Wang-Ruohan/RV3-2/电机AR2/43c167e9c2e52d14894e8b5e8c7fa40.jpg

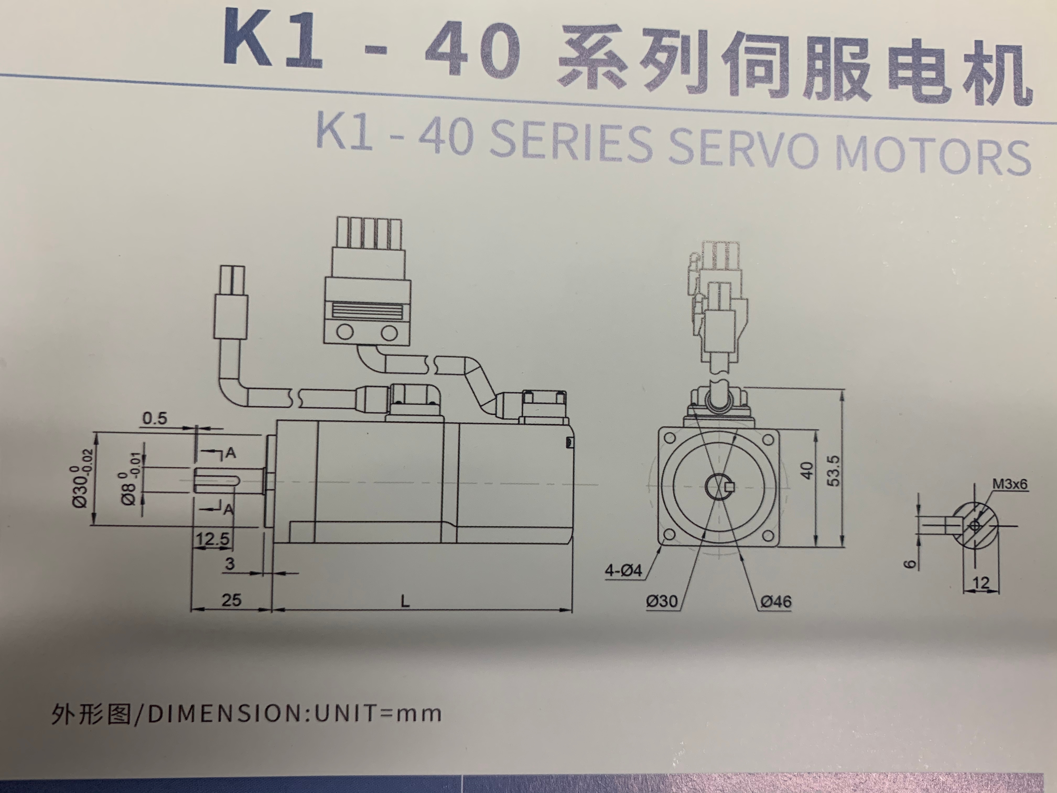
电机AR2/43c167e9c2e52d14894e8b5e8c7fa40.jpg
