Wang-Ruohan/RV3-2/PPT/RV3-2_robot2.pptx

RV3-2 机器人 – 传动

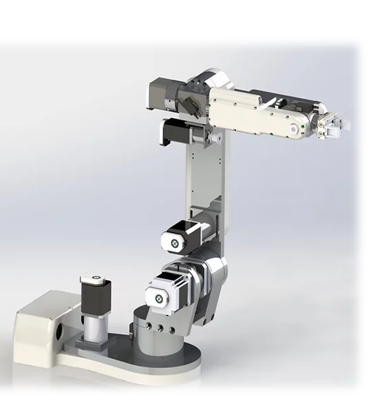
[picture p2: figure]

Joint_6

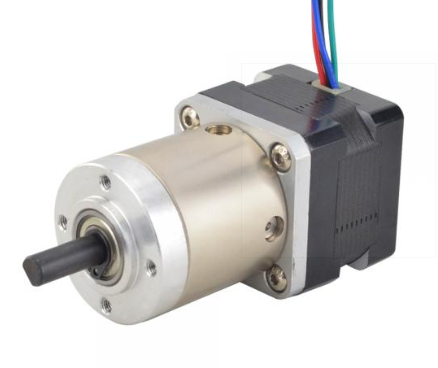
[picture p3: figure]

14HS11-1004D-PG19-AR3 (https://www.omc-stepperonline.com/nema-14-dual-shaft-stepper-motor-bipolar-l-28mm-w-gear-ratio-19-1-planetary-gearbox-9-5mm-rear-shaft-length.html)

Nema 14

0.125N.m 19:1减速比

Joint_5

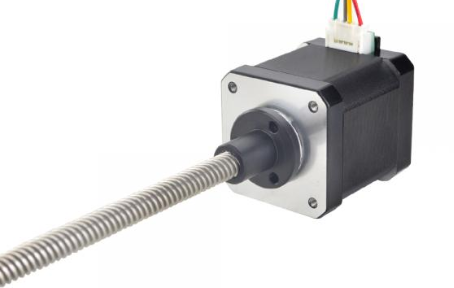
[picture p4: figure]

Nema 17

0.14N.m

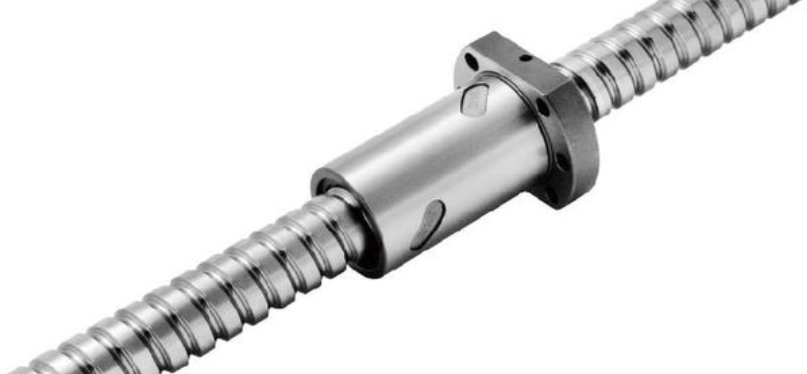
[picture p5: figure]

0.44N.m 13:1减速比

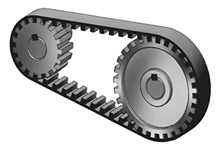
[picture p6: figure]

17LS19-1684E-200G-AR3 (https://www.omc-stepperonline.com/nema-17-dual-shaft-external-48mm-stack-1-68a-lead-8mm-0-31496-length-200mm-rear-shaft-length-13mm.html)

Joint_4

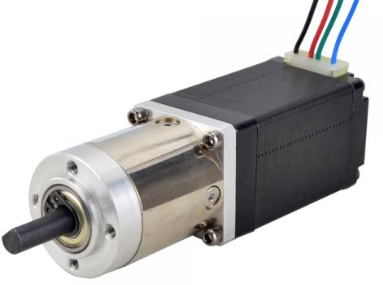
[picture p7: figure]

Nema 17

11HS20-0674D-PG14-AR3 (https://www.omc-stepperonline.com/nema-11-dual-shaft-stepper-motor-bipolar-l-51mm-w-gear-ratio-14-1-planetary-gearbox-9-5mm-rear-shaft-length.html)

Joint_3

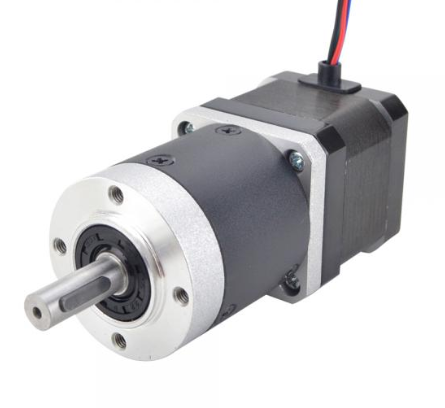
[picture p8: figure]

17HS15-1684D-HG50-AR3 (https://www.omc-stepperonline.com/nema-17-dual-shaft-stepper-motor-l-39mm-gear-ratio-50-1-high-precision-planetary-gearbox-9-5mm-rear-shaft-length.html)

Nema 17

0.39N.m 50:1减速比

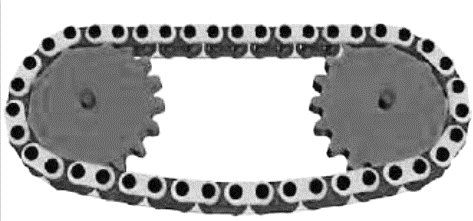
[picture p9: figure]

Joint_2

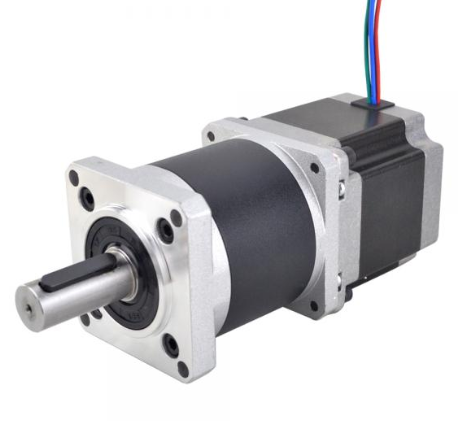
[picture p10: figure]

Nema 23

1.02N.m 50:1减速比

23HS22-2804D-HG50-AR3 (https://www.omc-stepperonline.com/nema-23-dual-shaft-stepper-motor-l-56mm-gear-ratio-50-1-high-precision-planetary-gearbox-9-5mm-rear-shaft-length.html)

Joint_1

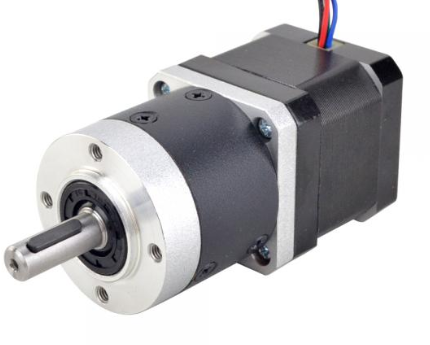
[picture p11: figure]

17HS15-1684D-HG10-AR3 (https://www.omc-stepperonline.com/nema-17-dual-shaft-stepper-motor-l-39mm-gear-ratio-10-1-high-precision-planetary-gearbox-9-5mm-rear-shaft-length.html)

Nema 17

0.39N.m 10:1减速比

编码器

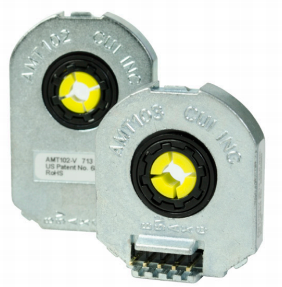
[picture p12: figure]

AMT102-V

AMT10X

正交，带刻度角（增量）

## Slide 2

RV3-2 机器人 – 特征参数

RV3-2 ROBOT
参数 | | 描述
展开臂长 | | 629mm
精度 | | 0.05mm
底座覆盖区 | | 245mm*150mm
重量 | | 15kg
温度 | | 0-50°C
运动范围
关节 | 转动范围
关节1 | -170°~+170°
关节2 | -129°~+0°
关节3 | +1°~+143°
关节4 | -164°~+164°
关节5 | -104°~+104°
关节6 | -148°~+148°
