Wang-Ruohan/RV3-2/其他/销售合同.docx

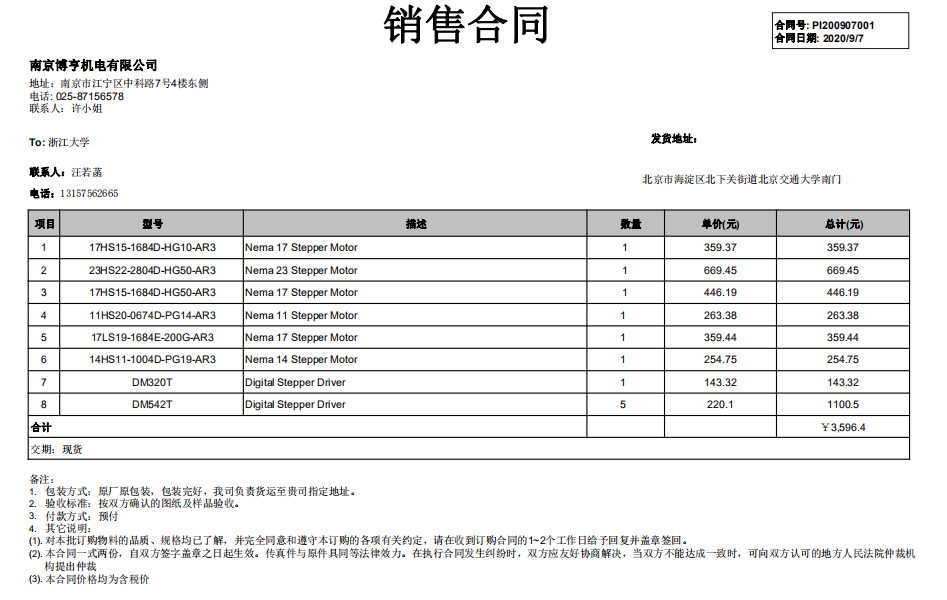
[picture p16: figure]
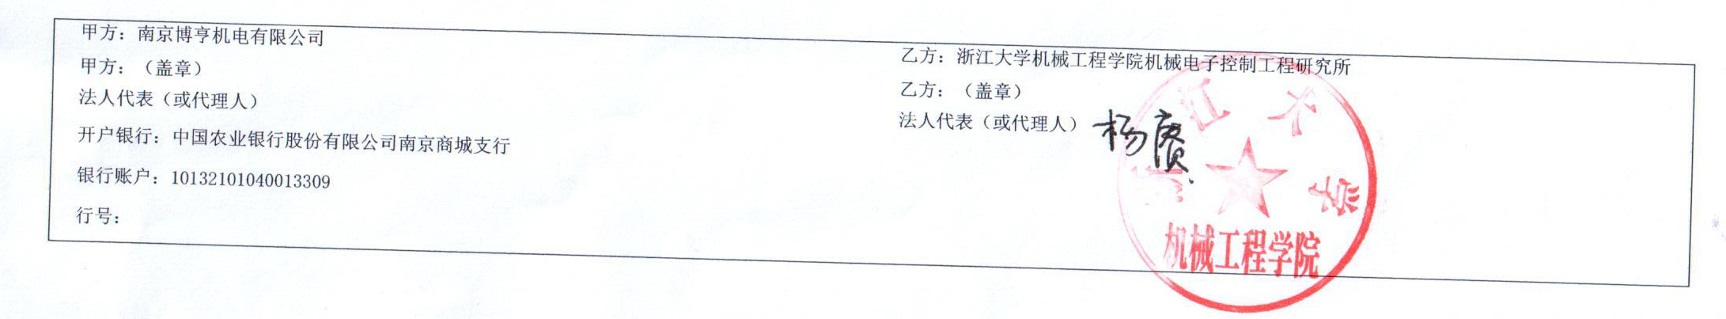
[picture p17: figure]
