Wang-Ruohan/RV3-2/CUI电容式编码器/CGQJ202002020_01800.jpg

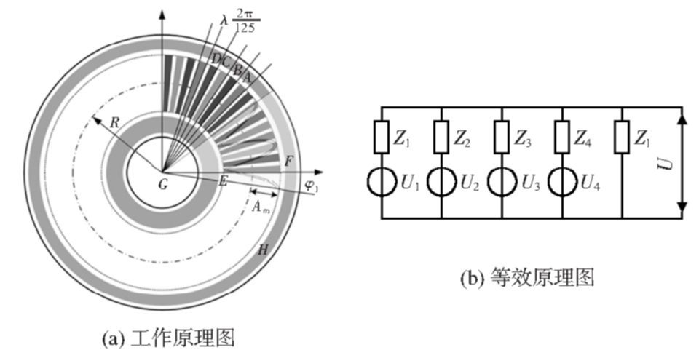
CUI电容式编码器/CGQJ202002020_01800.jpg
