Wang-Ruohan/RV3-2/其他/地址.jpg

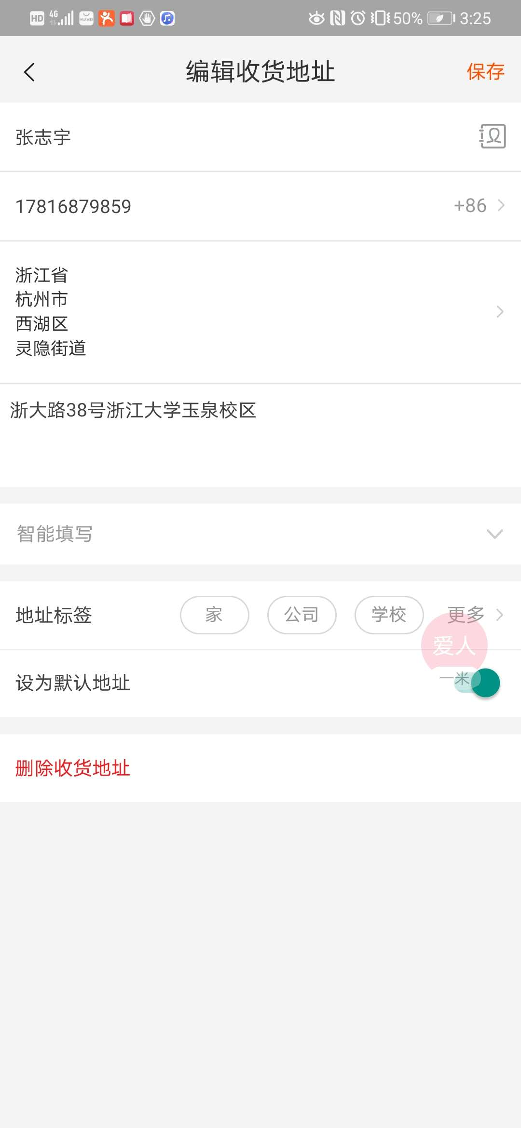
其他/地址.jpg
