Wang-Ruohan/RV3-2/电机AR2/J1.png

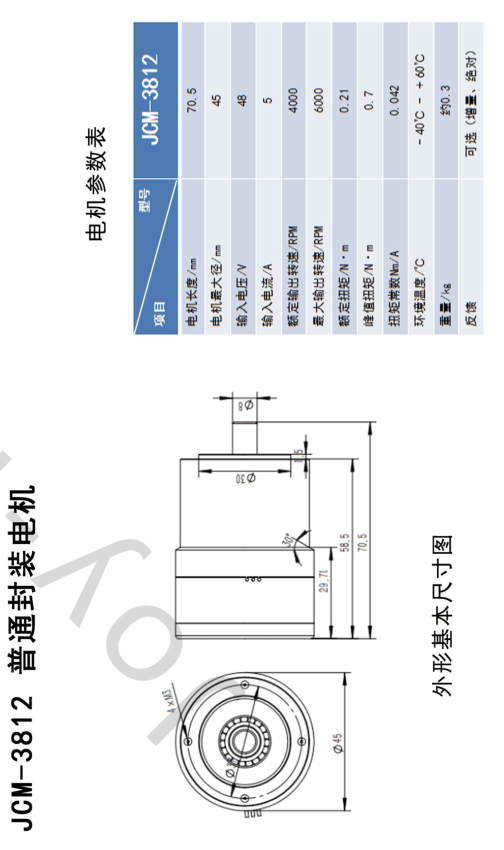
电机AR2/J1.png
