Wang-Ruohan/RV3-2/CUI电容式编码器/3D模型/CUI_AMT103-2048-N8000-S-SOLIDWORKS/BOM.txt

3DX_CUI_Supplier: CUI, Inc
3DX_CUI_Description: AMT10 Axial, Fixed Resolution, 2048 PPR, 8 Index Pulses, 8 mm Bore, Standard, Incremental, Capacitive Modular Encoder
3DX_CUI_Model Number: AMT103-2048-N8000-S
