Wang-Ruohan/RV3-2/表格/加工材料清单（不包括底座）.xlsx

Sheet: Sheet1
位置 | 材料 | 名称 | 数量 | 备注
Joint1 | 铝 | J1 basic plate | 1 | 基座，大，考虑用3D打印？ | √
 |  | J1 Turret Housing | 1 | 转台外壳，直径88mm | √
 |  | J1 spindle | 1 | 主轴，承载轴向力 | √
 |  | J1 turret platform | 1 | 转台平台，需要刚度 | √
 | PLA | J1 Base support spacer part1 | 1 |  | √
 |  | J1 Base support spacer part2 | 1 |  | √
 | 铝 | J1 timing dirve pully | 2 | J6也有一个，给的图不完整 | 已购
 | 铝 | J1 timing pully | 1 |  |  | x
Joint2 | 铝 | J2 Turret housing | 1 | 形状比较复杂 | √
 |  | J2 Arm | 1 |  | √
 |  | J2 Drive spindle | 1 |  | √
 |  | J2 Tension Ring | 1 |  | √
 |  | J2 motor support | 1 | 电机座支架 | √
 | PLA | J2 arm cover spacer | 2 |  | √
 |  | J2 side conver | 2 |  | √
Joint3 | 铝 | J1&J3 motor mount | 2 | 电机座支架 | 2
 |  | J3 Bearing cup | 1 |  | √
 |  | J3 Spindle | 1 |  | √
 |  | J3 Spindle retainer | 1 | 主轴固定器 | √
 | 铝 | 1439k211 | 1 | 一根轴 | 1
Joint4 | 铝 | J4 Turret housing | 1 |  | √
 |  | J4 Main shaft | 1 |  | √
 |  | J4 Timing hub | 1 |  |  | x
 |  | J4 Motor mount | 1 | 电机座支架 | √
 | 铝 | J4的电机座 | 1 | nema11 bracket | 已购
 | 铝 | J4 timing drive pulley | 1 | 给的图不完整 | 已购
Joint5 | 铝 | J5 motor mount | 1 |  | √
 |  | J5 housing | 1 | 10cm长，4cm宽和高，5mm厚，一面不封闭 | √
 |  | J5 belt carrier | 1 |  | √
 |  | J5 belt carrier clamp | 1 |  | √
 |  | J5 bearing post | 1 |  | √
 |  | J5 idler tension block | 1 |  | √
 | PLA | J5 side cover cap | 1 |  | √
 |  | J5 side cover | 1 |  | √
 |  | J5 side conver spacer | 2 |  | √
 | 铝 | 3mm rod | 2 |  | 2
Joint6 | 铝 | J6 Main bearing arm | 1 |  | √
 |  | J6 Housing single piece | 1 |  | √
 |  | J6 bearing cap | 1 | bearing cap, 3D也可 | √
 |  | J6 gripper mount | 1 |  | √
 | PLA | J6 limit switch tip | 1 |  | √
下面是关于bearing |  | 轴承亚马逊上有标件
J1 |  | 角接触轴承 | 2 | 内径45, 外径75, 面宽20, 面对面
J2 |  | 角接触轴承 | 2 | 内径30, 外径62, 面宽18, 面对面
J3 |  | 角接触轴承 | 1 | 内径20, 外径47, 面宽14.5, 对面是止推球
J3 |  | 止推球轴承 | 3 | 内径35，外径52，中间的和两侧型号不同
J4 |  | 止推球轴承 | 1+2 | 内径25.4，外径40，面宽3.6
J4 |  | 圆柱滚子轴承 | 2 | 外径31.75，内径25.4，面宽25.4
 |  | 6677k520 rolling bearing | 1 | 内径17.55，外径40，面宽13
 |  | 止推球轴承 | 1 | 内径25.4，外径40，面宽6
 |  | 5905k760 roller bearing | 1 | 内径17，外径22，面宽12
齿轮

Sheet: 螺栓
螺栓/螺母 | 数量
M3X10平头螺栓 | 13
M3X10紧定螺钉 | 4
M3X14盘头螺钉 | 10
M3X14内六角螺钉 | 6
M3X18内六角螺钉 | 4
M3X20平头螺钉 | 6
M3X20盘头螺钉 | 6
M3X25盘头螺钉 | 24
M3X3紧定螺钉 | 4
M3X4紧定螺钉 | 5
M3X5平头螺钉 | 20
M3X5内六角螺钉 | 1
M3X6紧定螺钉 | 7
M3X8内六角螺钉 | 9
M4螺母 | 4
M4垫片 | 36
M4X10平头螺钉 | 16
M4X10内六角螺钉 | 16
M4X10紧定螺钉 | 11
M4X14平头螺钉 | 2
M4X14内六角螺钉 | 1
M4X18平头螺钉 | 6
M4X20盘头螺钉 | 2
M4X20内六角螺钉 | 8
M4X35盘头螺钉 | 4
M4X5紧定螺钉 | 23
M6X14内六角螺钉 | 13
M6X18平头螺钉 | 9
M6X20内六角螺钉 | 3
M8方头紧定螺钉 | 1
