Wang-Ruohan/RV3-2/表格/已购买物品清单-第二批.xlsx

物品 | 数量 | 价格 | 备注 | 是否报销 | 备注
编码器 | 6 | 1039 |  |  | 电子发票 | 已收
电机+驱动器 | 6 | 3596.4 |  |  | 寄到浙大 | 已收
鲁泰轴承 | 5 | 56.62 |  |  | 保存在图片里 | 已收
LM3UU3mm轴承 | 4 | 110 |  |  | 寄到浙大 | 已收
B1616轴承 | 2 | 170 |  |  | 寄到浙大+20邮费
SKF轴承 | 1 | 7 | 没有发票
TR系列轴承 | 1 | 27.79 | 没有发票 |  | 已收到收据
32009轴承 | 2 | 30 | 没有发票 |  | 已收到收据
3mm铝棒 | 2 | 25 | 发票随货 |  | 在自己这里
同步轮定做 | 2 | 210 |  |  |  | 已收
接线头 | 4 | 72.2 |  |  |  | 已收
3D打印 | 1 | 240 |  |  | 已收到发票 | 已收
链轮定做 | 2 | 40 | 没有发票
铝合金加工 | 25样 | 2570 | 发票在自己这里 |  |  | 已收
螺丝刀 | 1 | 46.5 |  |  | 已收到发票 | 已收
螺栓 | 1 | 134.03 |  |  | 在自己这里
电线 | 5 | 48.46 |  |  | 图片保存里 | 已收
电线白 | 1 | 15 | 没有发票（可累计100开）
电源线 | 1 | 9 | 没有发票
同步轮 | 2 | 10 | 没有发票
同步带 | 5 | 33.9 | 没有发票
同步轮 | 1 | 5.3 | 没有发票
杜邦线 | 4 | 22.84 | 没有发票
