Wang-Ruohan/RV3-2/表格/2020.12月封账起未报.xlsx

物品 | 数量 | 价格 | 备注 | 是否报销
Nema17 电机 | 2 | 892.38 | 发票随货，在自己这儿 | 已报
铝合金加工 | 1 | 420 | 发票随货，发到浙大
铝合金加工 | 1 | 1500 | 未开票
邮费 | 1 | 50 | 电子发票
3D打印 | 2 | 261 | 电子发票，在自己这儿 | 已报
邮费 | 1 | 38 | 电子发票，未报，在自己这儿
餐桌轴承 | 1 | 28.8 | 电子发票，在自己这儿（邮箱） | 已报
铝合金加工 | 1 | 350
定位吸盘 | 500 | 47.22 | 电子发票，未开
尼龙包线 | 5 | 45 | 电子发票，未开
轴承 | 2 | 170 | 未开
气动夹爪 | 2 | 368 | 已开
3D打印 | 4 | 150 | 电子发票
气动接头 | 30 | 46.06 | 已开
亚克力板 | 1 | 11 | 已开
usb接头 | 1 | 11.9
木板 | 1 | 49.5
编码器 | 3 | 486 | 已开
铝型材 | 1 | 125
 |  | 5049.86
