Wang-Ruohan/RV3-2/AR2 assembly/1件-整合/J6 main bearing arm.STEP

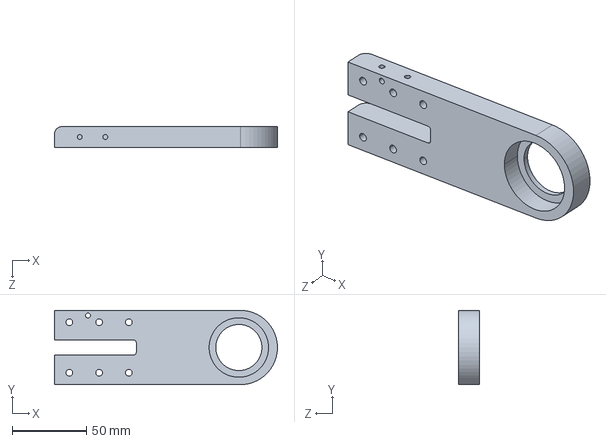
[picture p21: CAD file, 2021-06-09]
AR2 assembly/1件-整合/J6 main bearing arm.STEP
150.0 x 50.0 x 14.0 mm
