Wang-Ruohan/RV3-2/AR2 assembly/AR2 assembly/AR2 assembly & step files/AR2 Robot.SLDASM

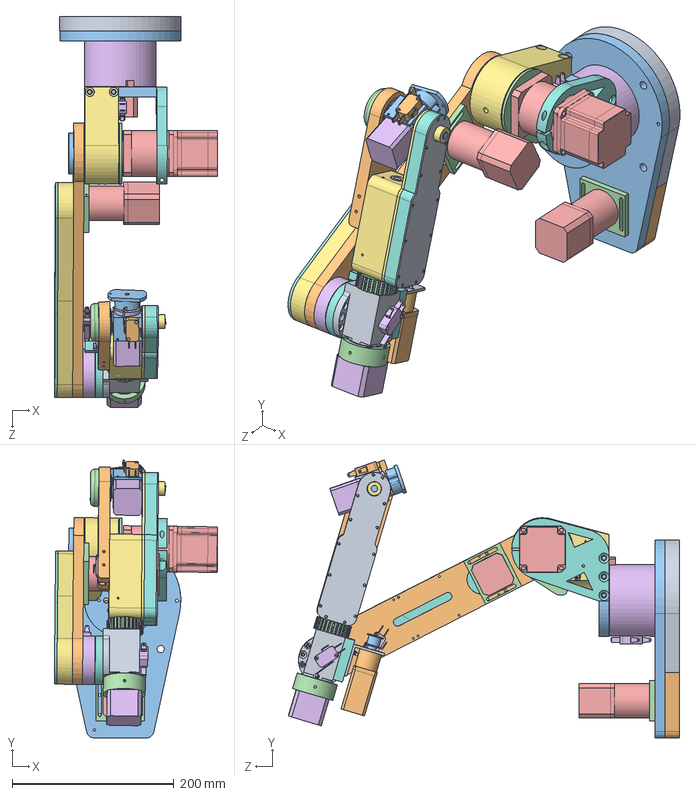
[picture p22: CAD file, 2021-06-09]
AR2 assembly/AR2 assembly/AR2 assembly & step files/AR2 Robot.SLDASM
202.2 x 343.9 x 484.2 mm
J1 base support spacer part 1
J1 base support spacer part 2
J1 Base Plate
J1 & J3 Motor Mount x 2
17HS15-1684S-HG50 x 2
J1 Turret Housing
J1 timing drive pulley x 2
J1 bearing outer x 2
J1 bearing inner x 2
J1 Spindle
J1 Turret Platform
J1 timing pulley
92635A314_SQUARE HEAD EXTENDED POINT SET SCREW
micro switch x 5
J2 Turret Housing
J2 Motor Support
J2 Arm
J2 Drive Spindle
J2 Tension Ring
23HS22-2804S-HG50
J3 Bearing Cup
30204 bearing
J3 Spindle
5909K180_THRUST NEEDLE-ROLLER BRNG
5909K630_THRUST NEEDLE-ROLLER BRNG x 2
5909K780_THRUST NEEDLE-ROLLER BRNG x 2
J3 spindle retainer
5909K490_THRUST NEEDLE-ROLLER BRNG x 4
1439K211_METRIC FULLY KEYED STEEL DRIVE SHAFT
J2 arm cover spacer x 2
J2 side cover half x 2
J4 Turret Housing
5905K137_STL NEEDLE-ROLLER BRNG x 2
J4 Main Shaft
J5 motor mount
5909K360_THRUST NEEDLE-ROLLER BRNG x 3
17LS13-0404E-200H
J5 Housing
J4 motor mount - limit arm
nema 11 bracket
11HS20-0674S-PG5
J4 timing drive pulley
6677K520_STL TAPERED-ROLLER BRNG
3mm rod x 2
J5 Belt Carrier
J5 Belt Carrier Clamp
J5 Idler Tension Block
J5 Bearing Post
J6 main bearing arm
J6 housing single piece
J6 bearing cap
5905K760_STL NEEDLE-ROLLER BRNG
14HS13-0804S-PG19
J5 side cover
J5 side cover spacer x 2
J5 side cover cap
modified micro switch
J6 gripper mount
J4 timing hub
