Wang-Ruohan/RV3-2/AR2 assembly/AR2 assembly/AR2 assembly & step files/Misc Parts/J4 main shaft.SLDPRT

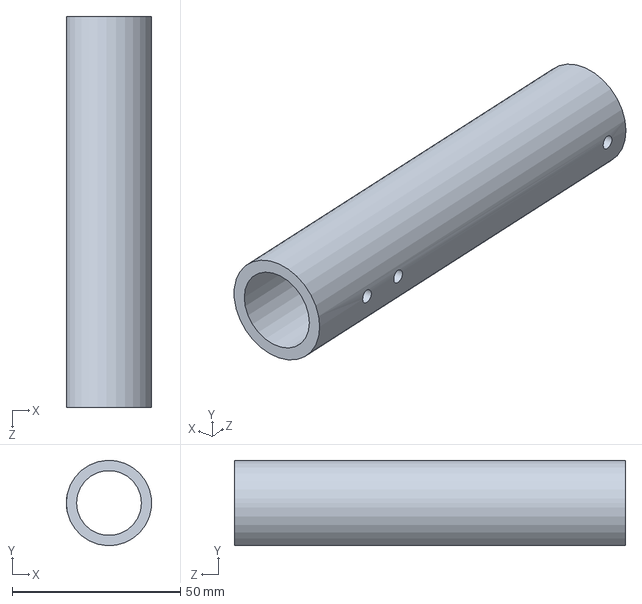
[picture p23: CAD file, 2021-06-09]
AR2 assembly/AR2 assembly/AR2 assembly & step files/Misc Parts/J4 main shaft.SLDPRT
25.4 x 25.4 x 116.3 mm
