Wang-Ruohan/RV3-2/CUI电容式编码器/3D模型/CUI_AMT103-2048-N8000-S-SOLIDWORKS/CUI_cui_amt103-0048-n8000-s.sldasm

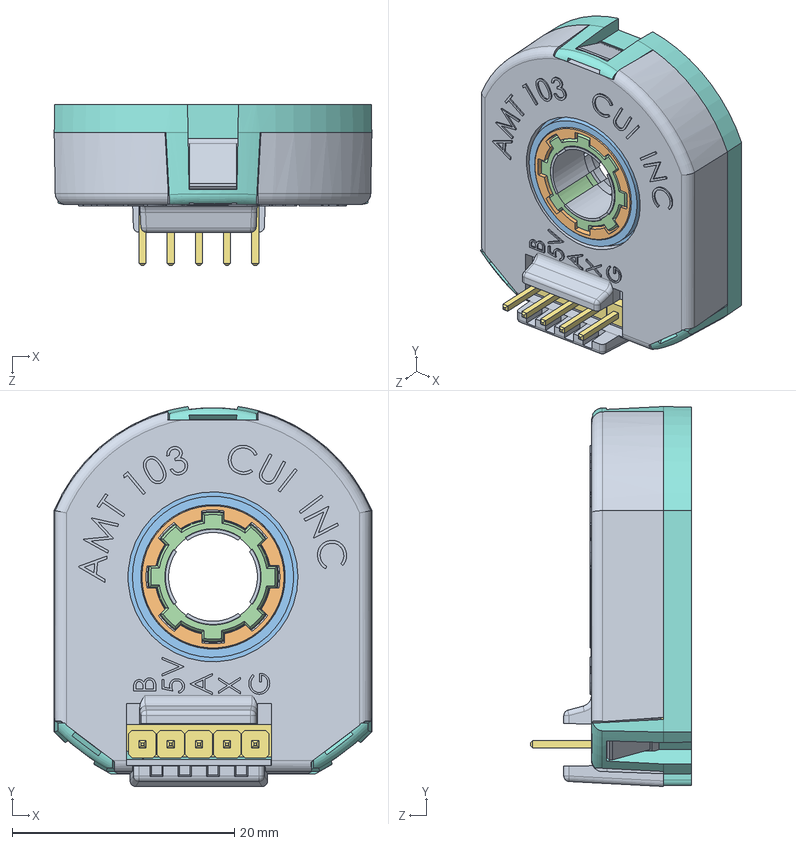
[picture p24: CAD file, 2021-06-09]
CUI电容式编码器/3D模型/CUI_AMT103-2048-N8000-S-SOLIDWORKS/CUI_cui_amt103-0048-n8000-s.sldasm
28.6 x 34.2 x 14.5 mm
CUI_amt-sleeve-rev-d(8 mm)
CUI_amt-hub-top-rev-d1
CUI_amt-hub-bottom-rev-b
CUI_amt10x-shaft-adaptor-rev-e
CUI_receiver-board
CUI_rotor-board-rev f
CUI_transmitter-board amt10(amt-103)
CUI_amt-103-base-rev-k(default)
CUI_amt-103-top-cover-rev-h
