Wang-Ruohan/RV3-2/AR2 assembly/AR2 assembly/AR2 assembly & step files/J5 main bearing housing.SLDPRT

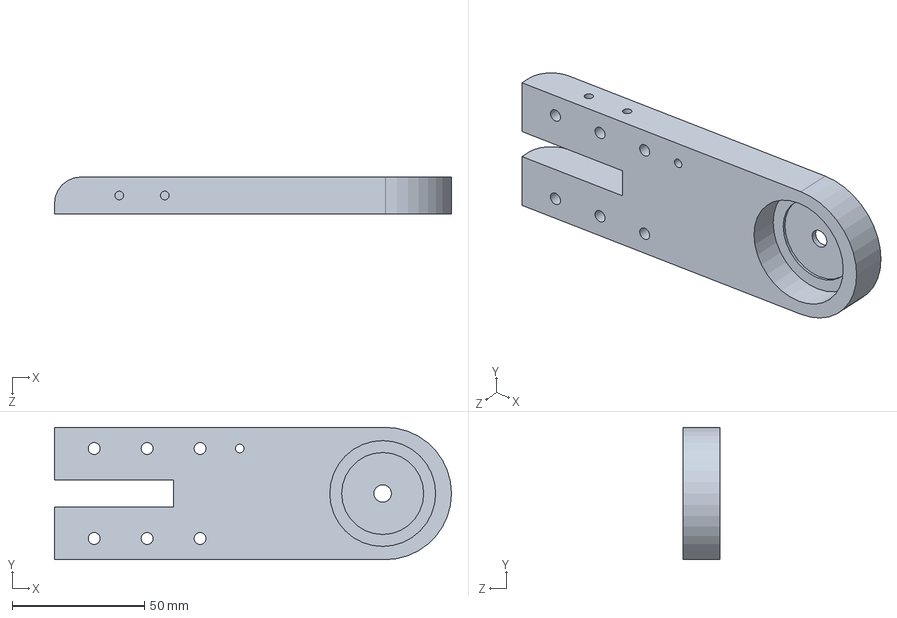
[picture p25: CAD file, 2021-06-09]
AR2 assembly/AR2 assembly/AR2 assembly & step files/J5 main bearing housing.SLDPRT
150.0 x 50.0 x 14.0 mm
