Wang-Ruohan/RV3-2/AR2 assembly/AR2 assembly/AR2 assembly & step files/AR2 Robot1.SLDASM

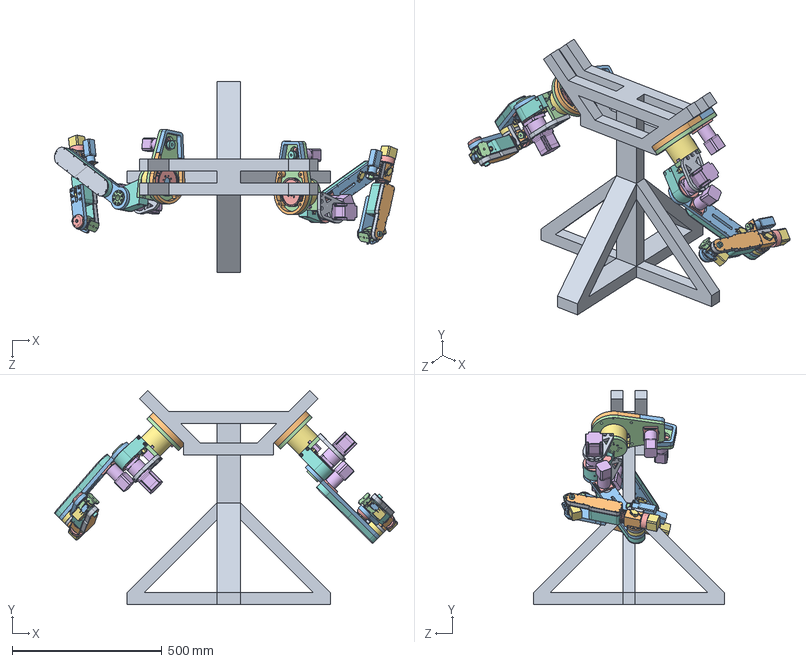
[picture p26: CAD file, 2021-06-09]
AR2 assembly/AR2 assembly/AR2 assembly & step files/AR2 Robot1.SLDASM
1146.7 x 716.8 x 640.0 mm
body_support2
J1 base support spacer part 1 x 2
J1 base support spacer part 2 x 2
J1 Base Plate x 2
J1 & J3 Motor Mount x 4
17HS15-1684S-HG50 x 4
J1 Turret Housing x 2
J1 timing drive pulley x 4
J1 bearing outer x 4
J1 bearing inner x 4
J1 Spindle x 2
J1 Turret Platform x 2
J1 timing pulley x 2
92635A314_SQUARE HEAD EXTENDED POINT SET SCREW x 2
micro switch x 10
J2 Turret Housing x 2
J2 Motor Support x 2
J2 Arm x 2
J2 Drive Spindle x 2
J2 Tension Ring x 2
23HS22-2804S-HG50 x 2
J3 Bearing Cup x 2
30204 bearing x 2
J3 Spindle x 2
5909K180_THRUST NEEDLE-ROLLER BRNG x 2
5909K630_THRUST NEEDLE-ROLLER BRNG x 4
5909K780_THRUST NEEDLE-ROLLER BRNG x 4
J3 spindle retainer x 2
5909K490_THRUST NEEDLE-ROLLER BRNG x 8
1439K211_METRIC FULLY KEYED STEEL DRIVE SHAFT x 2
J2 arm cover spacer x 4
J2 side cover half x 4
J4 Turret Housing x 2
5905K137_STL NEEDLE-ROLLER BRNG x 4
J4 Main Shaft x 2
J5 motor mount x 2
5909K360_THRUST NEEDLE-ROLLER BRNG x 6
17LS13-0404E-200H x 2
J5 Housing x 2
J4 motor mount - limit arm x 2
nema 11 bracket x 2
11HS20-0674S-PG5 x 2
J4 timing drive pulley x 2
6677K520_STL TAPERED-ROLLER BRNG x 2
3mm rod x 4
J5 Belt Carrier x 2
J5 Belt Carrier Clamp x 2
J5 Idler Tension Block x 2
J5 Bearing Post x 2
J6 main bearing arm x 2
J6 housing single piece x 2
J6 bearing cap x 2
5905K760_STL NEEDLE-ROLLER BRNG x 2
14HS13-0804S-PG19 x 2
J5 side cover x 2
J5 side cover spacer x 4
J5 side cover cap x 2
modified micro switch x 2
J6 gripper mount x 2
J4 timing hub x 2
