Wang-Ruohan/RV3-2/AR2 assembly/AR2 assembly & step files/AR2 Robot - J6 main bearing arm-1.STL

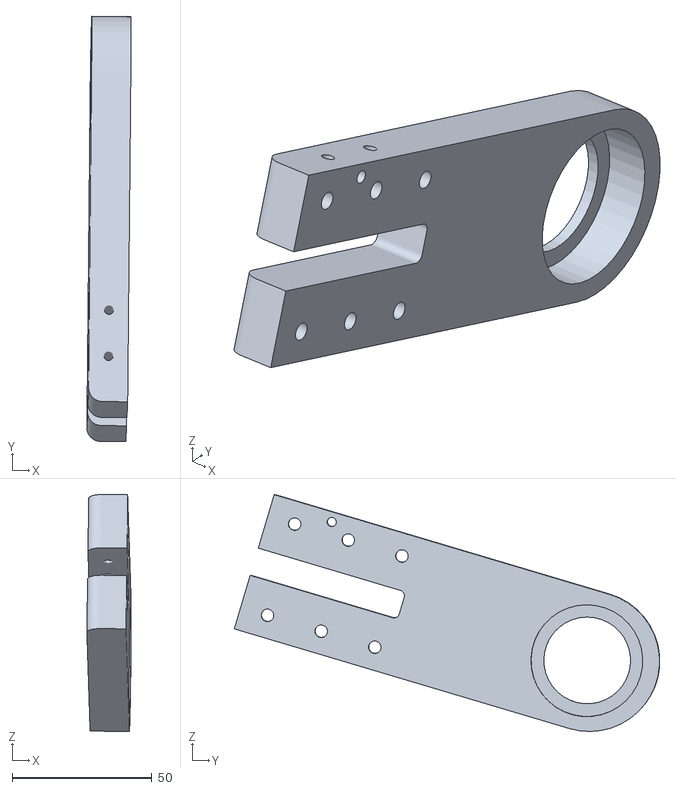
[picture p27: CAD file, 2021-06-09]
AR2 assembly/AR2 assembly & step files/AR2 Robot - J6 main bearing arm-1.STL
15.8 x 152.1 x 84.7
