Wang-Ruohan/RV3-2/AR2 assembly/AR2 assembly & step files/AR2 Robot - J4 Main Shaft-1.STL

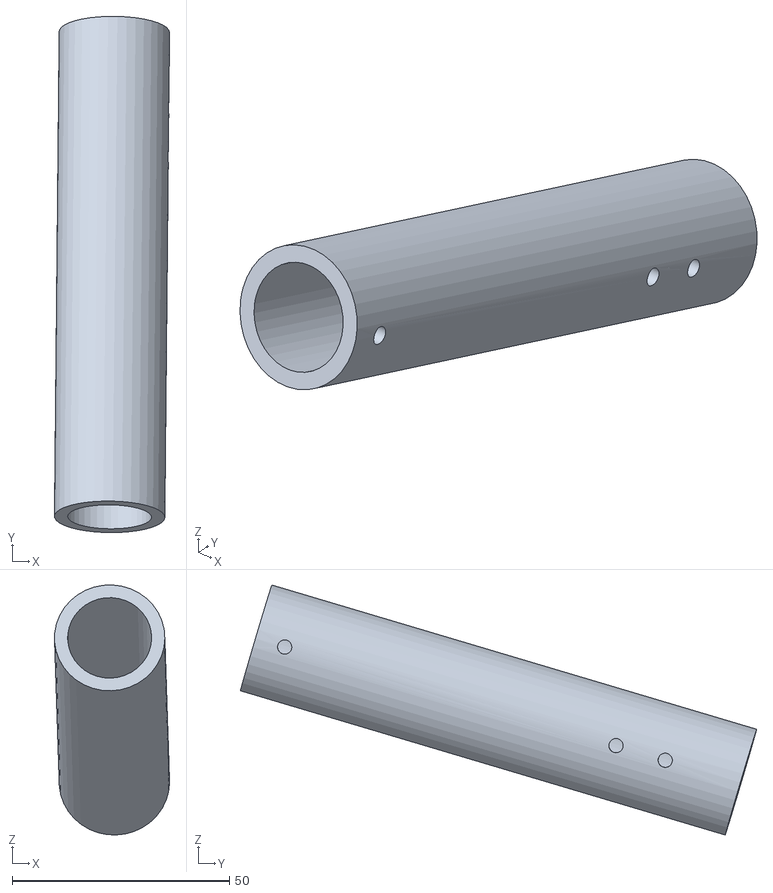
[picture p29: CAD file, 2021-06-09]
AR2 assembly/AR2 assembly & step files/AR2 Robot - J4 Main Shaft-1.STL
26.5 x 118.7 x 57.5
