Wang-Ruohan/RV3-2/AR2 assembly/AR2 assembly & step files/AR2 Robot - 1439K211_METRIC FULLY KEYED STEEL DRIVE SHAFT-1.STL

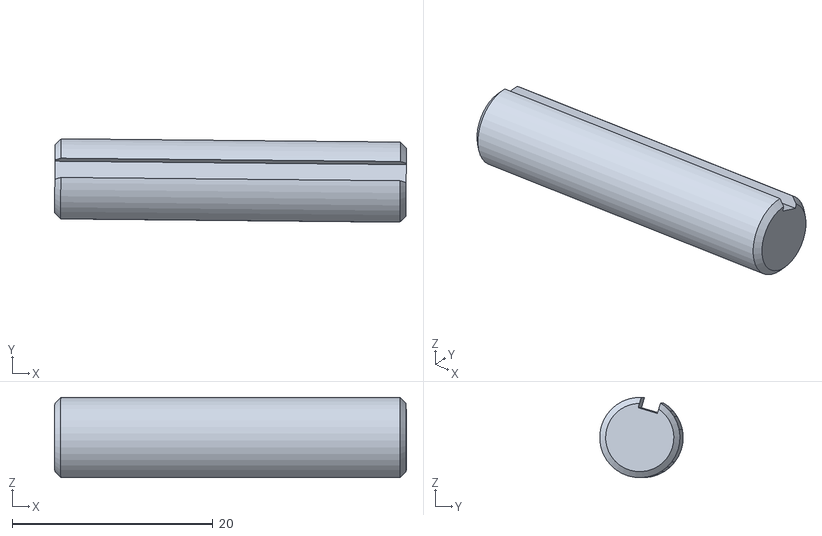
[picture p30: CAD file, 2021-06-09]
AR2 assembly/AR2 assembly & step files/AR2 Robot - 1439K211_METRIC FULLY KEYED STEEL DRIVE SHAFT-1.STL
35.1 x 8.31 x 7.99
