Wang-Ruohan/RV3-2/AR2 assembly/1件-J5/J5 motor mount.STEP

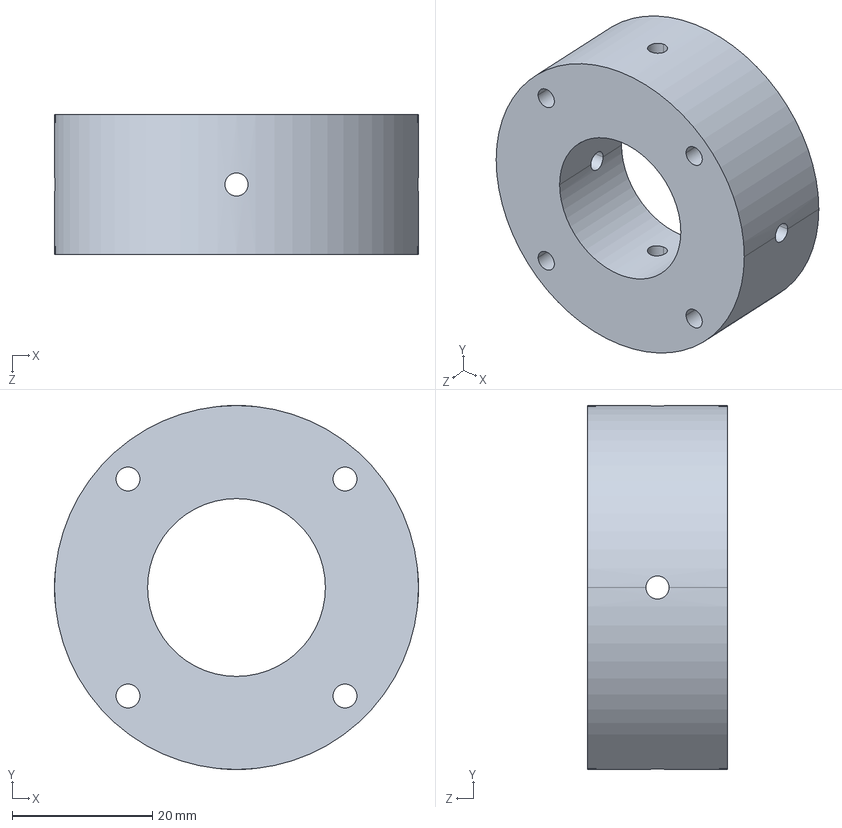
[picture p31: CAD file, 2021-06-09]
AR2 assembly/1件-J5/J5 motor mount.STEP
52.0 x 52.0 x 20.0 mm
