Wang-Ruohan/RV3-2/AR2 assembly/3D打印件/J5 side.STL

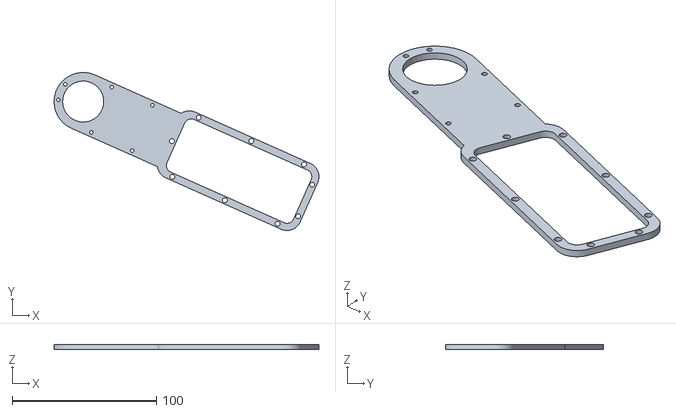
[picture p32: CAD file, 2021-06-09]
AR2 assembly/3D打印件/J5 side.STL
184.0 x 109.7 x 3.17
