Wang-Ruohan/RV3-2/AR2 assembly/AR2 assembly & step files/AR2 Robot - J3 Bearing Cup-1.STL

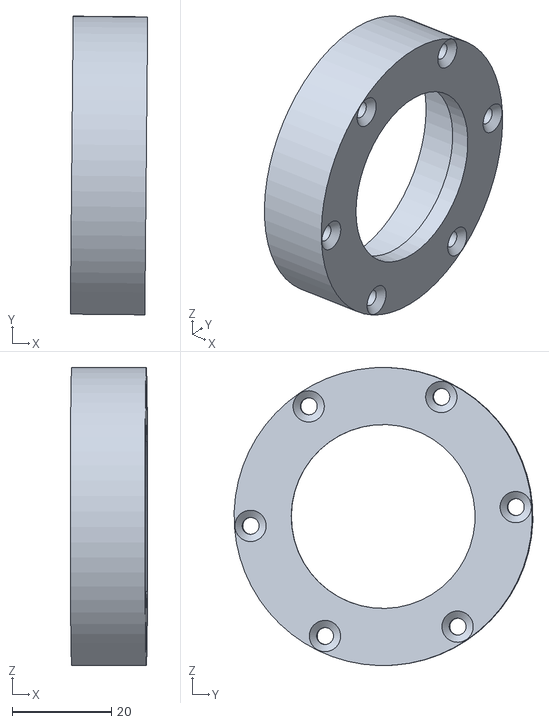
[picture p33: CAD file, 2021-06-09]
AR2 assembly/AR2 assembly & step files/AR2 Robot - J3 Bearing Cup-1.STL
15.6 x 60.1 x 60.0
