Wang-Ruohan/RV3-2/AR2 assembly/AR2 assembly/AR2 assembly & step files/J3 Tension Ring.SLDPRT

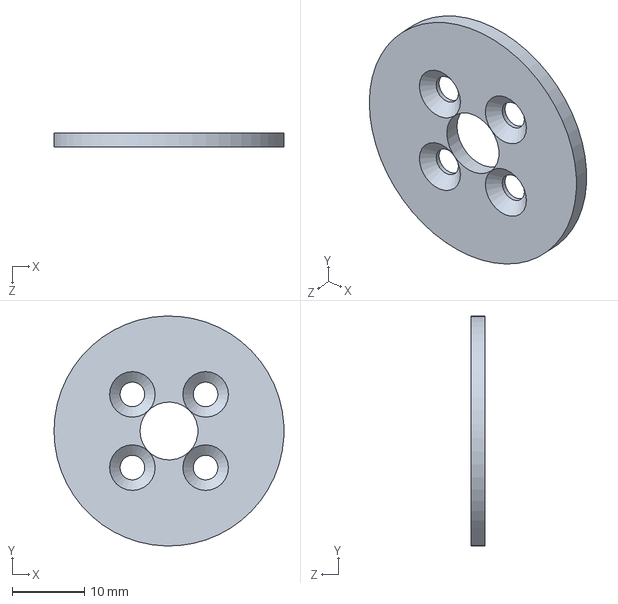
[picture p34: CAD file, 2021-06-09]
AR2 assembly/AR2 assembly/AR2 assembly & step files/J3 Tension Ring.SLDPRT
31.7 x 31.7 x 2.00 mm
