Wang-Ruohan/RV3-2/AR2 assembly/AR2 assembly/AR2 assembly & step files/Misc Parts/11HS20-0674S-PG5.SLDPRT

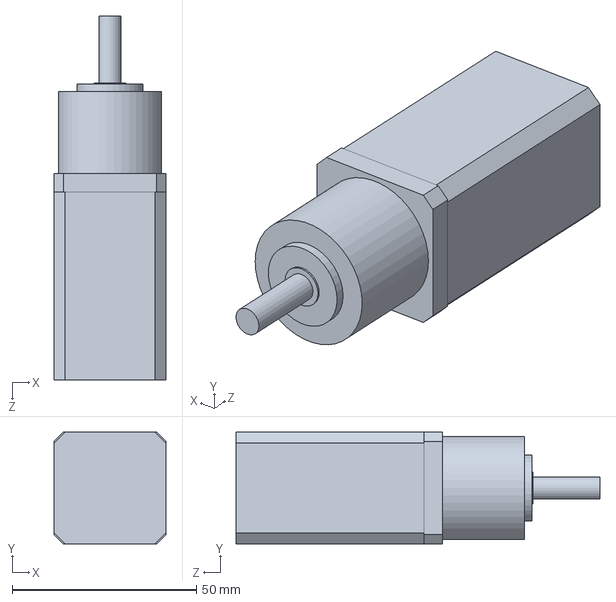
[picture p35: CAD file, 2021-06-09]
AR2 assembly/AR2 assembly/AR2 assembly & step files/Misc Parts/11HS20-0674S-PG5.SLDPRT
30.3 x 30.3 x 98.7 mm
