Wang-Ruohan/RV3-2/AR2 assembly/mashimar 众诚 7月2号/J4 Turret Housing.STEP

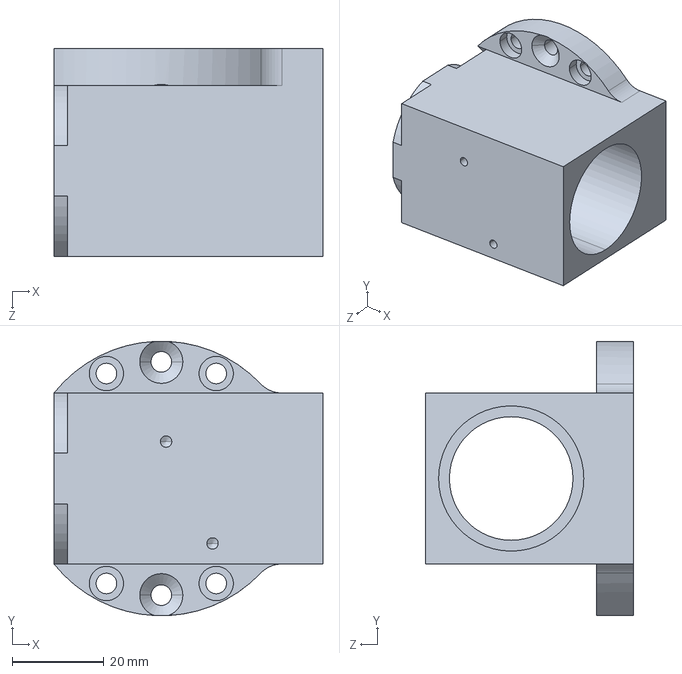
[picture p36: CAD file, 2021-06-09]
AR2 assembly/mashimar 众诚 7月2号/J4 Turret Housing.STEP
58.8 x 60.0 x 45.4 mm
