Wang-Ruohan/RV3-2/AR2 assembly/mashimaro051726众诚  7月21号 共13张/1件(1)/J6 bearing cap.STEP

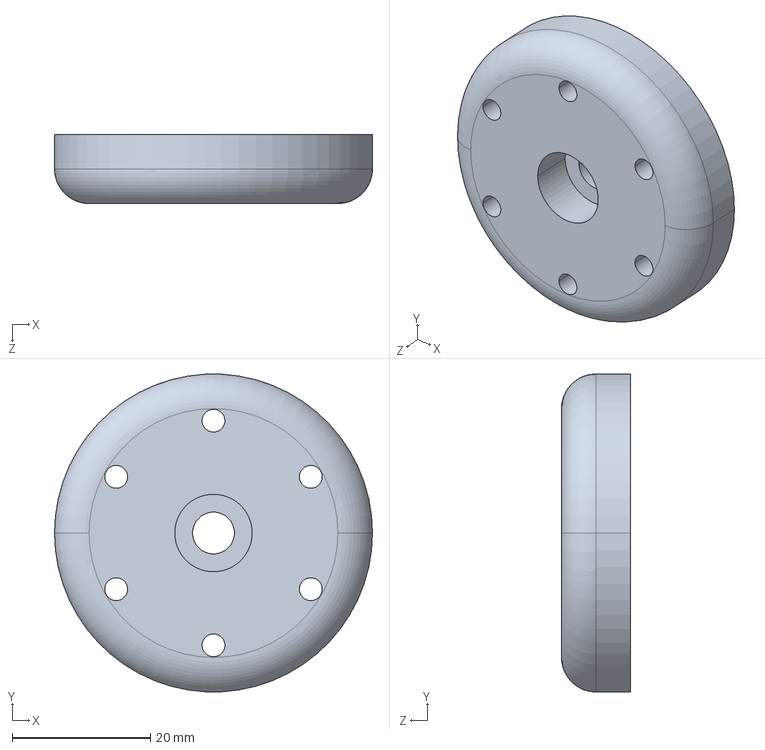
[picture p37: CAD file, 2021-06-09]
AR2 assembly/mashimaro051726众诚 7月21号 共13张/1件(1)/J6 bearing cap.STEP
46.0 x 45.9 x 10.0 mm
