Wang-Ruohan/RV3-2/AR2 assembly/mashimaro051726众诚  7月21号 共13张/1件-a(4)/J1 Turret Platform.STEP

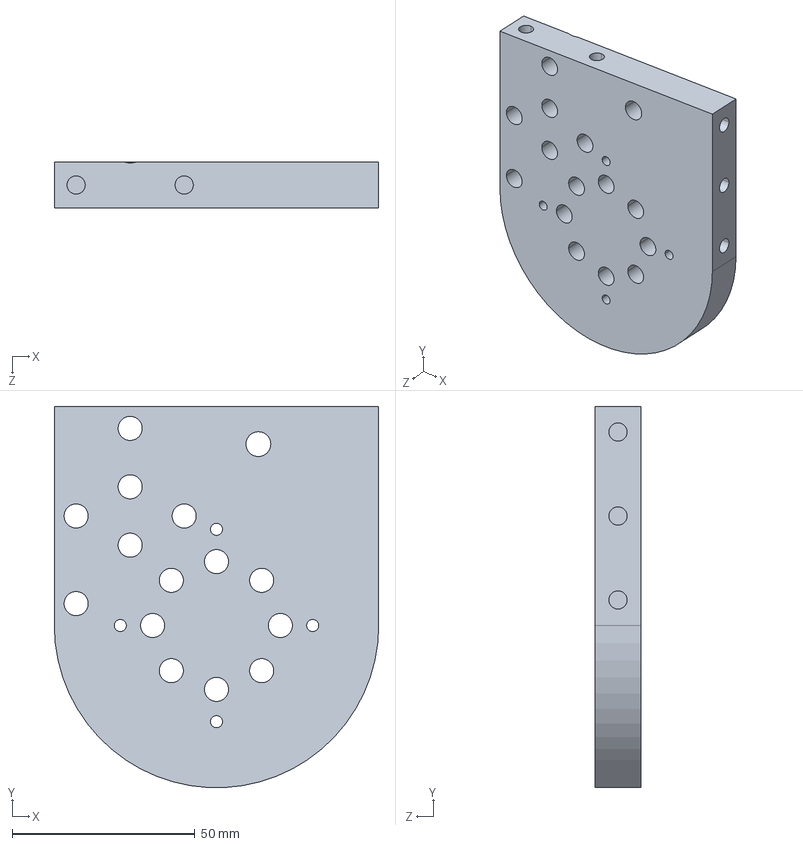
[picture p38: CAD file, 2021-06-09]
AR2 assembly/mashimaro051726众诚 7月21号 共13张/1件-a(4)/J1 Turret Platform.STEP
88.9 x 104.4 x 12.7 mm
