Wang-Ruohan/RV3-2/AR2 assembly/树脂件/NEW_outer.STL

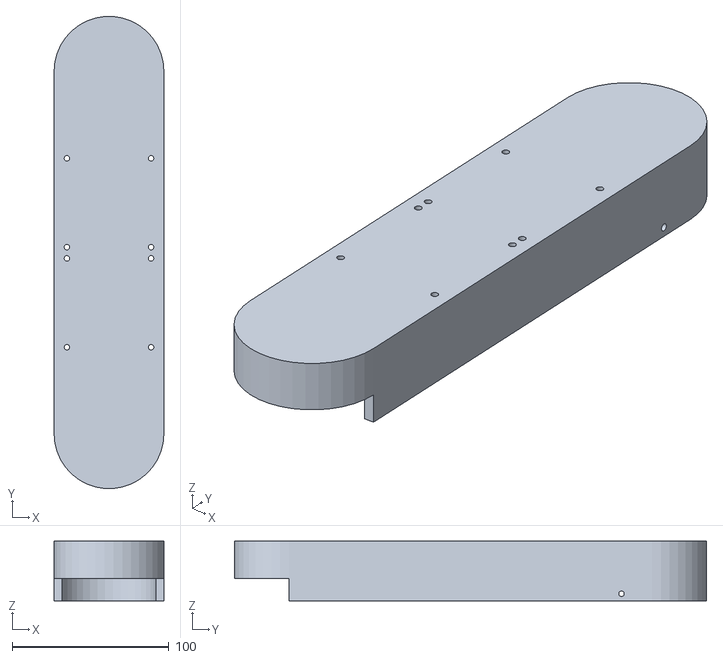
[picture p39: CAD file, 2021-06-09]
AR2 assembly/树脂件/NEW_outer.STL
70.0 x 300.7 x 38.2
