Wang-Ruohan/RV3-2/AR2 print files/Covers & Spacers - optimized for printing/J6 Limit Switch Tip.SLDPRT

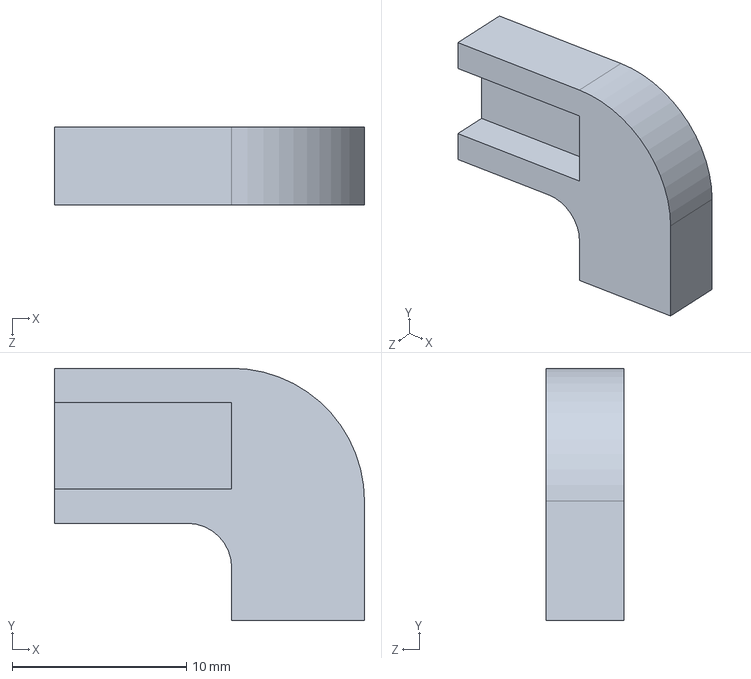
[picture p40: CAD file, 2021-06-09]
AR2 print files/Covers & Spacers - optimized for printing/J6 Limit Switch Tip.SLDPRT
17.8 x 14.5 x 4.45 mm
