Wang-Ruohan/RV3-2/AR2 print files/Covers & Spacers - original/J2 side cover half .SLDPRT

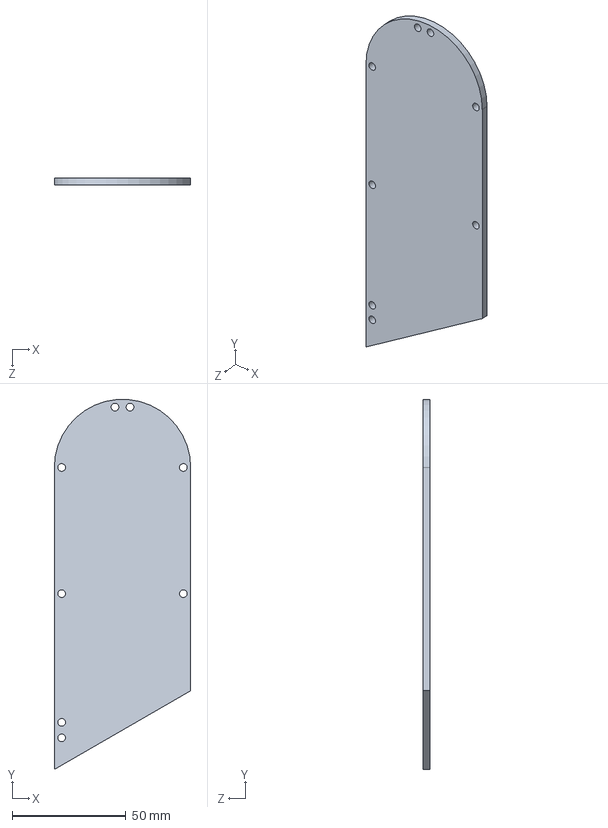
[picture p41: CAD file, 2021-06-09]
AR2 print files/Covers & Spacers - original/J2 side cover half .SLDPRT
60.0 x 162.7 x 3.17 mm
