Wang-Ruohan/RV3-2/AR2 print files/Epoxy on Supports/auxilliary base support.SLDPRT

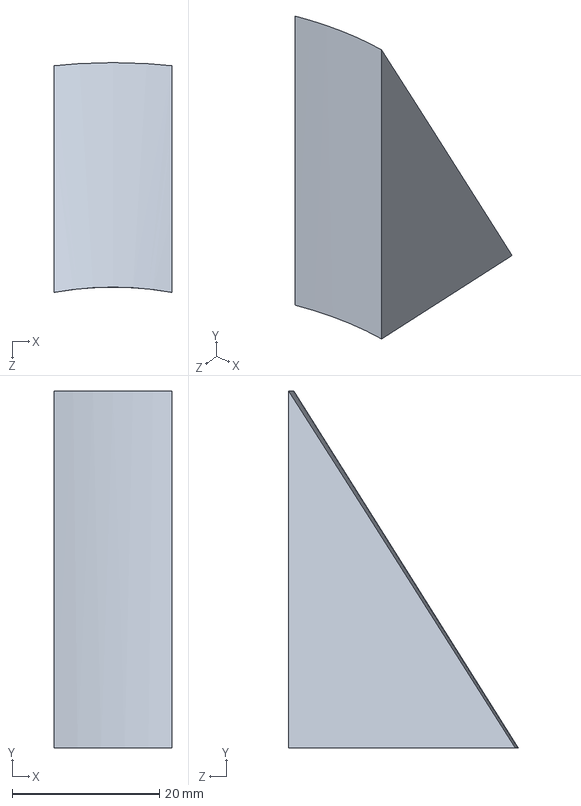
[picture p42: CAD file, 2021-06-09]
AR2 print files/Epoxy on Supports/auxilliary base support.SLDPRT
16.0 x 48.5 x 31.2 mm
