Wang-Ruohan/RV3-2/AR2 print files/Jaw/AR2 jaw.SLDPRT

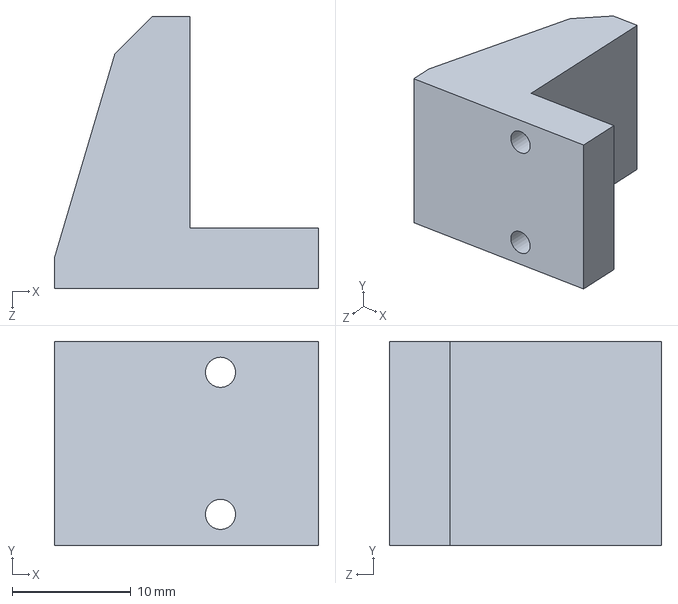
[picture p43: CAD file, 2021-06-09]
AR2 print files/Jaw/AR2 jaw.SLDPRT
22.2 x 17.1 x 22.9 mm
