Wang-Ruohan/RV3-2/AR2 print files/Main Components - Resized for shrink/J1 - J3 motor mount.STL

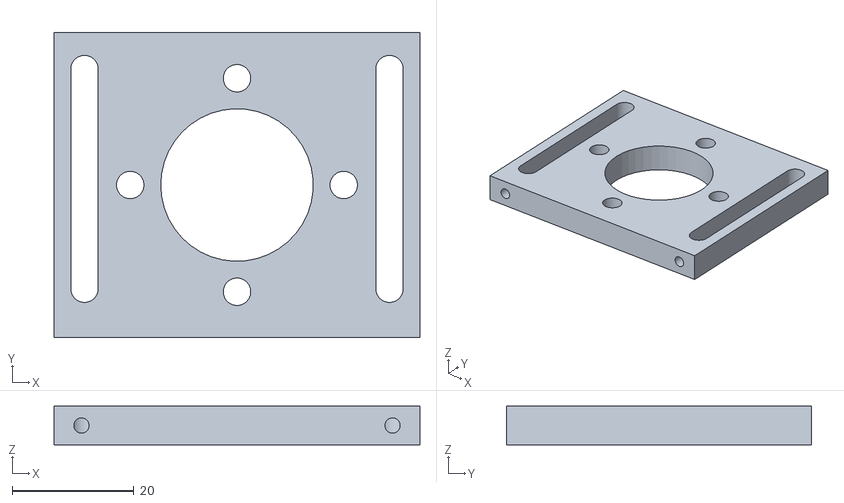
[picture p44: CAD file, 2021-06-09]
AR2 print files/Main Components - Resized for shrink/J1 - J3 motor mount.STL
60.0 x 50.0 x 6.35
