Wang-Ruohan/RV3-2/AR2 print files/Modified Main Components - Remixed for large print bed/J2_Arm_v4.stl

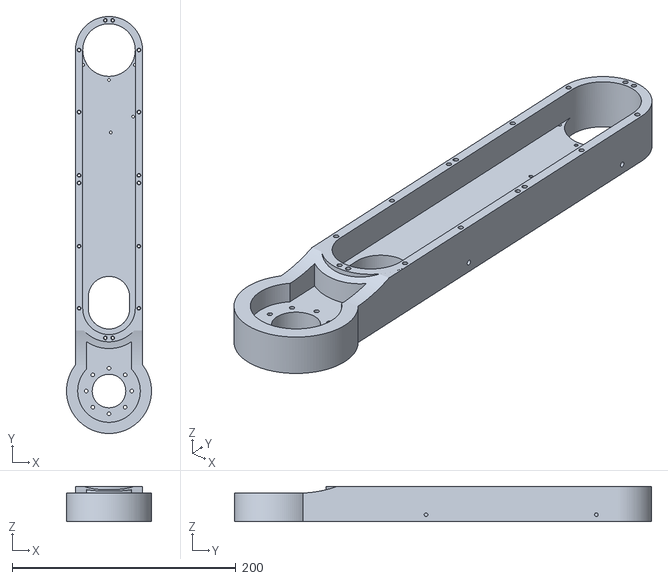
[picture p45: CAD file, 2021-06-09]
AR2 print files/Modified Main Components - Remixed for large print bed/J2_Arm_v4.stl
76.0 x 373.0 x 31.8
