Wang-Ruohan/RV3-2/AR2 print files/Travel Track/pillow block.SLDPRT

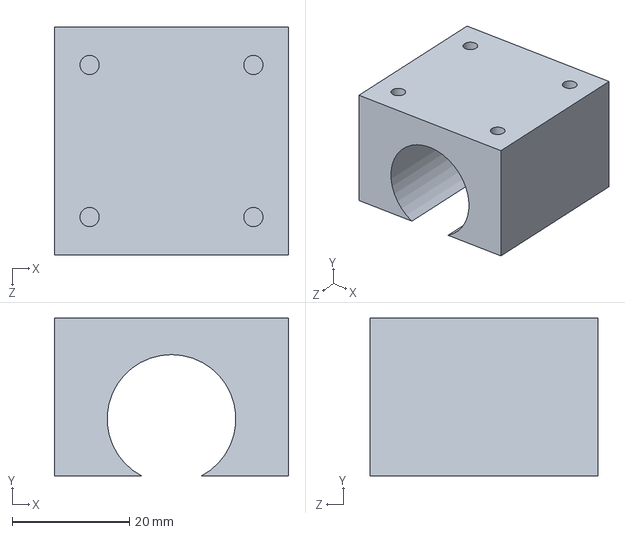
[picture p46: CAD file, 2021-06-09]
AR2 print files/Travel Track/pillow block.SLDPRT
40.0 x 27.0 x 39.0 mm
