Wang-Ruohan/RV3-2/AR3 assembly/J5 Belt Carrier.STEP

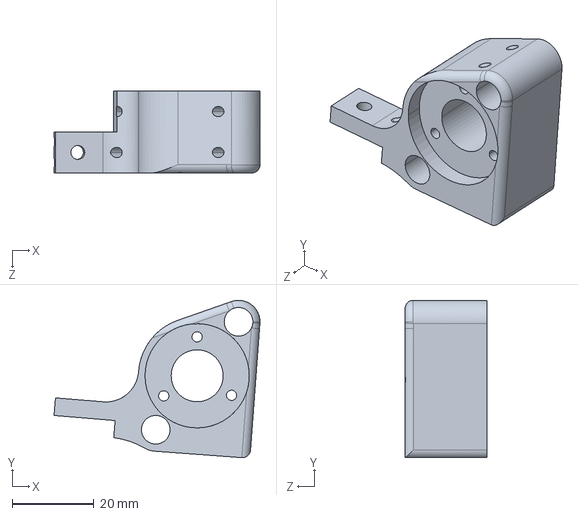
[picture p47: CAD file, 2021-06-09]
AR3 assembly/J5 Belt Carrier.STEP
50.4 x 38.5 x 20.0 mm
