Wang-Ruohan/RV3-2/AR3 print files/3D print files/60T hub pulley/60t_timing_hub_pulley.stl

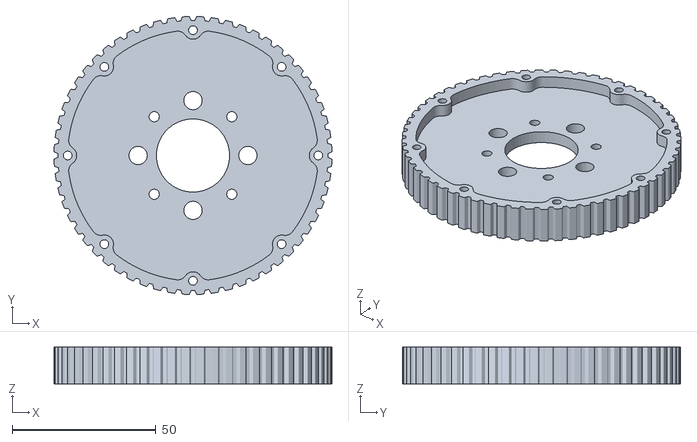
[picture p48: CAD file, 2021-06-09]
AR3 print files/3D print files/60T hub pulley/60t_timing_hub_pulley.stl
96.5 x 96.5 x 12.7
