Wang-Ruohan/RV3-2/AR3 print files/3D print files/Arduino Mount/Arduino Mount.STL

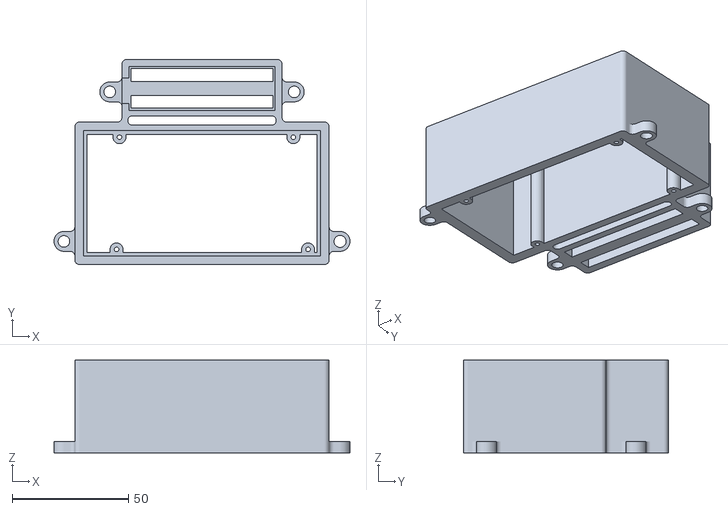
[picture p49: CAD file, 2021-06-09]
AR3 print files/3D print files/Arduino Mount/Arduino Mount.STL
127.6 x 88.4 x 40.0
