Wang-Ruohan/RV3-2/AR3 print files/3D print files/Covers and Spacers/J2 Side Cover Logo .STL

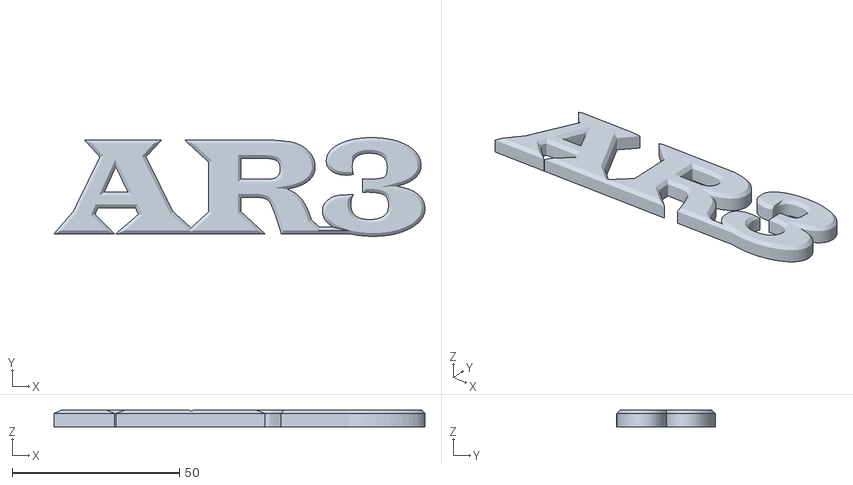
[picture p50: CAD file, 2021-06-09]
AR3 print files/3D print files/Covers and Spacers/J2 Side Cover Logo .STL
111.0 x 29.6 x 5.00
