Wang-Ruohan/RV3-2/AR3 print files/3D print files/Enclosure Face Panels/Enclosure Face Panel.STL

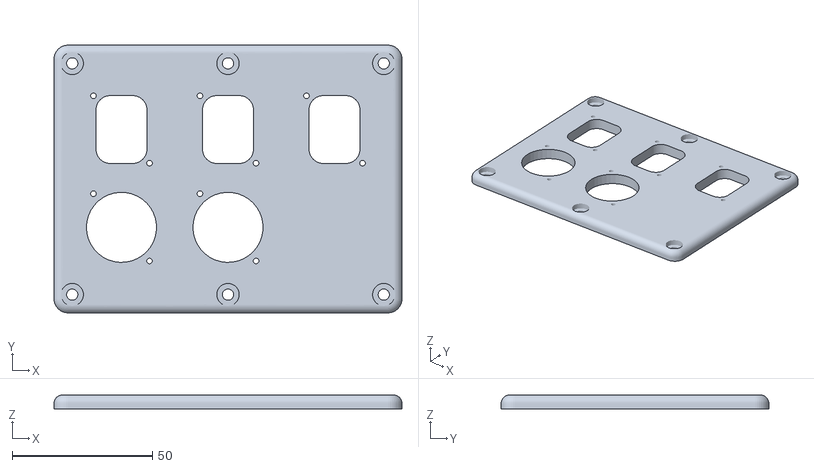
[picture p51: CAD file, 2021-06-09]
AR3 print files/3D print files/Enclosure Face Panels/Enclosure Face Panel.STL
124.1 x 95.5 x 5.00
