Wang-Ruohan/RV3-2/AR3 print files/3D print files/Epoxy on Supports/auxilliary J2 arm support.STL

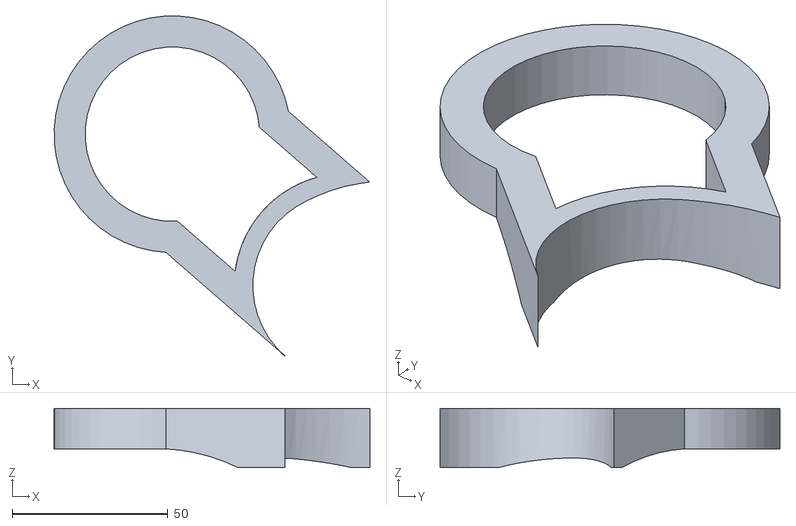
[picture p52: CAD file, 2021-06-09]
AR3 print files/3D print files/Epoxy on Supports/auxilliary J2 arm support.STL
101.3 x 109.2 x 19.0
