Wang-Ruohan/RV3-2/AR3 print files/3D print files/Jaws/AR3 jaw_left.STL

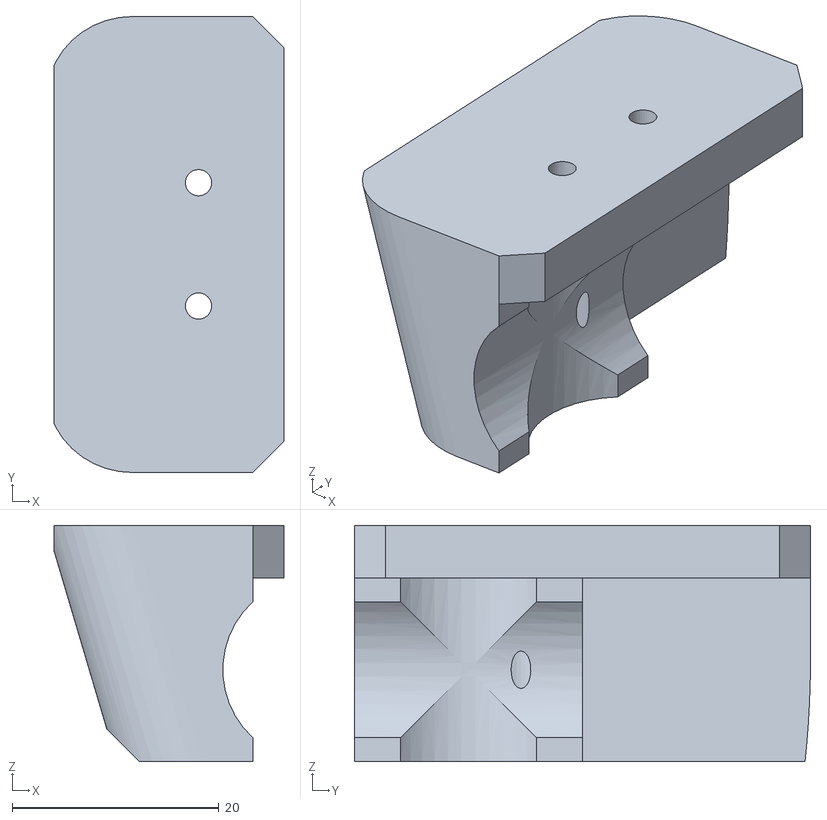
[picture p53: CAD file, 2021-06-09]
AR3 print files/3D print files/Jaws/AR3 jaw_left.STL
22.2 x 44.1 x 22.9
