Wang-Ruohan/RV3-2/AR3 print files/3D print files/Relay Mount/8 channel relay mount.STL

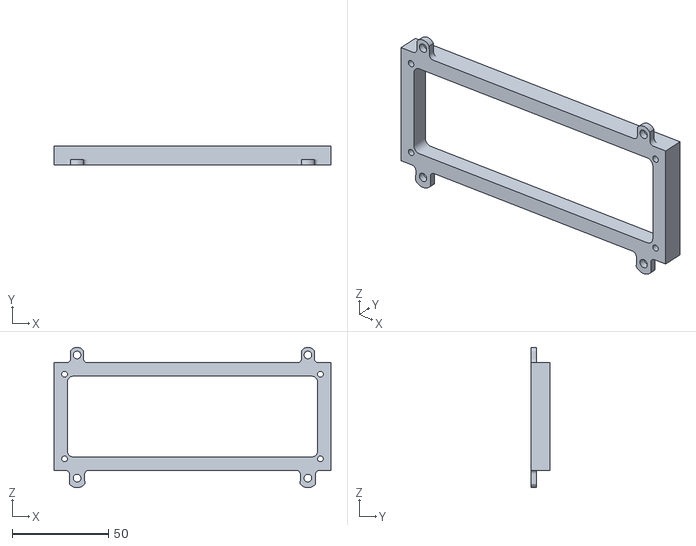
[picture p54: CAD file, 2021-06-09]
AR3 print files/3D print files/Relay Mount/8 channel relay mount.STL
144.0 x 10.0 x 73.0
