Wang-Ruohan/RV3-2/AR3 print files/3D print files/Structural Components - Nominal Size (identical aluminum parts)/J1 Spindle.STL

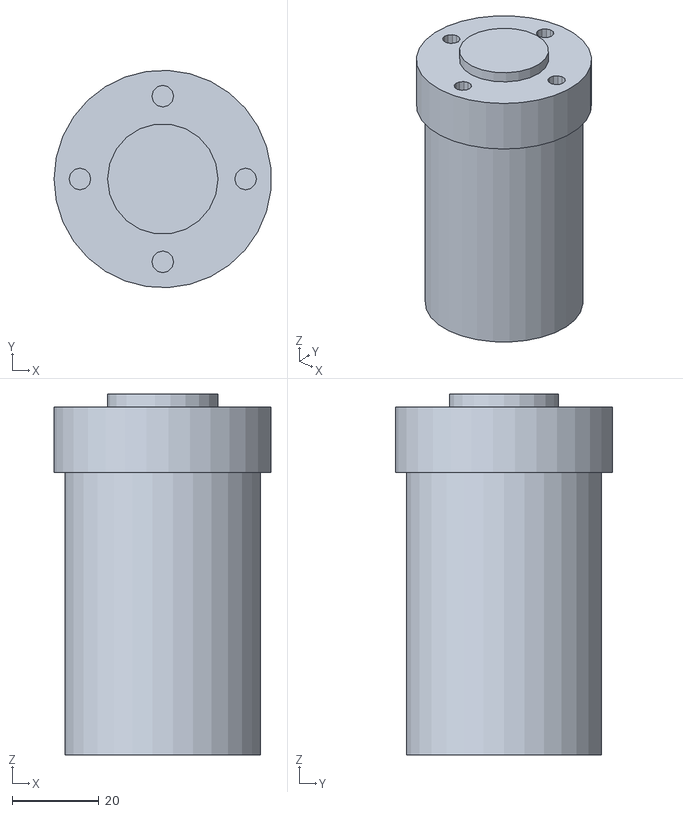
[picture p55: CAD file, 2021-06-09]
AR3 print files/3D print files/Structural Components - Nominal Size (identical aluminum parts)/J1 Spindle.STL
49.9 x 49.9 x 83.0
