Wang-Ruohan/RV3-2/AR3 print files/3D print files/Structural Components - Resized for shrink/J2 drive spindle - 14mm .STL

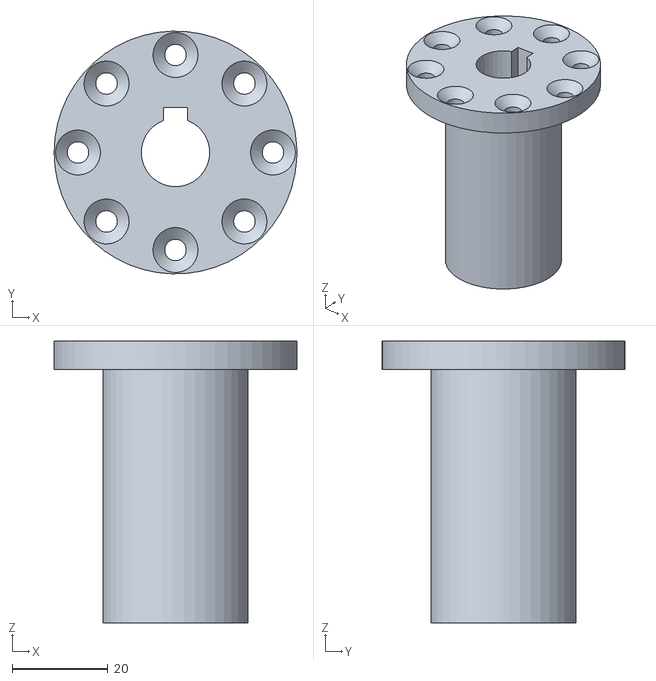
[picture p56: CAD file, 2021-06-09]
AR3 print files/3D print files/Structural Components - Resized for shrink/J2 drive spindle - 14mm .STL
50.8 x 50.8 x 59.0
