Wang-Ruohan/RV3-2/AR2 assembly/1件-J5/J5 Idler Tension Block.STEP

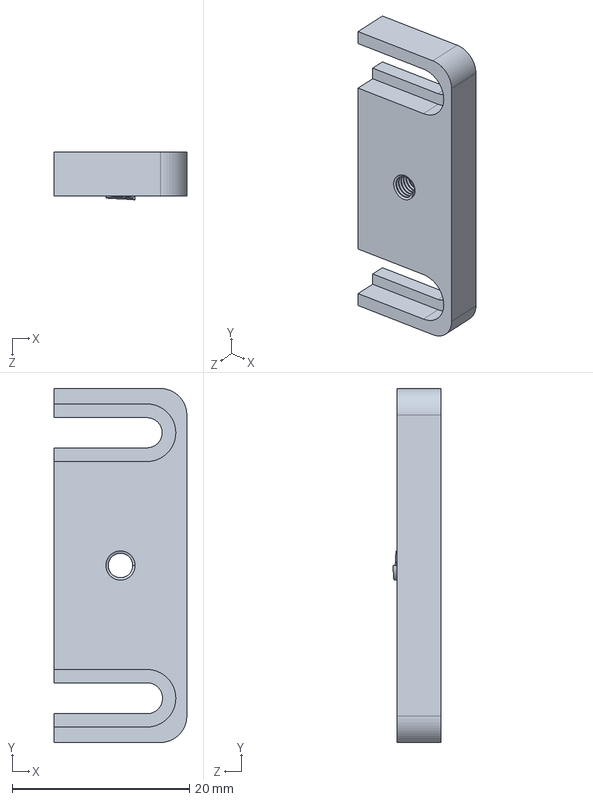
[picture p57: CAD file, 2021-06-09]
AR2 assembly/1件-J5/J5 Idler Tension Block.STEP
15.0 x 40.0 x 5.44 mm
