Wang-Ruohan/RV3-2/AR2 assembly/1件-整合/J1 Base Plate.STEP

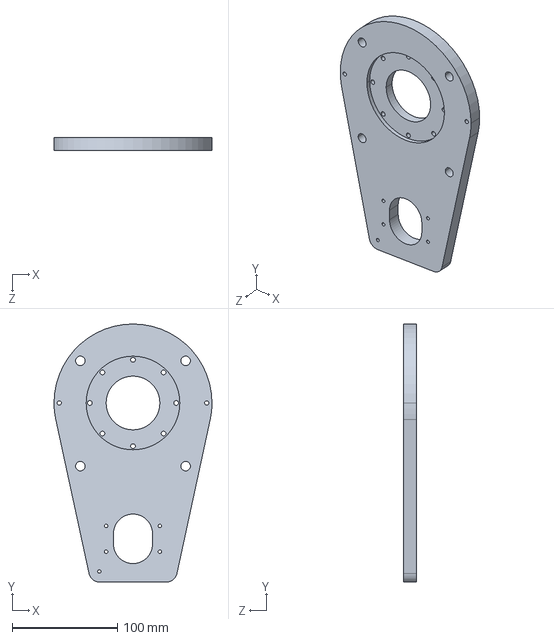
[picture p58: CAD file, 2021-06-09]
AR2 assembly/1件-整合/J1 Base Plate.STEP
150.0 x 245.0 x 12.7 mm
