Wang-Ruohan/RV3-2/AR2 assembly/AR2 assembly & step files/AR2 Robot - 5909K490_THRUST NEEDLE-ROLLER BRNG-2.STL

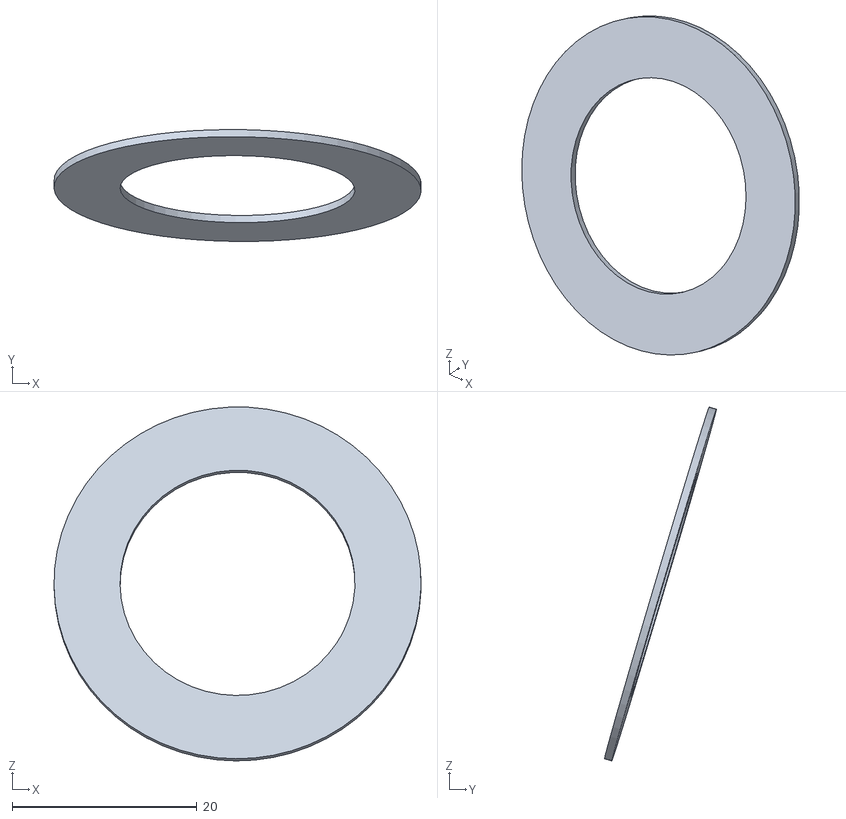
[picture p59: CAD file, 2021-06-09]
AR2 assembly/AR2 assembly & step files/AR2 Robot - 5909K490_THRUST NEEDLE-ROLLER BRNG-2.STL
39.7 x 12.1 x 38.3
