Wang-Ruohan/RV3-2/AR2 assembly/mashimar 众诚 7月2号/J4 motor mount - limit arm.STEP

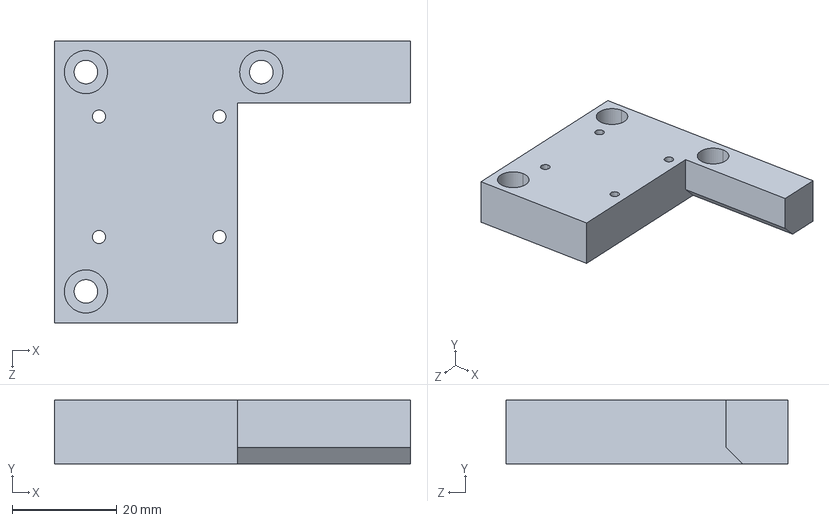
[picture p60: CAD file, 2021-06-09]
AR2 assembly/mashimar 众诚 7月2号/J4 motor mount - limit arm.STEP
68.0 x 12.2 x 53.8 mm
