Wang-Ruohan/RV3-2/AR2 assembly/树脂件/J5 side cover cap.STL

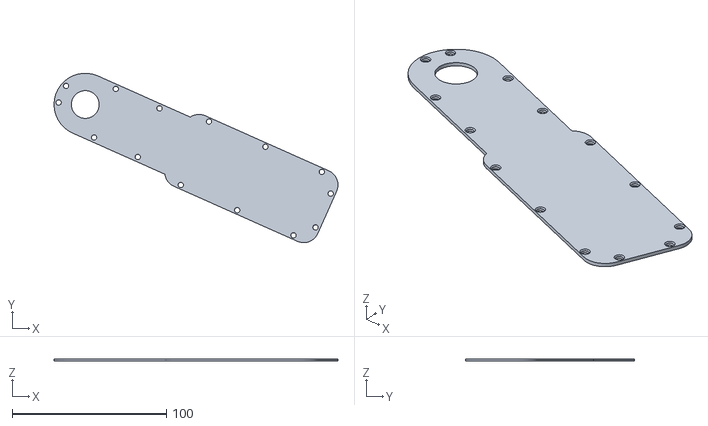
[picture p61: CAD file, 2021-06-09]
AR2 assembly/树脂件/J5 side cover cap.STL
184.0 x 109.7 x 1.59
