Wang-Ruohan/RV3-2/AR2 print files/Covers & Spacers - optimized for printing/J1 base support spacer part 2.SLDPRT

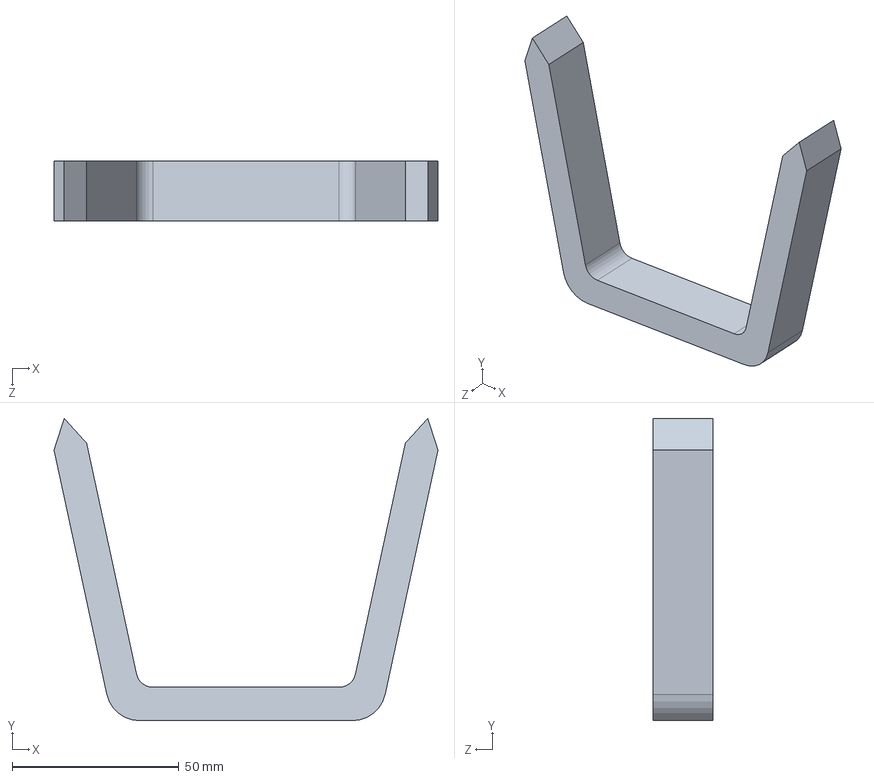
[picture p62: CAD file, 2021-06-09]
AR2 print files/Covers & Spacers - optimized for printing/J1 base support spacer part 2.SLDPRT
115.0 x 90.5 x 18.0 mm
