Wang-Ruohan/RV3-2/AR2 print files/Covers & Spacers - original/J2 arm cover spacer.SLDPRT

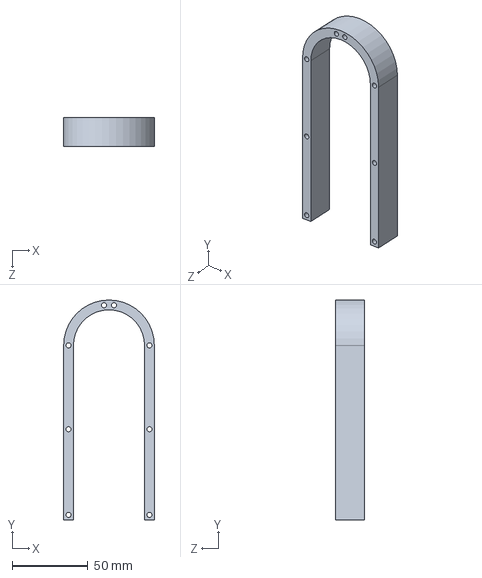
[picture p63: CAD file, 2021-06-09]
AR2 print files/Covers & Spacers - original/J2 arm cover spacer.SLDPRT
60.0 x 145.5 x 19.1 mm
