Wang-Ruohan/RV3-2/AR2 print files/Epoxy on Supports/auxilliary J2 arm support.SLDPRT

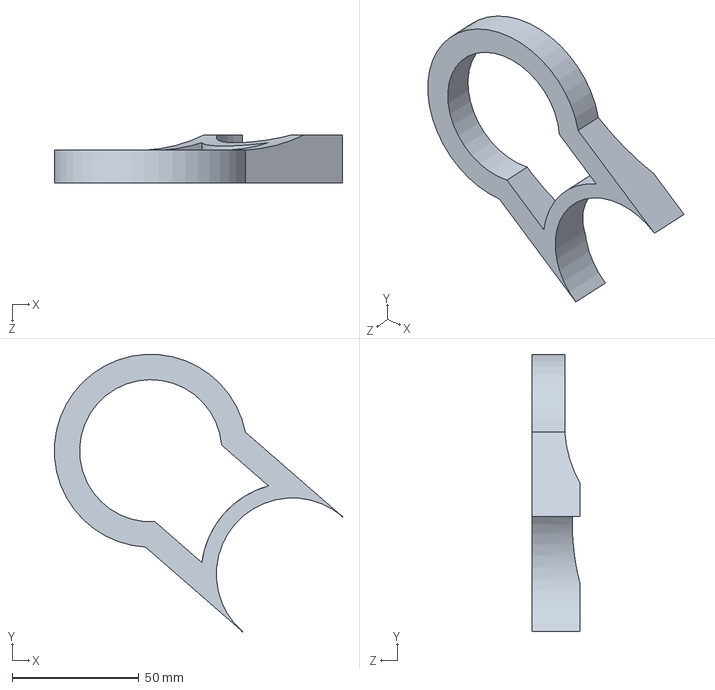
[picture p64: CAD file, 2021-06-09]
AR2 print files/Epoxy on Supports/auxilliary J2 arm support.SLDPRT
113.4 x 109.1 x 19.0 mm
