Wang-Ruohan/RV3-2/AR2 print files/Main Components - Resized for shrink/J2 arm part 1.STL

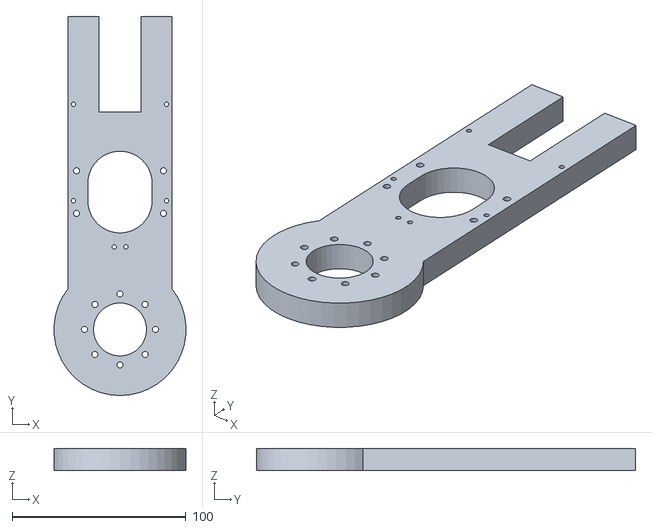
[picture p65: CAD file, 2021-06-09]
AR2 print files/Main Components - Resized for shrink/J2 arm part 1.STL
75.8 x 218.0 x 12.7
