Wang-Ruohan/RV3-2/AR2 print files/Modified Main Components - Remixed for large print bed/J1_Base_with_support_holes_v1_v5.stl

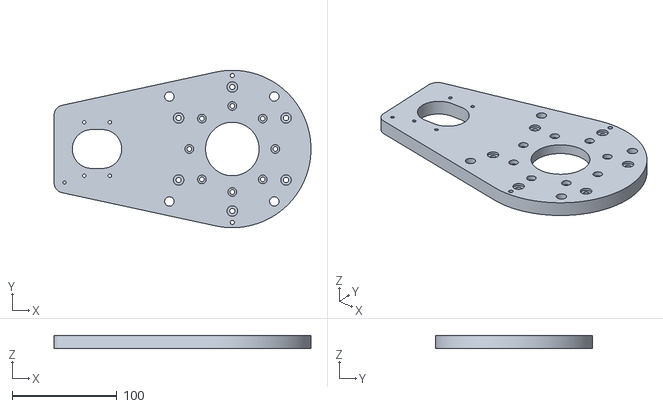
[picture p66: CAD file, 2021-06-09]
AR2 print files/Modified Main Components - Remixed for large print bed/J1_Base_with_support_holes_v1_v5.stl
245.0 x 150.0 x 12.7
