Wang-Ruohan/RV3-2/AR3 print files/3D print files/Covers and Spacers/J2 Arm Cover Spacer Lower.STL

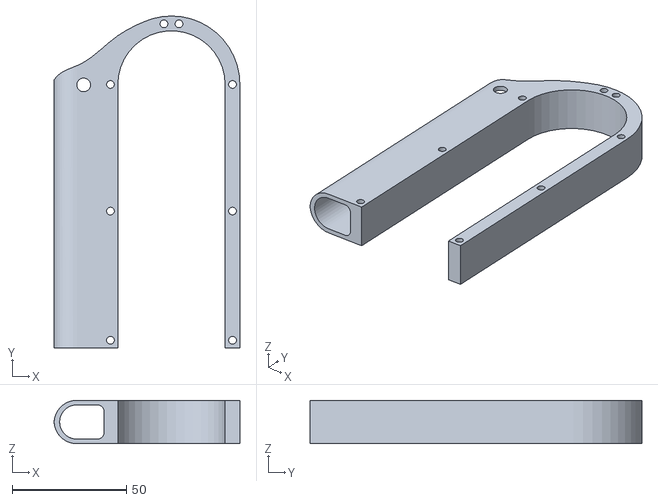
[picture p67: CAD file, 2021-06-09]
AR3 print files/3D print files/Covers and Spacers/J2 Arm Cover Spacer Lower.STL
81.5 x 145.5 x 19.1
