Wang-Ruohan/RV3-2/AR3 print files/3D print files/Structural Components - Resized for shrink/J6 gripper mount.STL

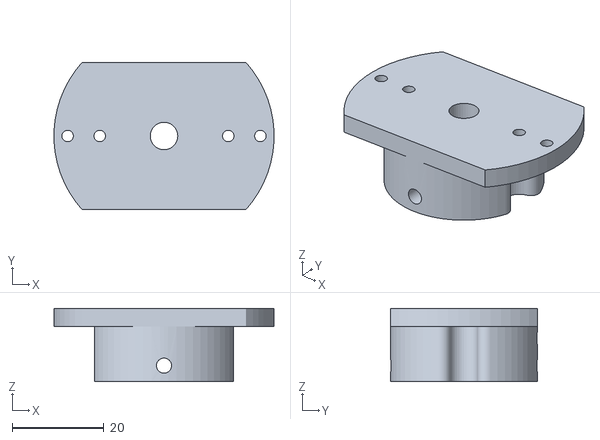
[picture p68: CAD file, 2021-06-09]
AR3 print files/3D print files/Structural Components - Resized for shrink/J6 gripper mount.STL
47.9 x 32.0 x 16.0
