Wang-Ruohan/RV3-2/AR2 assembly/1件-J5/J5 Belt Carrier Clamp.STEP

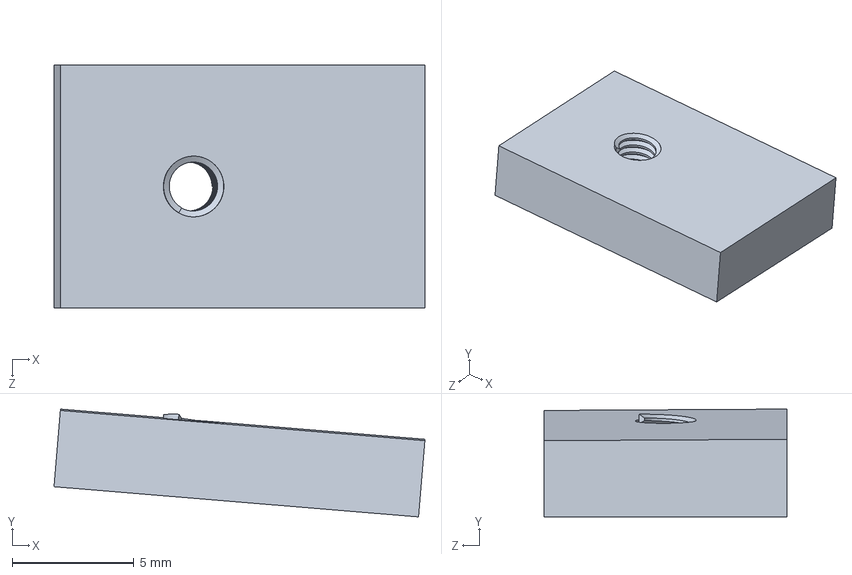
[picture p69: CAD file, 2021-06-09]
AR2 assembly/1件-J5/J5 Belt Carrier Clamp.STEP
15.3 x 4.44 x 10.0 mm
