Wang-Ruohan/RV3-2/AR2 assembly/AR2 assembly & step files/AR2 Robot - 17LS13-0404E-200H-1.STL

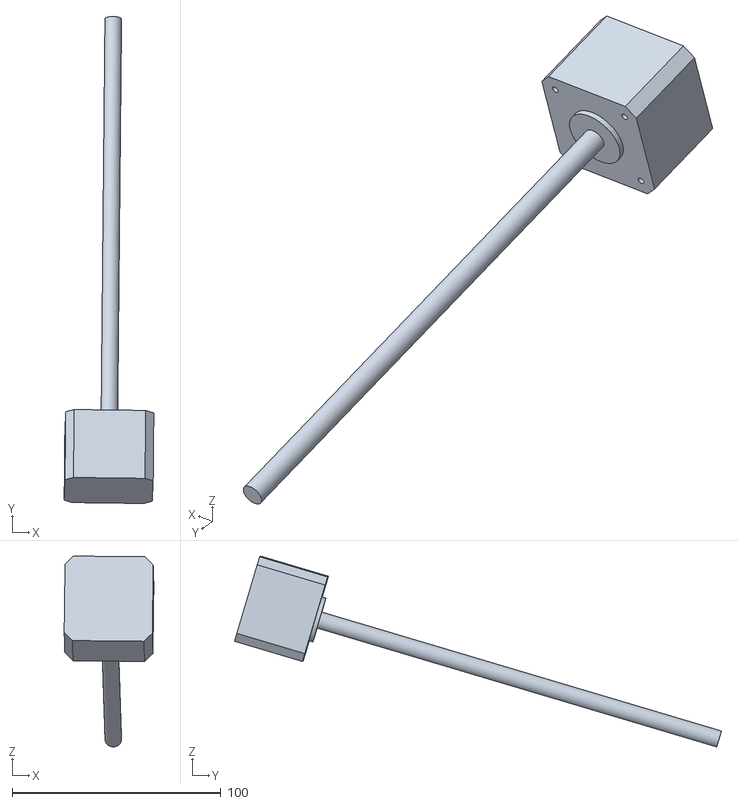
[picture p70: CAD file, 2021-06-09]
AR2 assembly/AR2 assembly & step files/AR2 Robot - 17LS13-0404E-200H-1.STL
43.1 x 233.6 x 91.6
