Wang-Ruohan/RV3-2/AR2 assembly/AR2 assembly & step files/Misc Parts/keyway.STEP

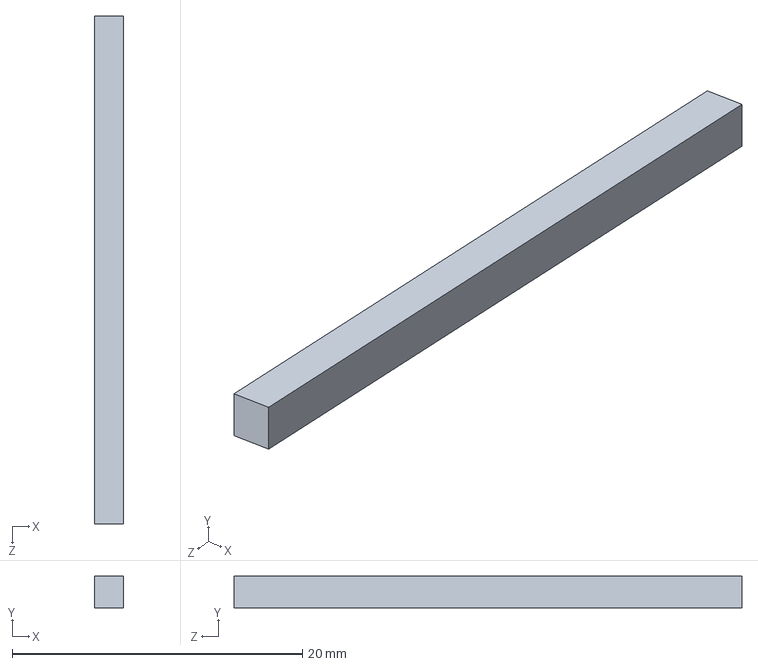
[picture p71: CAD file, 2021-06-09]
AR2 assembly/AR2 assembly & step files/Misc Parts/keyway.STEP
2.00 x 2.20 x 35.0 mm
