Wang-Ruohan/RV3-2/AR2 assembly/AR2 assembly/AR2 assembly & step files/J5 Idler Tension Block.STEP

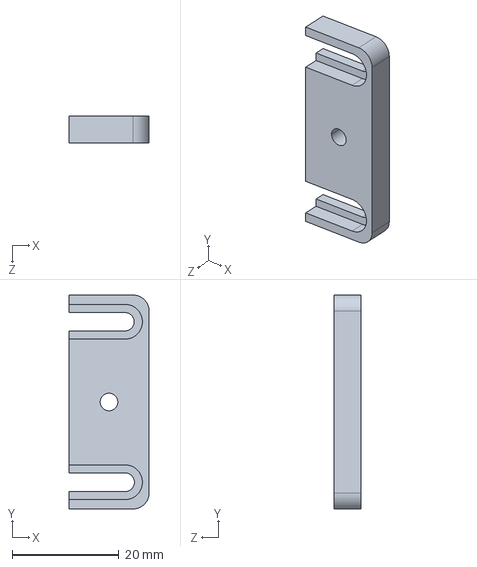
[picture p72: CAD file, 2021-06-09]
AR2 assembly/AR2 assembly/AR2 assembly & step files/J5 Idler Tension Block.STEP
15.0 x 40.0 x 5.00 mm
