Wang-Ruohan/RV3-2/AR2 assembly/AR2 assembly/AR2 assembly & step files/Misc Parts/J1 timing pulley.SLDPRT

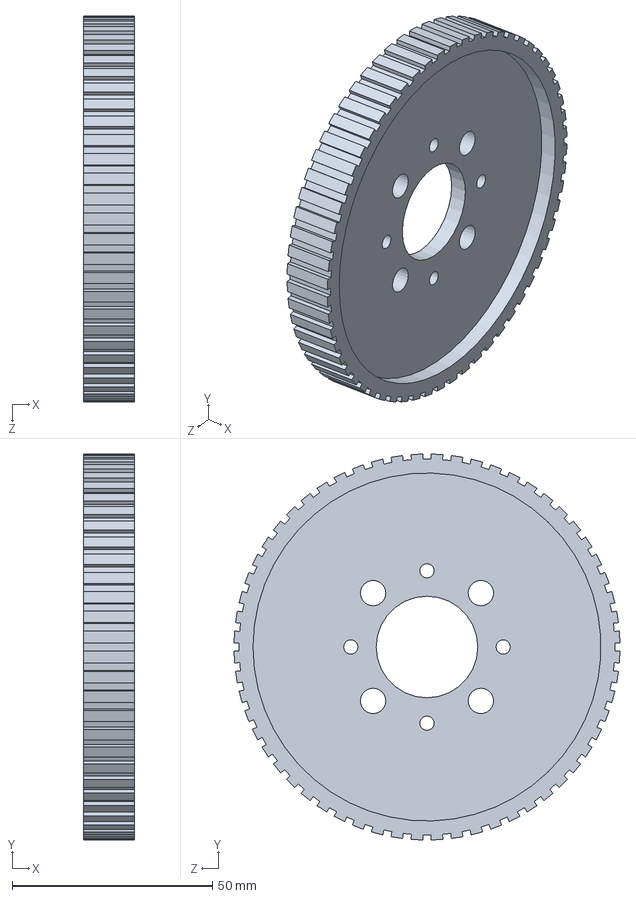
[picture p73: CAD file, 2021-06-09]
AR2 assembly/AR2 assembly/AR2 assembly & step files/Misc Parts/J1 timing pulley.SLDPRT
12.7 x 96.5 x 96.5 mm
