Wang-Ruohan/RV3-2/AR2 assembly/mashimaro051726众诚  7月21号 共13张/1件(1)/J6 gripper mount.STEP

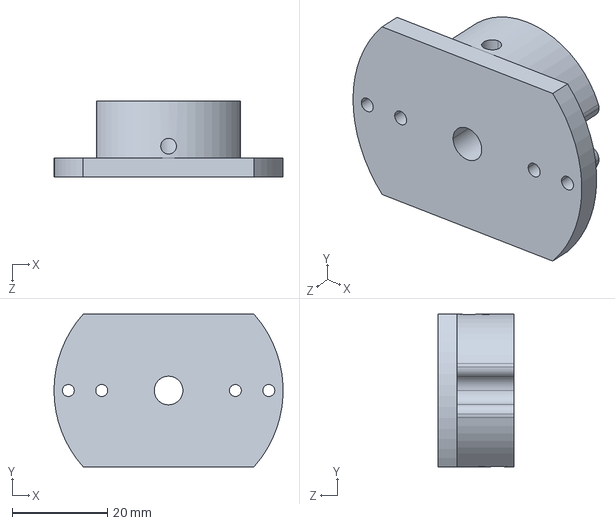
[picture p74: CAD file, 2021-06-09]
AR2 assembly/mashimaro051726众诚 7月21号 共13张/1件(1)/J6 gripper mount.STEP
48.0 x 32.0 x 16.0 mm
