Wang-Ruohan/RV3-2/AR2 assembly/mashimaro051726众诚  7月21号 共13张/1件-a(4)/J2 Tension Ring.STEP

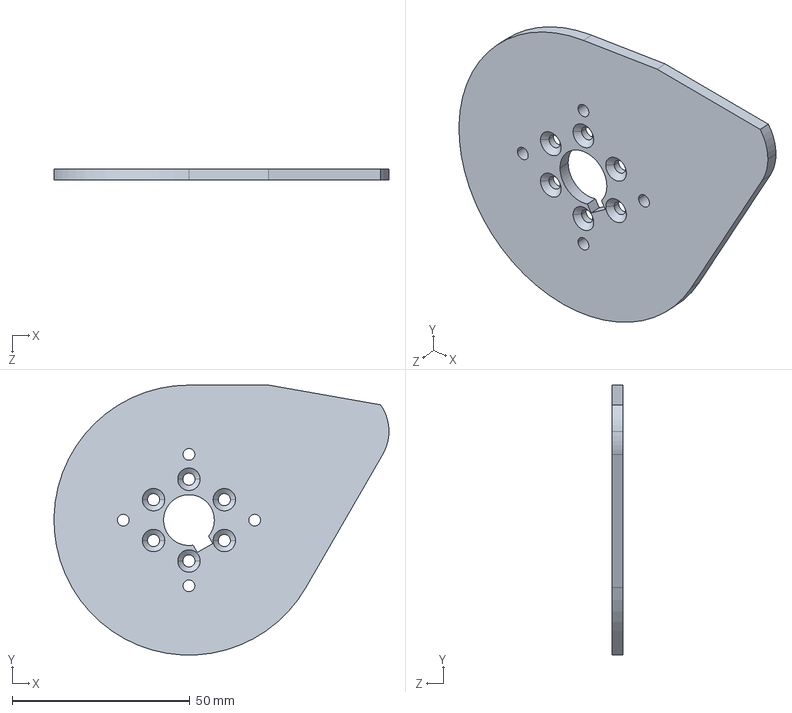
[picture p75: CAD file, 2021-06-09]
AR2 assembly/mashimaro051726众诚 7月21号 共13张/1件-a(4)/J2 Tension Ring.STEP
94.3 x 75.9 x 3.18 mm
