Wang-Ruohan/RV3-2/AR2 assembly/树脂件/J5 Housing.STL

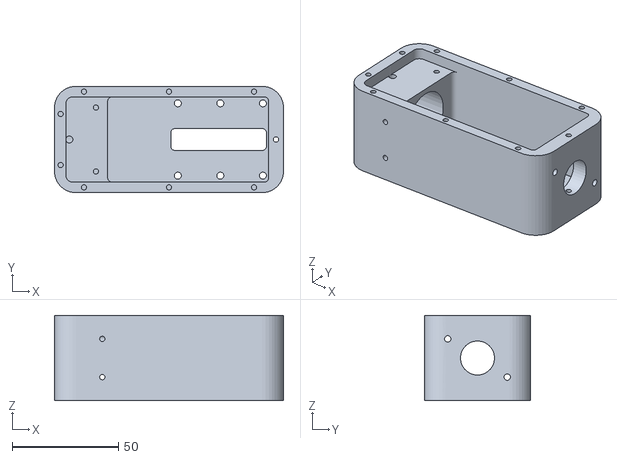
[picture p76: CAD file, 2021-06-09]
AR2 assembly/树脂件/J5 Housing.STL
107.7 x 50.0 x 40.0
