Wang-Ruohan/RV3-2/AR2 print files/Covers & Spacers - optimized for printing/J5 Side Cover.SLDPRT

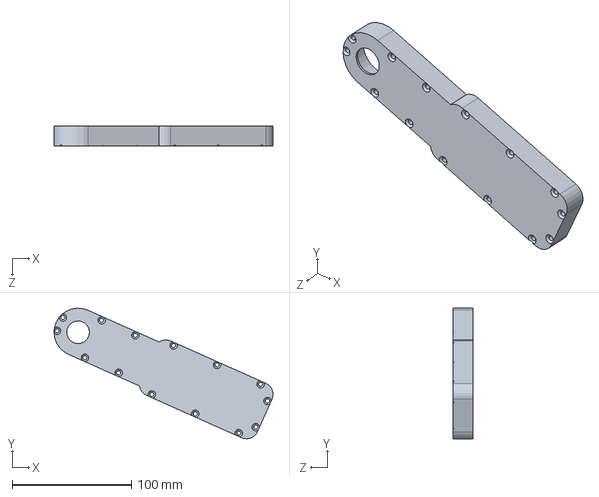
[picture p77: CAD file, 2021-06-09]
AR2 print files/Covers & Spacers - optimized for printing/J5 Side Cover.SLDPRT
183.9 x 109.8 x 16.6 mm
