Wang-Ruohan/RV3-2/AR2 print files/Epoxy on Supports/auxilliary platform support.SLDPRT

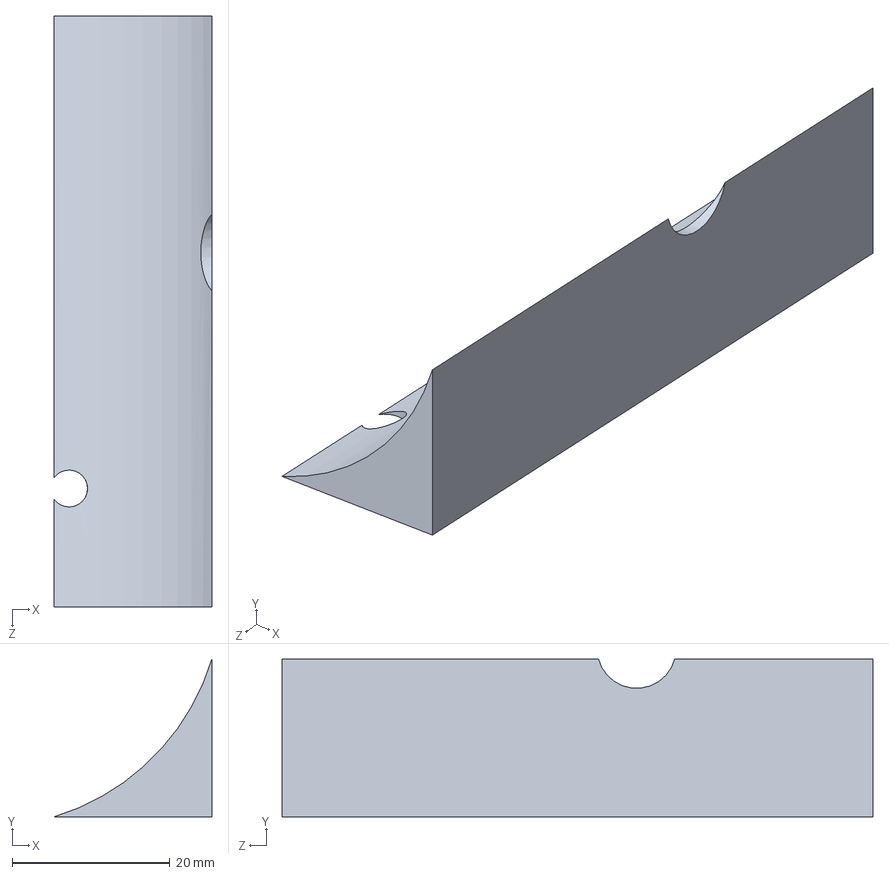
[picture p78: CAD file, 2021-06-09]
AR2 print files/Epoxy on Supports/auxilliary platform support.SLDPRT
20.0 x 20.0 x 75.0 mm
