Wang-Ruohan/RV3-2/AR2 print files/Main Components - Resized for shrink/J1 turret housing.STL

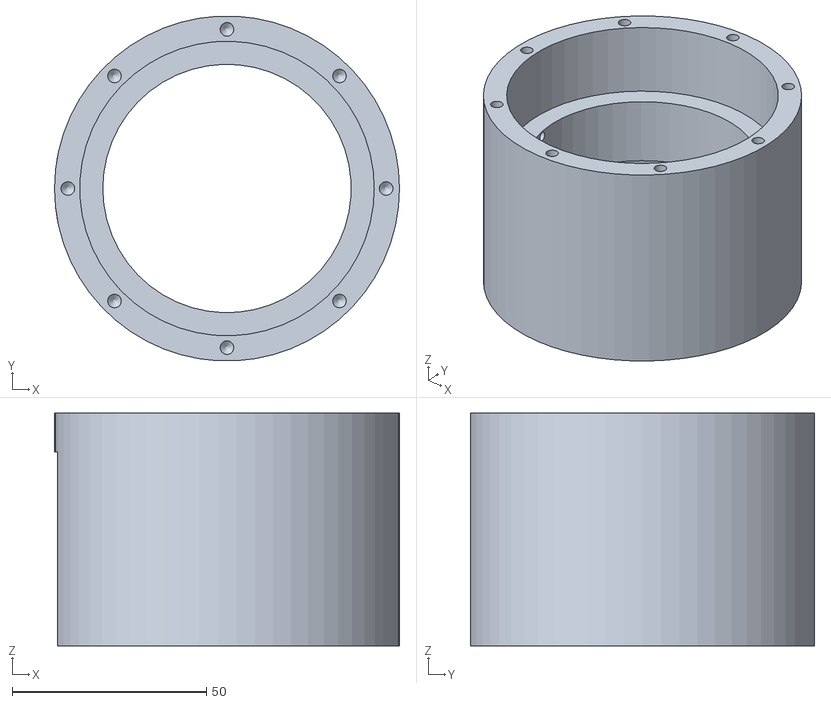
[picture p79: CAD file, 2021-06-09]
AR2 print files/Main Components - Resized for shrink/J1 turret housing.STL
88.9 x 88.8 x 60.0
