Wang-Ruohan/RV3-2/AR2 print files/Modified Main Components - Remixed for large print bed/J5_side_cover_and_spacers.stl

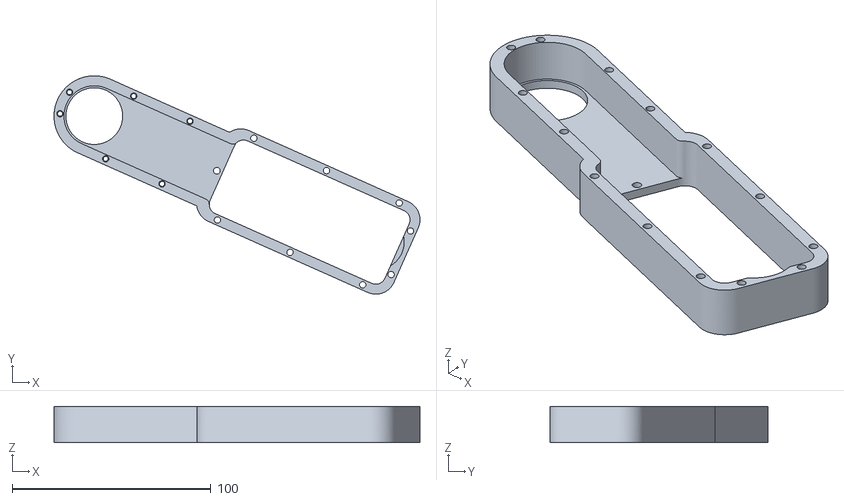
[picture p80: CAD file, 2021-06-09]
AR2 print files/Modified Main Components - Remixed for large print bed/J5_side_cover_and_spacers.stl
184.0 x 109.8 x 18.2
