Wang-Ruohan/RV3-2/AR2 print files/Travel Track/motor mount.SLDPRT

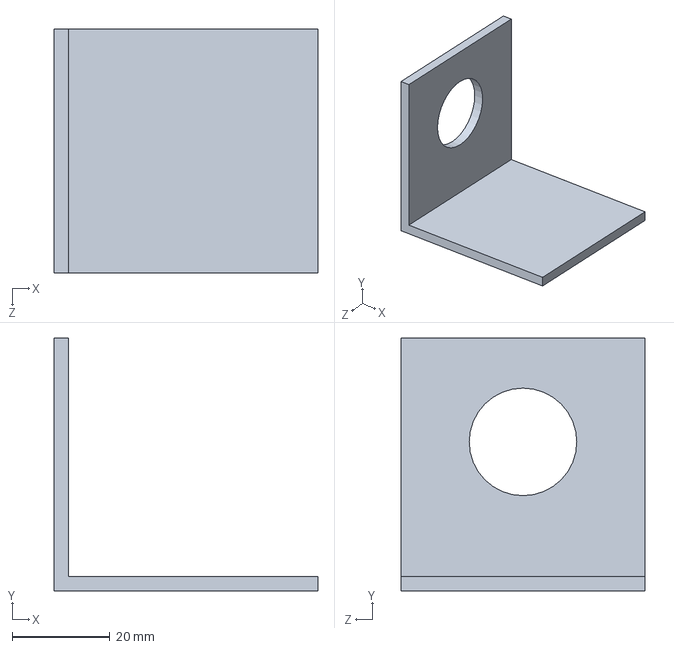
[picture p81: CAD file, 2021-06-09]
AR2 print files/Travel Track/motor mount.SLDPRT
54.0 x 51.8 x 50.0 mm
