Wang-Ruohan/RV3-2/AR3 assembly/Bearing NTA1625.STEP

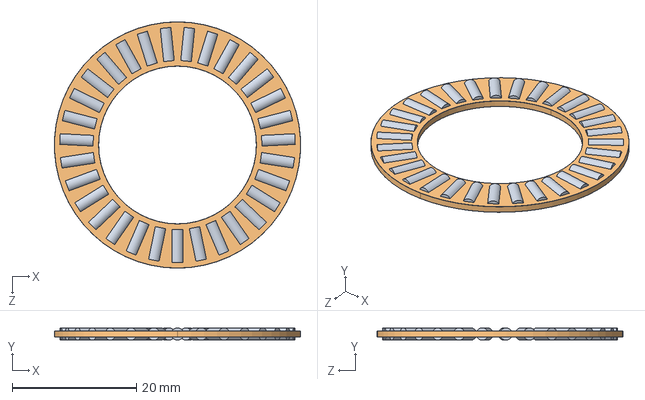
[picture p82: CAD file, 2021-06-09]
AR3 assembly/Bearing NTA1625.STEP
39.6 x 1.98 x 39.7 mm
