Wang-Ruohan/RV3-2/AR3 print files/3D print files/Jaws/AR2 jaw.STL

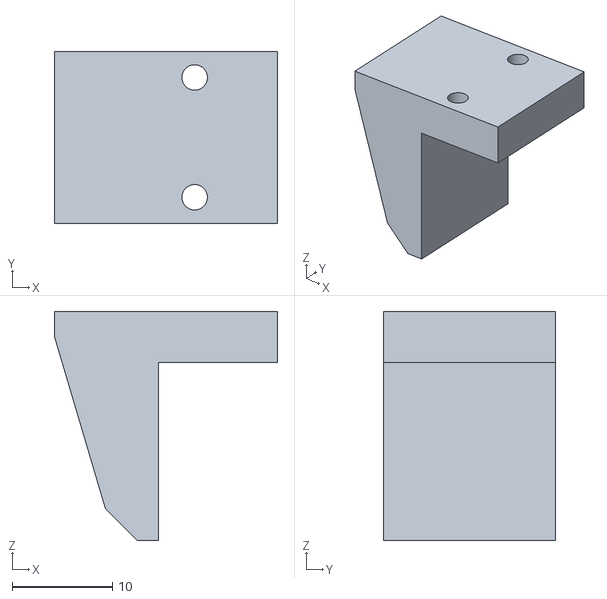
[picture p83: CAD file, 2021-06-09]
AR3 print files/3D print files/Jaws/AR2 jaw.STL
22.2 x 17.1 x 22.9
