Wang-Ruohan/RV3-2/AR3 print files/3D print files/Structural Components - Nominal Size (identical aluminum parts)/J5 Belt Carrier Clamp.STL

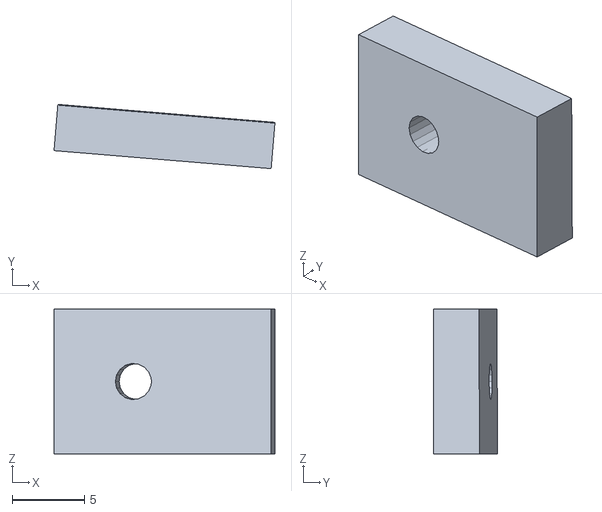
[picture p84: CAD file, 2021-06-09]
AR3 print files/3D print files/Structural Components - Nominal Size (identical aluminum parts)/J5 Belt Carrier Clamp.STL
15.3 x 4.44 x 10.0
