Wang-Ruohan/RV3-2/AR3 print files/3D print files/Structural Components - Resized for shrink/J2 turret housing.STL

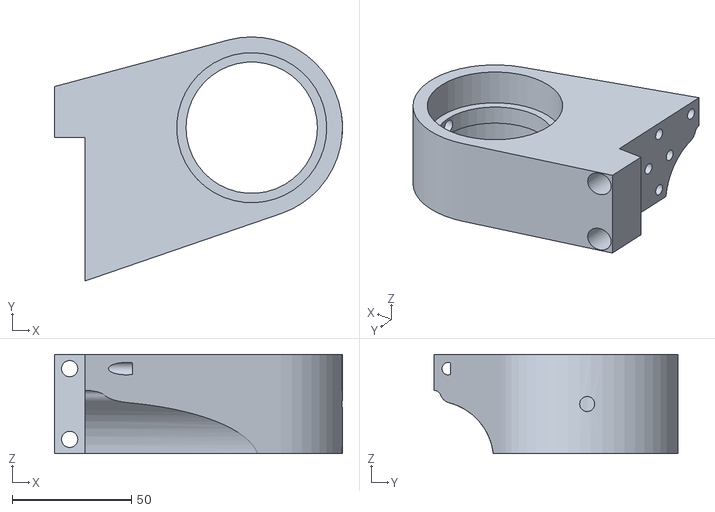
[picture p85: CAD file, 2021-06-09]
AR3 print files/3D print files/Structural Components - Resized for shrink/J2 turret housing.STL
120.6 x 102.2 x 41.6
