Wang-Ruohan/RV3-2/AR2 assembly/1件-J5/J5 Belt Carrier.STEP

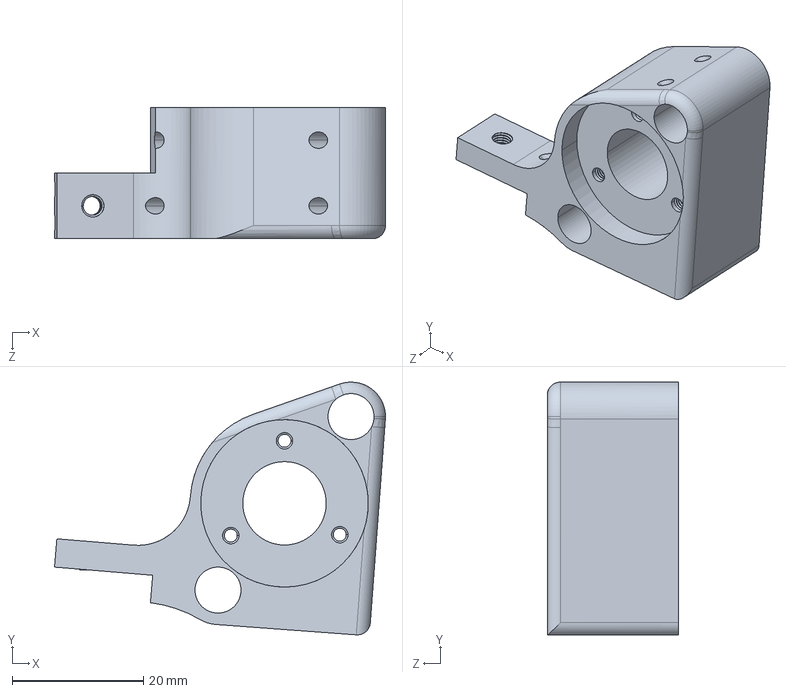
[picture p86: CAD file, 2021-06-09]
AR2 assembly/1件-J5/J5 Belt Carrier.STEP
50.4 x 38.5 x 20.0 mm
