Wang-Ruohan/RV3-2/AR2 assembly/1件-整合/J6 housing single piece.STEP

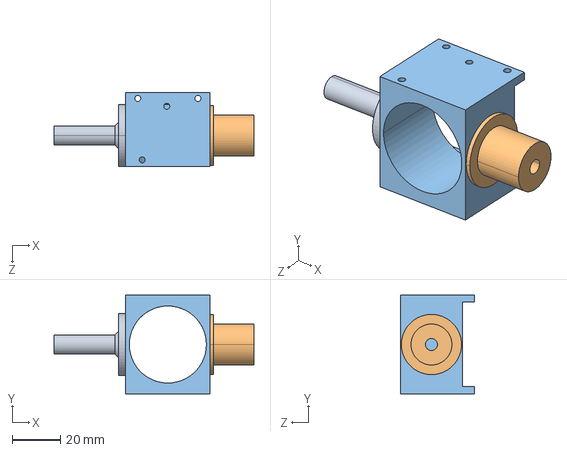
[picture p87: CAD file, 2021-06-09]
AR2 assembly/1件-整合/J6 housing single piece.STEP
83.1 x 41.0 x 30.8 mm
