Wang-Ruohan/RV3-2/AR2 assembly/AR2 assembly & step files/AR2 Robot - J1 bearing outer-2.STL

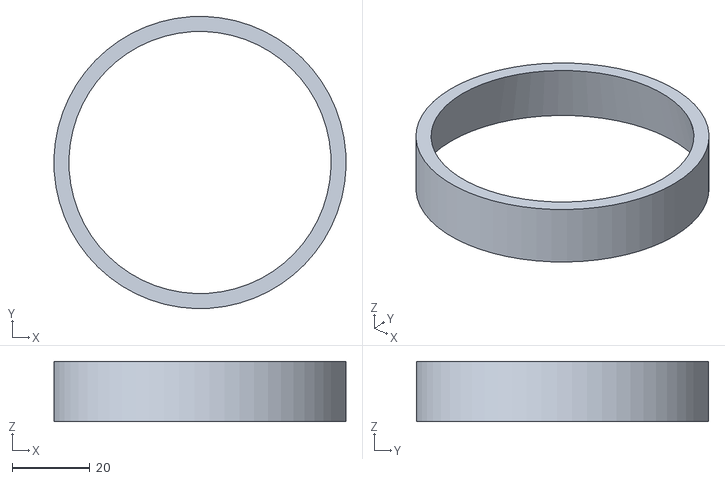
[picture p88: CAD file, 2021-06-09]
AR2 assembly/AR2 assembly & step files/AR2 Robot - J1 bearing outer-2.STL
74.9 x 74.9 x 15.5
