Wang-Ruohan/RV3-2/AR2 assembly/AR2 assembly/AR2 assembly & step files/J5 side cover spacer.SLDPRT

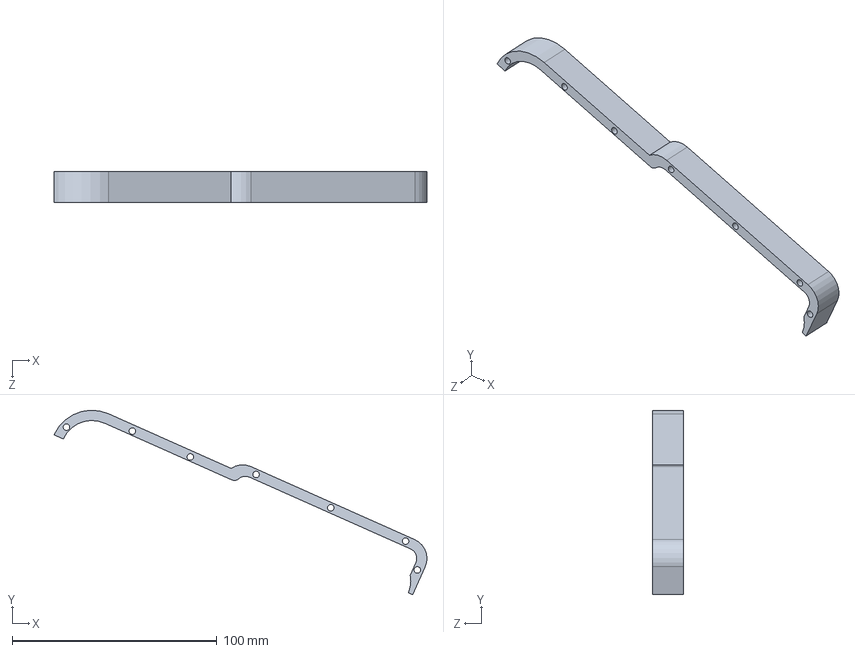
[picture p89: CAD file, 2021-06-09]
AR2 assembly/AR2 assembly/AR2 assembly & step files/J5 side cover spacer.SLDPRT
182.2 x 90.1 x 15.0 mm
