Wang-Ruohan/RV3-2/AR2 assembly/AR2 assembly/AR2 assembly & step files/Misc Parts/J1 bearing outer.SLDPRT

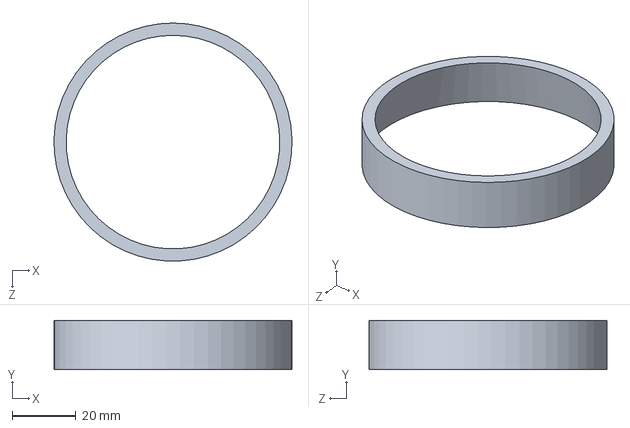
[picture p90: CAD file, 2021-06-09]
AR2 assembly/AR2 assembly/AR2 assembly & step files/Misc Parts/J1 bearing outer.SLDPRT
75.0 x 15.5 x 74.9 mm
