Wang-Ruohan/RV3-2/AR2 assembly/mashimar 众诚 7月2号/J3 Bearing Cup.STEP

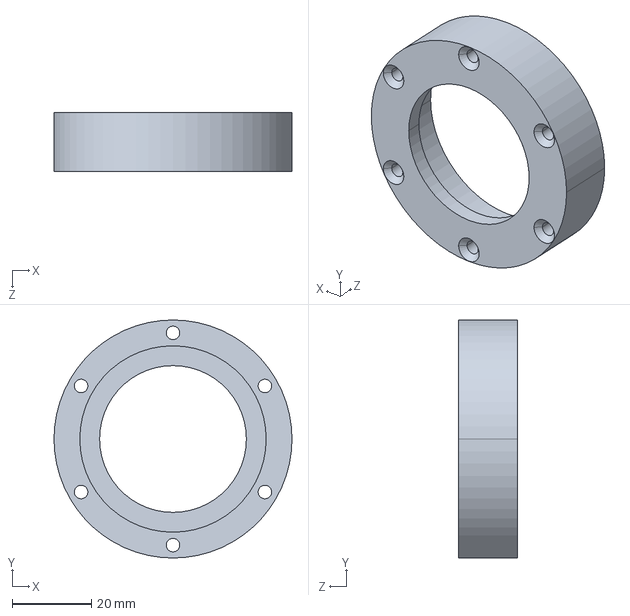
[picture p91: CAD file, 2021-06-09]
AR2 assembly/mashimar 众诚 7月2号/J3 Bearing Cup.STEP
60.0 x 60.0 x 15.0 mm
