Wang-Ruohan/RV3-2/AR2 assembly/树脂件/J5 side cover spacer.STL

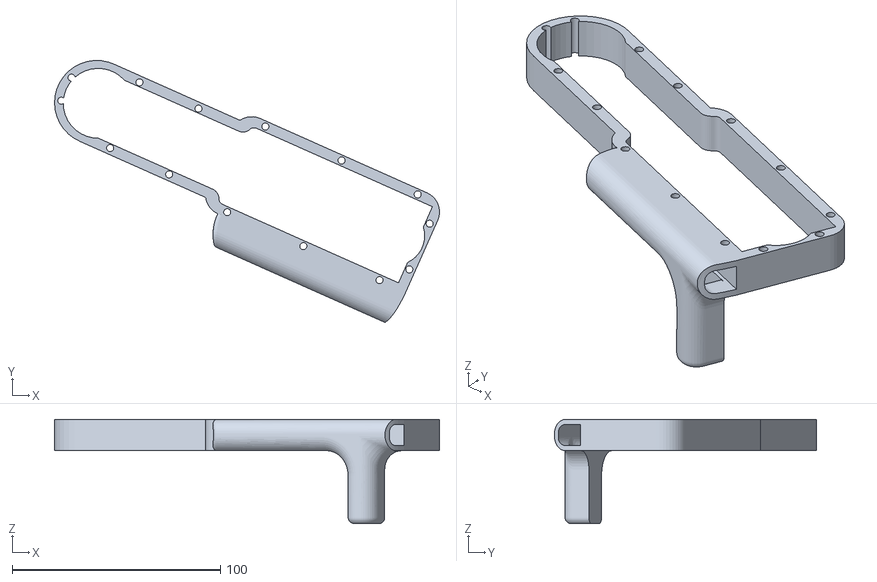
[picture p92: CAD file, 2021-06-09]
AR2 assembly/树脂件/J5 side cover spacer.STL
184.7 x 125.7 x 50.0
