Wang-Ruohan/RV3-2/AR2 print files/Covers & Spacers - original/J1 base support spacer part 1.SLDPRT

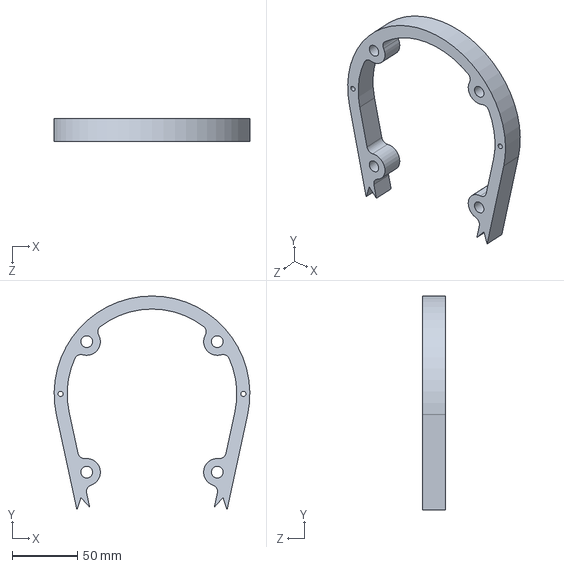
[picture p93: CAD file, 2021-06-09]
AR2 print files/Covers & Spacers - original/J1 base support spacer part 1.SLDPRT
150.0 x 164.0 x 18.0 mm
