Wang-Ruohan/RV3-2/AR2 print files/Main Components - Nominal Size (identical aluminum parts)/J2 Drive Spindle.STL

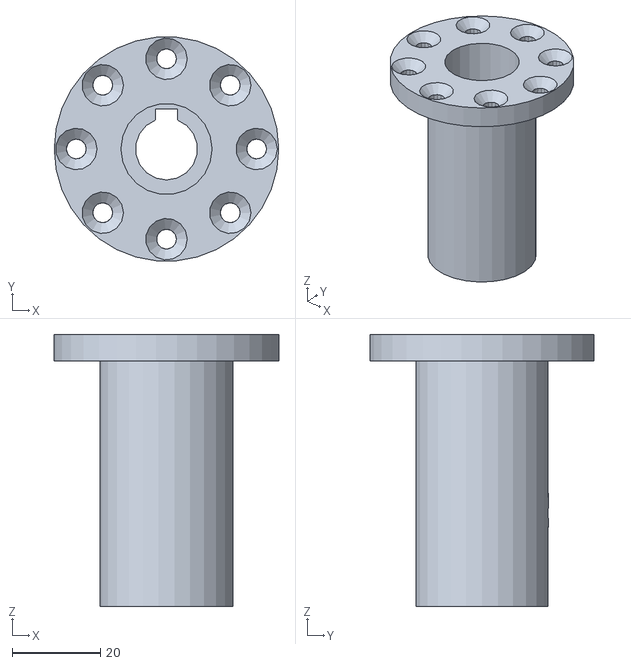
[picture p94: CAD file, 2021-06-09]
AR2 print files/Main Components - Nominal Size (identical aluminum parts)/J2 Drive Spindle.STL
50.8 x 50.6 x 61.5
