Wang-Ruohan/RV3-2/AR2 print files/Main Components - Resized for shrink/J6 drive post.STL

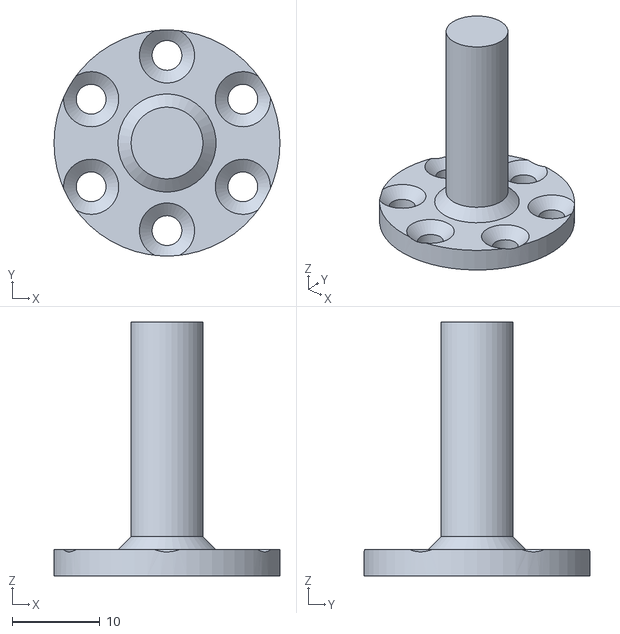
[picture p95: CAD file, 2021-06-09]
AR2 print files/Main Components - Resized for shrink/J6 drive post.STL
25.8 x 25.8 x 29.0
