Wang-Ruohan/RV3-2/AR2 print files/Modified Main Components - Remixed for large print bed/J1_Turret_with_supports__v4.stl

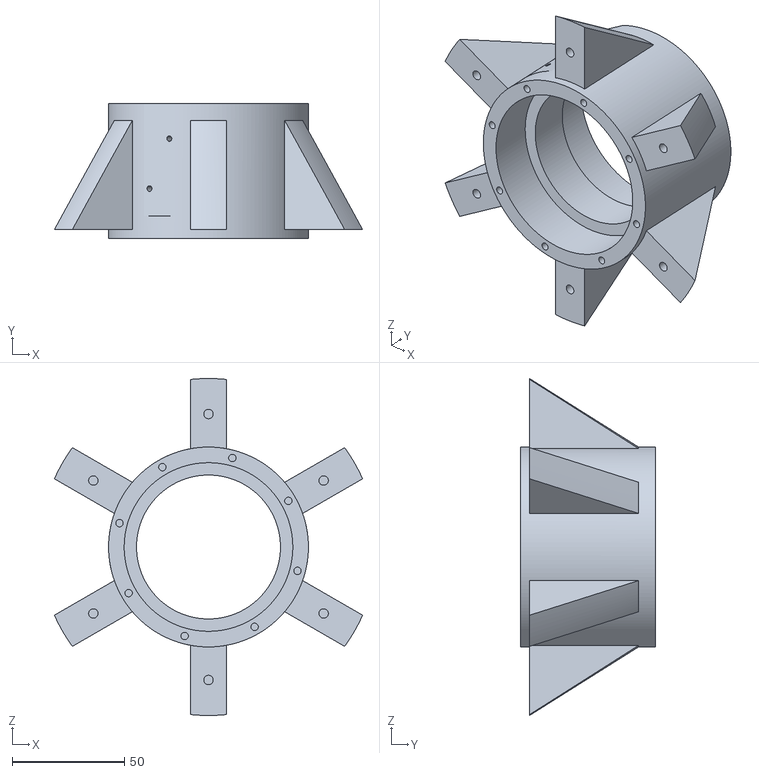
[picture p96: CAD file, 2021-06-09]
AR2 print files/Modified Main Components - Remixed for large print bed/J1_Turret_with_supports__v4.stl
137.1 x 60.0 x 149.9
