Wang-Ruohan/RV3-2/AR3 assembly/J1 Turret Platform.STEP

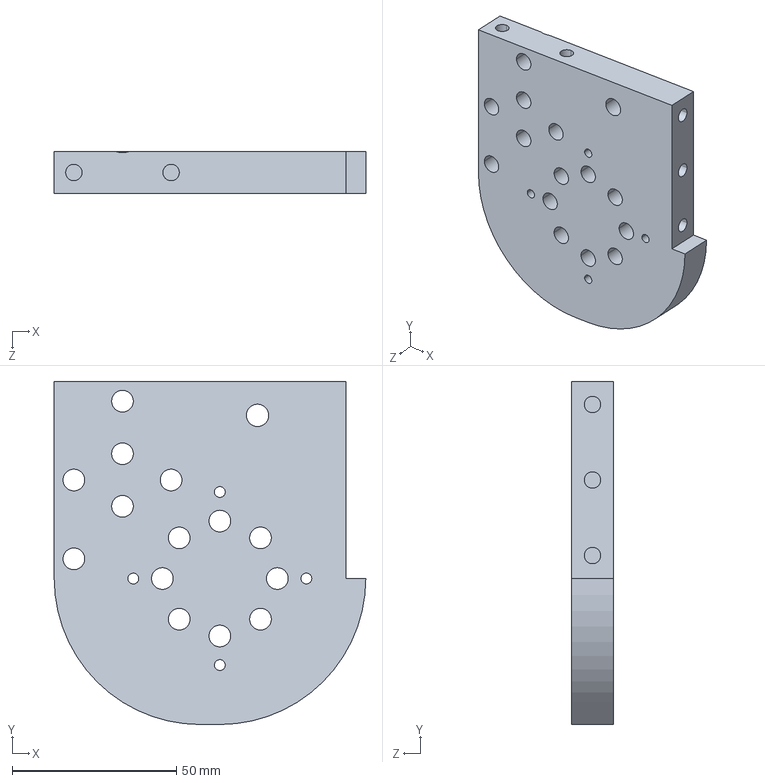
[picture p97: CAD file, 2021-06-09]
AR3 assembly/J1 Turret Platform.STEP
94.9 x 104.5 x 12.7 mm
