Wang-Ruohan/RV3-2/AR3 print files/3D print files/Covers and Spacers/J4 motor spacer - 3mm.STL

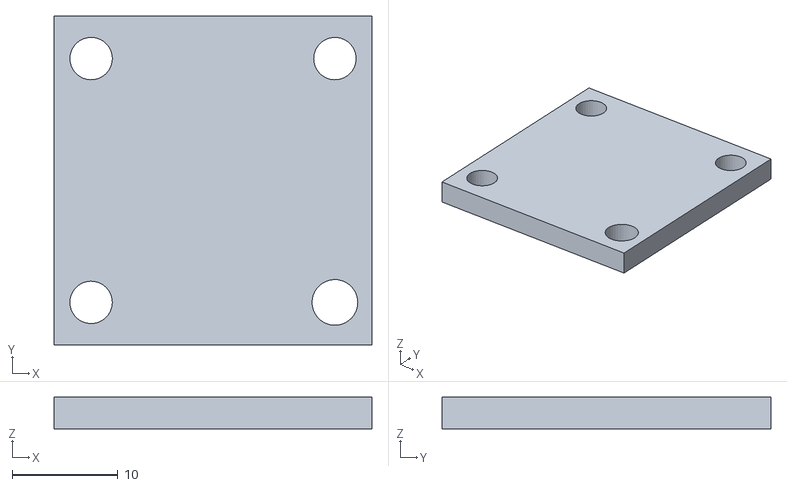
[picture p98: CAD file, 2021-06-09]
AR3 print files/3D print files/Covers and Spacers/J4 motor spacer - 3mm.STL
30.0 x 31.0 x 3.00
