Wang-Ruohan/RV3-2/AR2 assembly/1件-J5/J5 Bearing Post.STEP

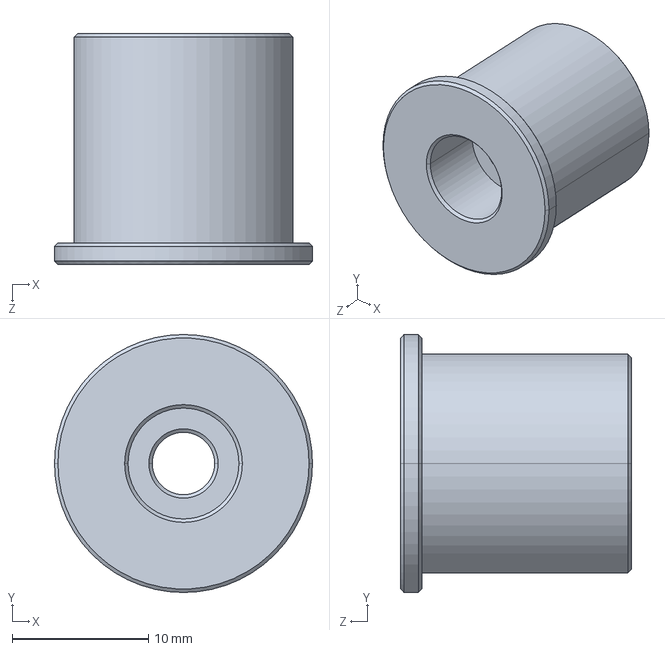
[picture p99: CAD file, 2021-06-09]
AR2 assembly/1件-J5/J5 Bearing Post.STEP
18.9 x 18.9 x 16.9 mm
