Wang-Ruohan/RV3-2/AR2 assembly/AR2 assembly & step files/Misc Parts/17LS13-0404E-200H.SLDPRT

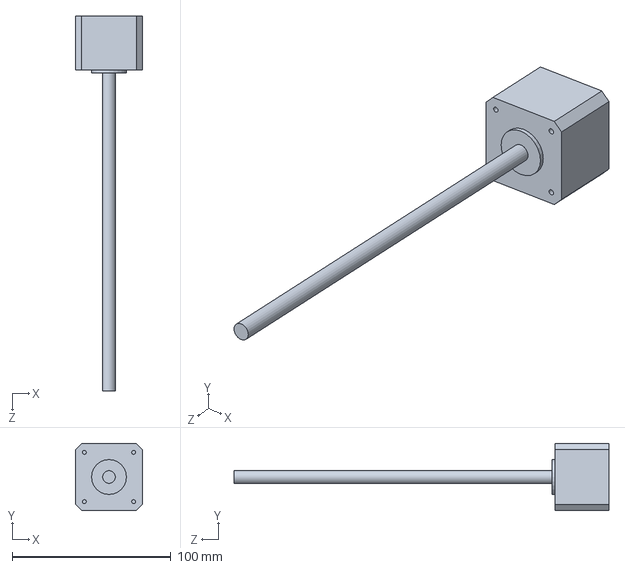
[picture p100: CAD file, 2021-06-09]
AR2 assembly/AR2 assembly & step files/Misc Parts/17LS13-0404E-200H.SLDPRT
42.3 x 42.3 x 236.0 mm
