Wang-Ruohan/RV3-2/AR2 assembly/AR2 assembly/AR2 assembly & step files/Misc Parts/modified micro switch.SLDPRT

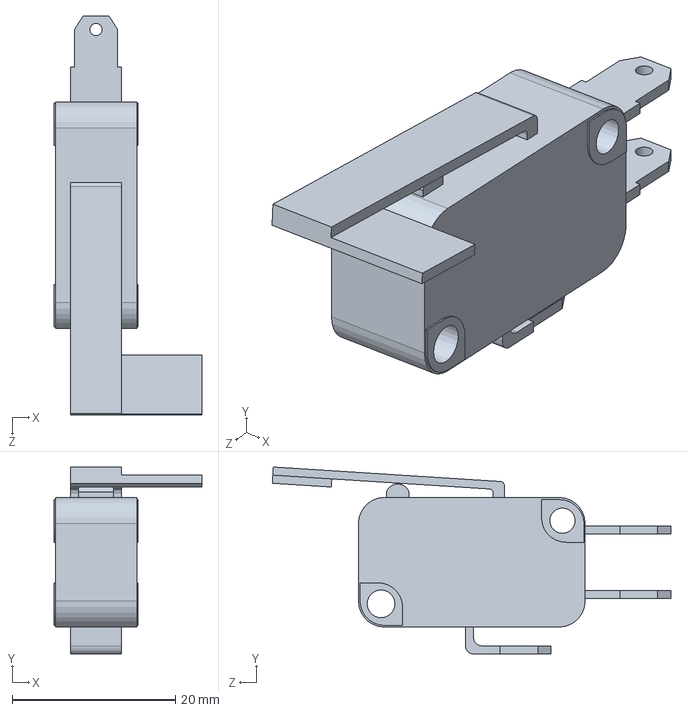
[picture p101: CAD file, 2021-06-09]
AR2 assembly/AR2 assembly/AR2 assembly & step files/Misc Parts/modified micro switch.SLDPRT
18.1 x 22.9 x 48.9 mm
