Wang-Ruohan/RV3-2/AR2 assembly/mashimar 众诚 7月2号/J3 Spindle.STEP

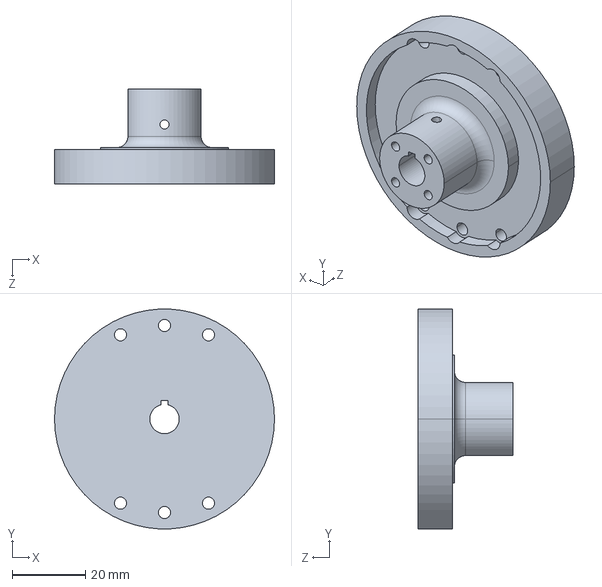
[picture p102: CAD file, 2021-06-09]
AR2 assembly/mashimar 众诚 7月2号/J3 Spindle.STEP
60.0 x 59.9 x 26.0 mm
