Wang-Ruohan/RV3-2/AR2 assembly/mashimaro051726众诚  7月21号 共13张/1件-a(4)/J2 Motor Support.STEP

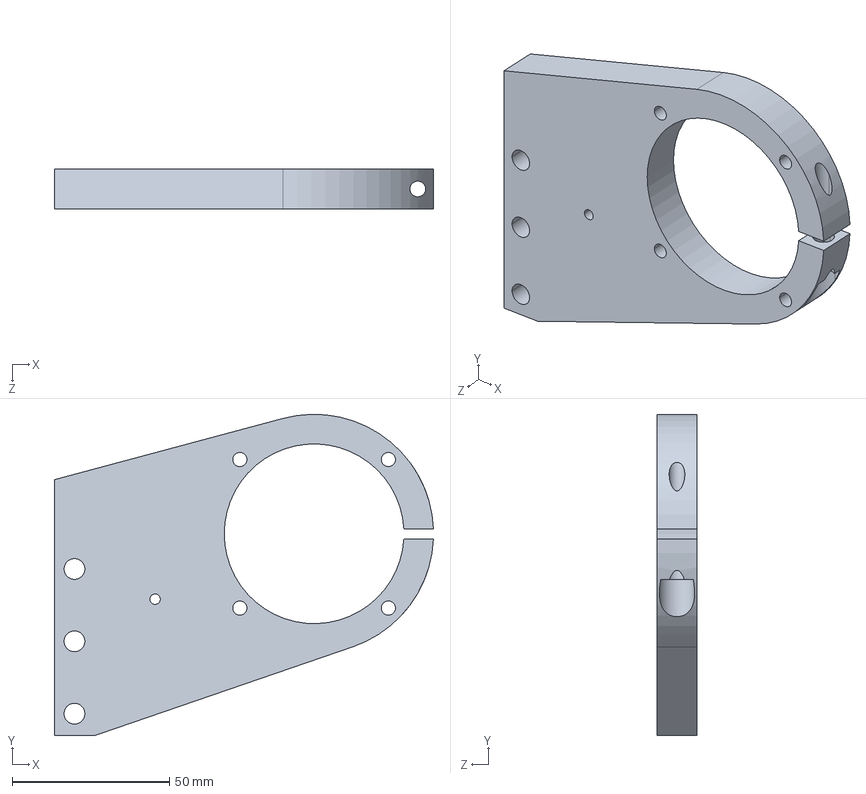
[picture p103: CAD file, 2021-06-09]
AR2 assembly/mashimaro051726众诚 7月21号 共13张/1件-a(4)/J2 Motor Support.STEP
120.5 x 102.2 x 12.7 mm
