Wang-Ruohan/RV3-2/AR2 print files/Covers & Spacers - optimized for printing/J2 side cover half .SLDPRT

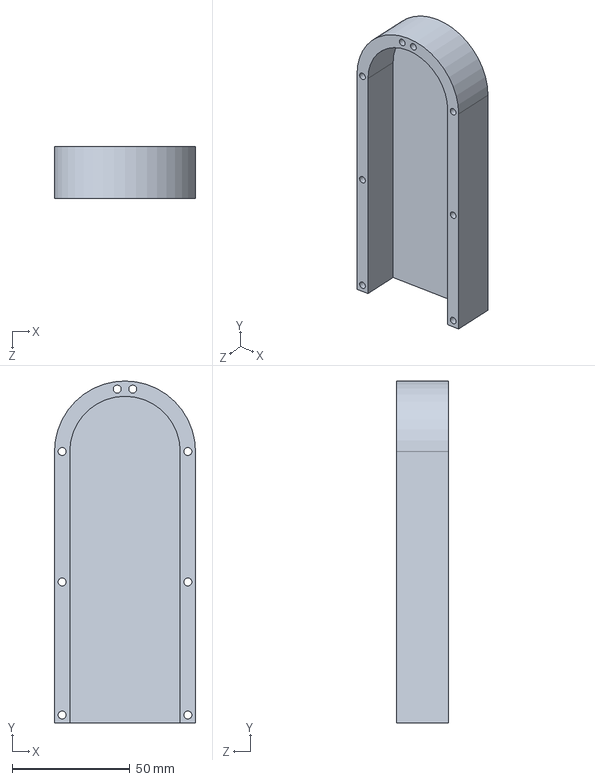
[picture p104: CAD file, 2021-06-09]
AR2 print files/Covers & Spacers - optimized for printing/J2 side cover half .SLDPRT
60.0 x 145.5 x 22.2 mm
