Wang-Ruohan/RV3-2/AR2 print files/Main Components - Resized for shrink/J1 base plate part 1.STL

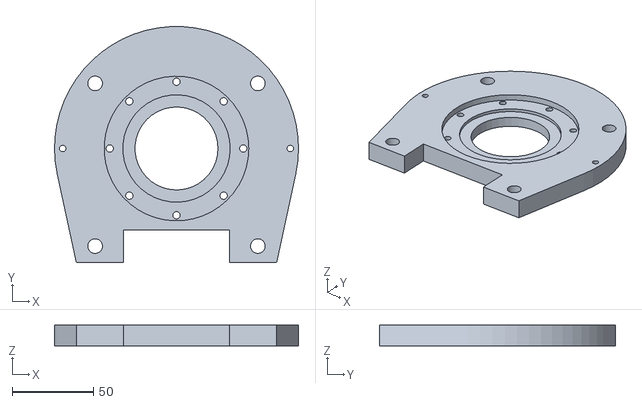
[picture p105: CAD file, 2021-06-09]
AR2 print files/Main Components - Resized for shrink/J1 base plate part 1.STL
150.0 x 144.9 x 12.7
