Wang-Ruohan/RV3-2/AR2 print files/Travel Track/platform.SLDPRT

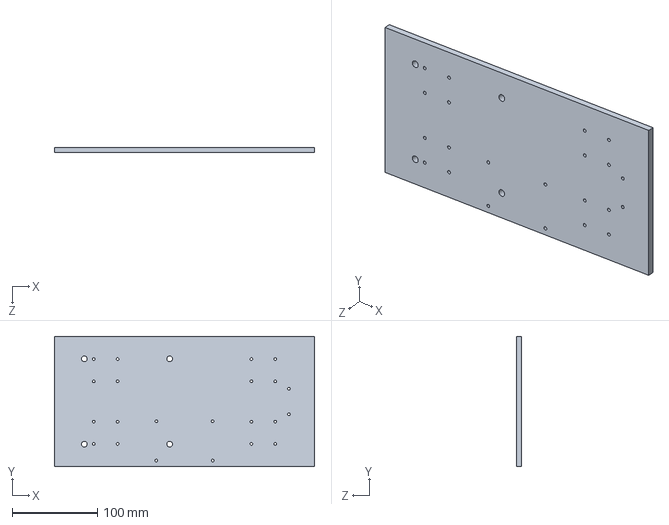
[picture p106: CAD file, 2021-06-09]
AR2 print files/Travel Track/platform.SLDPRT
304.8 x 152.4 x 6.35 mm
