Wang-Ruohan/RV3-2/AR3 print files/3D print files/Covers and Spacers/J2 Side Cover Upper .STL

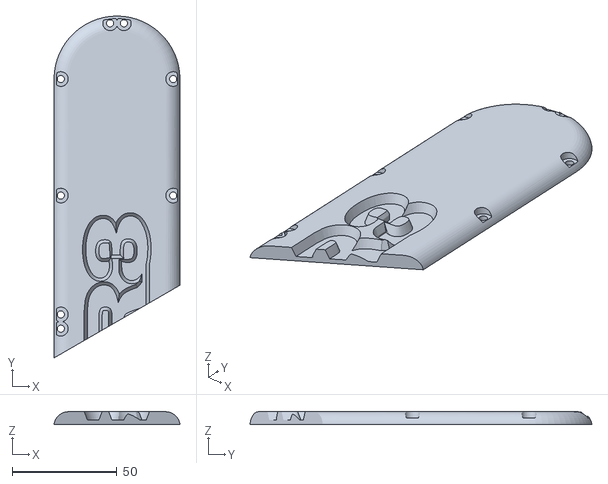
[picture p107: CAD file, 2021-06-09]
AR3 print files/3D print files/Covers and Spacers/J2 Side Cover Upper .STL
60.0 x 162.8 x 6.00
