Wang-Ruohan/RV3-2/AR3 print files/3D print files/Structural Components - Resized for shrink/J3 bearing cup.STL

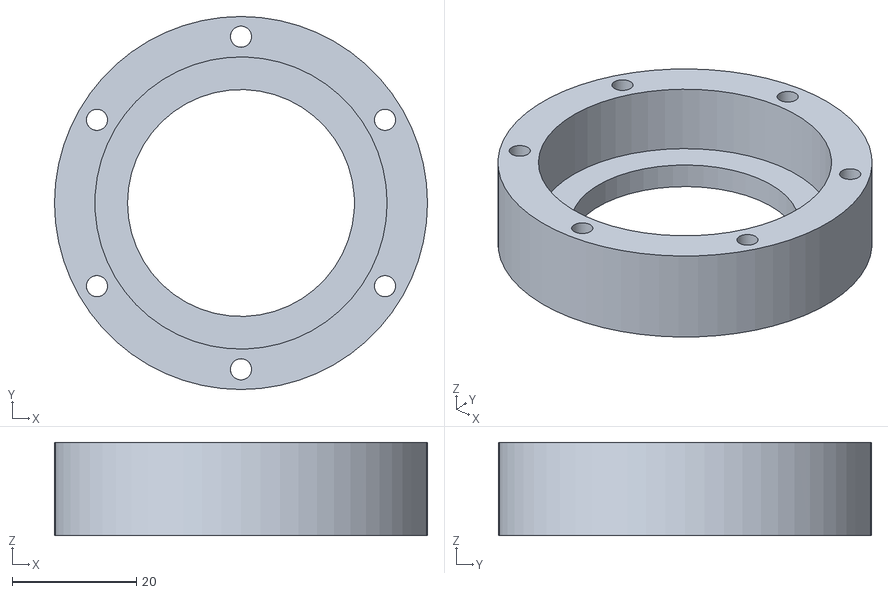
[picture p108: CAD file, 2021-06-09]
AR3 print files/3D print files/Structural Components - Resized for shrink/J3 bearing cup.STL
60.0 x 60.0 x 15.0
