Wang-Ruohan/RV3-2/AR2 assembly/1件-整合/J3 Spindle.STEP

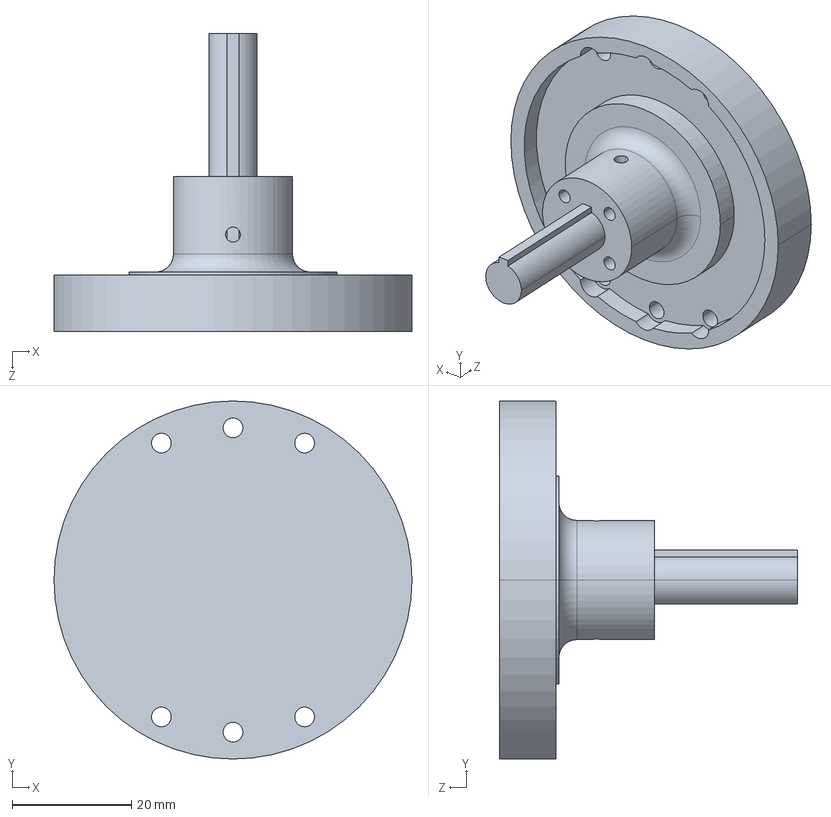
[picture p109: CAD file, 2021-06-09]
AR2 assembly/1件-整合/J3 Spindle.STEP
60.0 x 60.0 x 50.0 mm
