Wang-Ruohan/RV3-2/AR2 assembly/AR2 assembly & step files/AR2 Robot - J2 Motor Support-1.STL

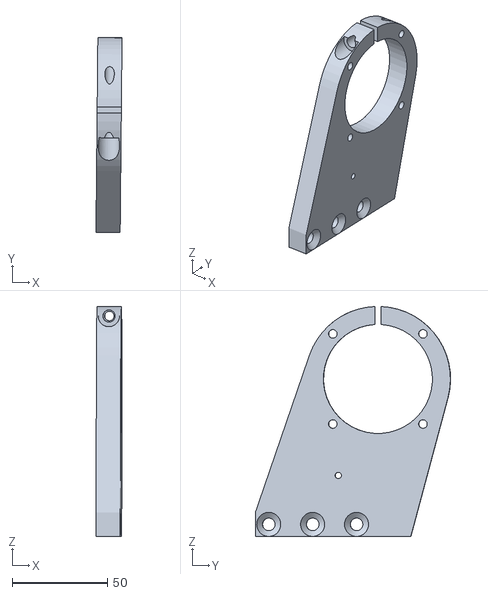
[picture p110: CAD file, 2021-06-09]
AR2 assembly/AR2 assembly & step files/AR2 Robot - J2 Motor Support-1.STL
13.7 x 102.3 x 120.5
