Wang-Ruohan/RV3-2/AR2 assembly/AR2 assembly & step files/Misc Parts/17HS15-1684S-HG50.SLDPRT

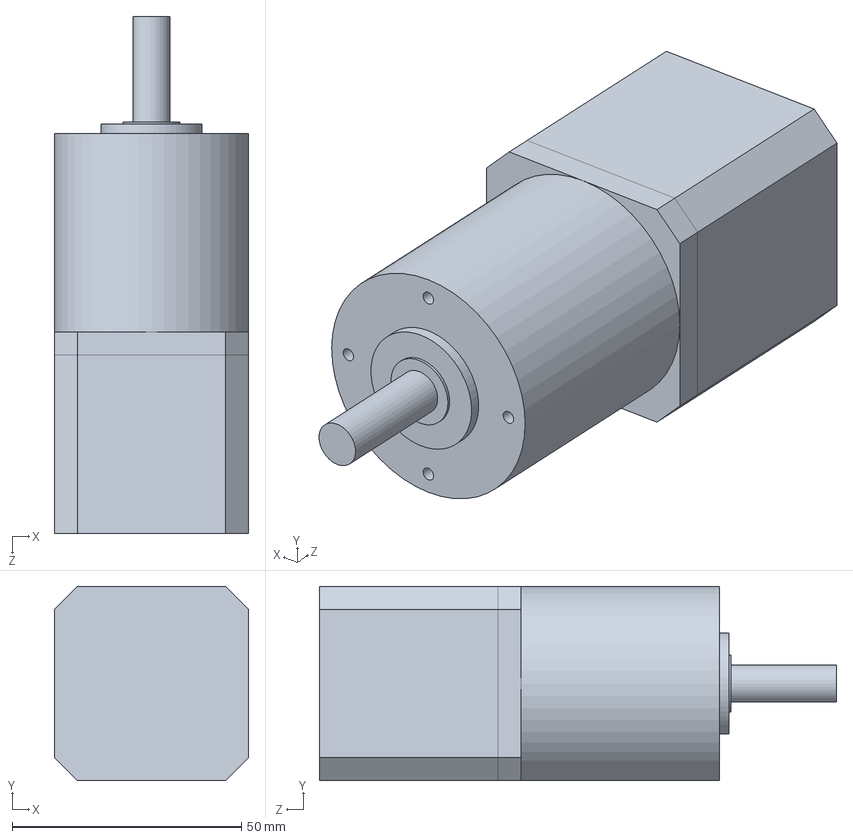
[picture p111: CAD file, 2021-06-09]
AR2 assembly/AR2 assembly & step files/Misc Parts/17HS15-1684S-HG50.SLDPRT
42.3 x 42.3 x 112.8 mm
