Wang-Ruohan/RV3-2/AR2 print files/Travel Track/block spacer.SLDPRT

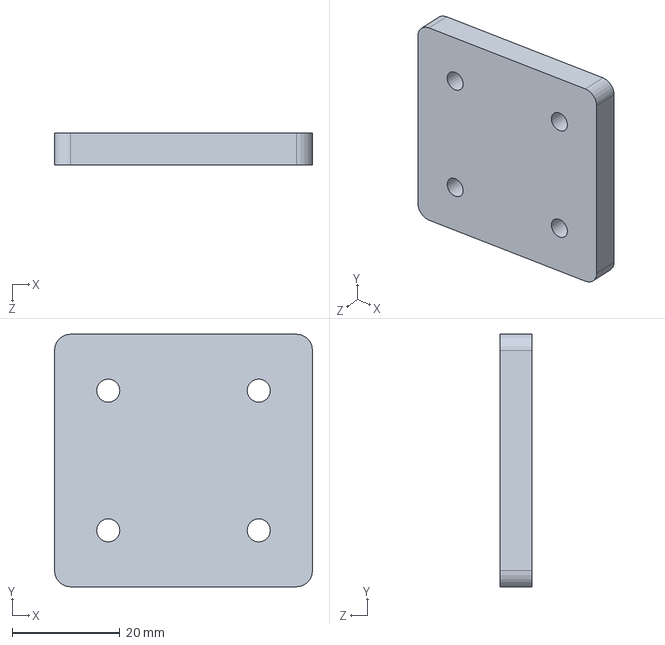
[picture p112: CAD file, 2021-06-09]
AR2 print files/Travel Track/block spacer.SLDPRT
48.0 x 47.0 x 6.00 mm
