Wang-Ruohan/RV3-2/(list of files, cad)

Other CAD files:
AR2 print files/Main Components - Nominal Size (identical aluminum parts)/J6 main bearing arm.STL
AR2 assembly/AR2 assembly/AR2 assembly & step files/Misc Parts/MHF2-8D1.SLDASM
AR3 assembly/J6 main bearing arm.STEP
AR3 print files/3D print files/Structural Components - Nominal Size (identical aluminum parts)/J6 main bearing arm.STL
AR2 assembly/mashimar 众诚 7月2号/J4 Main Shaft.STEP
AR2 assembly/CADfiles/J4 Main Shaft.DWG
AR2 assembly/1件-整合/J4 Main Shaft.STEP
AR2 assembly/AR2 assembly/AR2 assembly & step files/J4 Main Shaft.STEP
AR2 print files/Main Components - Resized for shrink/J6 main bearing arm.STL
AR3 print files/3D print files/Structural Components - Resized for shrink/J6 main bearing arm.STL
AR2 assembly/AR2 assembly & step files/Misc Parts/MHF2-8D1.SLDASM
AR3 assembly/J4 Main Shaft.STEP
AR2 assembly/AR2 assembly/AR2 assembly & step files/J6 main bearing arm.STEP
AR2 assembly/AR2 assembly & step files/J4 Main Shaft.STEP
AR2 assembly/CADfiles/J3 Spindle.DWG
CUI电容式编码器/3D模型/CUI_AMT103-2048-N8000-S-SOLIDWORKS/CUI_amt-103-top-cover-rev-h.sldprt
AR2 assembly/AR2 assembly & step files/Misc Parts/11HS20-0674S-PG5.SLDPRT
AR2 assembly/CADfiles/J3 Bearing Cup.DWG
AR2 assembly/mashimaro051726众诚 7月21号 共13张/1件-a(4)/J1 Spindle.STEP
AR3 print files/3D print files/Epoxy on Supports/auxilliary base support.STL
AR3 print files/3D print files/Jaws/AR3 jaw_right.STL
CUI电容式编码器/3D模型/CUI_AMT103-2048-N8000-S-SOLIDWORKS/CUI_receiver-board.sldprt
AR2 assembly/CADfiles/J4 timing hub.DWG
AR2 assembly/mashimar 众诚 7月2号/J3 spindle retainer.STEP
AR2 print files/Covers & Spacers - original/J5 side.SLDPRT
AR2 print files/Main Components - Nominal Size (identical aluminum parts)/J4 Turret Housing.STL
AR3 print files/3D print files/Covers and Spacers/J5 side.STL
CUI电容式编码器/3D模型/CUI_AMT103-2048-N8000-S-SOLIDWORKS/CUI_amt-hub-bottom-rev-b.sldprt
AR2 assembly/CADfiles/J3 spindle retainer.DWG
AR2 print files/Covers & Spacers - optimized for printing/J5 side.SLDPRT
AR3 print files/3D print files/Structural Components - Nominal Size (identical aluminum parts)/J4 Turret Housing.STL
CUI电容式编码器/3D模型/CUI_AMT103-2048-N8000-S-SOLIDWORKS/CUI_amt-sleeve-rev-d(8 mm).sldprt
AR2 assembly/1件-整合/J5 Housing.STEP
AR2 assembly/AR2 assembly/AR2 assembly & step files/J4 Turret Housing.STEP
AR2 assembly/CADfiles/aJ4 timing hub.DWG
AR2 print files/Covers & Spacers - original/J5 side cover cap.SLDPRT
AR2 print files/Main Components - Nominal Size (identical aluminum parts)/J5 Housing.STL
AR3 assembly/J1 Base Plate.STEP
AR3 print files/3D print files/Structural Components - Nominal Size (identical aluminum parts)/J4 motor mount - limit arm.STL
CUI电容式编码器/3D模型/CUI_AMT103-2048-N8000-S-SOLIDWORKS/CUI_amt-103-base-rev-k(default).sldprt
AR2 assembly/CADfiles/J1 Base Plate.DWG
AR2 assembly/mashimaro051726众诚 7月21号 共13张/1件-a(4)/J1 Turret Housing.STEP
AR2 print files/Covers & Spacers - original/J5 side cover spacer.SLDPRT
AR2 print files/Main Components - Nominal Size (identical aluminum parts)/J1 Turret Housing.STL
AR2 print files/Main Components - Resized for shrink/J5 motor mount.STL
AR2 assembly/1件-整合/J1 Spindle.STEP
AR2 assembly/1件-整合/J1 Turret Housing.STEP
AR2 assembly/1件-整合/J2 Arm.STEP
AR2 assembly/1件-整合/J2 Drive Spindle.STEP
AR2 assembly/1件-整合/J2 Turret Housing.STEP
AR2 assembly/1件-整合/J3 spindle retainer.STEP
AR2 assembly/1件-整合/J4 Turret Housing.STEP
AR2 assembly/AR2 assembly & step files/AR2 Robot - 11HS20-0674S-PG5-1.STL
AR2 assembly/AR2 assembly & step files/AR2 Robot - 14HS13-0804S-PG19-1.STL
AR2 assembly/AR2 assembly & step files/AR2 Robot - 17HS15-1684S-HG50-1.STL
AR2 assembly/AR2 assembly & step files/AR2 Robot - 17HS15-1684S-HG50-2.STL
AR2 assembly/AR2 assembly & step files/AR2 Robot - 23HS22-2804S-HG50-1.STL
AR2 assembly/AR2 assembly & step files/AR2 Robot - 30204 bearing-1.STL
AR2 assembly/AR2 assembly & step files/AR2 Robot - 30206-1.STL
AR2 assembly/AR2 assembly & step files/AR2 Robot - 30206-2.STL
AR2 assembly/AR2 assembly & step files/AR2 Robot - 3mm rod-1.STL
AR2 assembly/AR2 assembly & step files/AR2 Robot - 3mm rod-2.STL
AR2 assembly/AR2 assembly & step files/AR2 Robot - 5905K137_STL NEEDLE-ROLLER BRNG-1.STL
AR2 assembly/AR2 assembly & step files/AR2 Robot - 5905K137_STL NEEDLE-ROLLER BRNG-2.STL
AR2 assembly/AR2 assembly & step files/AR2 Robot - 5905K760_STL NEEDLE-ROLLER BRNG-1.STL
AR2 assembly/AR2 assembly & step files/AR2 Robot - 5909K180_THRUST NEEDLE-ROLLER BRNG-1.STL
AR2 assembly/AR2 assembly & step files/AR2 Robot - 5909K360_THRUST NEEDLE-ROLLER BRNG-1.STL
AR2 assembly/AR2 assembly & step files/AR2 Robot - 5909K360_THRUST NEEDLE-ROLLER BRNG-2.STL
AR2 assembly/AR2 assembly & step files/AR2 Robot - 5909K360_THRUST NEEDLE-ROLLER BRNG-3.STL
AR2 assembly/AR2 assembly & step files/AR2 Robot - 5909K490_THRUST NEEDLE-ROLLER BRNG-1.STL
AR2 assembly/AR2 assembly & step files/AR2 Robot - 5909K490_THRUST NEEDLE-ROLLER BRNG-3.STL
AR2 assembly/AR2 assembly & step files/AR2 Robot - 5909K490_THRUST NEEDLE-ROLLER BRNG-4.STL
AR2 assembly/AR2 assembly & step files/AR2 Robot - 5909K630_THRUST NEEDLE-ROLLER BRNG-1.STL
AR2 assembly/AR2 assembly & step files/AR2 Robot - 5909K630_THRUST NEEDLE-ROLLER BRNG-2.STL
AR2 assembly/AR2 assembly & step files/AR2 Robot - 5909K780_THRUST NEEDLE-ROLLER BRNG-1.STL
AR2 assembly/AR2 assembly & step files/AR2 Robot - 5909K780_THRUST NEEDLE-ROLLER BRNG-2.STL
AR2 assembly/AR2 assembly & step files/AR2 Robot - 6677K520_STL TAPERED-ROLLER BRNG-1.STL
AR2 assembly/AR2 assembly & step files/AR2 Robot - 92635A314_SQUARE HEAD EXTENDED POINT SET SCREW-1.STL
AR2 assembly/AR2 assembly & step files/AR2 Robot - J1 & J3 Motor Mount-1.STL
AR2 assembly/AR2 assembly & step files/AR2 Robot - J1 & J3 Motor Mount-2.STL
AR2 assembly/AR2 assembly & step files/AR2 Robot - J1 Base Plate-1.STL
AR2 assembly/AR2 assembly & step files/AR2 Robot - J1 Spindle-1.STL
AR2 assembly/AR2 assembly & step files/AR2 Robot - J1 Turret Housing-1.STL
AR2 assembly/AR2 assembly & step files/AR2 Robot - J1 Turret Platform-1.STL
AR2 assembly/AR2 assembly & step files/AR2 Robot - J1 base support spacer part 1-1.STL
AR2 assembly/AR2 assembly & step files/AR2 Robot - J1 base support spacer part 2-1.STL
AR2 assembly/AR2 assembly & step files/AR2 Robot - J1 bearing inner-1.STL
AR2 assembly/AR2 assembly & step files/AR2 Robot - J1 bearing inner-2.STL
AR2 assembly/AR2 assembly & step files/AR2 Robot - J1 bearing outer-1.STL
AR2 assembly/AR2 assembly & step files/AR2 Robot - J1 timing drive pulley-1.STL
AR2 assembly/AR2 assembly & step files/AR2 Robot - J1 timing drive pulley-2.STL
AR2 assembly/AR2 assembly & step files/AR2 Robot - J1 timing pulley-1.STL
AR2 assembly/AR2 assembly & step files/AR2 Robot - J2 Arm-1.STL
AR2 assembly/AR2 assembly & step files/AR2 Robot - J2 Drive Spindle-1.STL
AR2 assembly/AR2 assembly & step files/AR2 Robot - J2 Tension Ring-1.STL
AR2 assembly/AR2 assembly & step files/AR2 Robot - J2 Turret Housing-1.STL
AR2 assembly/AR2 assembly & step files/AR2 Robot - J2 arm cover spacer-1.STL
AR2 assembly/AR2 assembly & step files/AR2 Robot - J2 arm cover spacer-2.STL
AR2 assembly/AR2 assembly & step files/AR2 Robot - J3 Spindle-1.STL
AR2 assembly/AR2 assembly & step files/AR2 Robot - J3 spindle retainer-1.STL
AR2 assembly/AR2 assembly & step files/AR2 Robot - J4 Turret Housing-1.STL
AR2 assembly/AR2 assembly & step files/AR2 Robot - J4 motor mount - limit arm-1.STL
AR2 assembly/AR2 assembly & step files/AR2 Robot - J4 timing drive pulley-1.STL
AR2 assembly/AR2 assembly & step files/AR2 Robot - J4 timing hub-2.STL
AR2 assembly/AR2 assembly & step files/AR2 Robot - J5 Bearing Post-1.STL
AR2 assembly/AR2 assembly & step files/AR2 Robot - J5 Belt Carrier Clamp-1.STL
AR2 assembly/AR2 assembly & step files/AR2 Robot - J5 Belt Carrier-1.STL
AR2 assembly/AR2 assembly & step files/AR2 Robot - J5 Housing-1.STL
AR2 assembly/AR2 assembly & step files/AR2 Robot - J5 Idler Tension Block-1.STL
AR2 assembly/AR2 assembly & step files/AR2 Robot - J5 motor mount-1.STL
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
