Wang-Ruohan/RV3-2/AR2 assembly/1件-整合/有更新的零件.docx

J2 motor support

J2 arm

J3 spindle

J3 spindle retainer 是有一个键槽的，上次没加工进去

J4 Turret housing

J6 gripper mount不用加工了
