Wang-Ruohan/RV3-2/AR2 assembly/mashimaro051726众诚  7月21号 共13张/1件-a(4)/1件-a.docx

J1 Base plate:

无螺纹孔，所有孔都是通孔

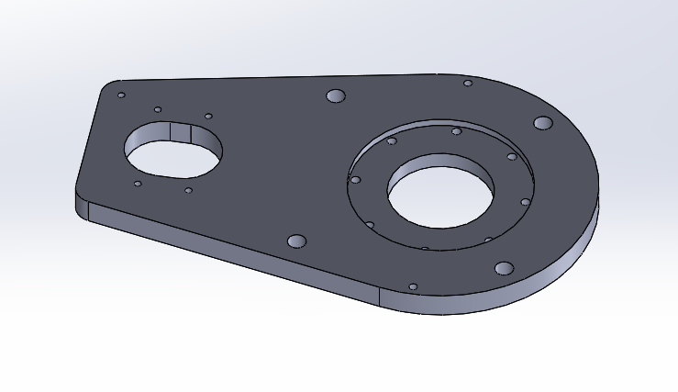
[picture p117: figure]

J1 spindle：

所有孔都是5mm螺纹孔

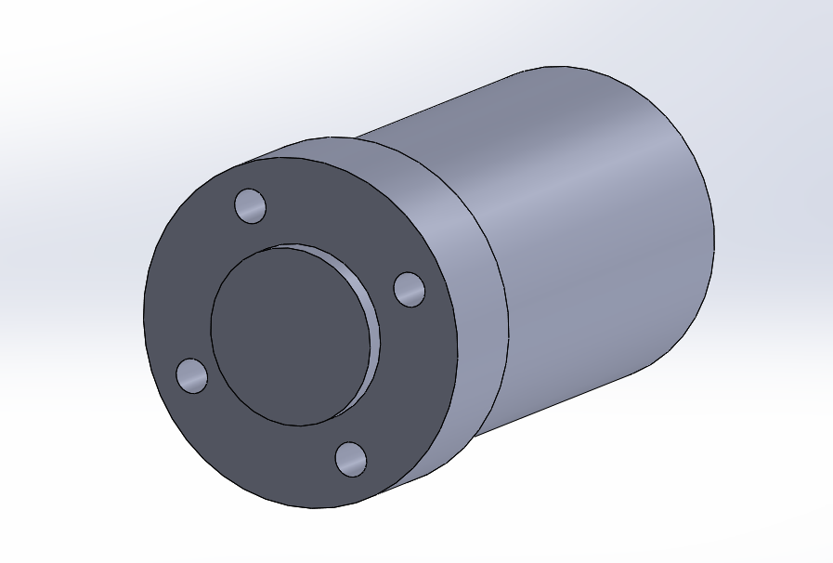
[picture p118: figure]
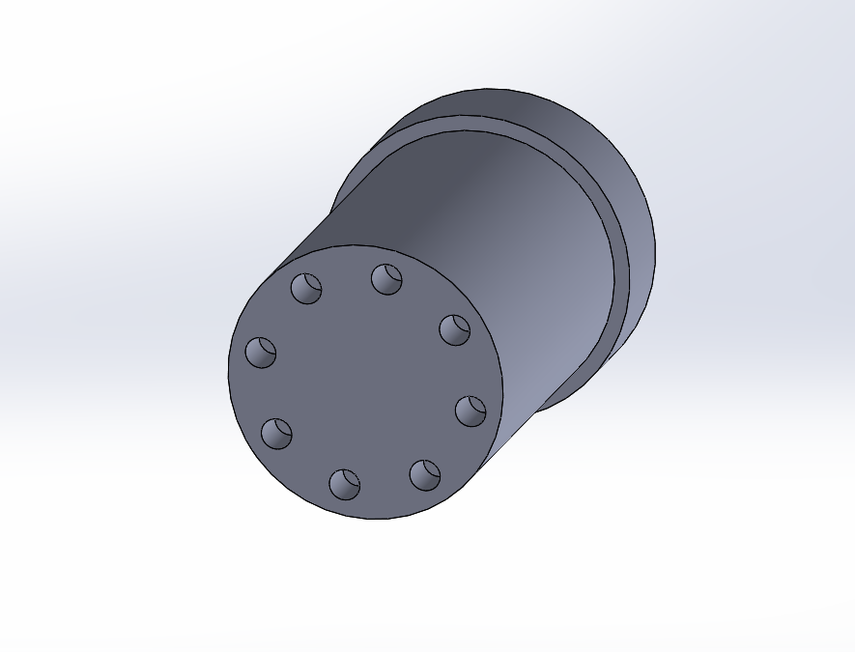
[picture p119: figure]

J1 Turret housing:

这两个孔是2.5mm螺纹孔

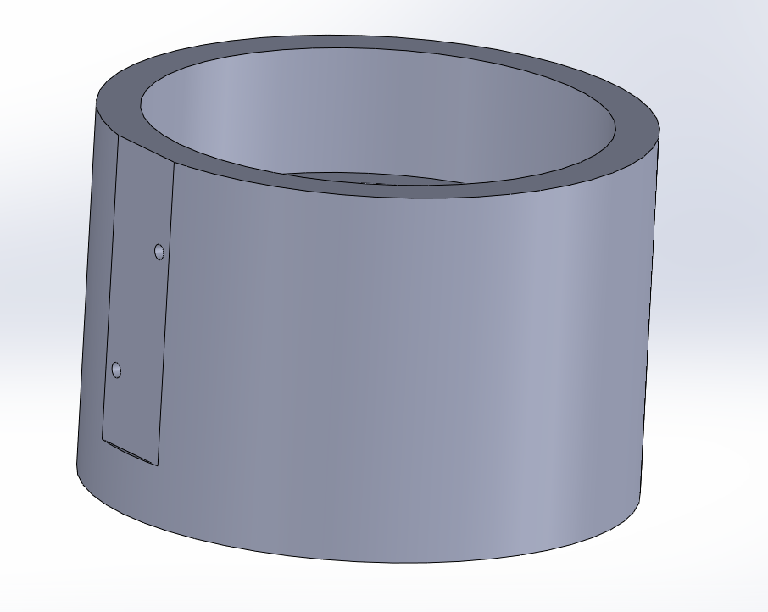
[picture p120: figure]

这边底面8个孔是3mm螺纹孔

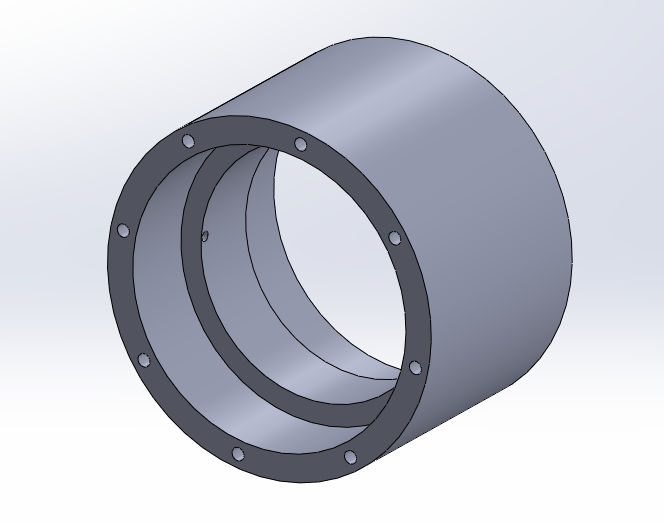
[picture p121: figure]

J1 Turret platform

下面打圈的孔是6mm螺纹孔

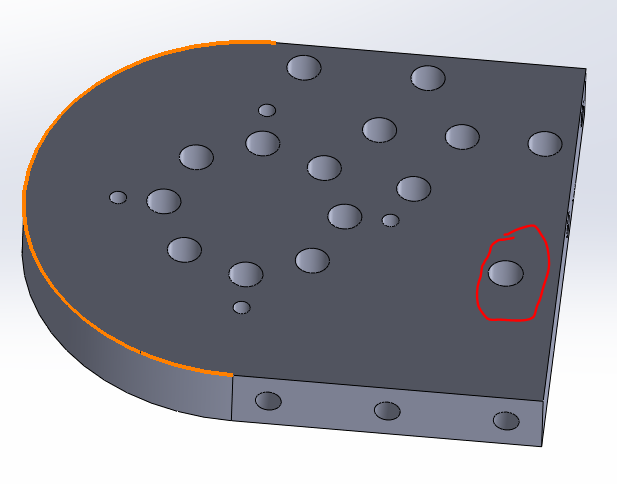
[picture p122: figure]

另外，其侧面5个孔都是5mm螺纹孔

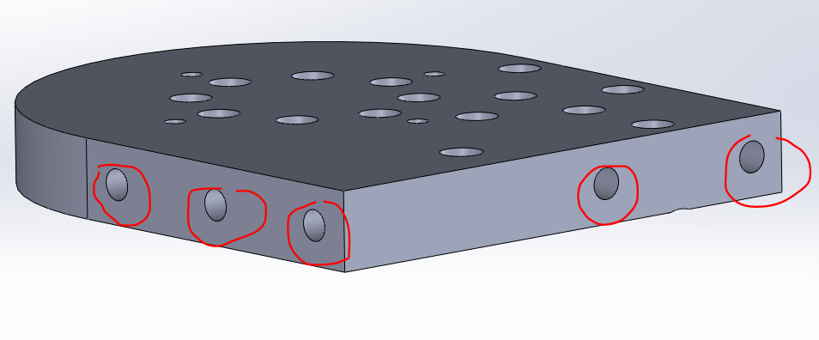
[picture p123: figure]

J2 arm

红色标记的12个孔为3mm螺纹孔

红色未标记的小孔都是2.5mm螺纹孔

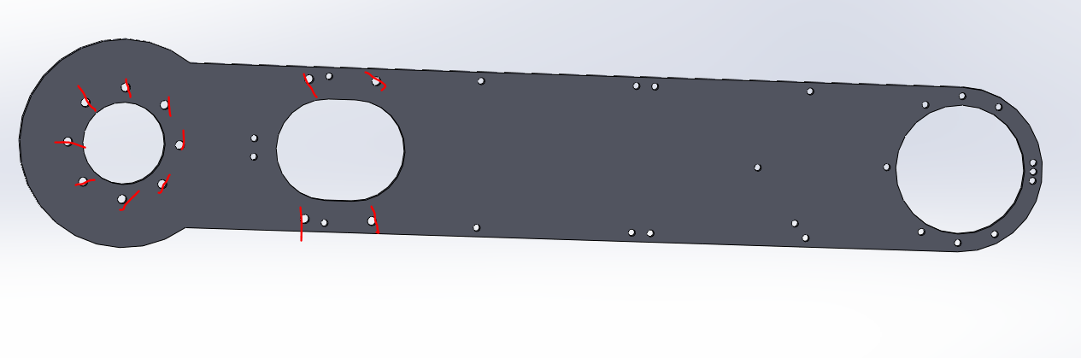
[picture p124: figure]

J2 drive spindle

下图标注的7个孔都是2.5mm螺纹孔，其他孔都是通孔

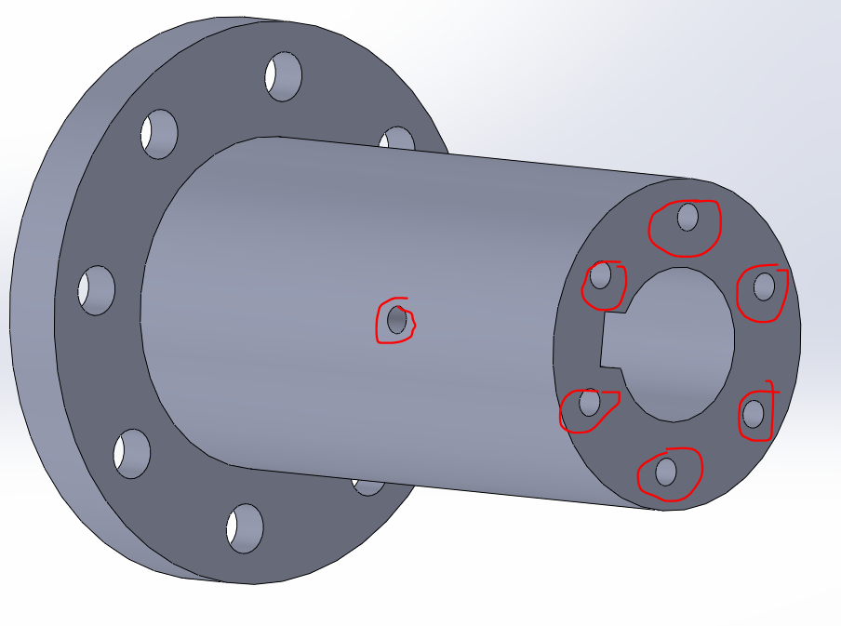
[picture p125: figure]

J2 motor support

所有孔都是通孔

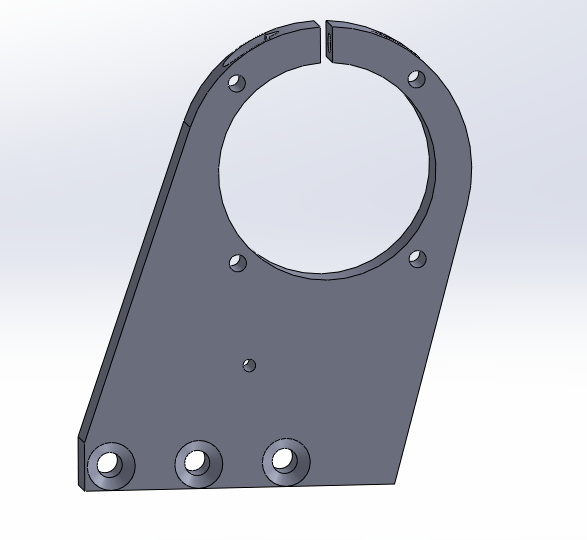
[picture p126: figure]

J2 Tension ring

所有孔都是通孔

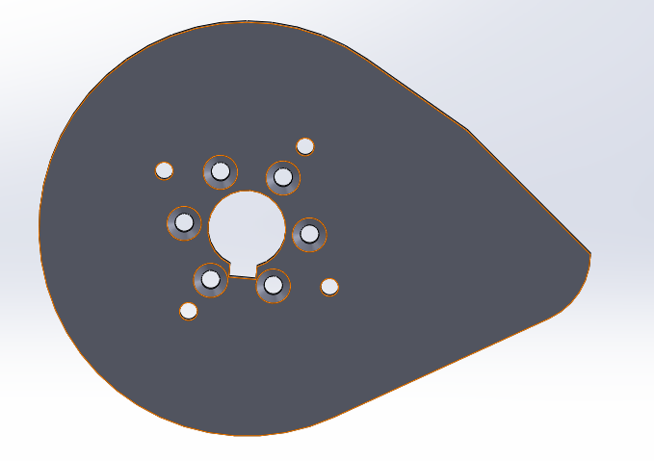
[picture p127: figure]

J2 turret housing

下面打红圈的是6mm螺纹孔

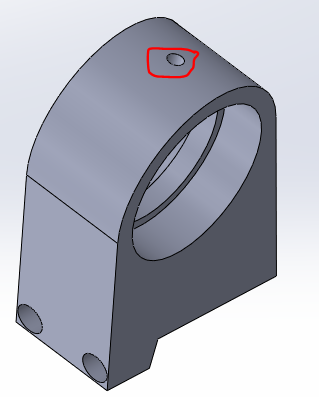
[picture p128: figure]

下面6个孔都是5mm螺纹孔

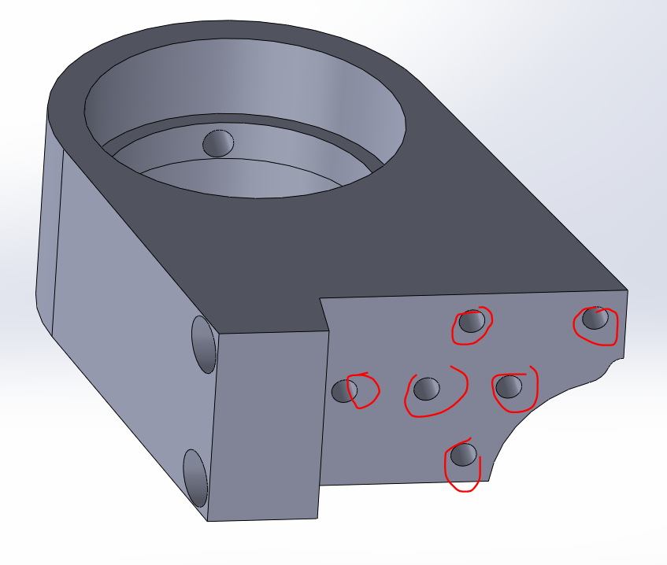
[picture p129: figure]
