Wang-Ruohan/RV3-2/AR2 assembly/1件-J5/J5 motor mount标红的也是螺纹孔.JPG

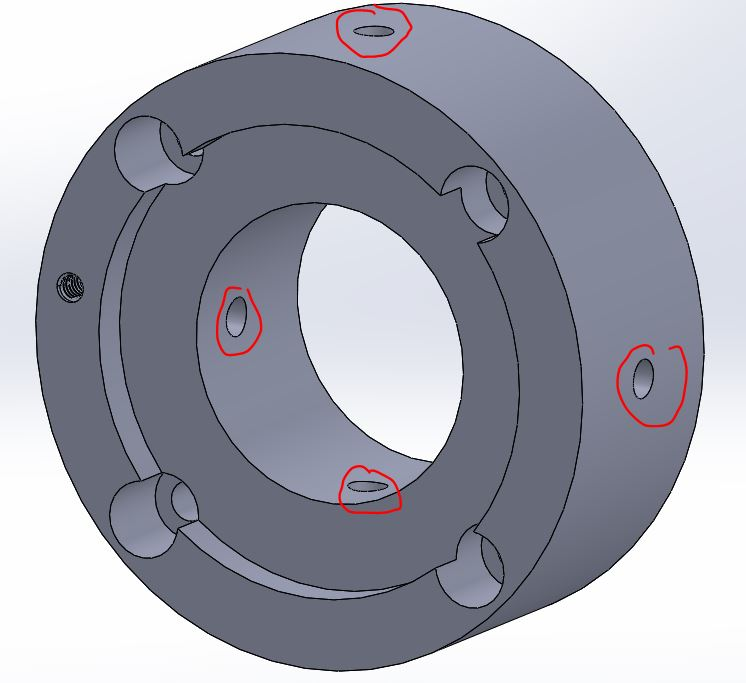
AR2 assembly/1件-J5/J5 motor mount标红的也是螺纹孔.JPG
