Wang-Ruohan/RV3-2/AR2 assembly/mashimar 众诚 7月2号/a727b86f0cabb4d0757d29596590c2b.png

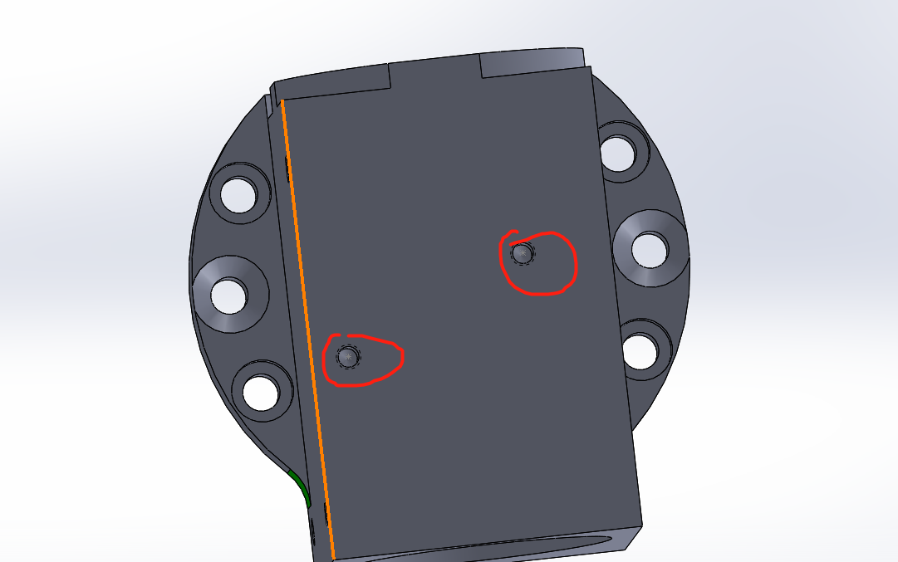
AR2 assembly/mashimar 众诚 7月2号/a727b86f0cabb4d0757d29596590c2b.png
