Wang-Ruohan/RV3-2/AR2 assembly/mashimar 众诚 7月2号/ec21a88c4ab1e1dfcb8ae0dec6bf967.png

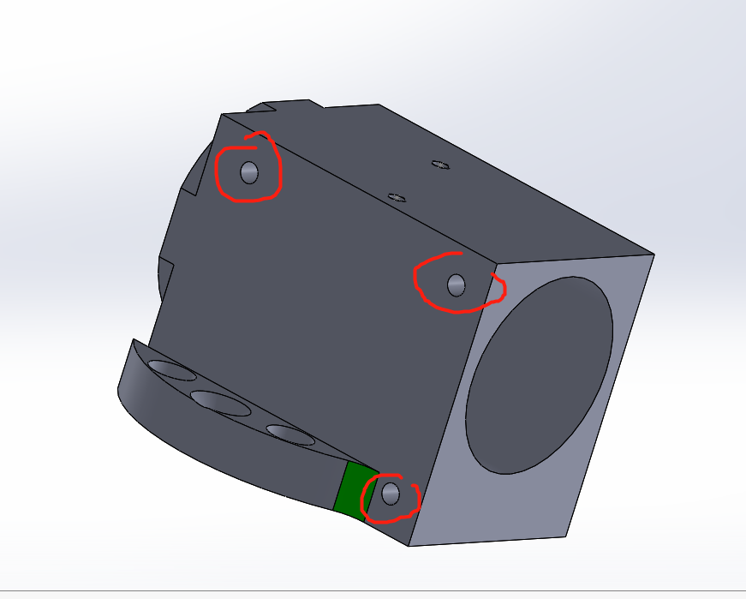
AR2 assembly/mashimar 众诚 7月2号/ec21a88c4ab1e1dfcb8ae0dec6bf967.png
