Wang-Ruohan/RV3-2/电机AR2/60SM-02030B(1).pdf

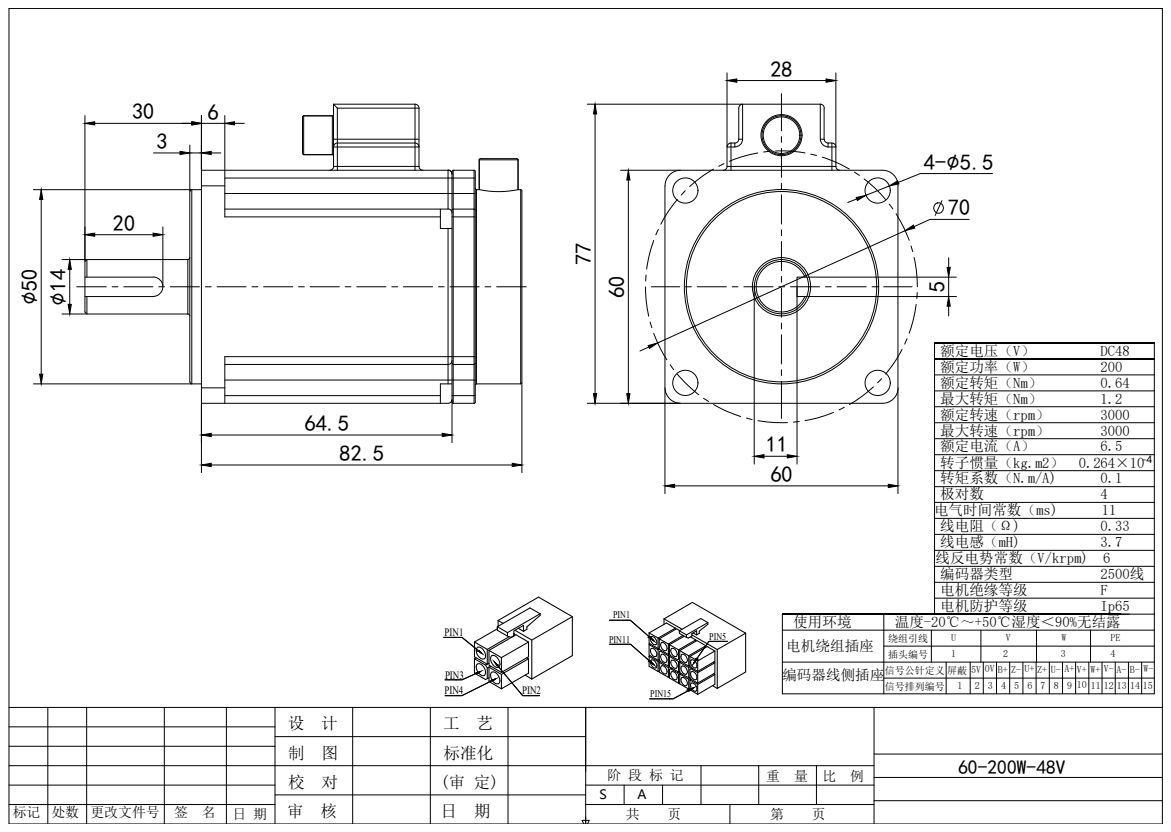
[picture p351: page 1]
转子惯量（kg.m2） 0.264×10; 线反电势常数（V/krpm) 6; 最大转速（rpm）

使用环境 | 温度-20℃～+50℃湿度＜90%无结露
电机绕组插座 | 绕组引线 | U | V | W | PE

插头编号 | 1 | 2 | 3 | 4

编码器线侧插座信号公针定义 | | 屏蔽 | 5V | 0V B+ | | Z- | U+ Z+ | | U- | A+ V+ | | W+ | V- A- | B- | W-

信号排列编号 | 1 | 2 | 3 | 4 | 5 | 6 | 7 | 8 | 9 | 10 | 11 | 12 13 | 14 15

设 计 | 工 艺
制 图 | 标准化
校 对 | (审 定) | 阶 段 标 记 | | 重 量 | 比 例

标记 | 处数 | 更改文件号 | 签 名 | 日 期 | | | 共 页 | 第 页
