Wang-Ruohan/RV3-2/AR2 assembly/1件-整合/J3 bearing cup.pdf

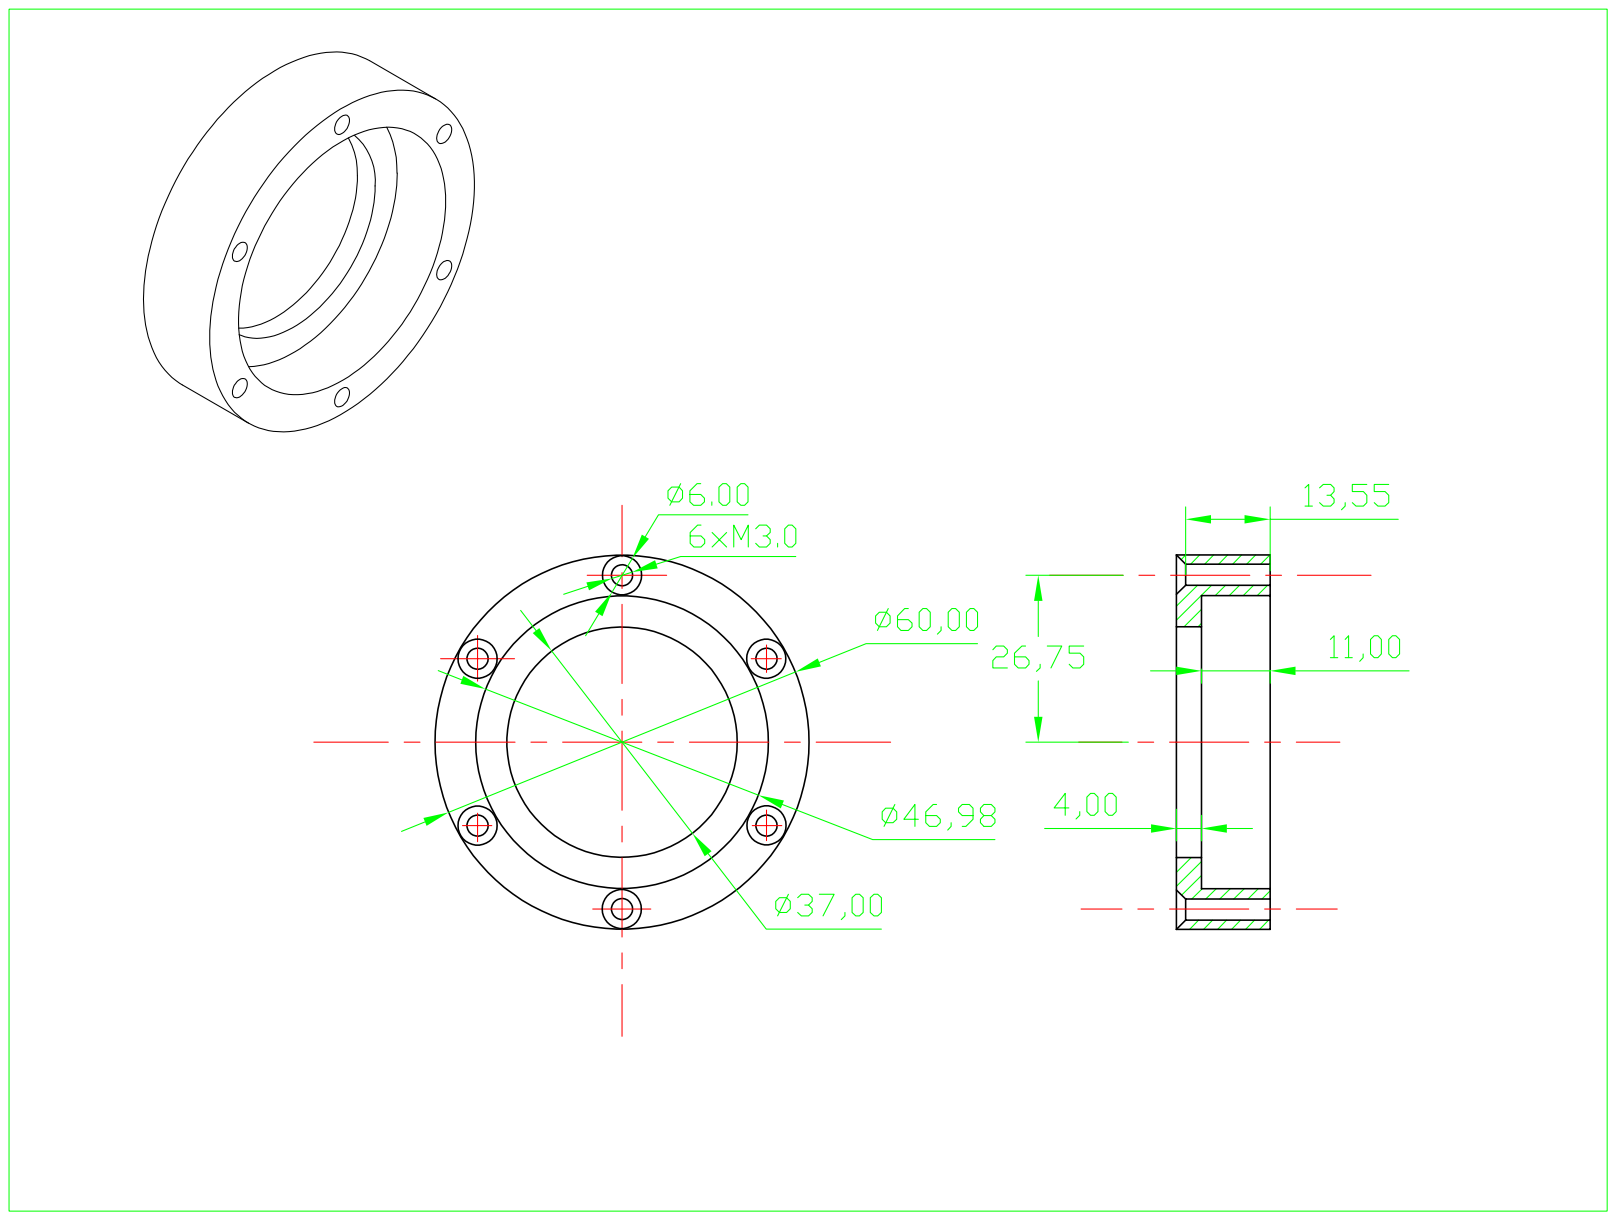
[picture p352: page 1]
