Wang-Ruohan/RV3-2/AR2 assembly/1件-整合/J3 spindle retainer.pdf

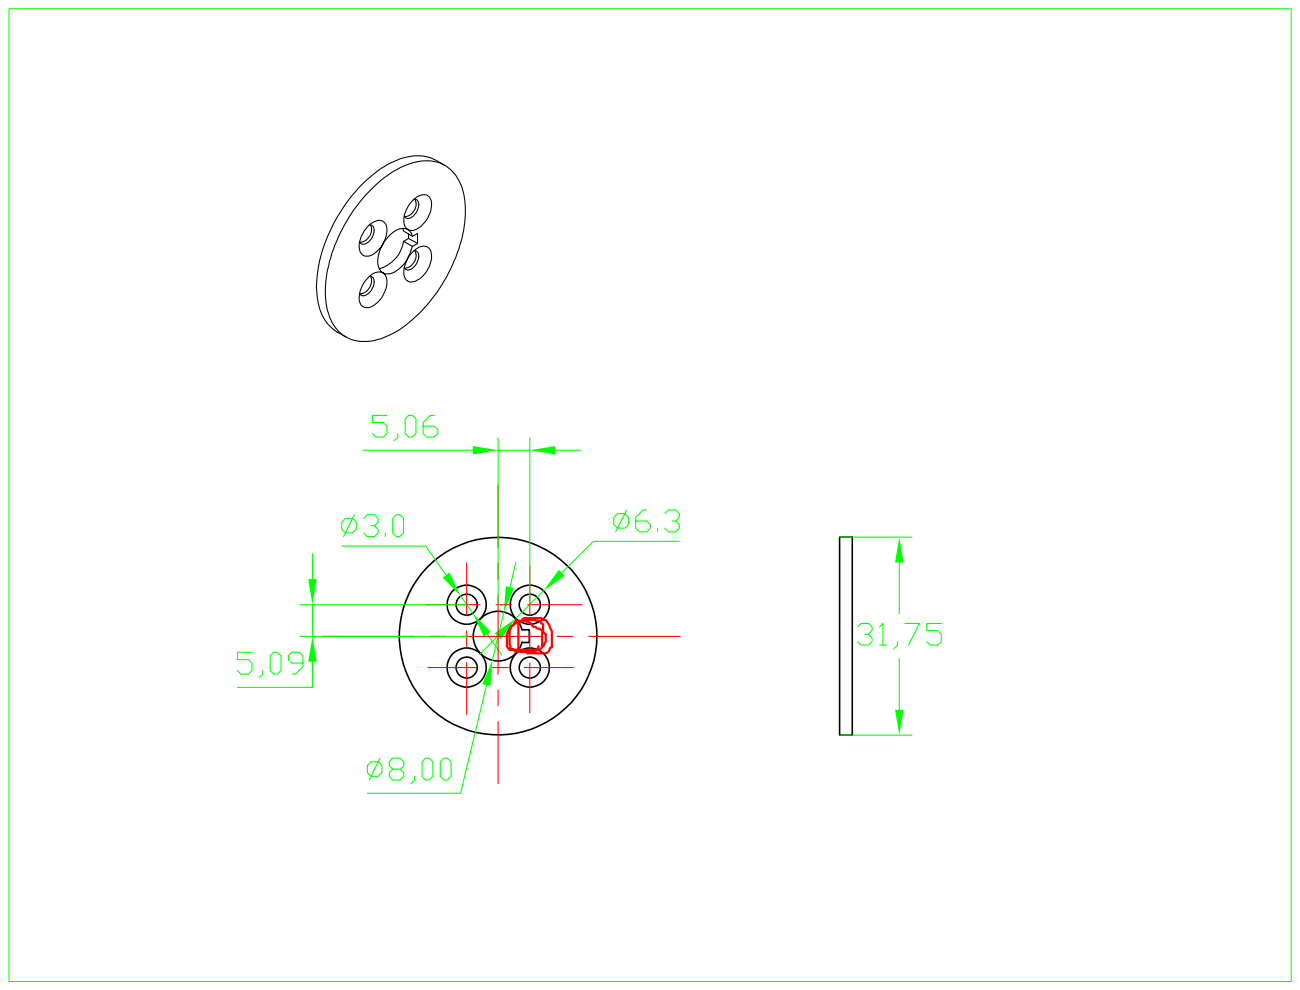
[picture p353: page 1]
