Wang-Ruohan/RV3-2/AR2 assembly/1件-整合/J4 main shaft.pdf

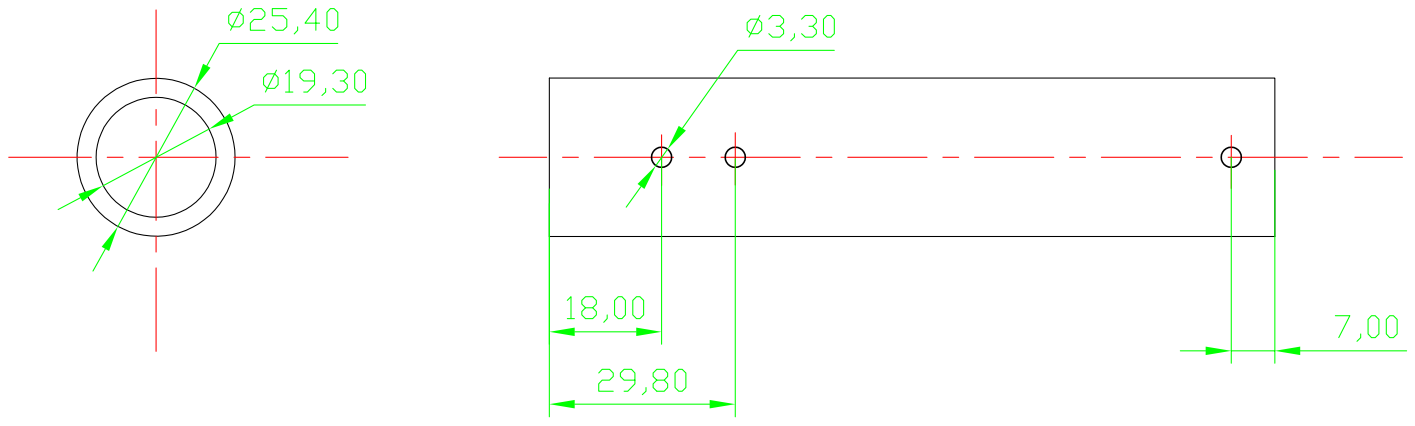
[picture p354: page 1]
