Wang-Ruohan/RV3-2/AR2 assembly/1件-整合/J4 motor mount.pdf

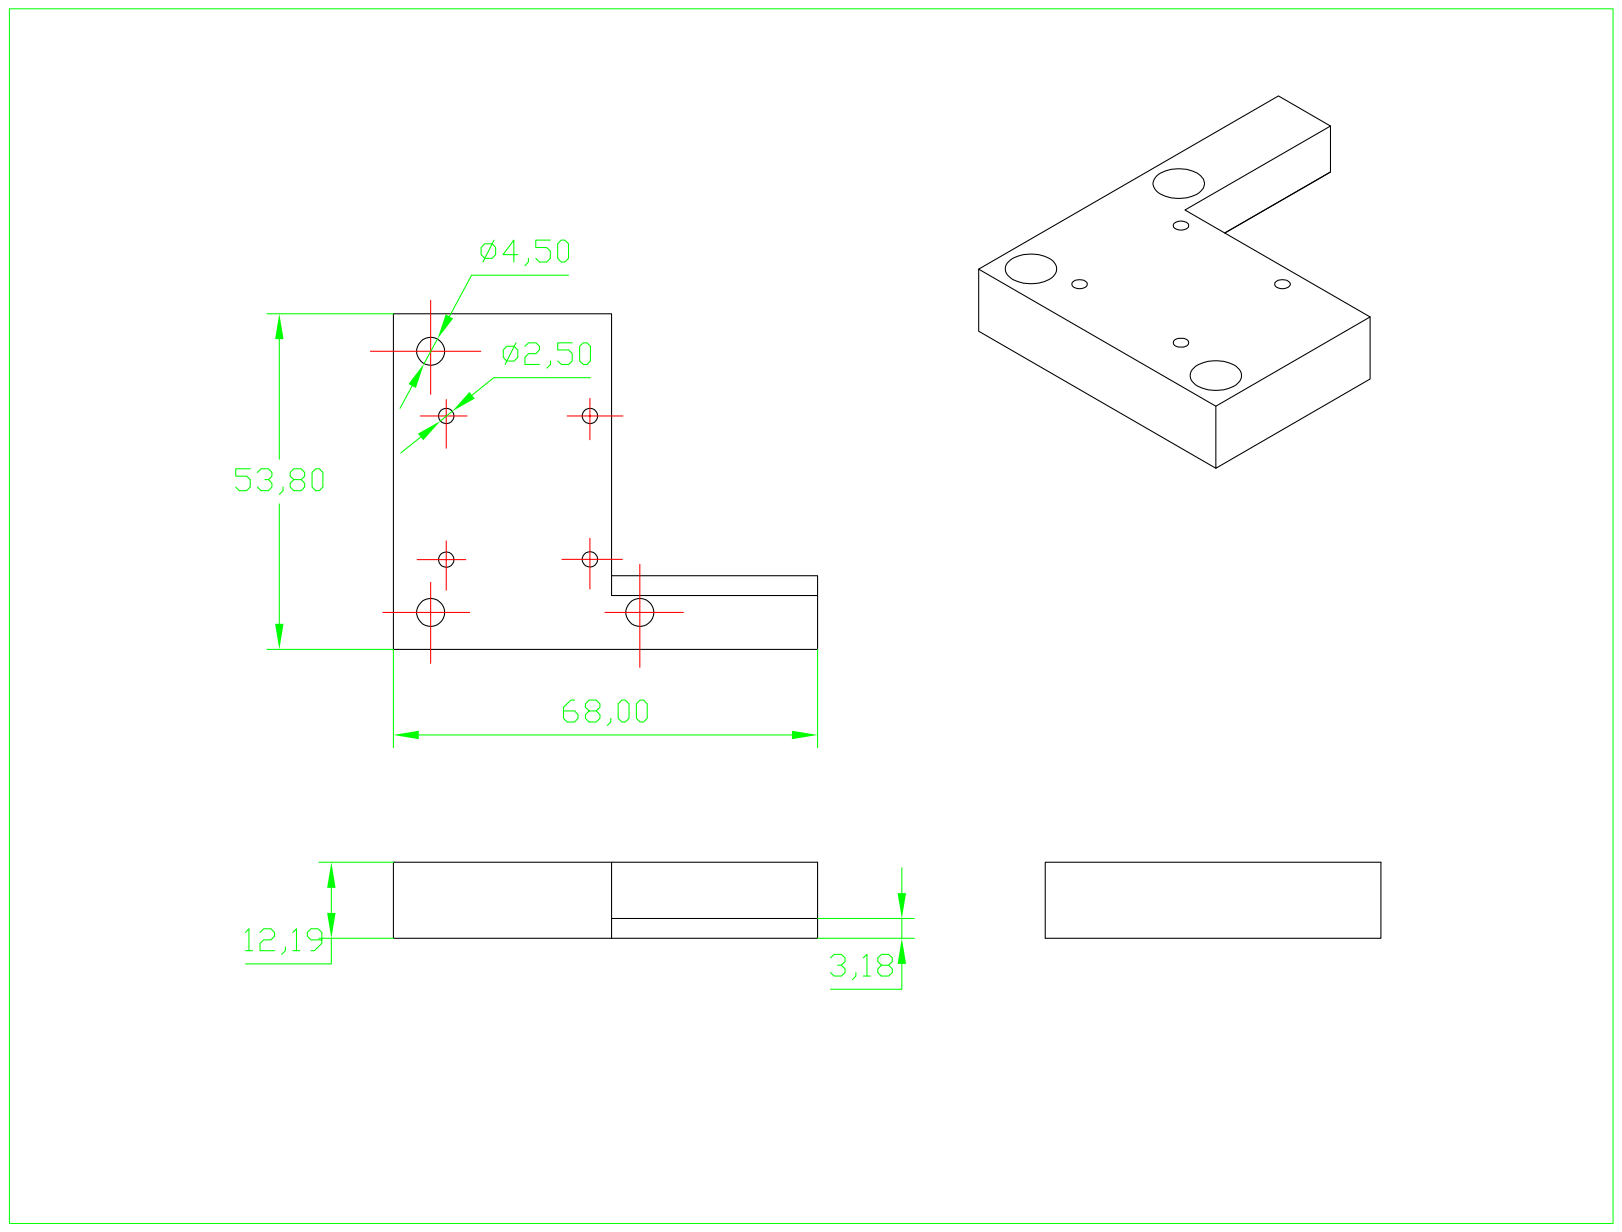
[picture p355: page 1]
