Wang-Ruohan/RV3-2/AR2 assembly/CADfiles/J1 timing pulley.pdf

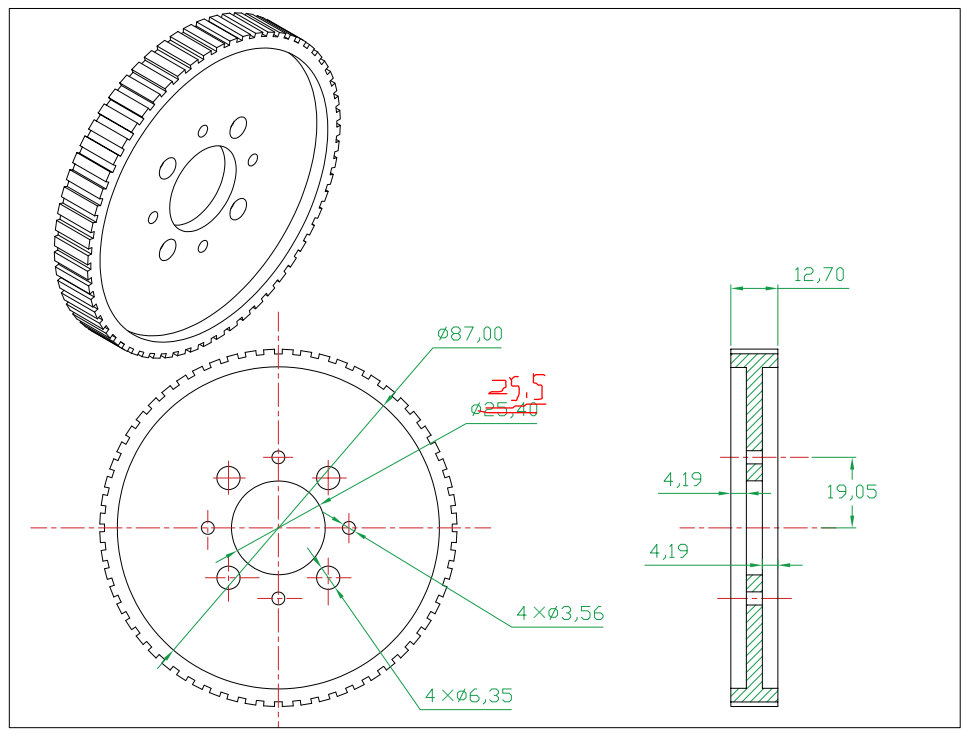
[picture p356: page 1]
