Wang-Ruohan/RV3-2/AR2 assembly/CADfiles/J3 spindle retainer.pdf

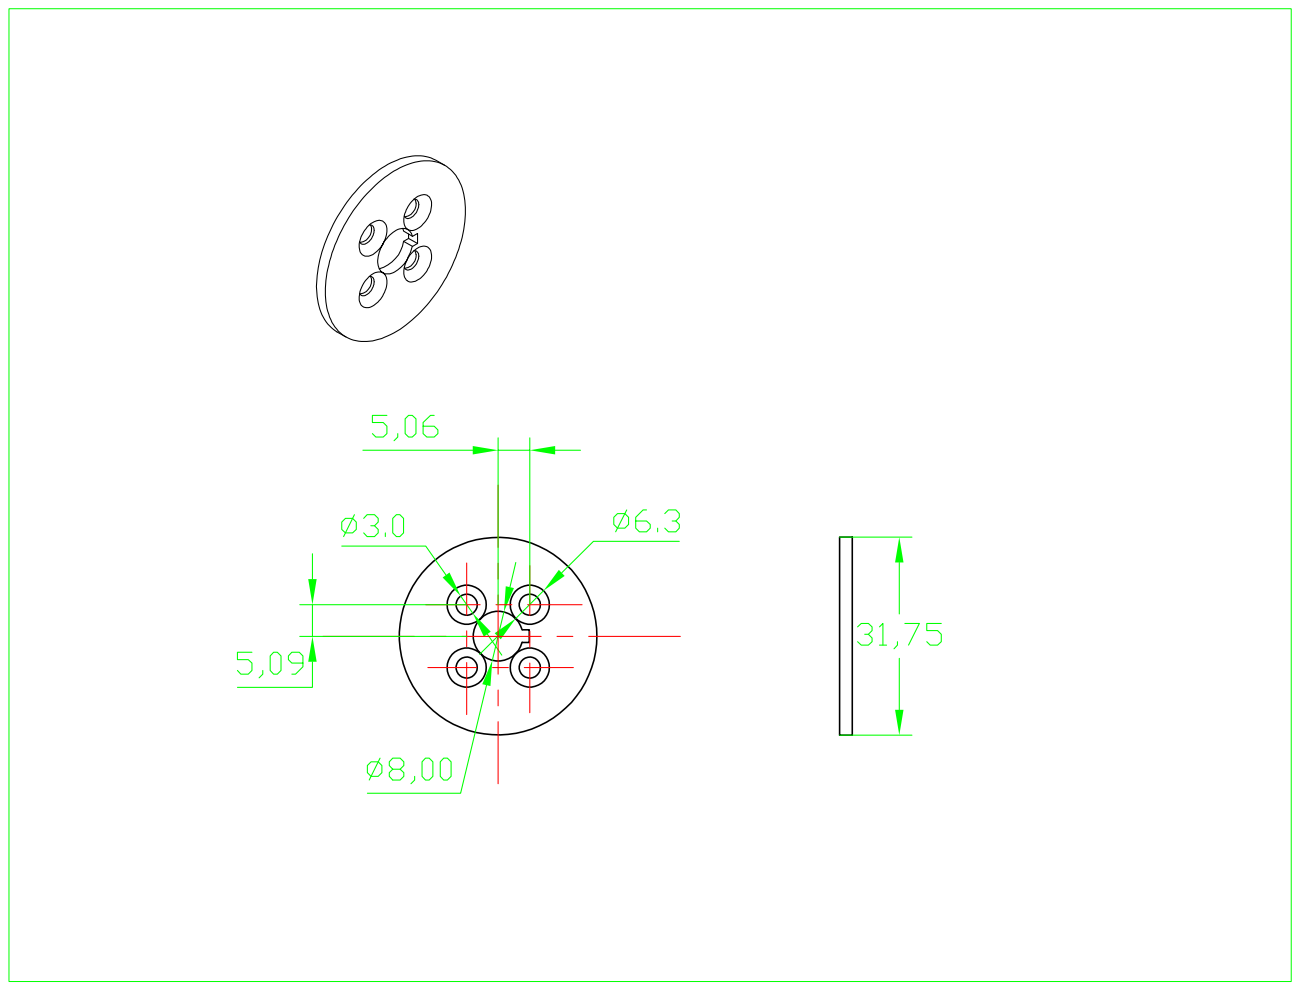
[picture p357: page 1]
