Wang-Ruohan/RV3-2/AR2 assembly/CADfiles/J3 spindle.pdf

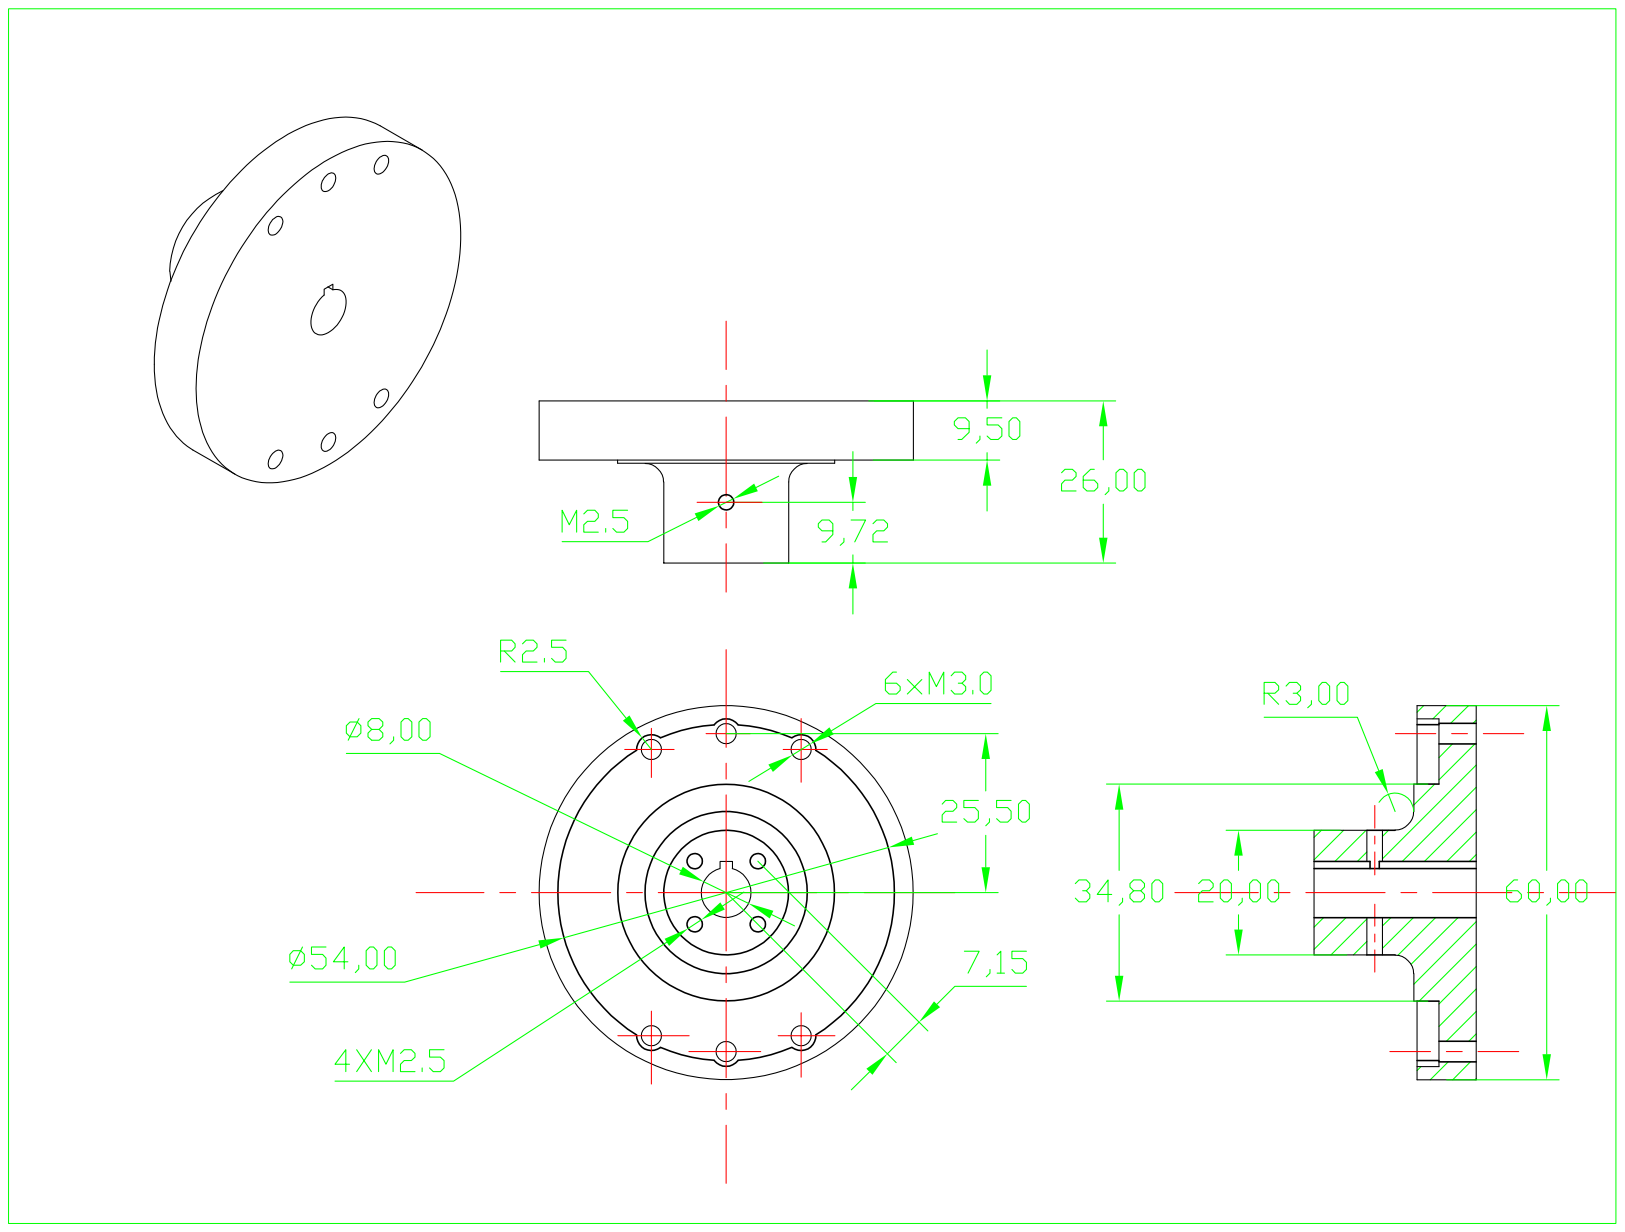
[picture p358: page 1]
