Wang-Ruohan/RV3-2/AR2 assembly/CADfiles/J4 timing hub.pdf

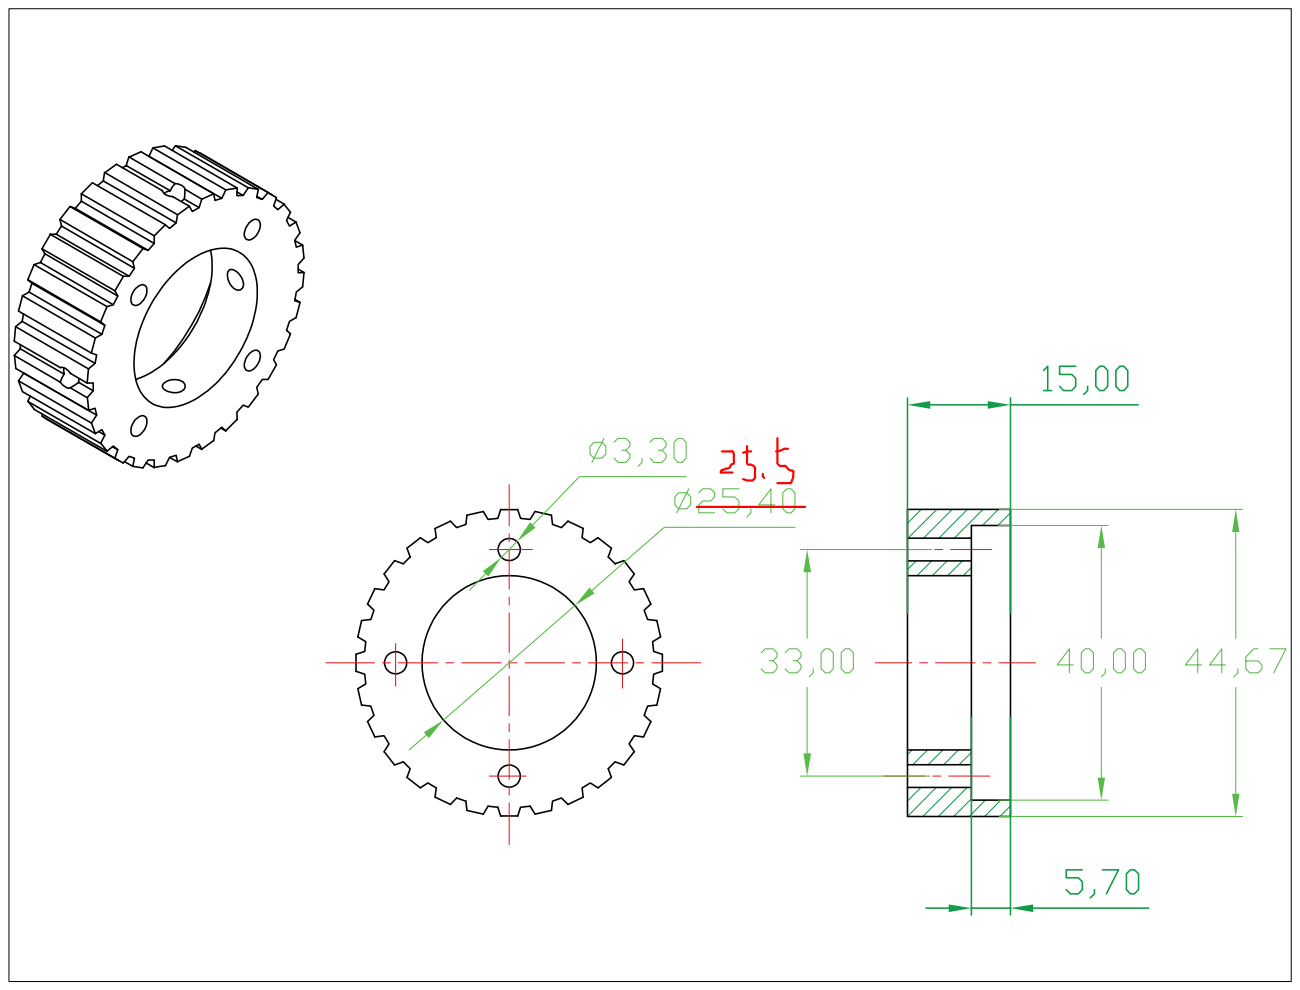
[picture p359: page 1]
