Wang-Ruohan/RV3-2/电机AR2/J1_17HS15-1684S-HG20.pdf

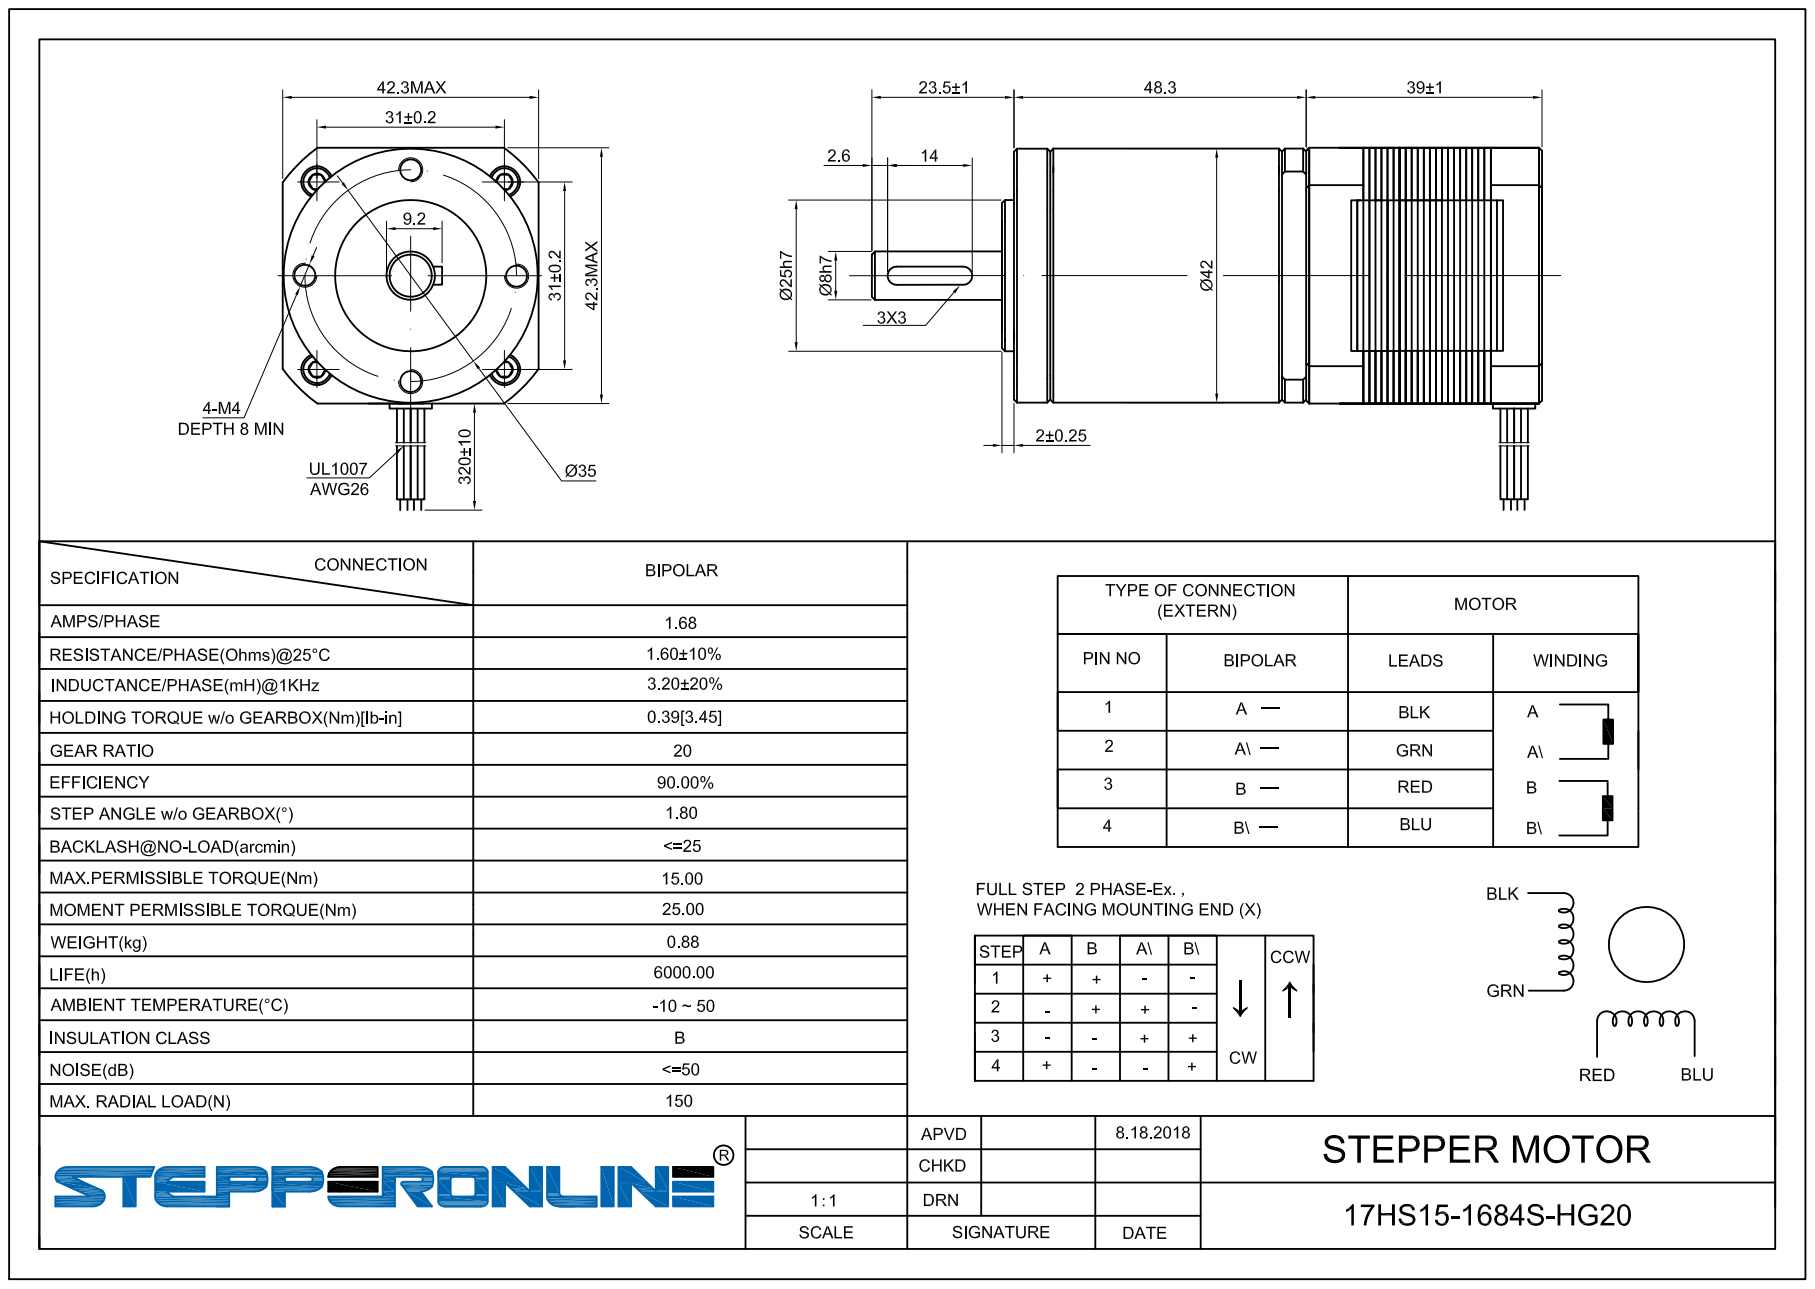
[picture p360: page 1]
