Wang-Ruohan/RV3-2/电机AR2/J2_23HS22-2804S-HG50.pdf

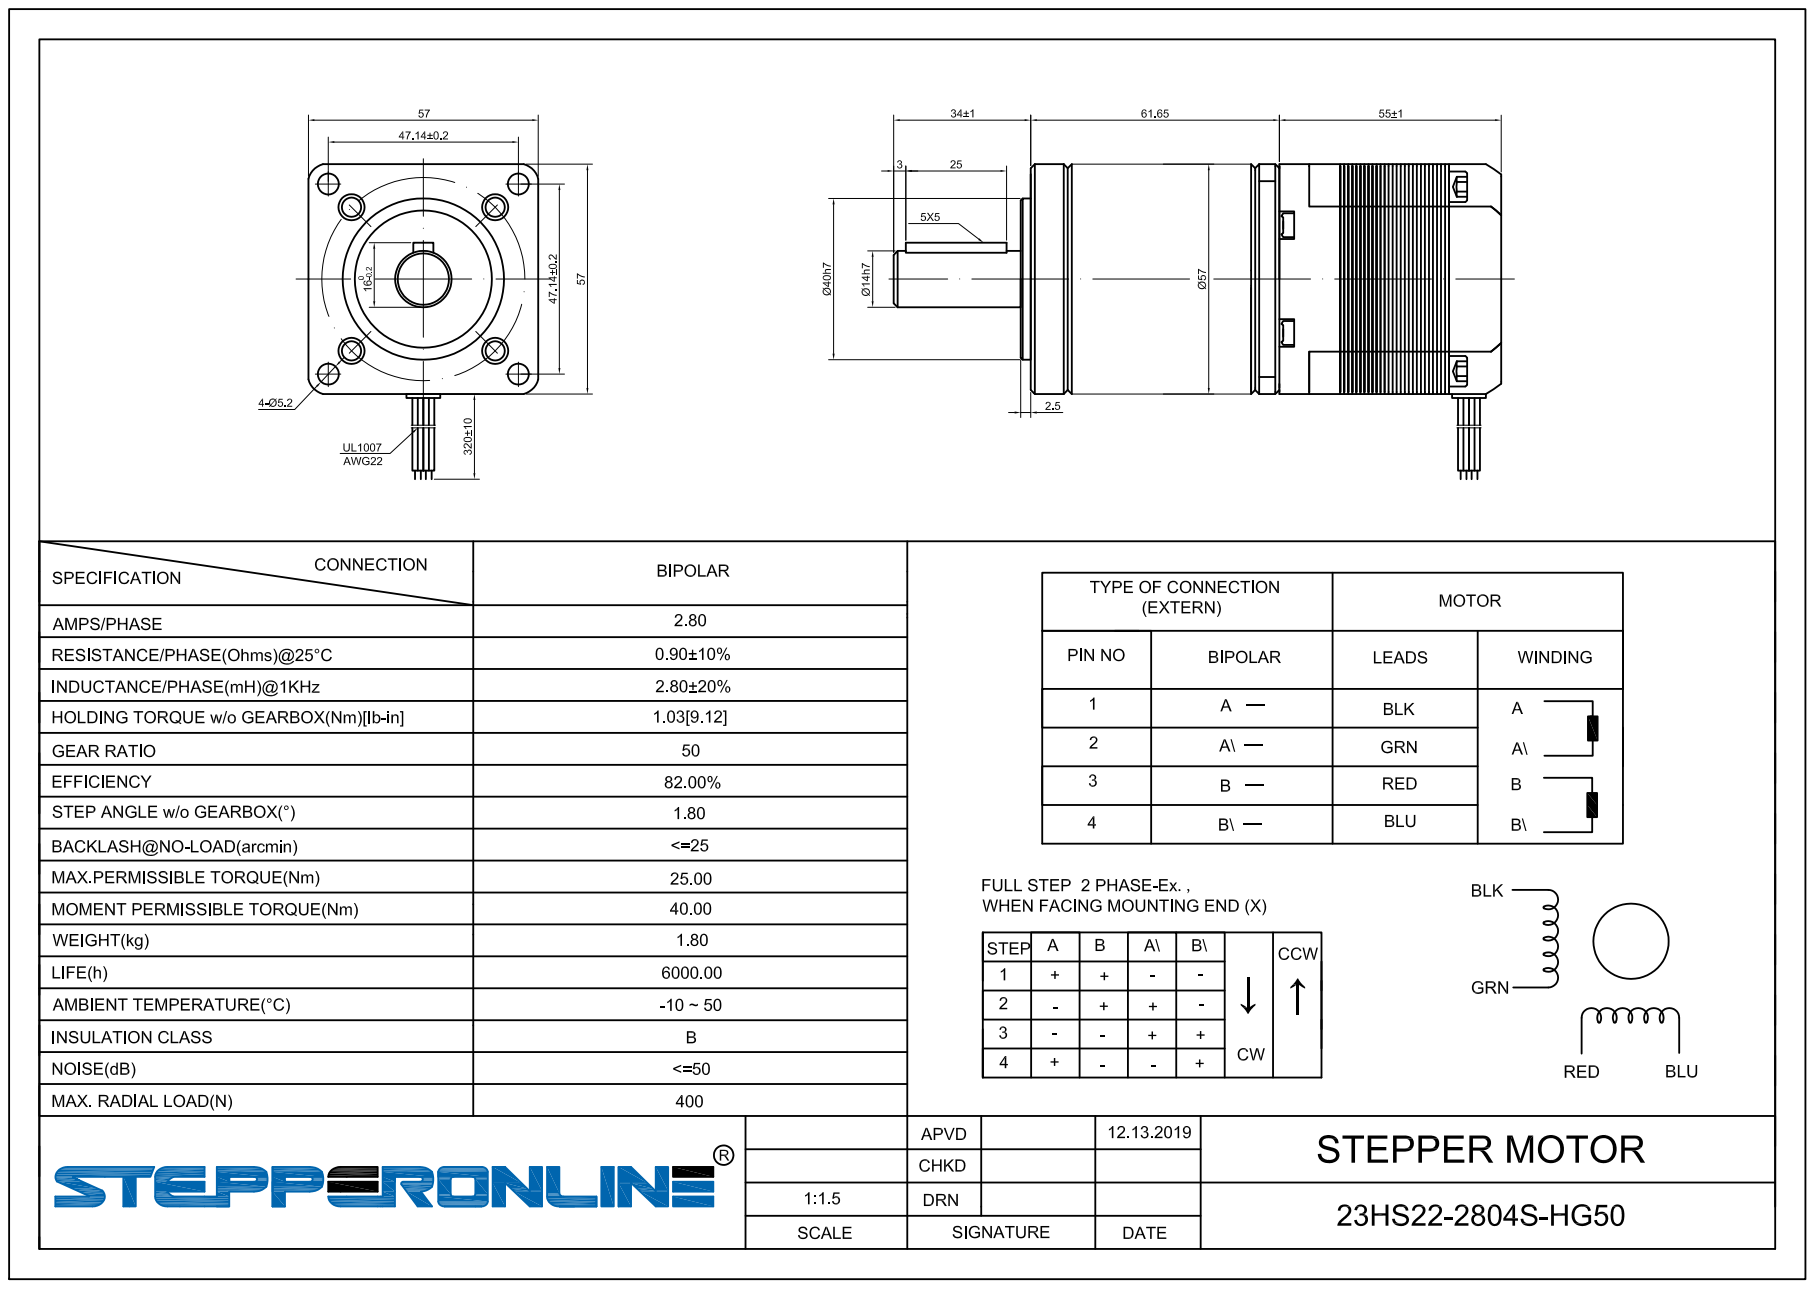
[picture p361: page 1]
