Wang-Ruohan/RV3-2/电机AR2/J3_17HS15-1684S-HG50.pdf

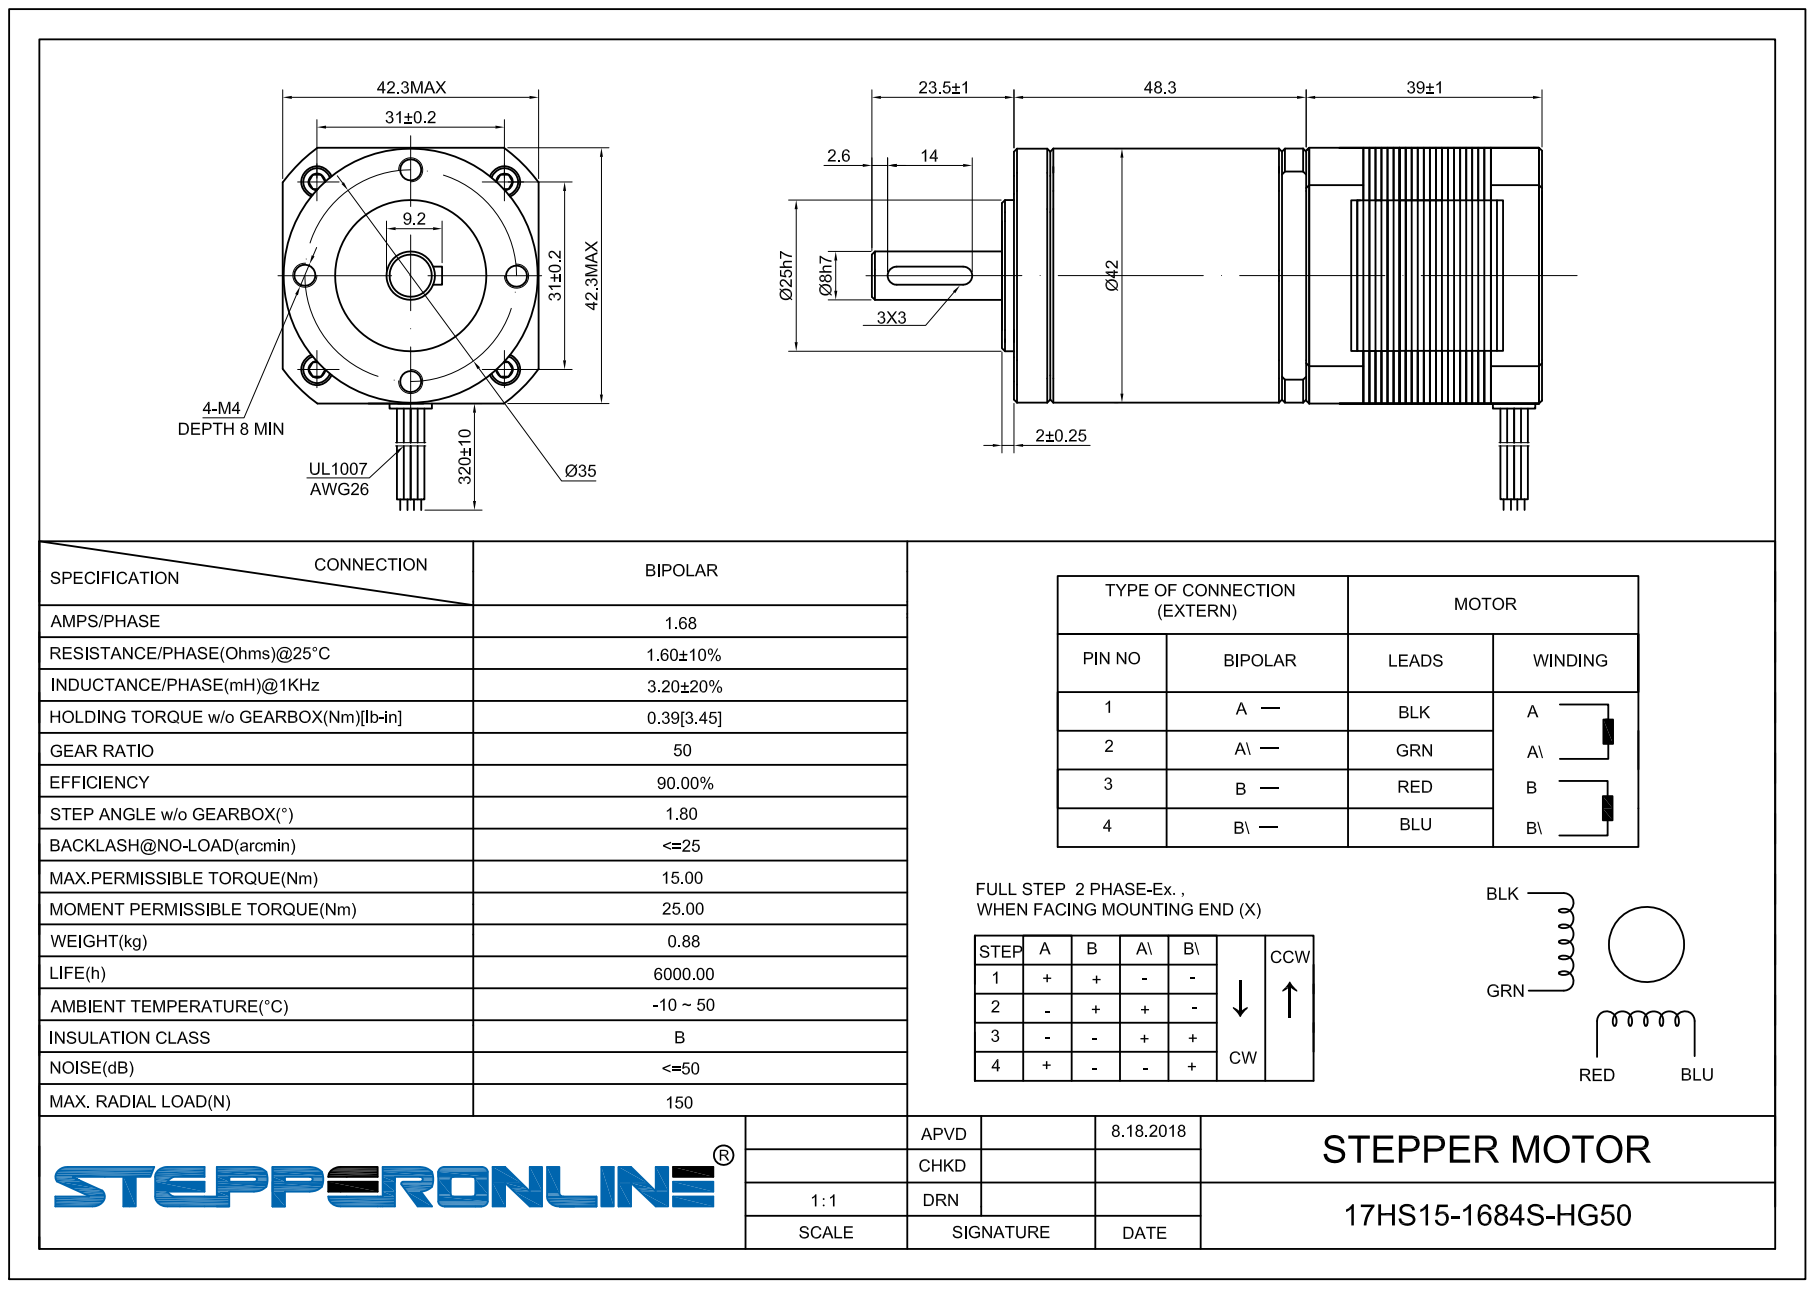
[picture p362: page 1]
