Wang-Ruohan/RV3-2/电机AR2/J4_11HS20-0674S-PG14.pdf

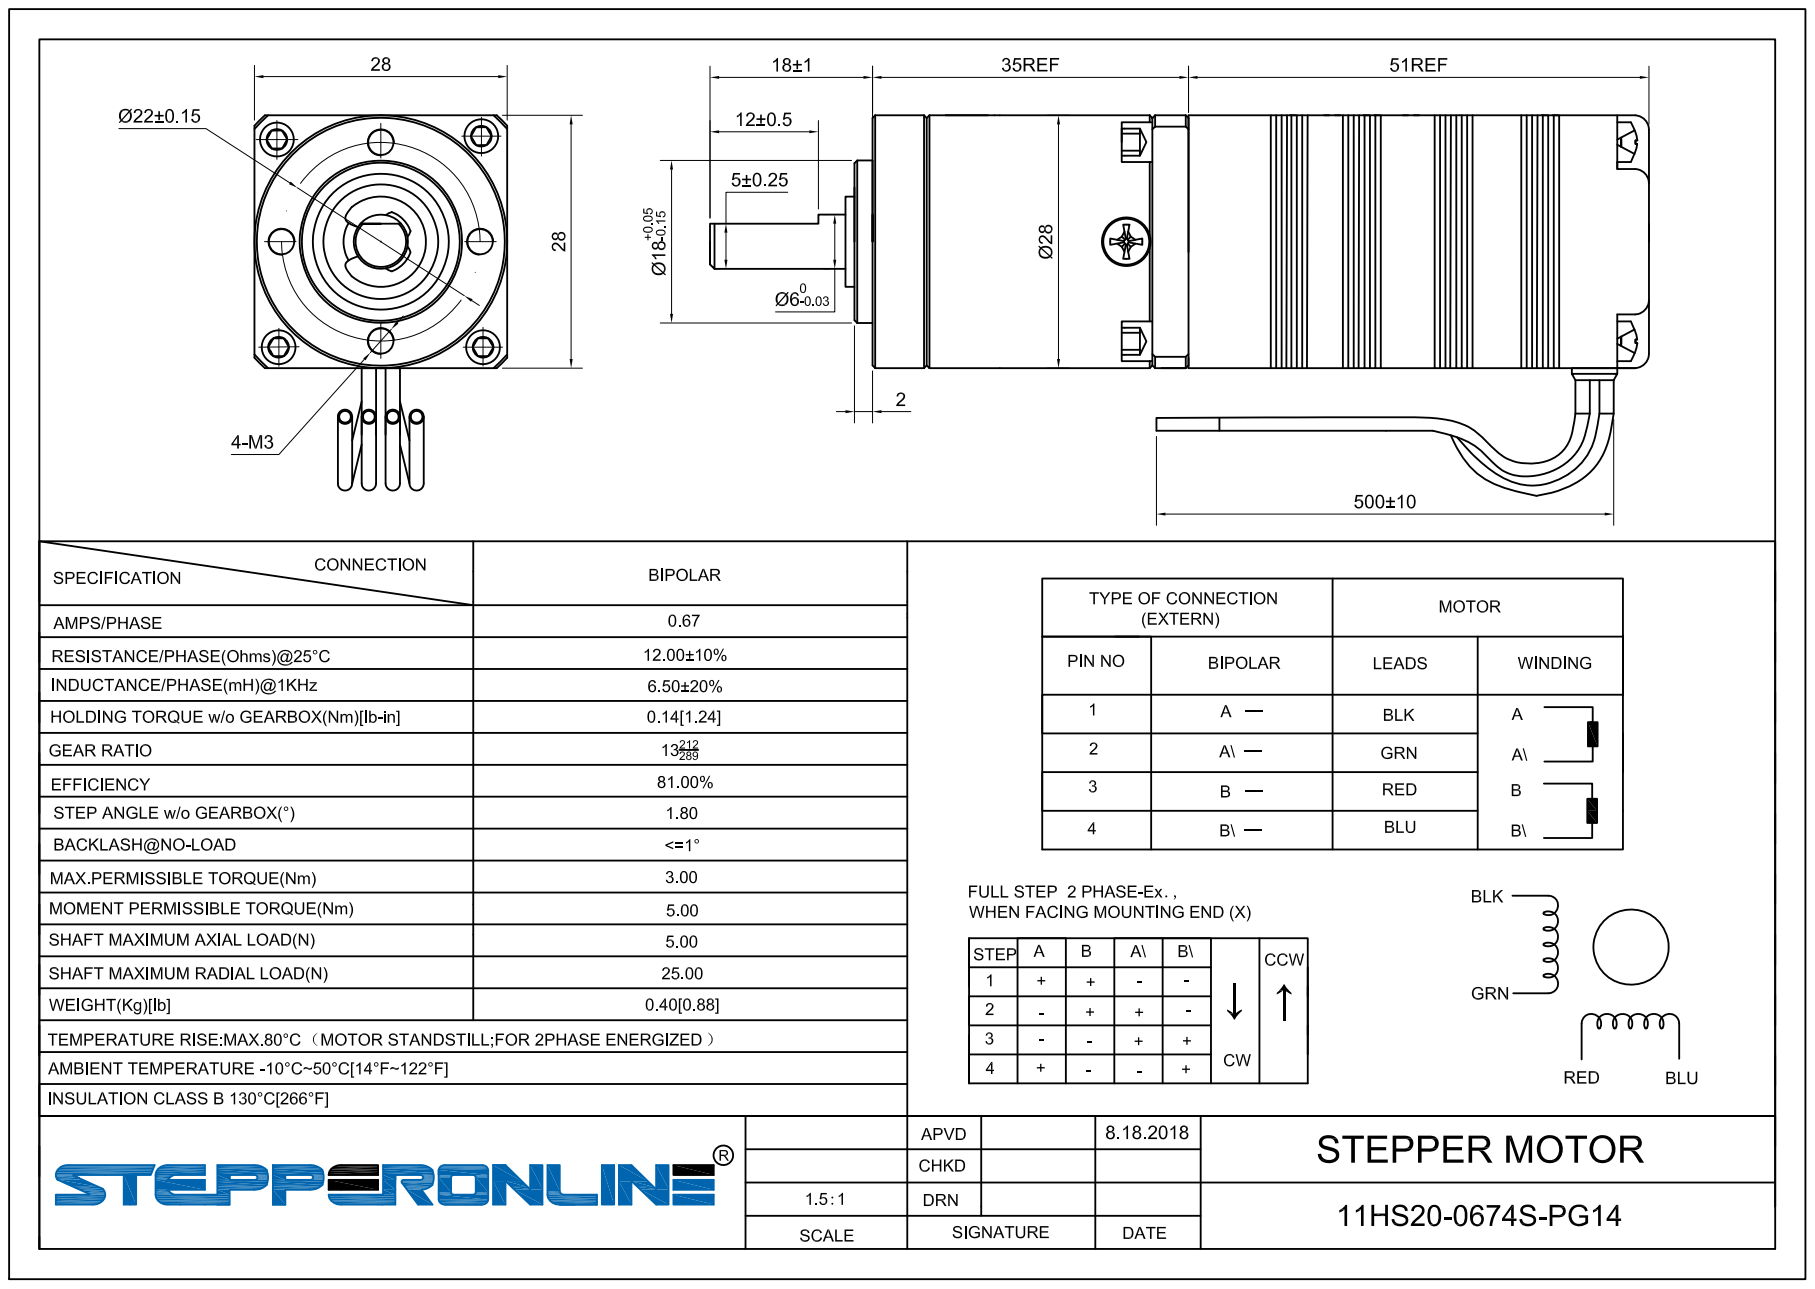
[picture p363: page 1]
