Wang-Ruohan/RV3-2/电机AR2/J6_14HS13-0804S-PG19.pdf

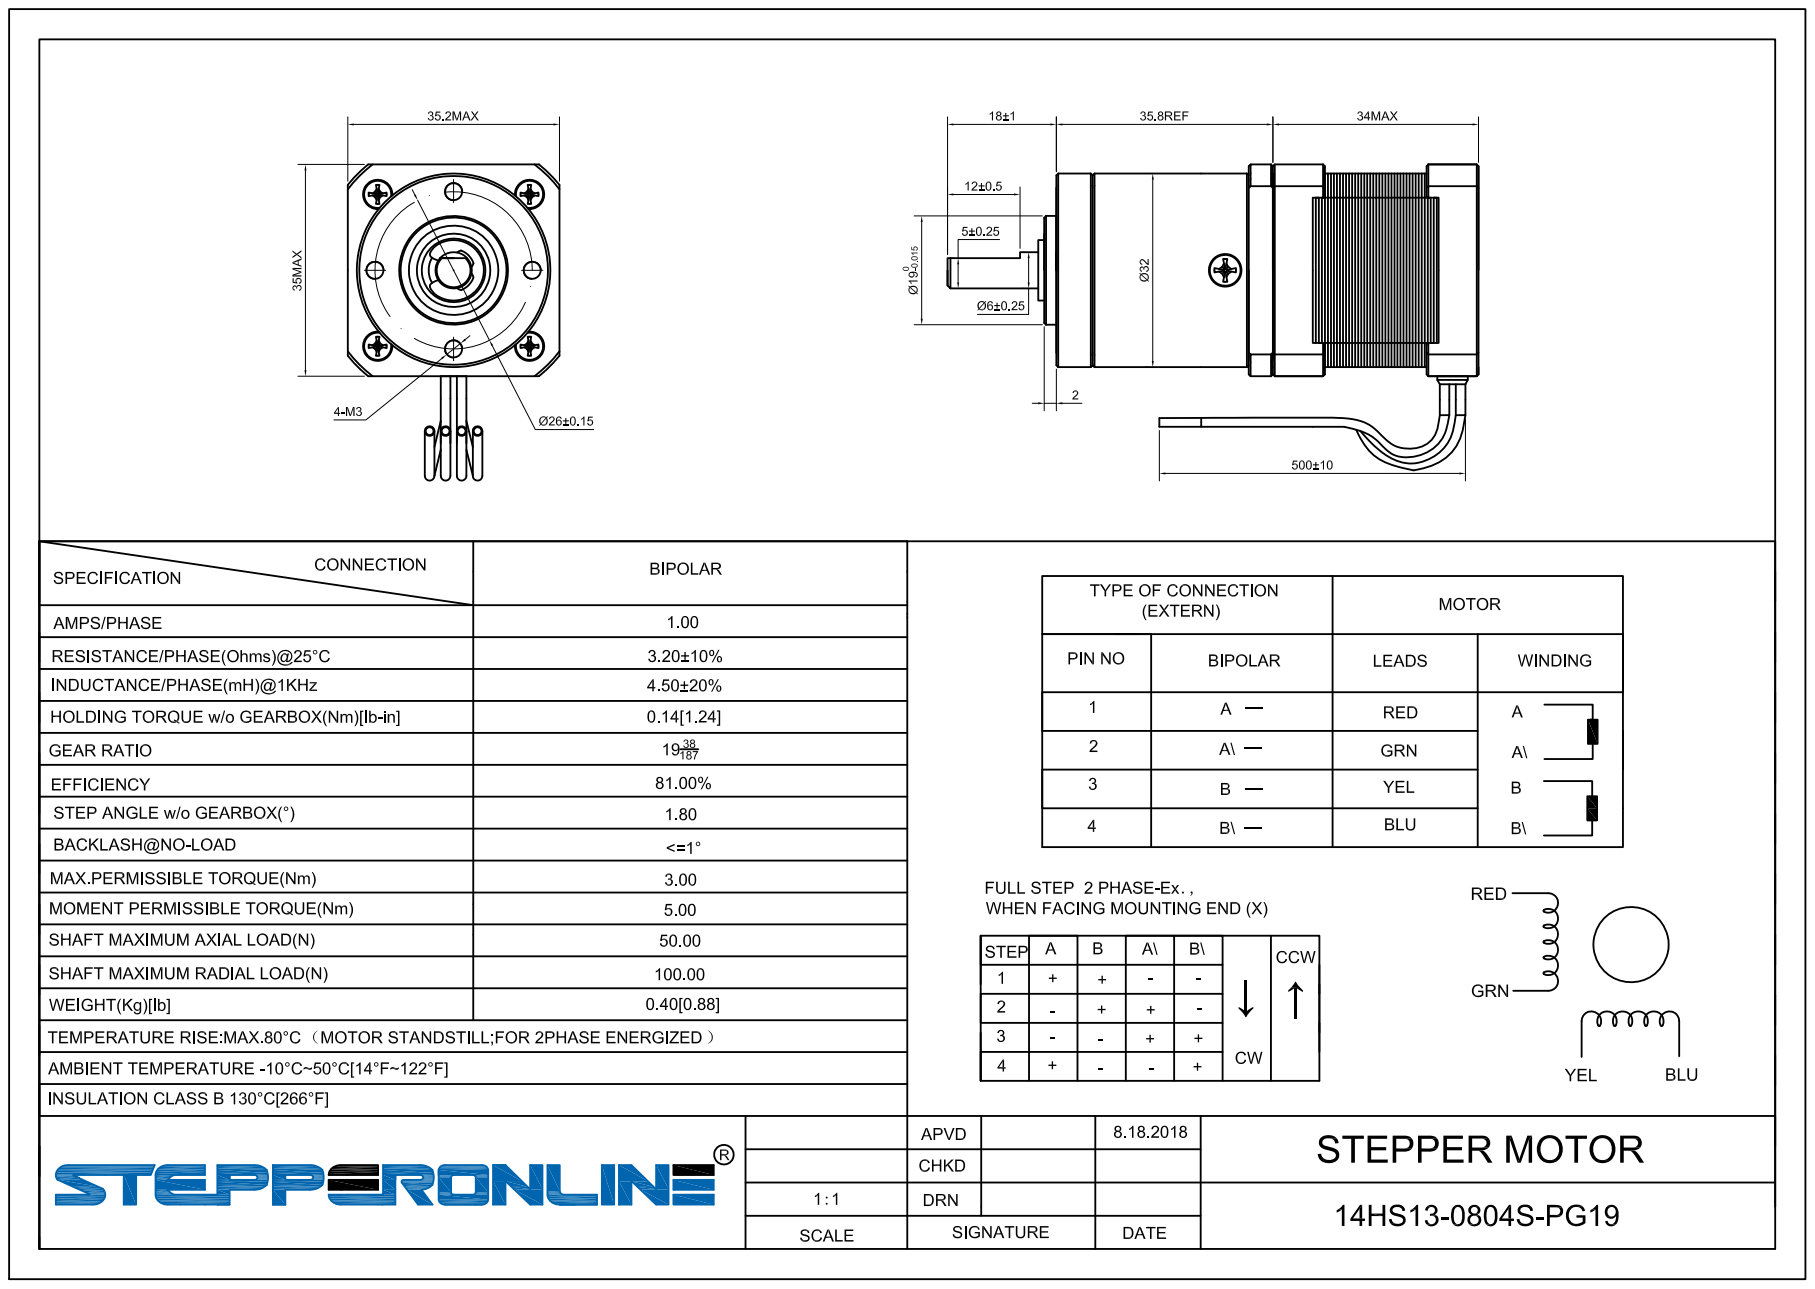
[picture p364: page 1]
