Wang-Ruohan/RV3-2/电机AR2/PF60L2-20-P2-S2-14-30-50-70-M5(1)(1).PDF

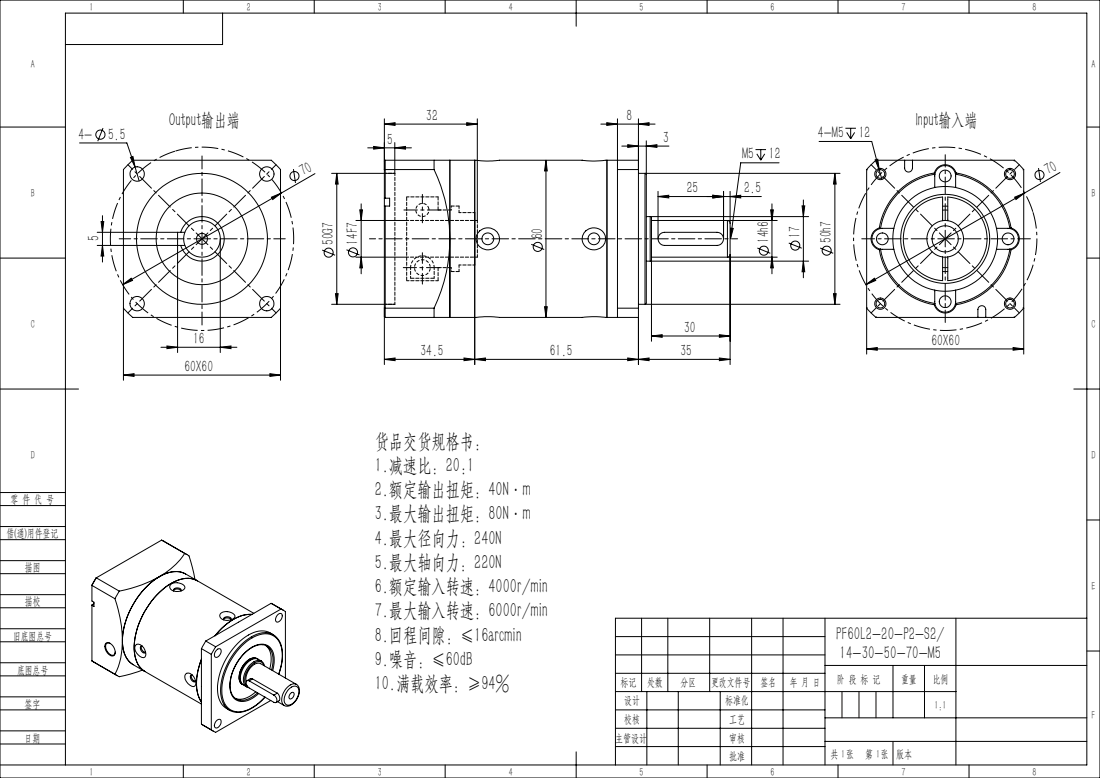
[picture p365: page 1]
Input输入端; Output输出端

标记 | 处数 | 分区 | 更改文件号 | 签名 | 年 月 日
设计 | | | 标准化 | | | | | 1:1
校核 | | | 工艺
主管设计 | | | 审核
