Wang-Ruohan/RV3-2/电机AR3/J1_17HS15-1684D-HG10-AR3.pdf

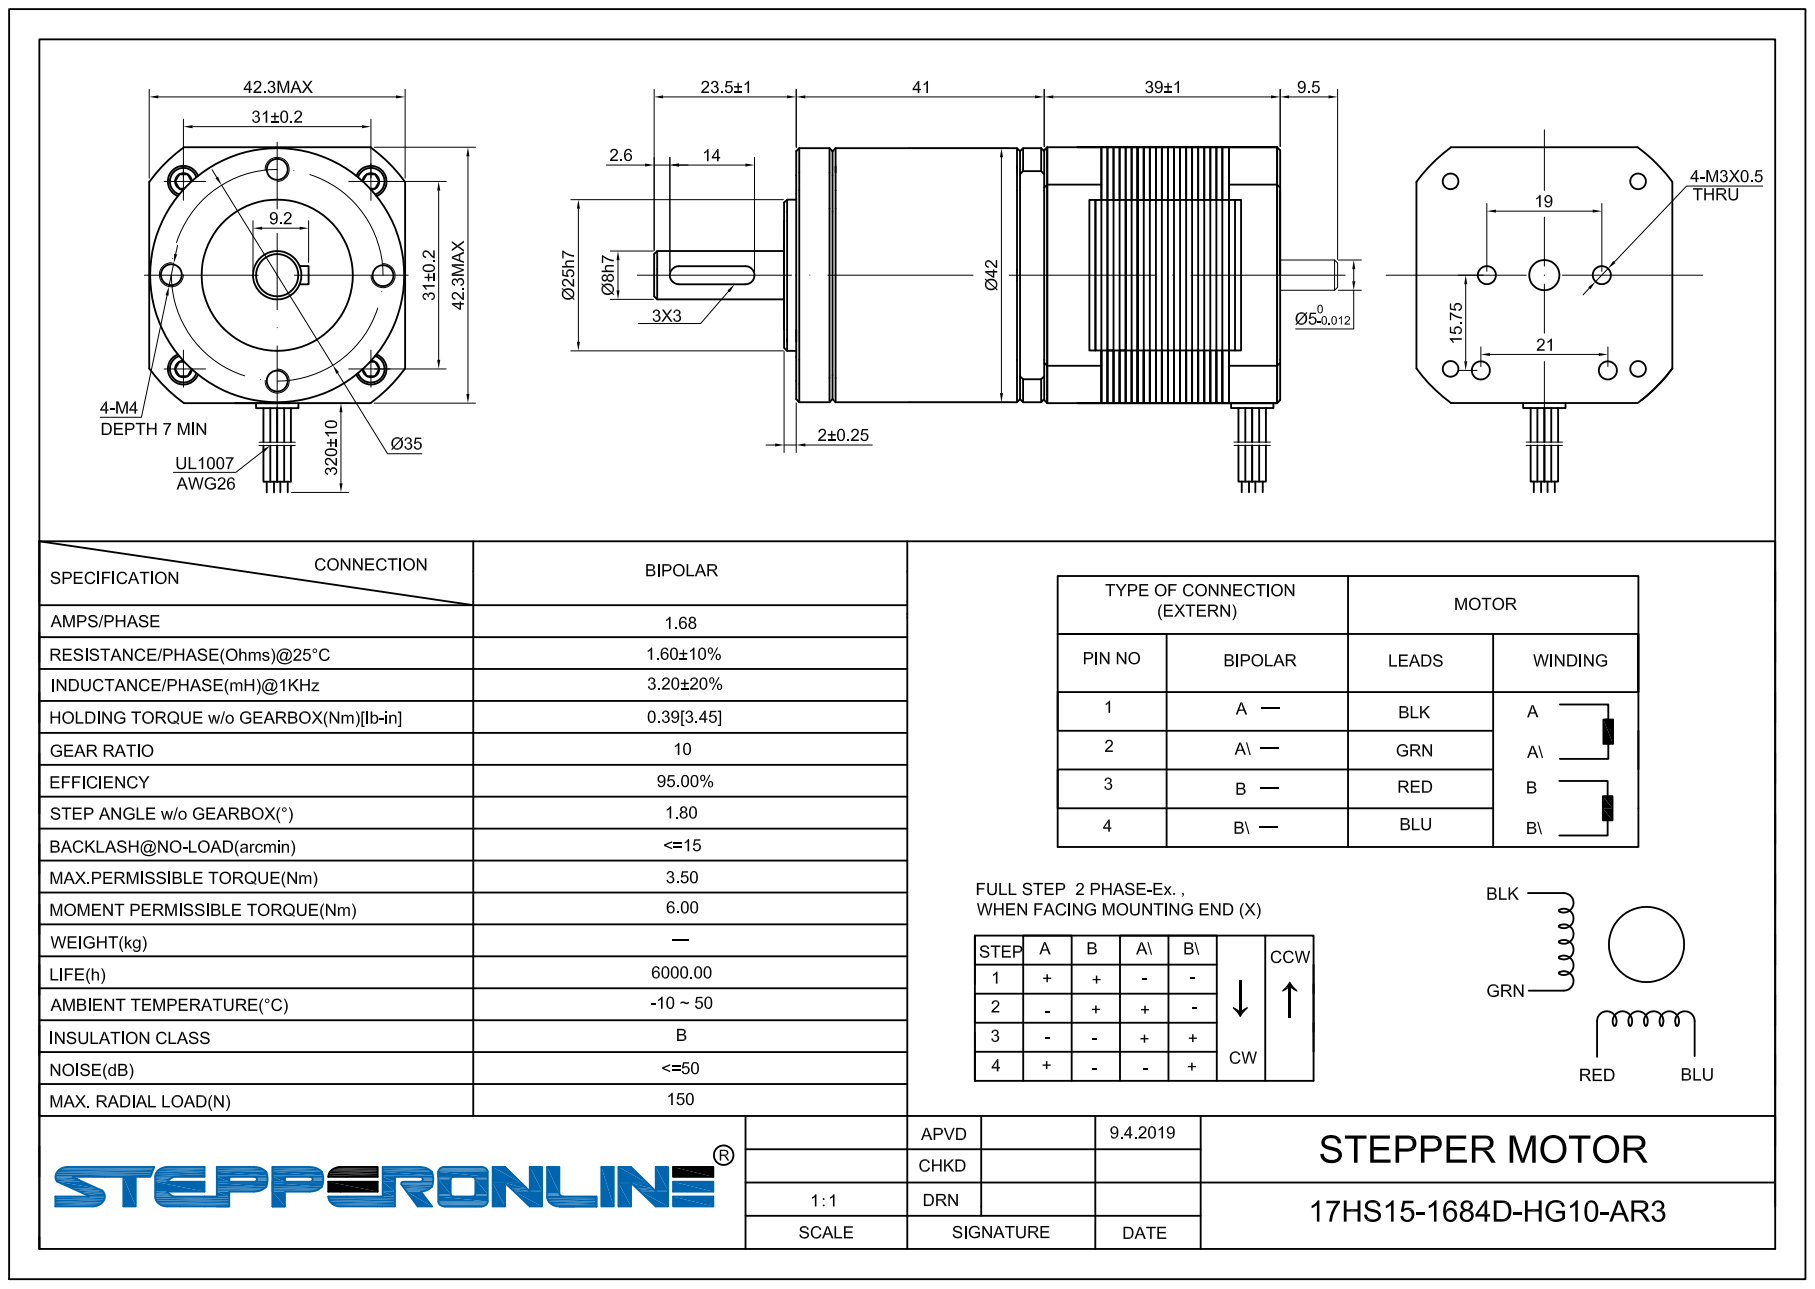
[picture p366: page 1]
