Wang-Ruohan/RV3-2/电机AR3/J2_23HS22-2804D-HG50-AR3.pdf

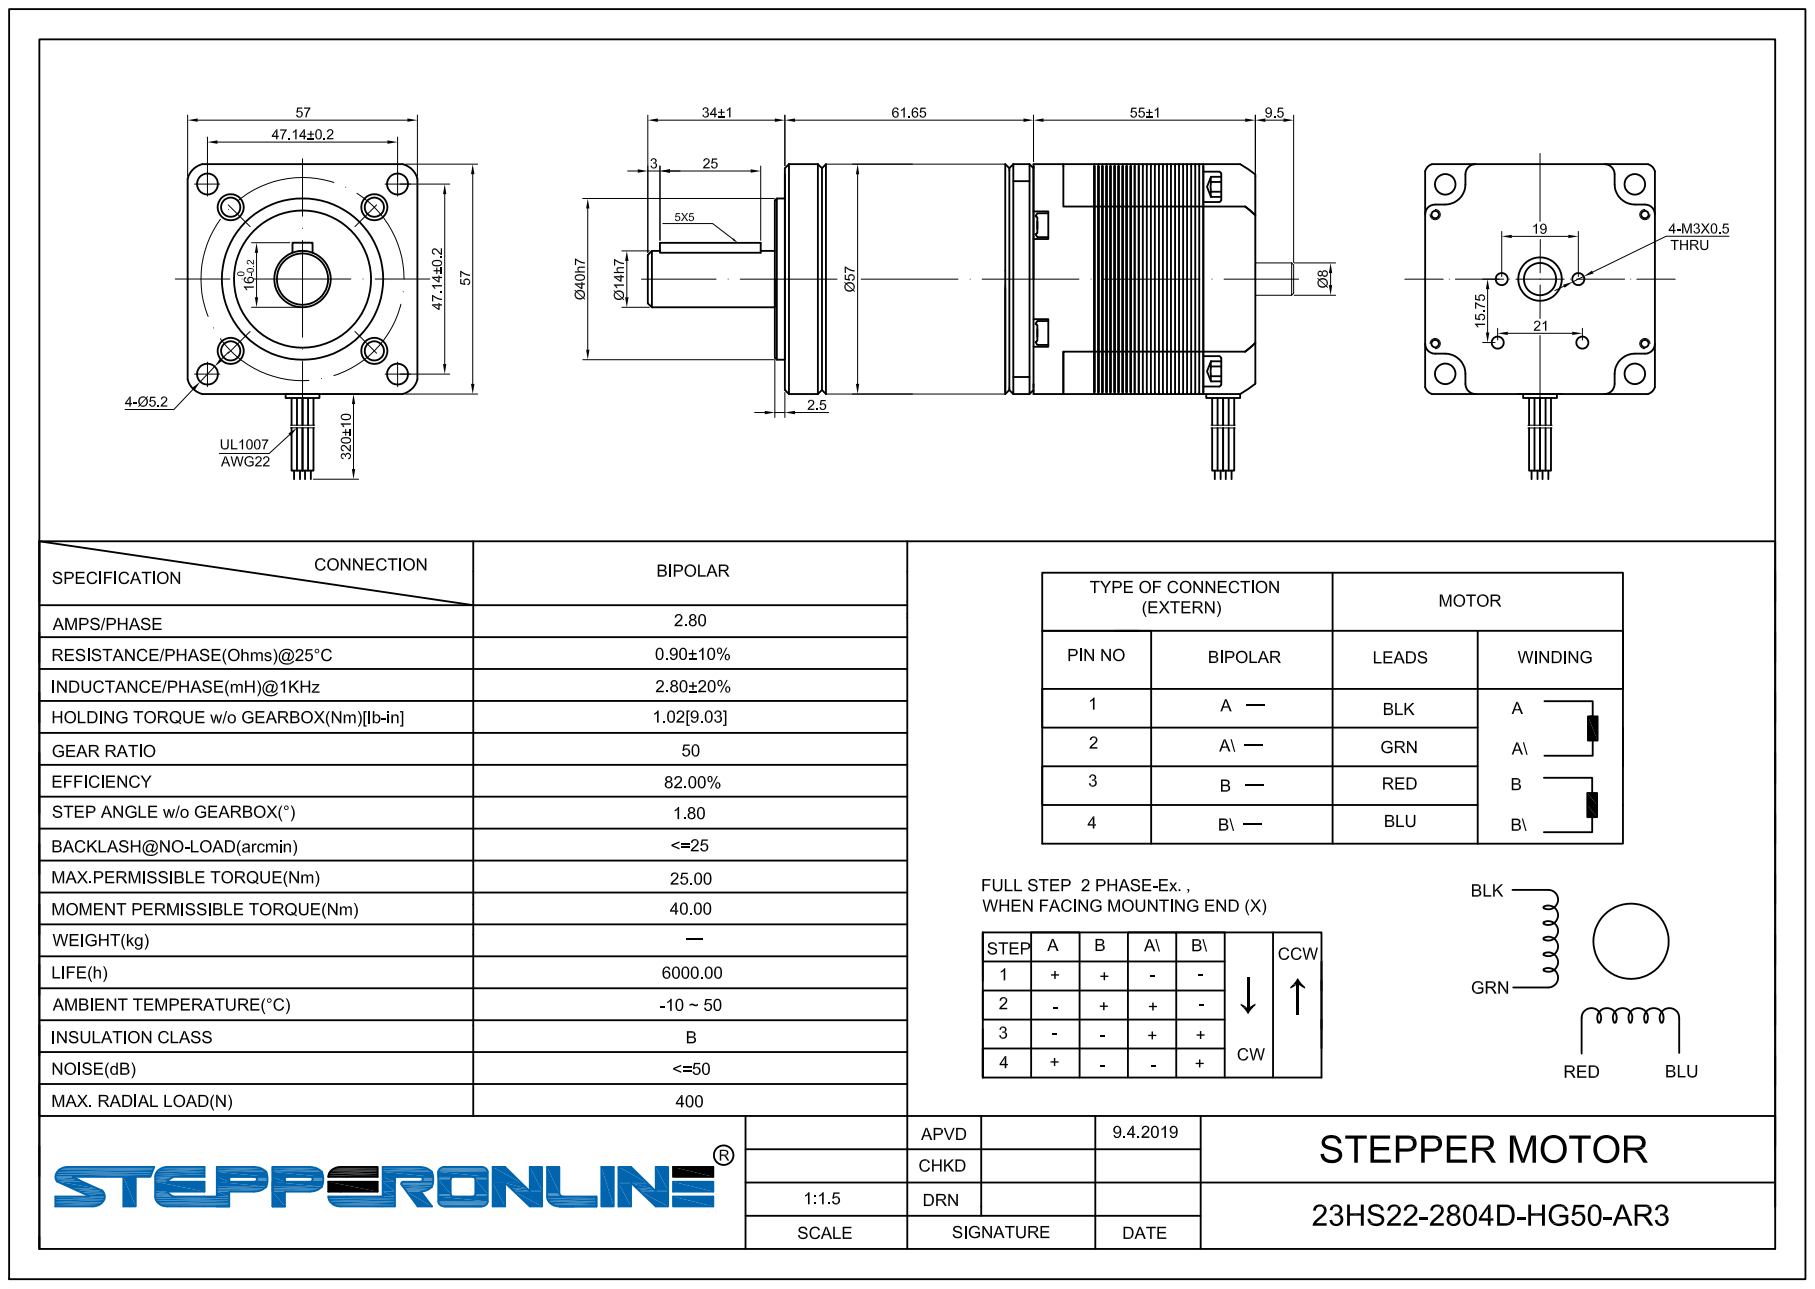
[picture p367: page 1]
