Wang-Ruohan/RV3-2/电机AR3/J3_17HS15-1684D-HG50-AR3.pdf

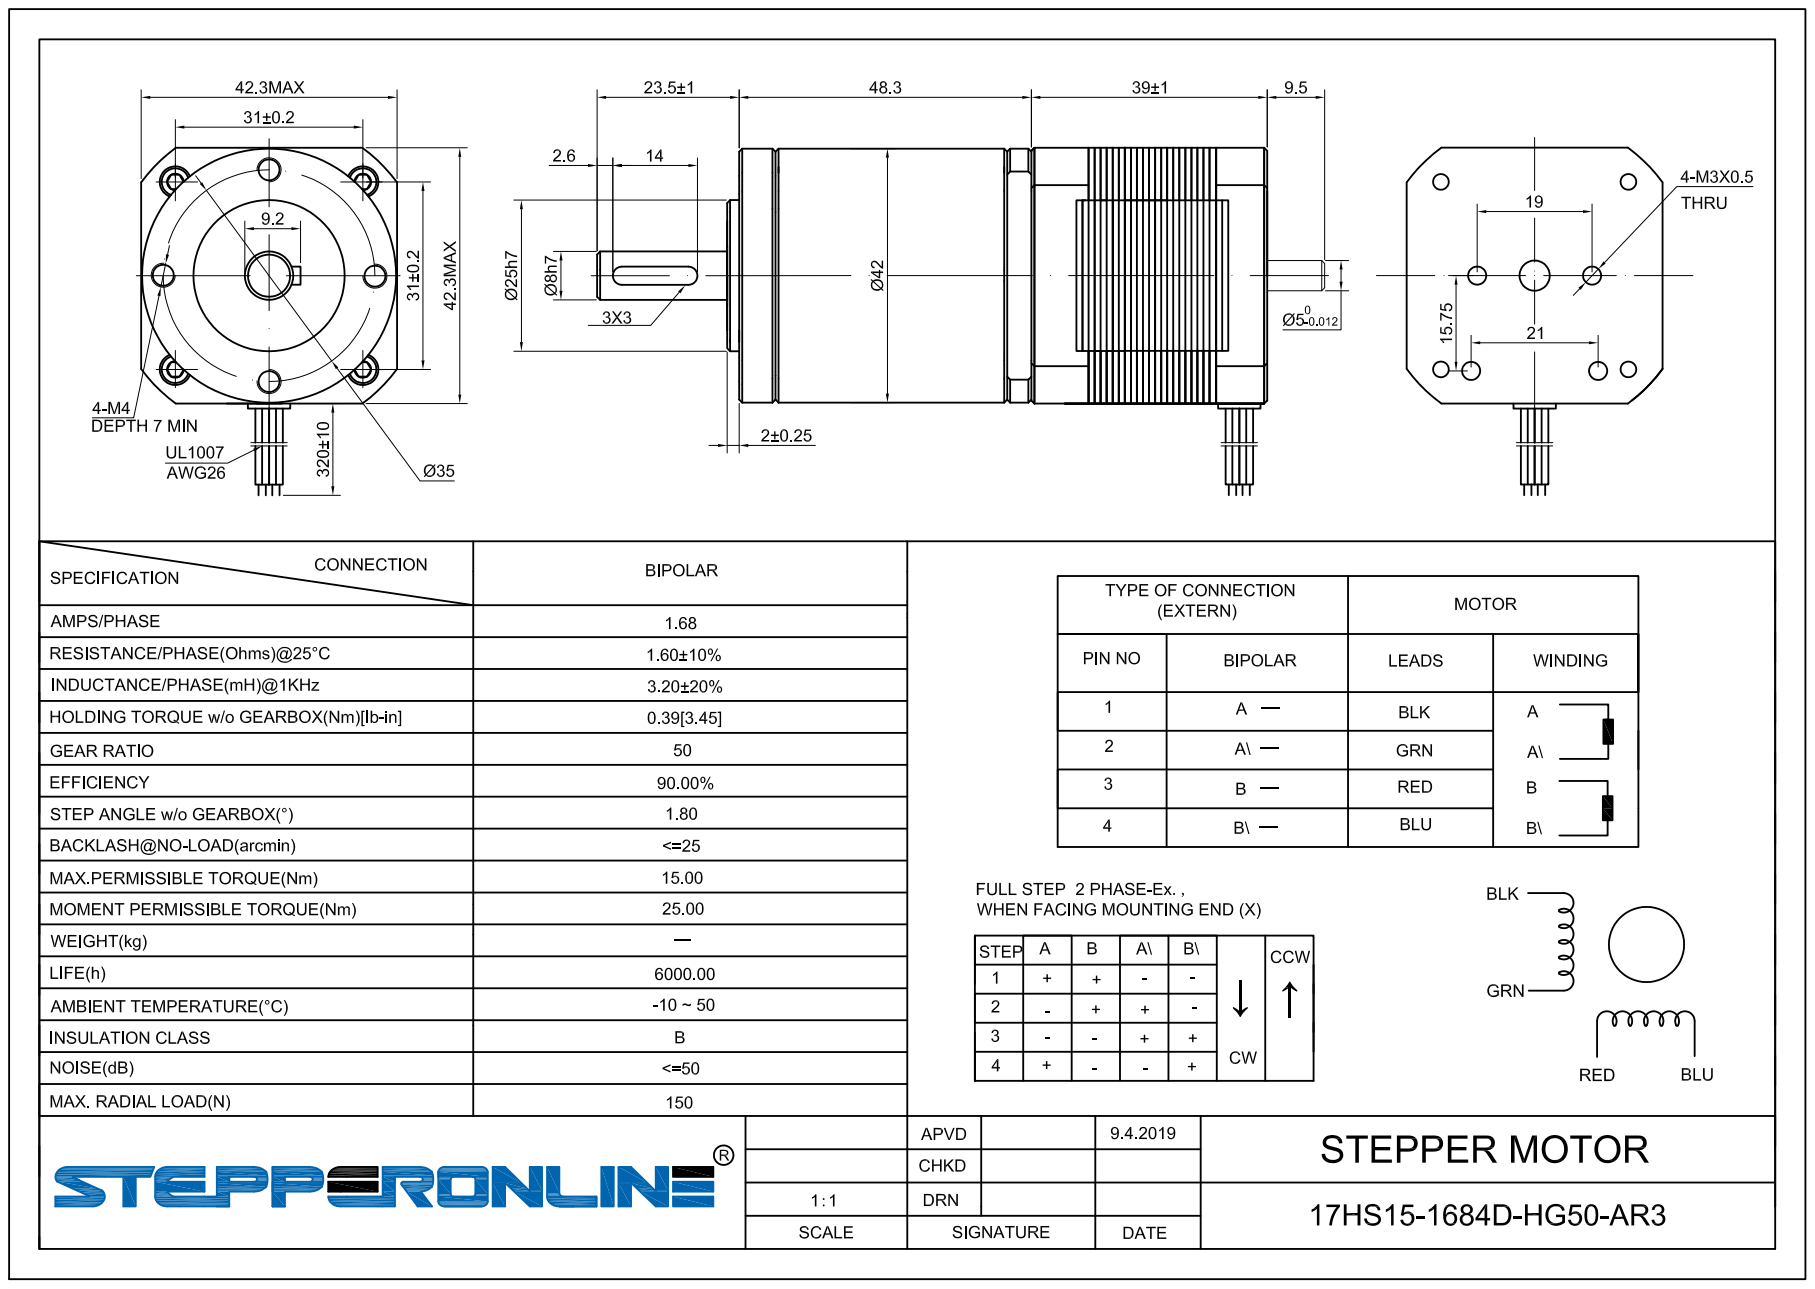
[picture p368: page 1]
