Wang-Ruohan/RV3-2/电机AR3/J4_11HS20-0674D-PG14-AR3.pdf

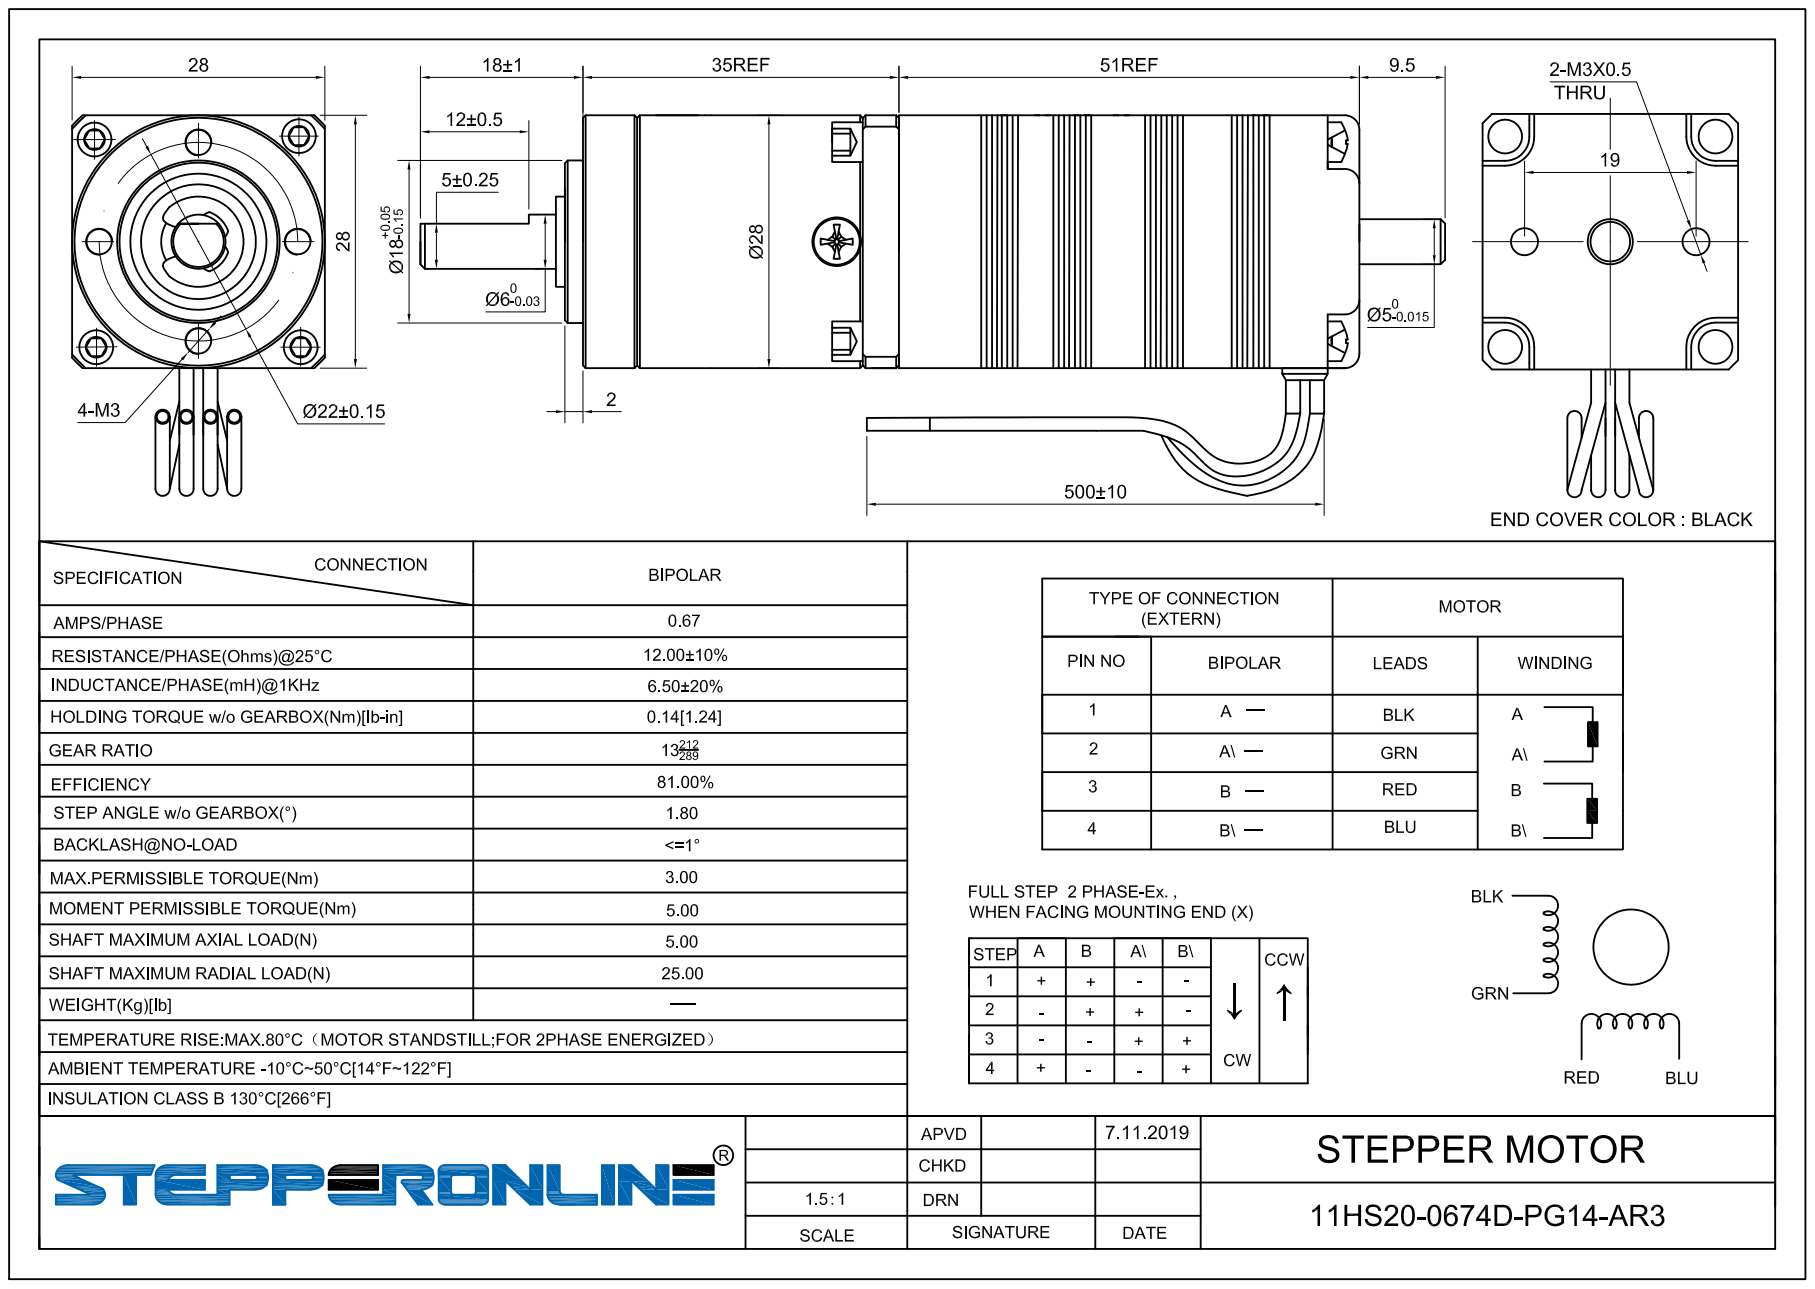
[picture p369: page 1]
