Wang-Ruohan/RV3-2/电机AR3/J5_17LS19-1684E-200G-AR3.pdf

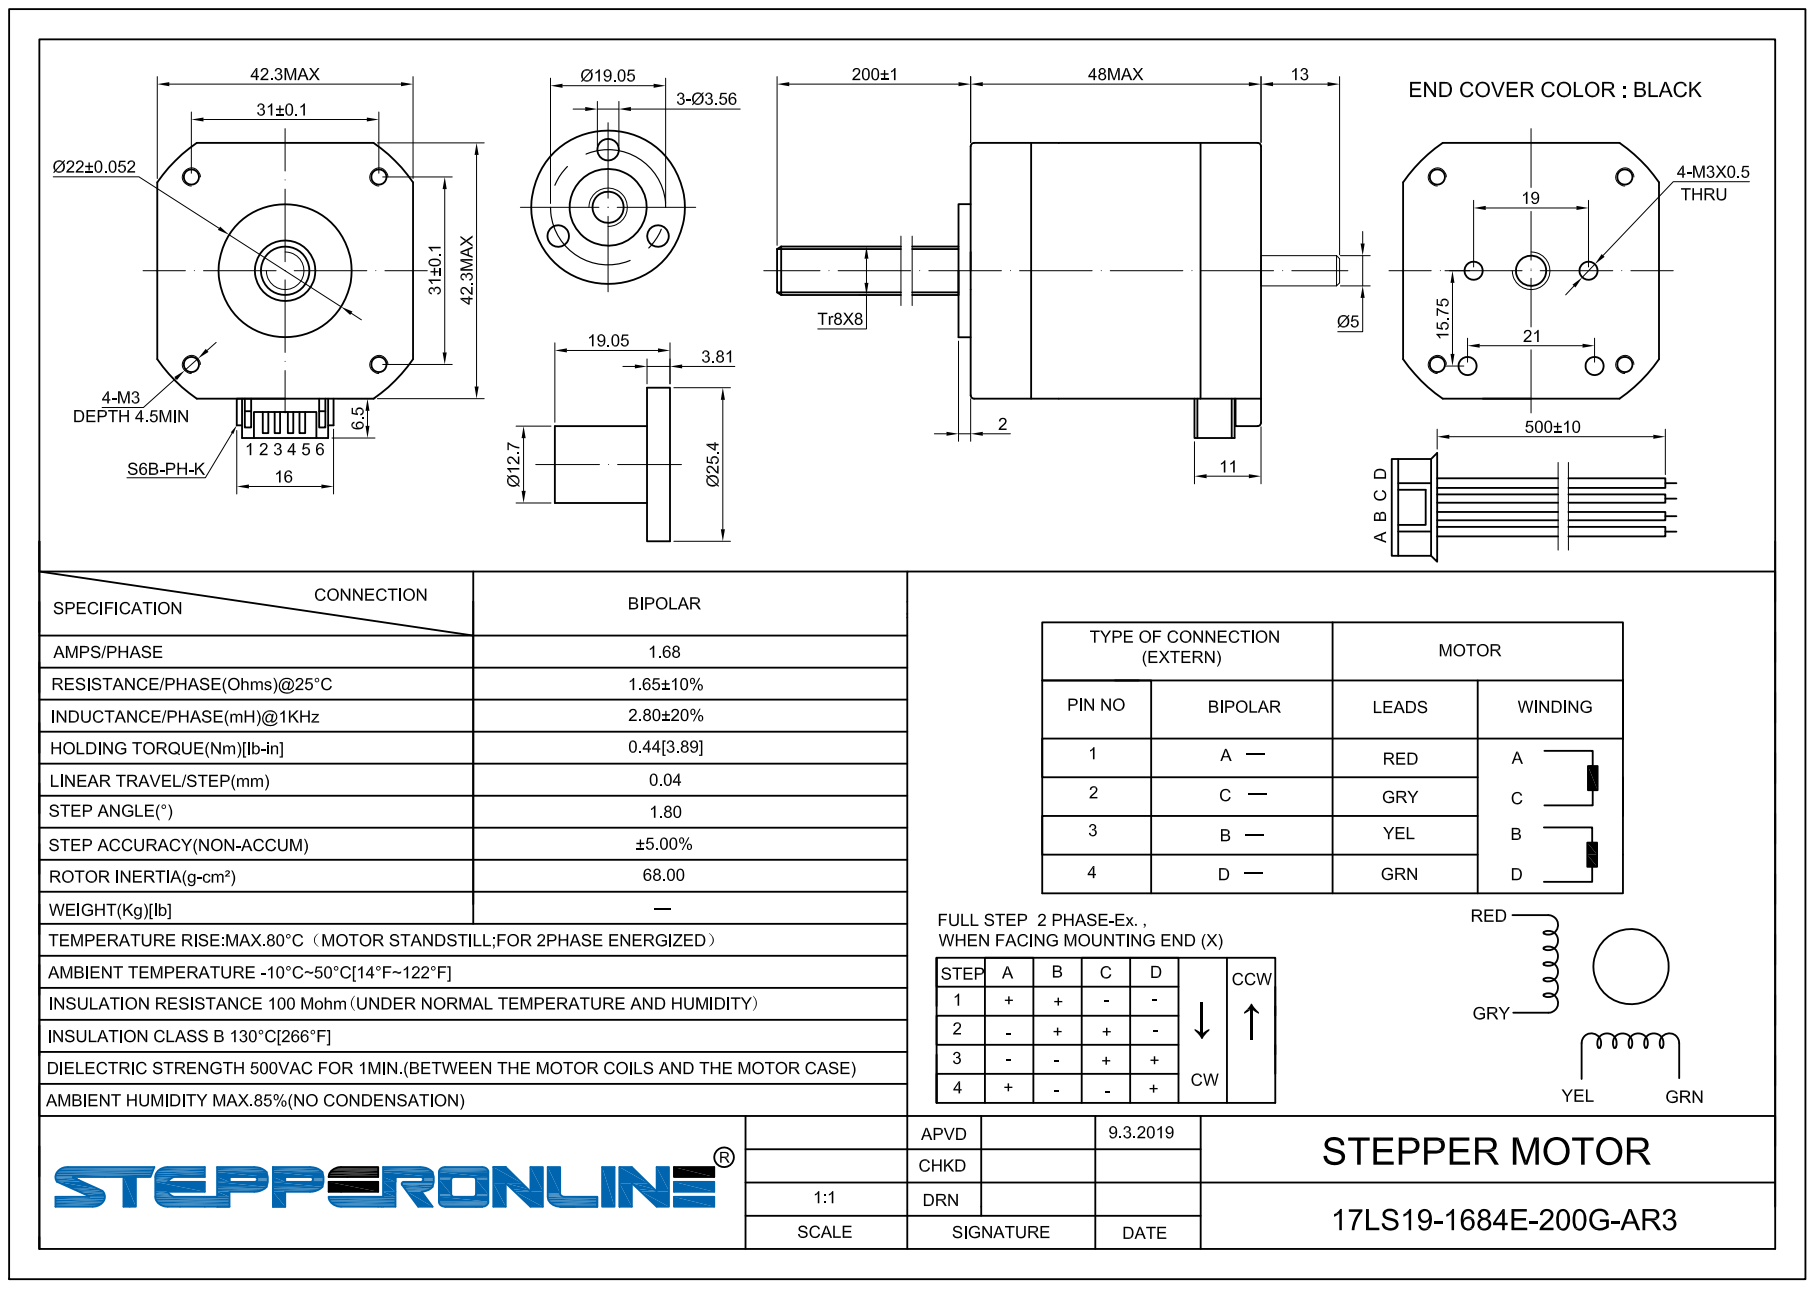
[picture p370: page 1]
