Wang-Ruohan/RV3-2/电机AR3/J6_14HS11-1004D-PG19-AR3.pdf

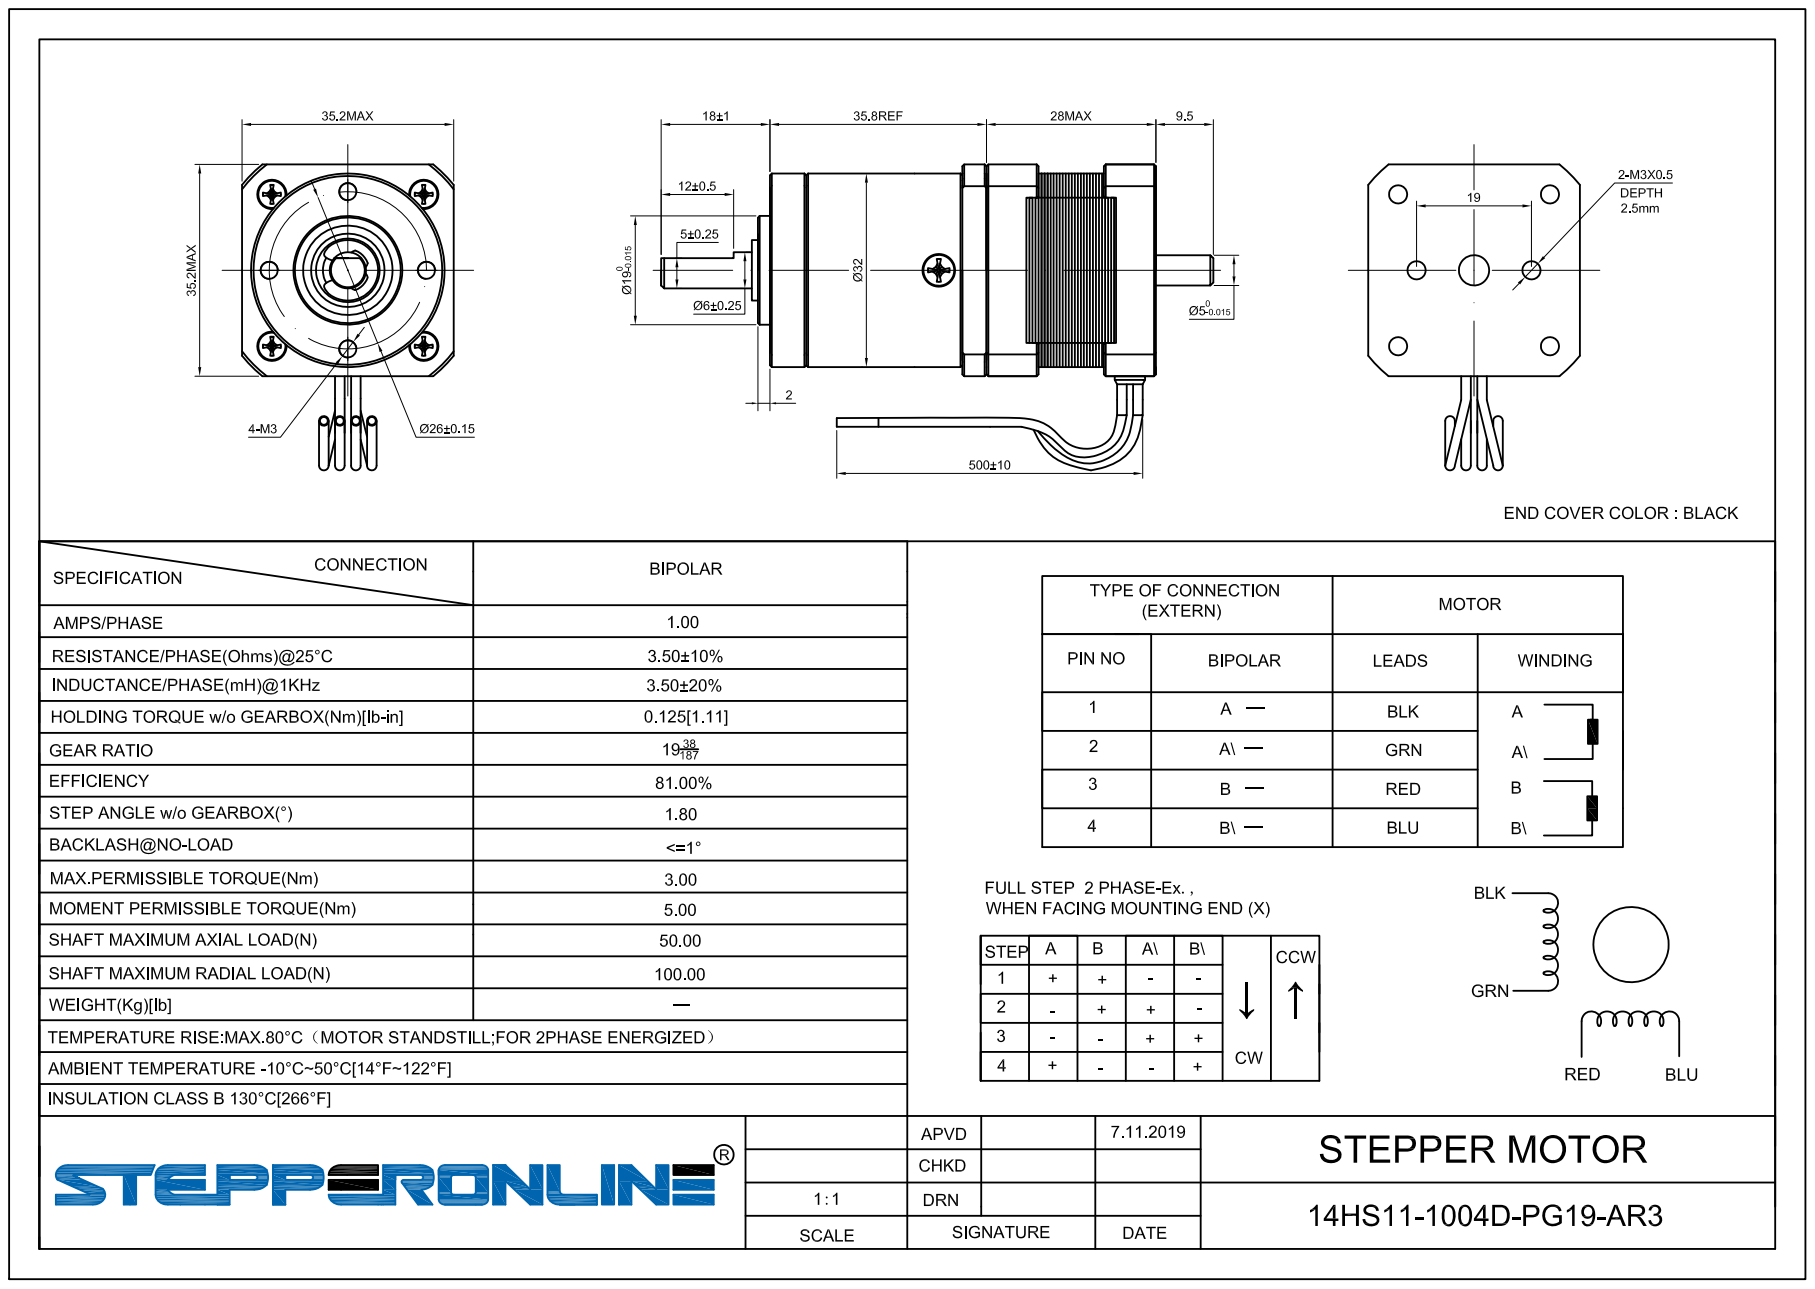
[picture p371: page 1]
