Wang-Ruohan/RV3-2/CodeAR3/ARCS_arduino_sketch/ARCS_arduino_sketch.ino

/*  ARCS Annin Robot Control Software Arduino Mega 2560 sketch
    Copyright (c) 2019, Chris Annin
    All rights reserved.

    You are free to share, copy and redistribute in any medium
    or format.  You are free to remix, transform and build upon
    this material.

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
    THIS SOFTWARE IS PROVIDED BY THE COPYRIGHT HOLDERS AND CONTRIBUTORS "AS IS" AND
    ANY EXPRESS OR IMPLIED WARRANTIES, INCLUDING, BUT NOT LIMITED TO, THE IMPLIED
    WARRANTIES OF MERCHANTABILITY AND FITNESS FOR A PARTICULAR PURPOSE ARE
    DISCLAIMED. IN NO EVENT SHALL CHRIS ANNIN BE LIABLE FOR ANY
    DIRECT, INDIRECT, INCIDENTAL, SPECIAL, EXEMPLARY, OR CONSEQUENTIAL DAMAGES
    (INCLUDING, BUT NOT LIMITED TO, PROCUREMENT OF SUBSTITUTE GOODS OR SERVICES;
    LOSS OF USE, DATA, OR PROFITS; OR BUSINESS INTERRUPTION) HOWEVER CAUSED AND
    ON ANY THEORY OF LIABILITY, WHETHER IN CONTRACT, STRICT LIABILITY, OR TORT
    (INCLUDING NEGLIGENCE OR OTHERWISE) ARISING IN ANY WAY OUT OF THE USE OF THIS
    SOFTWARE, EVEN IF ADVISED OF THE POSSIBILITY OF SUCH DAMAGE.

    chris.annin@gmail.com

    Log:

*/


#include <Servo.h>

String inData;


Servo servo0;
Servo servo1;
Servo servo2;
Servo servo3;
Servo servo4;
Servo servo5;
Servo servo6;
Servo servo7;

//28个input
const int Input0 = 0;
const int Input1 = 1;
const int Input2 = 2;
const int Input3 = 3;
const int Input4 = 4;
const int Input5 = 5;
const int Input6 = 6;
const int Input7 = 7;
const int Input8 = 8;
const int Input9 = 9;
const int Input10 = 10;
const int Input11 = 11;
const int Input12 = 12;
const int Input13 = 13;
const int Input14 = 14;
const int Input15 = 15;
const int Input16 = 16;
const int Input17 = 17;
const int Input18 = 18;
const int Input19 = 19;
const int Input20 = 20;
const int Input21 = 21;
const int Input22 = 22;
const int Input23 = 23;
const int Input24 = 24;
const int Input25 = 25;
const int Input26 = 26;
const int Input27 = 27;


//26个output
const int Output28 = 28;
const int Output29 = 29;
const int Output30 = 30;
const int Output31 = 31;
const int Output32 = 32;
const int Output33 = 33;
const int Output34 = 34;
const int Output35 = 35;
const int Output36 = 36;
const int Output37 = 37;
const int Output38 = 38;
const int Output39 = 39;
const int Output40 = 40;
const int Output41 = 41;
const int Output42 = 42;
const int Output43 = 43;
const int Output44 = 44;
const int Output45 = 45;
const int Output46 = 46;
const int Output47 = 47;
const int Output48 = 48;
const int Output49 = 49;
const int Output50 = 50;
const int Output51 = 51;
const int Output52 = 52;
const int Output53 = 53;


void setup() {
  // run once:
  Serial.begin(115200);

  pinMode(A0, OUTPUT);
  pinMode(A1, OUTPUT);
  pinMode(A2, OUTPUT);
  pinMode(A3, OUTPUT);
  pinMode(A4, OUTPUT);
  pinMode(A5, OUTPUT);
  pinMode(A6, OUTPUT);
  pinMode(A7, OUTPUT);

  pinMode(A8, INPUT);
  pinMode(A9, INPUT);
  pinMode(A10, INPUT);
  pinMode(A11, INPUT);
  pinMode(A12, INPUT);
  pinMode(A13, INPUT);
  pinMode(A14, INPUT);
  pinMode(A15, INPUT);


  pinMode(Input0, INPUT_PULLUP);
  pinMode(Input1, INPUT_PULLUP);
  pinMode(Input2, INPUT_PULLUP);
  pinMode(Input3, INPUT_PULLUP);
  pinMode(Input4, INPUT_PULLUP);
  pinMode(Input5, INPUT_PULLUP);
  pinMode(Input6, INPUT_PULLUP);
  pinMode(Input7, INPUT_PULLUP);
  pinMode(Input8, INPUT_PULLUP);
  pinMode(Input9, INPUT_PULLUP);
  pinMode(Input10, INPUT_PULLUP);
  pinMode(Input11, INPUT_PULLUP);
  pinMode(Input12, INPUT_PULLUP);
  pinMode(Input13, INPUT_PULLUP);
  pinMode(Input14, INPUT_PULLUP);
  pinMode(Input15, INPUT_PULLUP);
  pinMode(Input16, INPUT_PULLUP);
  pinMode(Input17, INPUT_PULLUP);
  pinMode(Input18, INPUT_PULLUP);
  pinMode(Input19, INPUT_PULLUP);
  pinMode(Input20, INPUT_PULLUP);
  pinMode(Input21, INPUT_PULLUP);
  pinMode(Input22, INPUT_PULLUP);
  pinMode(Input23, INPUT_PULLUP);
  pinMode(Input24, INPUT_PULLUP);
  pinMode(Input25, INPUT_PULLUP);
  pinMode(Input26, INPUT_PULLUP);
  pinMode(Input27, INPUT_PULLUP);

  pinMode(Output28, OUTPUT);
  pinMode(Output29, OUTPUT);
  pinMode(Output30, OUTPUT);
  pinMode(Output31, OUTPUT);
  pinMode(Output32, OUTPUT);
  pinMode(Output33, OUTPUT);
  pinMode(Output34, OUTPUT);
  pinMode(Output35, OUTPUT);
  pinMode(Output36, OUTPUT);
  pinMode(Output37, OUTPUT);
  pinMode(Output38, OUTPUT);
  pinMode(Output39, OUTPUT);
  pinMode(Output40, OUTPUT);
  pinMode(Output41, OUTPUT);
  pinMode(Output42, OUTPUT);
  pinMode(Output43, OUTPUT);
  pinMode(Output44, OUTPUT);
  pinMode(Output45, OUTPUT);
  pinMode(Output46, OUTPUT);
  pinMode(Output47, OUTPUT);
  pinMode(Output48, OUTPUT);
  pinMode(Output49, OUTPUT);
  pinMode(Output50, OUTPUT);
  pinMode(Output51, OUTPUT);
  pinMode(Output52, OUTPUT);
  pinMode(Output53, OUTPUT);

  servo0.attach(A0);
  servo1.attach(A1);
  servo2.attach(A2);
  servo3.attach(A3);
  servo4.attach(A4);
  servo5.attach(A5);
  servo6.attach(A6);
  servo7.attach(A7);

  digitalWrite(Output28, HIGH);
  digitalWrite(Output29, HIGH);
  digitalWrite(Output30, HIGH);
  digitalWrite(Output31, HIGH);
  digitalWrite(Output32, HIGH);
  digitalWrite(Output33, HIGH);
  digitalWrite(Output34, HIGH);
  digitalWrite(Output35, HIGH);



}

void loop() {
  //start loop
  while (Serial.available() > 0)
  {
    char recieved = Serial.read();
    inData += recieved;
    // Process message when new line character is recieved
    if (recieved == '\n')
    {
      String function = inData.substring(0, 2);


      //-----COMMAND TO MOVE SERVO---------------------------------------------------
      //-----------------------------------------------------------------------
      if (function == "SV")   //inData:sv3p300
      {
        int SVstart = inData.indexOf('V');
        int POSstart = inData.indexOf('P');
        int servoNum = inData.substring(SVstart + 1, POSstart).toInt();
        int servoPOS = inData.substring(POSstart + 1).toInt();
        if (servoNum == 0)
        {
          servo0.write(servoPOS);
        }
        if (servoNum == 1)
        {
          servo1.write(servoPOS);
        }
        if (servoNum == 2)
        {
          servo2.write(servoPOS);
        }
        if (servoNum == 3)
        {
          servo3.write(servoPOS);
        }
        if (servoNum == 4)
        {
          servo4.write(servoPOS);
        }
        if (servoNum == 5)
        {
          servo5.write(servoPOS);
        }
        if (servoNum == 6)
        {
          servo6.write(servoPOS);
        }
        if (servoNum == 7)
        {
          servo7.write(servoPOS);
        }
        Serial.print("Servo Done");
      }


      //-----COMMAND IF INPUT THEN JUMP---------------------------------------------------
      //-----------------------------------------------------------------------
      if (function == "JF")
      {
        int IJstart = inData.indexOf('X');
        int IJTabstart = inData.indexOf('T');
        int IJInputNum = inData.substring(IJstart + 1, IJTabstart).toInt();
        if (digitalRead(IJInputNum) == HIGH)
        {
          Serial.print("T\r");
        }
        if (digitalRead(IJInputNum) == LOW)
        {
          Serial.print("F\r");
        }
      }
      //-----COMMAND SET OUTPUT ON---------------------------------------------------
      //-----------------------------------------------------------------------
      if (function == "ON")
      {
        int ONstart = inData.indexOf('X');
        int outputNum = inData.substring(ONstart + 1).toInt();
        digitalWrite(outputNum, HIGH);
        Serial.print("Done");
      }
      //-----COMMAND SET OUTPUT OFF---------------------------------------------------
      //-----------------------------------------------------------------------
      if (function == "OF")
      {
        int ONstart = inData.indexOf('X');
        int outputNum = inData.substring(ONstart + 1).toInt();
        digitalWrite(outputNum, LOW);
        Serial.print("Done");
      }
      //-----COMMAND TO WAIT INPUT ON---------------------------------------------------
      //-----------------------------------------------------------------------
      if (function == "WI")
      {
        int WIstart = inData.indexOf('N');
        int InputNum = inData.substring(WIstart + 1).toInt();
        while (digitalRead(InputNum) == LOW) {
          delay(100);
        }
        Serial.print("Done");
      }
      //-----COMMAND TO WAIT INPUT OFF---------------------------------------------------
      //-----------------------------------------------------------------------
      if (function == "WO")
      {
        int WIstart = inData.indexOf('N');
        int InputNum = inData.substring(WIstart + 1).toInt();

        //String InputStr =  String("Input" + InputNum);
        //uint8_t Input = atoi(InputStr.c_str ());
        while (digitalRead(InputNum) == HIGH) {
          delay(100);
        }
        Serial.print("Done");
      }
      //-----COMMAND ECHO TEST MESSAGE---------------------------------------------------
      //-----------------------------------------------------------------------
      if (function == "TM")
      {
        String echo = inData.substring(2);
        Serial.println(echo);
      }




      else
      {
        inData = ""; // Clear recieved buffer
      }
    }
  }
}
