Wang-Ruohan/RV3-2/CodeAR2/sketch/AR2_2.0_arduino_sketch/AR2_2.0_arduino_sketch.ino

/*  AR2 - Stepper motor robot control software Ver 2.2.0
    Copyright (c) 2017, Chris Annin
    All rights reserved.

    You are free to share, copy and redistribute in any medium
    or format.  You are free to remix, transform and build upon
    this material.

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
    THIS SOFTWARE IS PROVIDED BY THE COPYRIGHT HOLDERS AND CONTRIBUTORS "AS IS" AND
    ANY EXPRESS OR IMPLIED WARRANTIES, INCLUDING, BUT NOT LIMITED TO, THE IMPLIED
    WARRANTIES OF MERCHANTABILITY AND FITNESS FOR A PARTICULAR PURPOSE ARE
    DISCLAIMED. IN NO EVENT SHALL CHRIS ANNIN BE LIABLE FOR ANY
    DIRECT, INDIRECT, INCIDENTAL, SPECIAL, EXEMPLARY, OR CONSEQUENTIAL DAMAGES
    (INCLUDING, BUT NOT LIMITED TO, PROCUREMENT OF SUBSTITUTE GOODS OR SERVICES;
    LOSS OF USE, DATA, OR PROFITS; OR BUSINESS INTERRUPTION) HOWEVER CAUSED AND
    ON ANY THEORY OF LIABILITY, WHETHER IN CONTRACT, STRICT LIABILITY, OR TORT
    (INCLUDING NEGLIGENCE OR OTHERWISE) ARISING IN ANY WAY OUT OF THE USE OF THIS
    SOFTWARE, EVEN IF ADVISED OF THE POSSIBILITY OF SUCH DAMAGE.

    chris.annin@gmail.com

    Log:
    Ver 2.1.1 - new timing algorithm
    Ver 2.1.2 - fix calibration timing
    Ver 2.1.3 - base speed to 200 increase step delay to 10
    Ver 2.1.4 - added individual joint calibration
    Ver 2.1.5 - fixed axis 4 & 6 rotations
    Ver 2.2.0 - serial for python 3.7 +115200 / add test echo / add Move L
*/

// SPEED // millisecond multiplier // raise value to slow robot speeds // DEFAULT = 200
const int SpeedMult = 200;

/*
  MOTOR DIRECTION - motor directions can be changed on the caibration page in the software but can also
  be changed here: example using DM542T driver(CW) set to 1 - if using ST6600 or DM320T driver(CCW) set to 0
  DEFAULT = 111011   */

const int J1rotdir = 1;
const int J2rotdir = 1;
const int J3rotdir = 1;
const int J4rotdir = 0;
const int J5rotdir = 1;
const int J6rotdir = 1;

const int TRACKrotdir = 0;

#include <Servo.h>

Servo servo0;
Servo servo1;
Servo servo2;
Servo servo3;
Servo servo4;
Servo servo5;
Servo servo6;
Servo servo7;

String inData;
String function;
char WayPt[101][50];
int WayPtDel;

const int J1stepPin = 2;
const int J1dirPin = 3;
const int J2stepPin = 4;
const int J2dirPin = 5;
const int J3stepPin = 6;
const int J3dirPin = 7;
const int J4stepPin = 8;
const int J4dirPin = 9;
const int J5stepPin = 10;
const int J5dirPin = 11;
const int J6stepPin = 12;
const int J6dirPin = 13;
const int TRstepPin = 20;
const int TRdirPin = 21;

const int J1calPin = 14;
const int J2calPin = 15;
const int J3calPin = 16;
const int J4calPin = 17;
const int J5calPin = 18;
const int J6calPin = 19;

const int Input22 = 22;
const int Input23 = 23;
const int Input24 = 24;
const int Input25 = 25;
const int Input26 = 26;
const int Input27 = 27;
const int Input28 = 28;
const int Input29 = 29;
const int Input30 = 30;
const int Input31 = 31;
const int Input32 = 32;
const int Input33 = 33;
const int Input34 = 34;
const int Input35 = 35;
const int Input36 = 36;
const int Input37 = 37;

const int Output38 = 38;
const int Output39 = 39;
const int Output40 = 40;
const int Output41 = 41;
const int Output42 = 42;
const int Output43 = 43;
const int Output44 = 44;
const int Output45 = 45;
const int Output46 = 46;
const int Output47 = 47;
const int Output48 = 48;
const int Output49 = 49;
const int Output50 = 50;
const int Output51 = 51;
const int Output52 = 52;
const int Output53 = 53;




/////////////////////////////////////////////////////////////////////////////////////////////////////////////////////////////////////////////////////////////////////////////////////////////
//DRIVE MOTORS J
/////////////////////////////////////////////////////////////////////////////////////////////////////////////////////////////////////////////////////////////////////////////////////////////

void driveMotorsJ(String inData) {
  int J1start = inData.indexOf('A');
  int J2start = inData.indexOf('B');
  int J3start = inData.indexOf('C');
  int J4start = inData.indexOf('D');
  int J5start = inData.indexOf('E');
  int J6start = inData.indexOf('F');
  int TRstart = inData.indexOf('T');
  int Adstart = inData.indexOf('G');
  int Asstart = inData.indexOf('H');
  int Ddstart = inData.indexOf('I');
  int Dsstart = inData.indexOf('K');
  int SPstart = inData.indexOf('S');
  int J1dir = inData.substring(J1start + 1, J1start + 2).toInt();
  int J2dir = inData.substring(J2start + 1, J2start + 2).toInt();
  int J3dir = inData.substring(J3start + 1, J3start + 2).toInt();
  int J4dir = inData.substring(J4start + 1, J4start + 2).toInt();
  int J5dir = inData.substring(J5start + 1, J5start + 2).toInt();
  int J6dir = inData.substring(J6start + 1, J6start + 2).toInt();
  int TRdir = inData.substring(TRstart + 1, TRstart + 2).toInt();
  int J1step = inData.substring(J1start + 2, J2start).toInt();
  int J2step = inData.substring(J2start + 2, J3start).toInt();
  int J3step = inData.substring(J3start + 2, J4start).toInt();
  int J4step = inData.substring(J4start + 2, J5start).toInt();
  int J5step = inData.substring(J5start + 2, J6start).toInt();
  int J6step = inData.substring(J6start + 2, TRstart).toInt();
  int TRstep = inData.substring(TRstart + 2, SPstart).toInt();
  float SpeedIn = inData.substring(SPstart + 1, Adstart).toFloat();
  float ACCdur = inData.substring(Adstart + 1, Asstart).toInt();
  float ACCspd = inData.substring(Asstart + 1, Ddstart).toInt();
  float DCCdur = inData.substring(Ddstart + 1, Dsstart).toInt();
  float DCCspd = inData.substring(Dsstart + 1).toInt();

  //FIND HIGHEST STEP
  int HighStep = J1step;
  if (J2step > HighStep)
  {
    HighStep = J2step;
  }
  if (J3step > HighStep)
  {
    HighStep = J3step;
  }
  if (J4step > HighStep)
  {
    HighStep = J4step;
  }
  if (J5step > HighStep)
  {
    HighStep = J5step;
  }
  if (J6step > HighStep)
  {
    HighStep = J6step;
  }
  if (TRstep > HighStep)
  {
    HighStep = TRstep;
  }

  //FIND ACTIVE JOINTS
  int J1active = 0;
  int J2active = 0;
  int J3active = 0;
  int J4active = 0;
  int J5active = 0;
  int J6active = 0;
  int TRactive = 0;
  int Jactive = 0;

  if (J1step >= 1)
  {
    J1active = 1;
  }
  if (J2step >= 1)
  {
    J2active = 1;
  }
  if (J3step >= 1)
  {
    J3active = 1;
  }
  if (J4step >= 1)
  {
    J4active = 1;
  }
  if (J5step >= 1)
  {
    J5active = 1;
  }
  if (J6step >= 1)
  {
    J6active = 1;
  }
  if (TRstep >= 1)
  {
    TRactive = 1;
  }
  Jactive = (J1active + J2active + J3active + J4active + J5active + J6active + TRactive);

  int J1_PE = 0;
  int J2_PE = 0;
  int J3_PE = 0;
  int J4_PE = 0;
  int J5_PE = 0;
  int J6_PE = 0;
  int TR_PE = 0;

  int J1_SE_1 = 0;
  int J2_SE_1 = 0;
  int J3_SE_1 = 0;
  int J4_SE_1 = 0;
  int J5_SE_1 = 0;
  int J6_SE_1 = 0;
  int TR_SE_1 = 0;

  int J1_SE_2 = 0;
  int J2_SE_2 = 0;
  int J3_SE_2 = 0;
  int J4_SE_2 = 0;
  int J5_SE_2 = 0;
  int J6_SE_2 = 0;
  int TR_SE_2 = 0;

  int J1_LO_1 = 0;
  int J2_LO_1 = 0;
  int J3_LO_1 = 0;
  int J4_LO_1 = 0;
  int J5_LO_1 = 0;
  int J6_LO_1 = 0;
  int TR_LO_1 = 0;

  int J1_LO_2 = 0;
  int J2_LO_2 = 0;
  int J3_LO_2 = 0;
  int J4_LO_2 = 0;
  int J5_LO_2 = 0;
  int J6_LO_2 = 0;
  int TR_LO_2 = 0;

  //reset
  int J1cur = 0;
  int J2cur = 0;
  int J3cur = 0;
  int J4cur = 0;
  int J5cur = 0;
  int J6cur = 0;
  int TRcur = 0;

  int J1_PEcur = 0;
  int J2_PEcur = 0;
  int J3_PEcur = 0;
  int J4_PEcur = 0;
  int J5_PEcur = 0;
  int J6_PEcur = 0;
  int TR_PEcur = 0;

  int J1_SE_1cur = 0;
  int J2_SE_1cur = 0;
  int J3_SE_1cur = 0;
  int J4_SE_1cur = 0;
  int J5_SE_1cur = 0;
  int J6_SE_1cur = 0;
  int TR_SE_1cur = 0;

  int J1_SE_2cur = 0;
  int J2_SE_2cur = 0;
  int J3_SE_2cur = 0;
  int J4_SE_2cur = 0;
  int J5_SE_2cur = 0;
  int J6_SE_2cur = 0;
  int TR_SE_2cur = 0;

  int highStepCur = 0;
  float curDelay = 0;


  //SET DIRECTIONS

  /////// J1 /////////
  if (J1dir == 1 && J1rotdir == 1)
  {
    digitalWrite(J1dirPin, LOW);
  }
  else if (J1dir == 1 && J1rotdir == 0)
  {
    digitalWrite(J1dirPin, HIGH);
  }
  else if (J1dir == 0 && J1rotdir == 1)
  {
    digitalWrite(J1dirPin, HIGH);
  }
  else if (J1dir == 0 && J1rotdir == 0)
  {
    digitalWrite(J1dirPin, LOW);
  }

  /////// J2 /////////
  if (J2dir == 1 && J2rotdir == 1)
  {
    digitalWrite(J2dirPin, LOW);
  }
  else if (J2dir == 1 && J2rotdir == 0)
  {
    digitalWrite(J2dirPin, HIGH);
  }
  else if (J2dir == 0 && J2rotdir == 1)
  {
    digitalWrite(J2dirPin, HIGH);
  }
  else if (J2dir == 0 && J2rotdir == 0)
  {
    digitalWrite(J2dirPin, LOW);
  }

  /////// J3 /////////
  if (J3dir == 1 && J3rotdir == 1)
  {
    digitalWrite(J3dirPin, LOW);
  }
  else if (J3dir == 1 && J3rotdir == 0)
  {
    digitalWrite(J3dirPin, HIGH);
  }
  else if (J3dir == 0 && J3rotdir == 1)
  {
    digitalWrite(J3dirPin, HIGH);
  }
  else if (J3dir == 0 && J3rotdir == 0)
  {
    digitalWrite(J3dirPin, LOW);
  }

  /////// J4 /////////
  if (J4dir == 1 && J4rotdir == 1)
  {
    digitalWrite(J4dirPin, LOW);
  }
  else if (J4dir == 1 && J4rotdir == 0)
  {
    digitalWrite(J4dirPin, HIGH);
  }
  else if (J4dir == 0 && J4rotdir == 1)
  {
    digitalWrite(J4dirPin, HIGH);
  }
  else if (J4dir == 0 && J4rotdir == 0)
  {
    digitalWrite(J4dirPin, LOW);
  }

  /////// J5 /////////
  if (J5dir == 1 && J5rotdir == 1)
  {
    digitalWrite(J5dirPin, LOW);
  }
  else if (J5dir == 1 && J5rotdir == 0)
  {
    digitalWrite(J5dirPin, HIGH);
  }
  else if (J5dir == 0 && J5rotdir == 1)
  {
    digitalWrite(J5dirPin, HIGH);
  }
  else if (J5dir == 0 && J5rotdir == 0)
  {
    digitalWrite(J5dirPin, LOW);
  }

  /////// J6 /////////
  if (J6dir == 1 && J6rotdir == 1)
  {
    digitalWrite(J6dirPin, LOW);
  }
  else if (J6dir == 1 && J6rotdir == 0)
  {
    digitalWrite(J6dirPin, HIGH);
  }
  else if (J6dir == 0 && J6rotdir == 1)
  {
    digitalWrite(J6dirPin, HIGH);
  }
  else if (J6dir == 0 && J6rotdir == 0)
  {
    digitalWrite(J6dirPin, LOW);
  }

  /////// TRACK /////////
  if (TRdir == 1 && TRACKrotdir == 1)
  {
    digitalWrite(TRdirPin, LOW);
  }
  else if (TRdir == 1 && TRACKrotdir == 0)
  {
    digitalWrite(TRdirPin, HIGH);
  }
  else if (TRdir == 0 && TRACKrotdir == 1)
  {
    digitalWrite(TRdirPin, HIGH);
  }
  else if (TRdir == 0 && TRACKrotdir == 0)
  {
    digitalWrite(TRdirPin, LOW);
  }



  /////CALC SPEEDS//////
  float ACCStep = (HighStep * (ACCdur / 100));
  float DCCStep = HighStep - (HighStep * (DCCdur / 100));
  float AdjSpeed = (SpeedIn / 100);
  //REG SPEED
  float CalcRegSpeed = (SpeedMult / AdjSpeed);
  int REGSpeed = int(CalcRegSpeed);

  //ACC SPEED
  float ACCspdT = (ACCspd / 100);
  float CalcACCSpeed = ((SpeedMult + (SpeedMult / ACCspdT)) / AdjSpeed);
  float ACCSpeed = (CalcACCSpeed);
  float ACCinc = (REGSpeed - ACCSpeed) / ACCStep;

  //DCC SPEED
  float DCCspdT = (DCCspd / 100);
  float CalcDCCSpeed = ((SpeedMult + (SpeedMult / DCCspdT)) / AdjSpeed);
  float DCCSpeed = (CalcDCCSpeed);
  float DCCinc = (REGSpeed + DCCSpeed) / DCCStep;
  DCCSpeed = REGSpeed;




  ///// DRIVE MOTORS /////
  while (J1cur < J1step || J2cur < J2step || J3cur < J3step || J4cur < J4step || J5cur < J5step || J6cur < J6step || TRcur < TRstep)
  {

    ////DELAY CALC/////
    if (highStepCur <= ACCStep)
    {
      curDelay = (ACCSpeed / Jactive);
      ACCSpeed = ACCSpeed + ACCinc;
    }
    else if (highStepCur >= DCCStep)
    {
      curDelay = (DCCSpeed / Jactive);
      DCCSpeed = DCCSpeed + DCCinc;
    }
    else
    {
      curDelay = (REGSpeed / Jactive);
    }

    /////// J1 ////////////////////////////////
    ///find pulse every
    if (J1cur < J1step)
    {
      J1_PE = (HighStep / J1step);
      ///find left over 1
      J1_LO_1 = (HighStep - (J1step * J1_PE));
      ///find skip 1
      if (J1_LO_1 > 0)
      {
        J1_SE_1 = (HighStep / J1_LO_1);
      }
      else
      {
        J1_SE_1 = 0;
      }
      ///find left over 2
      if (J1_SE_1 > 0)
      {
        J1_LO_2 = HighStep - ((J1step * J1_PE) + ((J1step * J1_PE) / J1_SE_1));
      }
      else
      {
        J1_LO_2 = 0;
      }
      ///find skip 2
      if (J1_LO_2 > 0)
      {
        J1_SE_2 = (HighStep / J1_LO_2);
      }
      else
      {
        J1_SE_2 = 0;
      }
      /////////  J1  ///////////////
      if (J1_SE_2 == 0)
      {
        J1_SE_2cur = (J1_SE_2 + 1);
      }
      if (J1_SE_2cur != J1_SE_2)
      {
        J1_SE_2cur = ++J1_SE_2cur;
        if (J1_SE_1 == 0)
        {
          J1_SE_1cur = (J1_SE_1 + 1);
        }
        if (J1_SE_1cur != J1_SE_1)
        {
          J1_SE_1cur = ++J1_SE_1cur;
          J1_PEcur = ++J1_PEcur;
          if (J1_PEcur == J1_PE)
          {
            J1cur = ++J1cur;
            J1_PEcur = 0;
            digitalWrite(J1stepPin, LOW);
            delayMicroseconds(curDelay);
            digitalWrite(J1stepPin, HIGH);
          }
        }
        else
        {
          J1_SE_1cur = 0;
        }
      }
      else
      {
        J1_SE_2cur = 0;
      }
    }

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
            J6_PEcur = 0;
            digitalWrite(J6stepPin, LOW);
            delayMicroseconds(curDelay);
            digitalWrite(J6stepPin, HIGH);
          }
        }
        else
        {
          J6_SE_1cur = 0;
        }
      }
      else
      {
        J6_SE_2cur = 0;
      }
    }

    /////// TR ////////////////////////////////
    ///find pulse every
    if (TRcur < TRstep)
    {
      TR_PE = (HighStep / TRstep);
      ///find left over 1
      TR_LO_1 = (HighStep - (TRstep * TR_PE));
      ///find skip 1
      if (TR_LO_1 > 0)
      {
        TR_SE_1 = (HighStep / TR_LO_1);
      }
      else
      {
        TR_SE_1 = 0;
      }
      ///find left over 2
      if (TR_SE_1 > 0)
      {
        TR_LO_2 = HighStep - ((TRstep * TR_PE) + ((TRstep * TR_PE) / TR_SE_1));
      }
      else
      {
        TR_LO_2 = 0;
      }
      ///find skip 2
      if (TR_LO_2 > 0)
      {
        TR_SE_2 = (HighStep / TR_LO_2);
      }
      else
      {
        TR_SE_2 = 0;
      }
      /////////  TR  ///////////////
      if (TR_SE_2 == 0)
      {
        TR_SE_2cur = (TR_SE_2 + 1);
      }
      if (TR_SE_2cur != TR_SE_2)
      {
        TR_SE_2cur = ++TR_SE_2cur;
        if (TR_SE_1 == 0)
        {
          TR_SE_1cur = (TR_SE_1 + 1);
        }
        if (TR_SE_1cur != TR_SE_1)
        {
          TR_SE_1cur = ++TR_SE_1cur;
          TR_PEcur = ++TR_PEcur;
          if (TR_PEcur == TR_PE)
          {
            TRcur = ++TRcur;
            TR_PEcur = 0;
            digitalWrite(TRstepPin, LOW);
            delayMicroseconds(curDelay);
            digitalWrite(TRstepPin, HIGH);
          }
        }
        else
        {
          TR_SE_1cur = 0;
        }
      }
      else
      {
        TR_SE_2cur = 0;
      }
    }


    // inc cur step
    highStepCur = ++highStepCur;


  }
}

/////////////////////////////////////////////////////////////////////////////////////////////////////////////////////////////////////////////////////////////////////////////////////////////
//DRIVE MOTORS L
/////////////////////////////////////////////////////////////////////////////////////////////////////////////////////////////////////////////////////////////////////////////////////////////

void driveMotorsL(String inData) {
  int J1start = inData.indexOf('A');
  int J2start = inData.indexOf('B');
  int J3start = inData.indexOf('C');
  int J4start = inData.indexOf('D');
  int J5start = inData.indexOf('E');
  int J6start = inData.indexOf('F');
  int TRstart = inData.indexOf('T');
  int Adstart = inData.indexOf('G');
  int Asstart = inData.indexOf('H');
  int Ddstart = inData.indexOf('I');
  int Dsstart = inData.indexOf('K');
  int SPstart = inData.indexOf('S');
  int J1dir = inData.substring(J1start + 1, J1start + 2).toInt();
  int J2dir = inData.substring(J2start + 1, J2start + 2).toInt();
  int J3dir = inData.substring(J3start + 1, J3start + 2).toInt();
  int J4dir = inData.substring(J4start + 1, J4start + 2).toInt();
  int J5dir = inData.substring(J5start + 1, J5start + 2).toInt();
  int J6dir = inData.substring(J6start + 1, J6start + 2).toInt();
  int TRdir = inData.substring(TRstart + 1, TRstart + 2).toInt();
  int J1step = inData.substring(J1start + 2, J2start).toInt();
  int J2step = inData.substring(J2start + 2, J3start).toInt();
  int J3step = inData.substring(J3start + 2, J4start).toInt();
  int J4step = inData.substring(J4start + 2, J5start).toInt();
  int J5step = inData.substring(J5start + 2, J6start).toInt();
  int J6step = inData.substring(J6start + 2, TRstart).toInt();
  int TRstep = inData.substring(TRstart + 2, SPstart).toInt();
  float SpeedIn = inData.substring(SPstart + 1, Adstart).toFloat();
  float ACCdur = inData.substring(Adstart + 1, Asstart).toInt();
  float ACCspd = inData.substring(Asstart + 1, Ddstart).toInt();
  float DCCdur = inData.substring(Ddstart + 1, Dsstart).toInt();
  float DCCspd = inData.substring(Dsstart + 1).toInt();

  //reset
  int J1cur = 0;
  int J2cur = 0;
  int J3cur = 0;
  int J4cur = 0;
  int J5cur = 0;
  int J6cur = 0;
  int TRcur = 0;


  //SET DIRECTIONS

  /////// J1 /////////
  if (J1dir == 1 && J1rotdir == 1)
  {
    digitalWrite(J1dirPin, LOW);
  }
  else if (J1dir == 1 && J1rotdir == 0)
  {
    digitalWrite(J1dirPin, HIGH);
  }
  else if (J1dir == 0 && J1rotdir == 1)
  {
    digitalWrite(J1dirPin, HIGH);
  }
  else if (J1dir == 0 && J1rotdir == 0)
  {
    digitalWrite(J1dirPin, LOW);
  }

  /////// J2 /////////
  if (J2dir == 1 && J2rotdir == 1)
  {
    digitalWrite(J2dirPin, LOW);
  }
  else if (J2dir == 1 && J2rotdir == 0)
  {
    digitalWrite(J2dirPin, HIGH);
  }
  else if (J2dir == 0 && J2rotdir == 1)
  {
    digitalWrite(J2dirPin, HIGH);
  }
  else if (J2dir == 0 && J2rotdir == 0)
  {
    digitalWrite(J2dirPin, LOW);
  }

  /////// J3 /////////
  if (J3dir == 1 && J3rotdir == 1)
  {
    digitalWrite(J3dirPin, LOW);
  }
  else if (J3dir == 1 && J3rotdir == 0)
  {
    digitalWrite(J3dirPin, HIGH);
  }
  else if (J3dir == 0 && J3rotdir == 1)
  {
    digitalWrite(J3dirPin, HIGH);
  }
  else if (J3dir == 0 && J3rotdir == 0)
  {
    digitalWrite(J3dirPin, LOW);
  }

  /////// J4 /////////
  if (J4dir == 1 && J4rotdir == 1)
  {
    digitalWrite(J4dirPin, LOW);
  }
  else if (J4dir == 1 && J4rotdir == 0)
  {
    digitalWrite(J4dirPin, HIGH);
  }
  else if (J4dir == 0 && J4rotdir == 1)
  {
    digitalWrite(J4dirPin, HIGH);
  }
  else if (J4dir == 0 && J4rotdir == 0)
  {
    digitalWrite(J4dirPin, LOW);
  }

  /////// J5 /////////
  if (J5dir == 1 && J5rotdir == 1)
  {
    digitalWrite(J5dirPin, LOW);
  }
  else if (J5dir == 1 && J5rotdir == 0)
  {
    digitalWrite(J5dirPin, HIGH);
  }
  else if (J5dir == 0 && J5rotdir == 1)
  {
    digitalWrite(J5dirPin, HIGH);
  }
  else if (J5dir == 0 && J5rotdir == 0)
  {
    digitalWrite(J5dirPin, LOW);
  }

  /////// J6 /////////
  if (J6dir == 1 && J6rotdir == 1)
  {
    digitalWrite(J6dirPin, LOW);
  }
  else if (J6dir == 1 && J6rotdir == 0)
  {
    digitalWrite(J6dirPin, HIGH);
  }
  else if (J6dir == 0 && J6rotdir == 1)
  {
    digitalWrite(J6dirPin, HIGH);
  }
  else if (J6dir == 0 && J6rotdir == 0)
  {
    digitalWrite(J6dirPin, LOW);
  }

  /////// TRACK /////////
  if (TRdir == 1 && TRACKrotdir == 1)
  {
    digitalWrite(TRdirPin, LOW);
  }
  else if (TRdir == 1 && TRACKrotdir == 0)
  {
    digitalWrite(TRdirPin, HIGH);
  }
  else if (TRdir == 0 && TRACKrotdir == 1)
  {
    digitalWrite(TRdirPin, HIGH);
  }
  else if (TRdir == 0 && TRACKrotdir == 0)
  {
    digitalWrite(TRdirPin, LOW);
  }


  /////CALC SPEEDS//////
  float AdjSpeed = (SpeedIn / 100);
  //REG SPEED
  float LspeedAdj = 2;
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
  servo7.attach(A7);

  digitalWrite(Output38, HIGH);
  digitalWrite(Output39, HIGH);
  digitalWrite(Output40, HIGH);
  digitalWrite(Output41, HIGH);
  digitalWrite(Output42, HIGH);
  digitalWrite(Output43, HIGH);
  digitalWrite(Output44, HIGH);
  digitalWrite(Output45, HIGH);

  digitalWrite(TRstepPin, HIGH);
  digitalWrite(J1stepPin, HIGH);
  digitalWrite(J2stepPin, HIGH);
  digitalWrite(J3stepPin, HIGH);
  digitalWrite(J4stepPin, HIGH);
  digitalWrite(J5stepPin, HIGH);
  digitalWrite(J6stepPin, HIGH);

}


void loop() {

  //test led
  if (digitalRead(J1calPin) == HIGH || digitalRead(J2calPin) == HIGH || digitalRead(J3calPin) == HIGH || digitalRead(J4calPin) == HIGH || digitalRead(J5calPin) == HIGH || digitalRead(J6calPin) == HIGH)
  {
    digitalWrite(J6dirPin, HIGH);
  }
  else
  {
    digitalWrite(J6dirPin, LOW);
  }

  //start loop
  WayPtDel = 0;
  while (Serial.available() > 0 or WayPtDel == 1)
  {
    char recieved = Serial.read();
    inData += recieved;
    // Process message when new line character is recieved
    if (recieved == '\n')
    {
      String function = inData.substring(0, 2);


      //-----COMMAND TO MOVE SERVO---------------------------------------------------
      //-----------------------------------------------------------------------
      if (function == "SV")
      {
        int SVstart = inData.indexOf('V');
        int POSstart = inData.indexOf('P');
        int servoNum = inData.substring(SVstart + 1, POSstart).toInt();
        int servoPOS = inData.substring(POSstart + 1).toInt();
        if (servoNum == 0)
        {
          servo0.write(servoPOS);
        }
        if (servoNum == 1)
        {
          servo1.write(servoPOS);
        }
        if (servoNum == 2)
        {
          servo2.write(servoPOS);
        }
        if (servoNum == 3)
        {
          servo3.write(servoPOS);
        }
        if (servoNum == 4)
        {
          servo4.write(servoPOS);
        }
        if (servoNum == 5)
        {
          servo5.write(servoPOS);
        }
        if (servoNum == 6)
        {
          servo6.write(servoPOS);
        }
        if (servoNum == 7)
        {
          servo7.write(servoPOS);
        }
        Serial.print("Servo Done");
      }




      //-----COMMAND TO WAIT TIME---------------------------------------------------
      //-----------------------------------------------------------------------
      if (function == "WT")
      {
        int WTstart = inData.indexOf('S');
        float WaitTime = inData.substring(WTstart + 1).toFloat();
        int WaitTimeMS = WaitTime * 1000;
        delay(WaitTimeMS);
        Serial.print("Done");
      }

      //-----COMMAND IF INPUT THEN JUMP---------------------------------------------------
      //-----------------------------------------------------------------------
      if (function == "JF")
      {
        int IJstart = inData.indexOf('X');
        int IJTabstart = inData.indexOf('T');
        int IJInputNum = inData.substring(IJstart + 1, IJTabstart).toInt();
        if (digitalRead(IJInputNum) == HIGH)
        {
          Serial.print("T\r");
        }
        if (digitalRead(IJInputNum) == LOW)
        {
          Serial.print("F\r");
        }
      }
      //-----COMMAND SET OUTPUT ON---------------------------------------------------
      //-----------------------------------------------------------------------
      if (function == "ON")
      {
        int ONstart = inData.indexOf('X');
        int outputNum = inData.substring(ONstart + 1).toInt();
        digitalWrite(outputNum, HIGH);
        Serial.print("Done");
      }
      //-----COMMAND SET OUTPUT OFF---------------------------------------------------
      //-----------------------------------------------------------------------
      if (function == "OF")
      {
        int ONstart = inData.indexOf('X');
        int outputNum = inData.substring(ONstart + 1).toInt();
        digitalWrite(outputNum, LOW);
        Serial.print("Done");
      }
      //-----COMMAND TO WAIT INPUT ON---------------------------------------------------
      //-----------------------------------------------------------------------
      if (function == "WI")
      {
        int WIstart = inData.indexOf('N');
        int InputNum = inData.substring(WIstart + 1).toInt();
        while (digitalRead(InputNum) == LOW) {
          delay(100);
        }
        Serial.print("Done");
      }
      //-----COMMAND TO WAIT INPUT OFF---------------------------------------------------
      //-----------------------------------------------------------------------
      if (function == "WO")
      {
        int WIstart = inData.indexOf('N');
        int InputNum = inData.substring(WIstart + 1).toInt();

        //String InputStr =  String("Input" + InputNum);
        //uint8_t Input = atoi(InputStr.c_str ());
        while (digitalRead(InputNum) == HIGH) {
          delay(100);
        }
        Serial.print("Done");
      }
      //-----COMMAND ECHO TEST MESSAGE---------------------------------------------------
      //-----------------------------------------------------------------------
      if (function == "TM")
      {
        String echo = inData.substring(2);
        Serial.println(echo);
      }
      //-----COMMAND TO CALIBRATE---------------------------------------------------
      //-----------------------------------------------------------------------
      if (function == "LL")
      {
        int J1start = inData.indexOf('A');
        int J2start = inData.indexOf('B');
        int J3start = inData.indexOf('C');
        int J4start = inData.indexOf('D');
        int J5start = inData.indexOf('E');
        int J6start = inData.indexOf('F');
        int SPstart = inData.indexOf('S');
        ///
        int J1caldir = inData.substring(J1start + 1, J1start + 2).toInt();
        int J2caldir = inData.substring(J2start + 1, J2start + 2).toInt();
        int J3caldir = inData.substring(J3start + 1, J3start + 2).toInt();
        int J4caldir = inData.substring(J4start + 1, J4start + 2).toInt();
        int J5caldir = inData.substring(J5start + 1, J5start + 2).toInt();
        int J6caldir = inData.substring(J6start + 1, J6start + 2).toInt();
        ///
        int J1step = (inData.substring(J1start + 2, J2start).toInt());
        int J2step = (inData.substring(J2start + 2, J3start).toInt());
        int J3step = (inData.substring(J3start + 2, J4start).toInt());
        int J4step = (inData.substring(J4start + 2, J5start).toInt());
        int J5step = (inData.substring(J5start + 2, J6start).toInt());
        int J6step = (inData.substring(J6start + 2).toInt());
        ///
        float SpeedIn = inData.substring(SPstart + 1).toFloat();


        //RESET COUNTERS
        int J1done = 0;
        int J2done = 0;
        int J3done = 0;
        int J4done = 0;
        int J5done = 0;
        int J6done = 0;

        String J1calStat = "0";

        //SET DIRECTIONS
        // J1 //
        if (J1rotdir == 1 && J1caldir == 1) {
          digitalWrite(J1dirPin, LOW);
        }
        else if (J1rotdir == 0 && J1caldir == 1) {
          digitalWrite(J1dirPin, HIGH);
        }
        else if (J1rotdir == 1 && J1caldir == 0) {
          digitalWrite(J1dirPin, HIGH);
        }
        else if (J1rotdir == 0 && J1caldir == 0) {
          digitalWrite(J1dirPin, LOW);
        }

        // J2 //
        if (J2rotdir == 1 && J2caldir == 1) {
          digitalWrite(J2dirPin, LOW);
        }
        else if (J2rotdir == 0 && J2caldir == 1) {
          digitalWrite(J2dirPin, HIGH);
        }
        else if (J2rotdir == 1 && J2caldir == 0) {
          digitalWrite(J2dirPin, HIGH);
        }
        else if (J2rotdir == 0 && J2caldir == 0) {
          digitalWrite(J2dirPin, LOW);
        }

        // J3 //
        if (J3rotdir == 1 && J3caldir == 1) {
          digitalWrite(J3dirPin, LOW);
        }
        else if (J3rotdir == 0 && J3caldir == 1) {
          digitalWrite(J3dirPin, HIGH);
        }
        else if (J3rotdir == 1 && J3caldir == 0) {
          digitalWrite(J3dirPin, HIGH);
        }
        else if (J3rotdir == 0 && J3caldir == 0) {
          digitalWrite(J3dirPin, LOW);
        }

        // J4 //
        if (J4rotdir == 1 && J4caldir == 1) {
          digitalWrite(J4dirPin, LOW);
        }
        else if (J4rotdir == 0 && J4caldir == 1) {
          digitalWrite(J4dirPin, HIGH);
        }
        else if (J4rotdir == 1 && J4caldir == 0) {
          digitalWrite(J4dirPin, HIGH);
        }
        else if (J4rotdir == 0 && J4caldir == 0) {
          digitalWrite(J4dirPin, LOW);
        }

        // J5 //
        if (J5rotdir == 1 && J5caldir == 1) {
          digitalWrite(J5dirPin, LOW);
        }
        else if (J5rotdir == 0 && J5caldir == 1) {
          digitalWrite(J5dirPin, HIGH);
        }
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
      //-----------------------------------------------------------------------
      if (function == "MJ")
      {
        Serial.print("command recieved");
        driveMotorsJ(inData);
        inData = ""; // Clear recieved buffer
        ////////MOVE COMPLETE///////////
      }


      //----- MOVE L ---------------------------------------------------
      //-----------------------------------------------------------------------
      if (function == "ML")
      {
        WayPtDel = 1;
        int NumPtsStart = inData.indexOf('L');
        int WayPts = inData.substring(NumPtsStart + 1).toInt();
        Serial.print("num points recieved");
        inData = ""; // Clear recieved buffer
        //STORE WAYPOINTS
        int i = 0;
        while (i < WayPts) {
          while (Serial.available() > 0) {
            char recieved = Serial.read();
            inData += recieved;
            if (recieved == '\n') {
              inData.toCharArray(WayPt[i], 50);
              Serial.print(i);
              ++i;
              inData = ""; // Clear recieved buffer
            }
          }
        }
        Serial.print("waypts done");
        //EXECUTE WAYPOINTS
        i = 0;
        while (i < WayPts + 1) {
          inData = WayPt[i];
          driveMotorsL(inData);
          ++i;
        }
        WayPtDel = 0;
      }




      else
      {
        inData = ""; // Clear recieved buffer
      }
    }
  }
}
