Wang-Ruohan/RV3-2/CodeAR2/AR2 2.0 software source/AR2 2.0 software source files/AR2.py

############################################################################
## Version AR2.2.1 #########################################################
############################################################################
""" AR2 - Stepper motor robot control software
    Copyright (c) 2017, Chris Annin
    All rights reserved.

    You are free to share, copy and redistribute in any medium
    or format.  You are free to remix, transform and build upon
    this material.

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
    THIS SOFTWARE IS PROVIDED BY THE COPYRIGHT HOLDERS AND CONTRIBUTORS "AS IS" AND
    ANY EXPRESS OR IMPLIED WARRANTIES, INCLUDING, BUT NOT LIMITED TO, THE IMPLIED
    WARRANTIES OF MERCHANTABILITY AND FITNESS FOR A PARTICULAR PURPOSE ARE
    DISCLAIMED. IN NO EVENT SHALL CHRIS ANNIN BE LIABLE FOR ANY
    DIRECT, INDIRECT, INCIDENTAL, SPECIAL, EXEMPLARY, OR CONSEQUENTIAL DAMAGES
    (INCLUDING, BUT NOT LIMITED TO, PROCUREMENT OF SUBSTITUTE GOODS OR SERVICES;
    LOSS OF USE, DATA, OR PROFITS; OR BUSINESS INTERRUPTION) HOWEVER CAUSED AND
    ON ANY THEORY OF LIABILITY, WHETHER IN CONTRACT, STRICT LIABILITY, OR TORT
    (INCLUDING NEGLIGENCE OR OTHERWISE) ARISING IN ANY WAY OUT OF THE USE OF THIS
    SOFTWARE, EVEN IF ADVISED OF THE POSSIBILITY OF SUCH DAMAGE.

    chris.annin@gmail.com
"""
##########################################################################
### VERSION DOC ##########################################################
##########################################################################
''' 
**VERSION 2.1.1 CHANGES
CHANGED ALL DELAYS TO 0.05
ADDED CALIBRATE TO MID RANGE FUNCTION
REMOVED CALIBRATE WRITE FROM CALIBRATE ROUTINE - USES SavePosData
CHANGED E65 = TO J15
ajusted axis limits for DM542T
RE-WRITE OF MOVE SYNC ALGORITHM
**VERSION 2.1.4 CHANGES
POSITIONS BY CARTISIAN INSTEAD OF STEP COUNT
ADDED STORED POSITIONS
ADDED 7TH AXIS TRAVEL TRACK
ADDED BASIC VISION
CHANGED INCREMENT TO ++ AND DECREMENT TO --
**VERSION 2.1.5 CHANGES
CHANGES KINEMATICS FOR WRIST ORIENTATION J4-J6
SPEED UP CALIBRATION MOVE
**VERSION 2.2.0
UPDATED TO PYTHON 3.7
**version 2.2.1 added support for kinematics a3 offset
'''
##########################################################################
##########################################################################


from tkinter import *
import tkinter.ttk
import pickle
import serial
import time
import threading
import queue
import math
import tkinter.messagebox
import webbrowser
import numpy as np


root = Tk()
root.wm_title("AR2 software 2.0")
root.iconbitmap(r'AR2.ico')
root.resizable(width=True, height=True)
root.geometry('1360x720+0+0')
root.runTrue = 0

global JogStepsStat
JogStepsStat = IntVar()
global xboxUse

############################################################################
### DEFINE TABS ############################################################
############################################################################

nb = tkinter.ttk.Notebook(root, width=1360, height=700)
nb.place(x=0, y=0)

tab1 = tkinter.ttk.Frame(nb)
nb.add(tab1, text=' Main Controls ')

tab2 = tkinter.ttk.Frame(nb)
nb.add(tab2, text='  Calibration  ')

tab3 = tkinter.ttk.Frame(nb)
nb.add(tab3, text=' Inputs Outputs ')

tab4 = tkinter.ttk.Frame(nb)
nb.add(tab4, text='   Registers    ')

tab5 = tkinter.ttk.Frame(nb)
nb.add(tab5, text='   Vision    ')

tab6 = tkinter.ttk.Frame(nb)
#nb.add(tab6, text='   Testing    ')

tab7 = tkinter.ttk.Frame(nb)
nb.add(tab7, text='   Info    ')



###############################################################################################################################################################
### COMMUNICATION DEFS ################################################################################################################# COMMUNICATION DEFS ###
###############################################################################################################################################################

def setCom():
  global ser  
  port = "COM" + comPortEntryField.get()  
  baud = 115200    
  ser = serial.Serial(port,baud)




###############################################################################################################################################################  
### EXECUTION DEFS ######################################################################################################################### EXECUTION DEFS ###  
############################################################################################################################################################### 

def runProg():
  def threadProg():
    global rowinproc
    try:
      curRow = tab1.progView.curselection()[0]
      if (curRow == 0):
        curRow=1
    except:
      curRow=1
      tab1.progView.selection_clear(0, END)
      tab1.progView.select_set(curRow)
    tab1.runTrue = 1
    while tab1.runTrue == 1:
      if (tab1.runTrue == 0):
        runStatusLab.config(text='PROGRAM STOPPED', bg = "red")
      else:
        runStatusLab.config(text='PROGRAM RUNNING', bg = "green")
      rowinproc = 1
      executeRow()
      while rowinproc == 1:
        time.sleep(0)	  
      selRow = tab1.progView.curselection()[0]
      last = tab1.progView.index('end')
      for row in range (0,selRow):
        tab1.progView.itemconfig(row, {'fg': 'dodger blue'})
      tab1.progView.itemconfig(selRow, {'fg': 'blue2'})
      for row in range (selRow+1,last):
        tab1.progView.itemconfig(row, {'fg': 'black'})
      tab1.progView.selection_clear(0, END)
      selRow += 1
      tab1.progView.select_set(selRow)
      curRow += 1
      time.sleep(0)
      try:
        selRow = tab1.progView.curselection()[0]
        curRowEntryField.delete(0, 'end')
        curRowEntryField.insert(0,selRow)
      except:
        curRowEntryField.delete(0, 'end')
        curRowEntryField.insert(0,"---") 
        tab1.runTrue = 0
        runStatusLab.config(text='PROGRAM STOPPED', bg = "red")
  t = threading.Thread(target=threadProg)
  t.start()
  
def stepFwd():
    executeRow() 
    selRow = tab1.progView.curselection()[0]
    last = tab1.progView.index('end')
    for row in range (0,selRow):
      tab1.progView.itemconfig(row, {'fg': 'dodger blue'})
    tab1.progView.itemconfig(selRow, {'fg': 'blue2'})
    for row in range (selRow+1,last):
      tab1.progView.itemconfig(row, {'fg': 'black'})
    tab1.progView.selection_clear(0, END)
    selRow += 1
    tab1.progView.select_set(selRow)
    time.sleep(.2)
    try:
      selRow = tab1.progView.curselection()[0]
      curRowEntryField.delete(0, 'end')
      curRowEntryField.insert(0,selRow)
    except:
      curRowEntryField.delete(0, 'end')
      curRowEntryField.insert(0,"---")
 
def stepRev():
    executeRow()  
    selRow = tab1.progView.curselection()[0]
    last = tab1.progView.index('end')
    for row in range (0,selRow):
      tab1.progView.itemconfig(row, {'fg': 'black'})
    tab1.progView.itemconfig(selRow, {'fg': 'red'})
    for row in range (selRow+1,last):
      tab1.progView.itemconfig(row, {'fg': 'tomato2'})
    tab1.progView.selection_clear(0, END)
    selRow -= 1
    tab1.progView.select_set(selRow)
    time.sleep(.2)
    try:
      selRow = tab1.progView.curselection()[0]
      curRowEntryField.delete(0, 'end')
      curRowEntryField.insert(0,selRow)
    except:
      curRowEntryField.delete(0, 'end')
      curRowEntryField.insert(0,"---")  
    
def stopProg():
  lastProg = ""
  tab1.runTrue = 0 
  if (tab1.runTrue == 0):
    runStatusLab.config(text='PROGRAM STOPPED', bg = "red")
  else:
    runStatusLab.config(text='PROGRAM RUNNING', bg = "green")  
  
def executeRow():
  global J1AngCur
  global J2AngCur
  global J3AngCur
  global J4AngCur
  global J5AngCur
  global J6AngCur
  global J1StepCur
  global J2StepCur
  global J3StepCur
  global J4StepCur
  global J5StepCur
  global J6StepCur
  global calStat
  global rowinproc
  global LineDist
  global Xv
  global Yv
  global Zv
  global commandCalc
  selRow = tab1.progView.curselection()[0]
  tab1.progView.see(selRow+2)
  data = list(map(int, tab1.progView.curselection()))
  command=tab1.progView.get(data[0])
  cmdType=command[:6]
  #manEntryField.delete(0, 'end')
  #manEntryField.insert(0,cmdType)
  ##Call Program##
  if (cmdType == "Call P"):
    tab1.lastRow = tab1.progView.curselection()[0]
    tab1.lastProg = ProgEntryField.get()
    programIndex = command.find("Program -")
    progNum = str(command[programIndex+10:])
    ProgEntryField.delete(0, 'end')
    ProgEntryField.insert(0,progNum)
    loadProg()
    time.sleep(.4) 
    index = 0
    tab1.progView.selection_clear(0, END)
    tab1.progView.select_set(index) 
  ##Return Program##
  if (cmdType == "Return"):
    lastRow = tab1.lastRow
    lastProg = tab1.lastProg
    ProgEntryField.delete(0, 'end')
    ProgEntryField.insert(0,lastProg)
    loadProg()
    time.sleep(.4) 
    index = 0
    tab1.progView.selection_clear(0, END)
    tab1.progView.select_set(lastRow)  
  ##Servo Command##
  if (cmdType == "Servo "):
    servoIndex = command.find("number ")
    posIndex = command.find("position: ")
    servoNum = str(command[servoIndex+7:posIndex-4])
    servoPos = str(command[posIndex+10:])
    command = "SV"+servoNum+"P"+servoPos+"\n"
    ser.write(command.encode())
    ser.flushInput()
    time.sleep(.2)
    ser.read() 
  ##If Input On Jump to Tab##
  if (cmdType == "If On "):
    inputIndex = command.find("Input-")
    tabIndex = command.find("Tab-")
    inputNum = str(command[inputIndex+6:tabIndex-9])
    tabNum = str(command[tabIndex+4:])
    command = "JFX"+inputNum+"T"+tabNum+"\n"   
    ser.write(command.encode())
    ser.flushInput()
    time.sleep(.2)
    value = ser.readline()
    if (value == b'T'):
      index = tab1.progView.get(0, "end").index("Tab Number " + tabNum)
      index = index-1
      tab1.progView.selection_clear(0, END)
      tab1.progView.select_set(index)
  ##If Input Off Jump to Tab##
  if (cmdType == "If Off"):
    inputIndex = command.find("Input-")
    tabIndex = command.find("Tab-")
    inputNum = str(command[inputIndex+6:tabIndex-9])
    tabNum = str(command[tabIndex+4:])
    command = "JFX"+inputNum+"T"+tabNum+"\n"   
    ser.write(command.encode())
    ser.flushInput()
    time.sleep(.2)
    value = ser.readline()
    if (value == b'F'):
      index = tab1.progView.get(0, "end").index("Tab Number " + tabNum)
      index = index-1
      tab1.progView.selection_clear(0, END)
      tab1.progView.select_set(index)
  ##Jump to Row##
  if (cmdType == "Jump T"):
    tabIndex = command.find("Tab-")
    tabNum = str(command[tabIndex+4:])
    index = tab1.progView.get(0, "end").index("Tab Number " + tabNum)
    tab1.progView.selection_clear(0, END)
    tab1.progView.select_set(index)  
  ##Set Output ON Command##
  if (cmdType == "Out On"):
    outputIndex = command.find("Out On = ")
    outputNum = str(command[outputIndex+9:])
    command = "ONX"+outputNum+"\n"
    ser.write(command.encode())
    ser.flushInput()
    time.sleep(.2)
    ser.read() 
  ##Set Output OFF Command##
  if (cmdType == "Out Of"):
    outputIndex = command.find("Out Off = ")
    outputNum = str(command[outputIndex+10:])
    command = "OFX"+outputNum+"\n"
    ser.write(command.encode())
    ser.flushInput()
    time.sleep(.2)
    ser.read() 
  ##Wait Input ON Command##
  if (cmdType == "Wait I"):
    inputIndex = command.find("Wait Input On = ")
    inputNum = str(command[inputIndex+16:])
    command = "WIN"+inputNum+"\n"
    ser.write(command.encode())
    ser.flushInput()
    time.sleep(.2)
    ser.read() 
  ##Wait Input OFF Command##
  if (cmdType == "Wait O"):
    inputIndex = command.find("Wait Off Input = ")
    inputNum = str(command[inputIndex+17:])
    command = "WON"+inputNum+"\n"
    ser.write(command.encode())
    ser.flushInput()
    time.sleep(.2)
    ser.read() 
  ##Wait Time Command##
  if (cmdType == "Wait T"):
    timeIndex = command.find("Wait Time = ")
    timeSeconds = str(command[timeIndex+12:])
    command = "WTS"+timeSeconds+"\n"
    ser.write(command.encode())
    ser.flushInput()
    time.sleep(.2)
    ser.read() 
  ##Set Register##  
  if (cmdType == "Regist"):
    regNumIndex = command.find("Register ")
    regEqIndex = command.find(" = ")
    regNumVal = str(command[regNumIndex+9:regEqIndex])
    regEntry = "R"+regNumVal+"EntryField"
    testOper = str(command[regEqIndex+3:regEqIndex+5])
    if (testOper == "++"):
      regCEqVal = str(command[regEqIndex+5:])
      curRegVal = eval(regEntry).get()
      regEqVal = str(int(regCEqVal)+int(curRegVal))      
    elif (testOper == "--"):
      regCEqVal = str(command[regEqIndex+5:])
      curRegVal = eval(regEntry).get()
      regEqVal = str(int(curRegVal)-int(regCEqVal))
    else:
      regEqVal = str(command[regEqIndex+3:])    
    eval(regEntry).delete(0, 'end')
    eval(regEntry).insert(0,regEqVal)
  ##Set Stor Position##  
  if (cmdType == "Store "):
    regNumIndex = command.find("Store Position ")
    regElIndex = command.find("Element")
    regEqIndex = command.find(" = ")
    regNumVal = str(command[regNumIndex+15:regElIndex-1])
    regNumEl = str(command[regElIndex+8:regEqIndex])
    regEntry = "SP_"+regNumVal+"_E"+regNumEl+"_EntryField"
    testOper = str(command[regEqIndex+3:regEqIndex+5])
    if (testOper == "++"):
      regCEqVal = str(command[regEqIndex+4:])
      curRegVal = eval(regEntry).get()
      regEqVal = str(float(regCEqVal)+float(curRegVal))      
    elif (testOper == "--"):
      regCEqVal = str(command[regEqIndex+5:])
      curRegVal = eval(regEntry).get()
      regEqVal = str(float(curRegVal)-float(regCEqVal))
    else:
      regEqVal = str(command[regEqIndex+3:])    
    eval(regEntry).delete(0, 'end')
    eval(regEntry).insert(0,regEqVal)
  ## Get Vision ##
  if (cmdType == "Get Vi"):
    testvis()	
  ##If Register Jump to Row##
  if (cmdType == "If Reg"):
    regIndex = command.find("If Register ")
    regEqIndex = command.find(" = ")
    regJmpIndex = command.find(" Jump to Tab ")    
    regNum = str(command[regIndex+12:regEqIndex])
    regEq = str(command[regEqIndex+3:regJmpIndex])
    tabNum = str(command[regJmpIndex+13:])
    regEntry = "R"+regNum+"EntryField"
    curRegVal = eval(regEntry).get()
    if (curRegVal == regEq):
      index = tab1.progView.get(0, "end").index("Tab Number " + tabNum)
      tab1.progView.selection_clear(0, END)
      tab1.progView.select_set(index)  
  ##Calibrate Command##   
  if (cmdType == "Calibr"):
    calRobotAll()
    if (calStat == 0):
      stopProg()
  ##Move J Command##  
  if (cmdType == "Move J"):  
    J1newIndex = command.find("X) ")
    J2newIndex = command.find("Y) ")
    J3newIndex = command.find("Z) ")
    J4newIndex = command.find("W) ")
    J5newIndex = command.find("P) ")
    J6newIndex = command.find("R) ")
    TRnewIndex = command.find("T) ")	
    SpeedIndex = command.find("Speed-")
    ACCdurIndex = command.find("Ad")
    ACCspdIndex = command.find("As")
    DECdurIndex = command.find("Dd")
    DECspdIndex = command.find("Ds")
    WristConfIndex = command.find("$")
    CX = float(command[J1newIndex+3:J2newIndex-1])
    CY = float(command[J2newIndex+3:J3newIndex-1])
    CZ = float(command[J3newIndex+3:J4newIndex-1])
    CRx = float(command[J4newIndex+3:J5newIndex-1])
    CRy = float(command[J5newIndex+3:J6newIndex-1])
    CRz = float(command[J6newIndex+3:TRnewIndex-1])
    Track = float(command[TRnewIndex+3:SpeedIndex-1])
    newSpeed = str(command[SpeedIndex+6:ACCdurIndex-1])
    ACCdur = command[ACCdurIndex+3:ACCspdIndex-1]
    ACCspd = command[ACCspdIndex+3:DECdurIndex-1]
    DECdur = command[DECdurIndex+3:DECspdIndex-1]
    DECspd = command[DECspdIndex+3:WristConfIndex-1]
    WC = command[WristConfIndex+1:]
    TCX = 0
    TCY = 0 
    TCZ = 0
    TCRx = 0
    TCRy = 0
    TCRz = 0
    Code = 0	
    MoveXYZ(CX,CY,CZ,CRx,CRy,CRz,newSpeed,ACCdur,ACCspd,DECdur,DECspd,WC,TCX,TCY,TCZ,TCRx,TCRy,TCRz,Track,Code)
  ##Offs J Command##  
  if (cmdType == "OFFS J"): 
    SPnewInex = command.find("[SP:")  
    SPendInex = command.find("] [")
    J1newIndex = command.find("X) ")
    J2newIndex = command.find("Y) ")
    J3newIndex = command.find("Z) ")
    J4newIndex = command.find("W) ")
    J5newIndex = command.find("P) ")
    J6newIndex = command.find("R) ")
    TRnewIndex = command.find("T) ")	
    SpeedIndex = command.find("Speed-")
    ACCdurIndex = command.find("Ad")
    ACCspdIndex = command.find("As")
    DECdurIndex = command.find("Dd")
    DECspdIndex = command.find("Ds")
    WristConfIndex = command.find("$")
    SP = str(command[SPnewInex+4:SPendInex])
    CXa = eval("SP_"+SP+"_E1_EntryField").get()
    CYa = eval("SP_"+SP+"_E2_EntryField").get()
    CZa = eval("SP_"+SP+"_E3_EntryField").get()
    CRxa = eval("SP_"+SP+"_E4_EntryField").get()
    CRya = eval("SP_"+SP+"_E5_EntryField").get()
    CRza = eval("SP_"+SP+"_E6_EntryField").get()
    CX = float(CXa) + float(command[J1newIndex+3:J2newIndex-1])
    CY = float(CYa) + float(command[J2newIndex+3:J3newIndex-1])
    CZ = float(CZa) + float(command[J3newIndex+3:J4newIndex-1])
    CRx = float(CRxa) + float(command[J4newIndex+3:J5newIndex-1])
    CRy = float(CRya) + float(command[J5newIndex+3:J6newIndex-1])
    CRz = float(CRza) + float(command[J6newIndex+3:TRnewIndex-1])
    Track = float(command[TRnewIndex+3:SpeedIndex-1])
    newSpeed = str(command[SpeedIndex+6:ACCdurIndex-1])
    ACCdur = command[ACCdurIndex+3:ACCspdIndex-1]
    ACCspd = command[ACCspdIndex+3:DECdurIndex-1]
    DECdur = command[DECdurIndex+3:DECspdIndex-1]
    DECspd = command[DECspdIndex+3:WristConfIndex-1]
    WC = command[WristConfIndex+1:]
    TCX = 0
    TCY = 0 
    TCZ = 0
    TCRx = 0
    TCRy = 0
    TCRz = 0
    Code = 0	
    MoveXYZ(CX,CY,CZ,CRx,CRy,CRz,newSpeed,ACCdur,ACCspd,DECdur,DECspd,WC,TCX,TCY,TCZ,TCRx,TCRy,TCRz,Track,Code)   
  ##Move SP Command##  
  if (cmdType == "Move S"): 
    SPnewInex = command.find("[SP:")  
    SPendInex = command.find("] [")
    TRnewIndex = command.find("T) ")	
    SpeedIndex = command.find("Speed-")
    ACCdurIndex = command.find("Ad")
    ACCspdIndex = command.find("As")
    DECdurIndex = command.find("Dd")
    DECspdIndex = command.find("Ds")
    WristConfIndex = command.find("$")
    SP = str(command[SPnewInex+4:SPendInex])
    CX = float(eval("SP_"+SP+"_E1_EntryField").get())
    CY = float(eval("SP_"+SP+"_E2_EntryField").get())
    CZ = float(eval("SP_"+SP+"_E3_EntryField").get())
    CRx = float(eval("SP_"+SP+"_E4_EntryField").get())
    CRy = float(eval("SP_"+SP+"_E5_EntryField").get())
    CRz = float(eval("SP_"+SP+"_E6_EntryField").get())
    Track = float(command[TRnewIndex+3:SpeedIndex-1])
    newSpeed = str(command[SpeedIndex+6:ACCdurIndex-1])
    ACCdur = command[ACCdurIndex+3:ACCspdIndex-1]
    ACCspd = command[ACCspdIndex+3:DECdurIndex-1]
    DECdur = command[DECdurIndex+3:DECspdIndex-1]
    DECspd = command[DECspdIndex+3:WristConfIndex-1]
    WC = command[WristConfIndex+1:]
    TCX = 0
    TCY = 0 
    TCZ = 0
    TCRx = 0
    TCRy = 0
    TCRz = 0
    Code = 0	
    MoveXYZ(CX,CY,CZ,CRx,CRy,CRz,newSpeed,ACCdur,ACCspd,DECdur,DECspd,WC,TCX,TCY,TCZ,TCRx,TCRy,TCRz,Track,Code)
  ##OFFS SP Command##  
  if (cmdType == "OFFS S"): 
    SPnewInex = command.find("[SP:")  
    SPendInex = command.find("] offs")
    SP2newInex = command.find("[*SP:")  
    SP2endInex = command.find("]  [")
    TRnewIndex = command.find("T) ")	
    SpeedIndex = command.find("Speed-")
    ACCdurIndex = command.find("Ad")
    ACCspdIndex = command.find("As")
    DECdurIndex = command.find("Dd")
    DECspdIndex = command.find("Ds")
    WristConfIndex = command.find("$")
    SP = str(command[SPnewInex+4:SPendInex])
    SP2 = str(command[SP2newInex+5:SP2endInex])
    CX = float(eval("SP_"+SP+"_E1_EntryField").get()) + float(eval("SP_"+SP2+"_E1_EntryField").get())
    CY = float(eval("SP_"+SP+"_E2_EntryField").get()) + float(eval("SP_"+SP2+"_E2_EntryField").get())
    CZ = float(eval("SP_"+SP+"_E3_EntryField").get()) + float(eval("SP_"+SP2+"_E3_EntryField").get())
    CRx = float(eval("SP_"+SP+"_E4_EntryField").get()) + float(eval("SP_"+SP2+"_E4_EntryField").get())
    CRy = float(eval("SP_"+SP+"_E5_EntryField").get()) + float(eval("SP_"+SP2+"_E5_EntryField").get())
    CRz = float(eval("SP_"+SP+"_E6_EntryField").get()) + float(eval("SP_"+SP2+"_E6_EntryField").get())	
    Track = float(command[TRnewIndex+3:SpeedIndex-1])
    newSpeed = str(command[SpeedIndex+6:ACCdurIndex-1])
    ACCdur = command[ACCdurIndex+3:ACCspdIndex-1]
    ACCspd = command[ACCspdIndex+3:DECdurIndex-1]
    DECdur = command[DECdurIndex+3:DECspdIndex-1]
    DECspd = command[DECspdIndex+3:WristConfIndex-1]
    WC = command[WristConfIndex+1:]
    TCX = 0
    TCY = 0 
    TCZ = 0
    TCRx = 0
    TCRy = 0
    TCRz = 0
    Code = 0	
    MoveXYZ(CX,CY,CZ,CRx,CRy,CRz,newSpeed,ACCdur,ACCspd,DECdur,DECspd,WC,TCX,TCY,TCZ,TCRx,TCRy,TCRz,Track,Code)
  ##Move L Command##  
  if (cmdType == "Move L"):  
    J1newIndex = command.find("X) ")
    J2newIndex = command.find("Y) ")
    J3newIndex = command.find("Z) ")
    J4newIndex = command.find("W) ")
    J5newIndex = command.find("P) ")
    J6newIndex = command.find("R) ")
    TRnewIndex = command.find("T) ")	
    SpeedIndex = command.find("Speed-")
    ACCdurIndex = command.find("Ad")
    ACCspdIndex = command.find("As")
    DECdurIndex = command.find("Dd")
    DECspdIndex = command.find("Ds")
    WristConfIndex = command.find("$")
    CX = float(command[J1newIndex+3:J2newIndex-1])
    CY = float(command[J2newIndex+3:J3newIndex-1])
    CZ = float(command[J3newIndex+3:J4newIndex-1])
    CRx = float(command[J4newIndex+3:J5newIndex-1])
    CRy = float(command[J5newIndex+3:J6newIndex-1])
    CRz = float(command[J6newIndex+3:TRnewIndex-1])
    Track = float(command[TRnewIndex+3:SpeedIndex-1])
    newSpeed = str(command[SpeedIndex+6:ACCdurIndex-1])
    ACCdur = command[ACCdurIndex+3:ACCspdIndex-1]
    ACCspd = command[ACCspdIndex+3:DECdurIndex-1]
    DECdur = command[DECdurIndex+3:DECspdIndex-1]
    DECspd = command[DECspdIndex+3:WristConfIndex-1]
    WC = command[WristConfIndex+1:]
    TCX = 0
    TCY = 0 
    TCZ = 0
    TCRx = 0
    TCRy = 0
    TCRz = 0 
    CalcLinDist(CX,CY,CZ)
    CalcLinVect(CX,CY,CZ)
    numWayPts = 100
    Xstart = XcurPos
    Ystart = YcurPos
    Zstart = ZcurPos
    Rxstart = RxcurPos
    Rystart = RycurPos
    Rzstart = RzcurPos
    ## SPEEDS
    ACCpts = numWayPts * (int(ACCdur)/100)
    ACCpctInc = 100 / int(ACCpts)
    numDECpts = (numWayPts * (int(DECdur)/100))
    DECpts = numWayPts - numDECpts
    DECpctInc = 100 / int(numDECpts)
    minACC = int(newSpeed)*(int(ACCspd)/100)
    minDEC = int(newSpeed)*(int(DECspd)/100)
    lACCspd = "100"
    lDECspd = "100"
    lACCdur = "0"
    lDECdur = "0"     
    ##GENERATE WAYPOINTS CMD	
    WayPtsCMD = "ML"+str(numWayPts)
    ser.write(WayPtsCMD.encode())
    ser.flushInput()
    time.sleep(.01)
    for i in range(numWayPts+1):
      curWayDis = (1 / numWayPts) * i
      lCX = Xstart + (Xv * curWayDis)
      lCY = Ystart + (Yv * curWayDis)
      lCZ = Zstart + (Zv * curWayDis)
      if i < ACCpts:
        tempSpeed = str(round(((i * (ACCpctInc/100))*int(newSpeed)),2))
        if float(tempSpeed) < minACC:
          tempSpeed = str(round(minACC,2))
      elif i > DECpts:
        tempSpeed = str(round((((numWayPts - i) * (DECpctInc/100))*int(newSpeed)),2))
        if float(tempSpeed) < minDEC:
          tempSpeed = str(round(minDEC,2))
      else:
        tempSpeed = newSpeed
      #manEntryField.insert(0,tempSpeed+"   ")
      Code = 2
      MoveXYZ(lCX,lCY,lCZ,CRx,CRy,CRz,tempSpeed,ACCdur,lACCspd,DECdur,lDECspd,WC,TCX,TCY,TCZ,TCRx,TCRy,TCRz,Track,Code)
      ser.write(commandCalc.encode())  
      ser.flushInput()
      #time.sleep(.01)
      ser.read()
  ##Move A Command##  
  if (cmdType == "Move A"):
    subCmd=command[:10]
    if (subCmd == "Move A Mid" or subCmd == "Move A End"):
      almStatusLab.config(text="Move A must start with a Beg followed by Mid & End", bg = "red")
      almStatusLab2.config(text="Move A must start with a Beg followed by Mid & End", bg = "red")
    J1newIndex = command.find("X) ")
    J2newIndex = command.find("Y) ")
    J3newIndex = command.find("Z) ")
    J4newIndex = command.find("W) ")
    J5newIndex = command.find("P) ")
    J6newIndex = command.find("R) ")
    TRnewIndex = command.find("T) ")	
    SpeedIndex = command.find("Speed-")
    ACCdurIndex = command.find("Ad")
    ACCspdIndex = command.find("As")
    DECdurIndex = command.find("Dd")
    DECspdIndex = command.find("Ds")
    WristConfIndex = command.find("$")
    CXbeg = float(command[J1newIndex+3:J2newIndex-1])
    CYbeg = float(command[J2newIndex+3:J3newIndex-1])
    CZbeg = float(command[J3newIndex+3:J4newIndex-1])
    CRx = float(command[J4newIndex+3:J5newIndex-1])
    CRy = float(command[J5newIndex+3:J6newIndex-1])
    CRz = float(command[J6newIndex+3:TRnewIndex-1])
    Track = float(command[TRnewIndex+3:SpeedIndex-1])
    newSpeed = str(command[SpeedIndex+6:ACCdurIndex-1])
    ACCdur = command[ACCdurIndex+3:ACCspdIndex-1]
    ACCspd = command[ACCspdIndex+3:DECdurIndex-1]
    DECdur = command[DECdurIndex+3:DECspdIndex-1]
    DECspd = command[DECspdIndex+3:WristConfIndex-1]
    WC = command[WristConfIndex+1:]
    TCX = 0
    TCY = 0 
    TCZ = 0
    TCRx = 0
    TCRy = 0
    TCRz = 0
    ##read next row for Mid position	
    curRow = tab1.progView.curselection()[0]
    selRow = tab1.progView.curselection()[0]
    last = tab1.progView.index('end')
    for row in range (0,selRow):
      tab1.progView.itemconfig(row, {'fg': 'dodger blue'})
    tab1.progView.itemconfig(selRow, {'fg': 'blue2'})
    for row in range (selRow+1,last):
      tab1.progView.itemconfig(row, {'fg': 'black'})
    tab1.progView.selection_clear(0, END)
    selRow += 1
    tab1.progView.select_set(selRow)
    curRow += 1
    selRow = tab1.progView.curselection()[0]
    tab1.progView.see(selRow+2)
    data = list(map(int, tab1.progView.curselection()))
    command=tab1.progView.get(data[0])
    J1newIndex = command.find("X) ")
    J2newIndex = command.find("Y) ")
    J3newIndex = command.find("Z) ")
    CXmid = float(command[J1newIndex+3:J2newIndex-1])
    CYmid = float(command[J2newIndex+3:J3newIndex-1])
    CZmid = float(command[J3newIndex+3:])	
    ##read next row for End position	
    curRow = tab1.progView.curselection()[0]
    selRow = tab1.progView.curselection()[0]
    last = tab1.progView.index('end')
    for row in range (0,selRow):
      tab1.progView.itemconfig(row, {'fg': 'dodger blue'})
    tab1.progView.itemconfig(selRow, {'fg': 'blue2'})
    for row in range (selRow+1,last):
      tab1.progView.itemconfig(row, {'fg': 'black'})
    tab1.progView.selection_clear(0, END)
    selRow += 1
    tab1.progView.select_set(selRow)
    curRow += 1
    selRow = tab1.progView.curselection()[0]
    tab1.progView.see(selRow+2)
    data = list(map(int, tab1.progView.curselection()))
    command=tab1.progView.get(data[0])
    J1newIndex = command.find("X) ")
    J2newIndex = command.find("Y) ")
    J3newIndex = command.find("Z) ")
    CXend = float(command[J1newIndex+3:J2newIndex-1])
    CYend = float(command[J2newIndex+3:J3newIndex-1])
    CZend = float(command[J3newIndex+3:])
    ### FIND CENTER AND RADIUS OF CIRCLE
    A = np.array([CXbeg, CYbeg, CZbeg])
    B = np.array([CXmid, CYmid, CZmid])
    C = np.array([CXend, CYend, CZend])
    a = np.linalg.norm(C - B)
    b = np.linalg.norm(C - A)
    c = np.linalg.norm(B - A)
    s = (a + b + c) / 2
    R = a*b*c / 4 / np.sqrt(s * (s - a) * (s - b) * (s - c))
    b1 = a*a * (b*b + c*c - a*a)
    b2 = b*b * (a*a + c*c - b*b)
    b3 = c*c * (a*a + b*b - c*c)
    P = np.column_stack((A, B, C)).dot(np.hstack((b1, b2, b3)))
    P /= b1 + b2 + b3
    Px = P[0]
    Py = P[1]
    Pz = P[2]
	###SHIFT POINTS TO ORIGIN
    sCXbeg = CXbeg - Px
    sCYbeg = CYbeg - Py
    sCZbeg = CZbeg - Pz
    sCXmid = CXmid - Px
    sCYmid = CYmid - Py
    sCZmid = CZmid - Pz
    sCXend = CXend - Px
    sCYend = CYend - Py
    sCZend = CZend - Pz
	###FIND CROSS PRODUCT 
    a_vec = np.array([sCXbeg, sCYbeg, sCZbeg])/np.linalg.norm(np.array([sCXbeg, sCYbeg, sCZbeg]))
    b_vec = np.array([sCXend, sCYend, sCZend])/np.linalg.norm(np.array([sCXend, sCYend, sCZend]))
    axis = np.cross(a_vec, b_vec)
    ab_angle = np.arccos(np.dot(a_vec,b_vec))
    ab_angle_Deg = math.degrees(ab_angle)
	###FIND ANGLE & NUM WAYPOINTS
    ##numWayPts = int(ab_angle_Deg / 3.6)
    numWayPts = 100
    theta_Deg = (ab_angle_Deg / (numWayPts+1))
    ###DEFINE START VECTOR
    v = [sCXbeg, sCYbeg, sCZbeg]  
    ###MOVE TO BEGINING OF ARC
    Code = 0
    MoveXYZ(CXbeg,CYbeg,CZbeg,CRx,CRy,CRz,newSpeed,ACCdur,ACCspd,DECdur,DECspd,WC,TCX,TCY,TCZ,TCRx,TCRy,TCRz,Track,Code)
    ## SPEEDS
    ACCpts = numWayPts * (int(ACCdur)/100)
    ACCpctInc = 100 / int(ACCpts)
    numDECpts = (numWayPts * (int(DECdur)/100))
    DECpts = numWayPts - numDECpts
    DECpctInc = 100 / int(numDECpts)
    minACC = int(newSpeed)*(int(ACCspd)/100)
    minDEC = int(newSpeed)*(int(DECspd)/100)
    lACCspd = "100"
    lDECspd = "100"
    lACCdur = "0"
    lDECdur = "0"  
    ##GENERATE WAYPOINTS CMD	
    WayPtsCMD = "ML"+str(numWayPts)
    ser.write(WayPtsCMD.encode())
    ser.flushInput()
    #time.sleep(.01)
	###LOOP FIND ALL POINTS IN ARC
    cur_deg = theta_Deg
    ###START LOOP	
    for i in range(numWayPts+1):
      theta = math.radians(cur_deg) 
      new_pt = np.dot(rotation_matrix(axis, theta), v)
      lCX = round(new_pt[0] + Px,2)
      lCY = round(new_pt[1] + Py,2)
      lCZ = round(new_pt[2] + Pz,2)  
      cur_deg += theta_Deg
      if i < ACCpts:
        tempSpeed = str(round(((i * (ACCpctInc/100))*int(newSpeed)),2))
        if float(tempSpeed) < minACC:
          tempSpeed = str(round(minACC,2))
      elif i > DECpts:
        tempSpeed = str(round((((numWayPts - i) * (DECpctInc/100))*int(newSpeed)),2))
        if float(tempSpeed) < minDEC:
          tempSpeed = str(round(minDEC,2))
      else:
        tempSpeed = newSpeed
      #manEntryField.insert(0,tempSpeed+"   ")
      Code = 2
      MoveXYZ(lCX,lCY,lCZ,CRx,CRy,CRz,newSpeed,ACCdur,lACCspd,DECdur,lDECspd,WC,TCX,TCY,TCZ,TCRx,TCRy,TCRz,Track,Code)
      ser.write(commandCalc.encode())
      #manEntryField.delete(0, 'end')
      #manEntryField.insert(0,commandCalc+"   ")	  
      ser.flushInput()
      time.sleep(.01)
      ser.read()  
  ##Move C Command##  
  if (cmdType == "Move C"):
    subCmd=command[:10]
    if (subCmd == "Move C Sta" or subCmd == "Move C Pla"):
      almStatusLab.config(text="Move C must start with a Center followed by Start & Plane", bg = "red")
      almStatusLab2.config(text="Move C must start with a Center followed by Start & Plane", bg = "red")
    J1newIndex = command.find("X) ")
    J2newIndex = command.find("Y) ")
    J3newIndex = command.find("Z) ")
    J4newIndex = command.find("W) ")
    J5newIndex = command.find("P) ")
    J6newIndex = command.find("R) ")
    TRnewIndex = command.find("T) ")	
    SpeedIndex = command.find("Speed-")
    ACCdurIndex = command.find("Ad")
    ACCspdIndex = command.find("As")
    DECdurIndex = command.find("Dd")
    DECspdIndex = command.find("Ds")
    WristConfIndex = command.find("$")
    CXbeg = float(command[J1newIndex+3:J2newIndex-1])
    CYbeg = float(command[J2newIndex+3:J3newIndex-1])
    CZbeg = float(command[J3newIndex+3:J4newIndex-1])
    CRx = float(command[J4newIndex+3:J5newIndex-1])
    CRy = float(command[J5newIndex+3:J6newIndex-1])
    CRz = float(command[J6newIndex+3:TRnewIndex-1])
    Track = float(command[TRnewIndex+3:SpeedIndex-1])
    newSpeed = str(command[SpeedIndex+6:ACCdurIndex-1])
    ACCdur = command[ACCdurIndex+3:ACCspdIndex-1]
    ACCspd = command[ACCspdIndex+3:DECdurIndex-1]
    DECdur = command[DECdurIndex+3:DECspdIndex-1]
    DECspd = command[DECspdIndex+3:WristConfIndex-1]
    WC = command[WristConfIndex+1:]
    TCX = 0
    TCY = 0 
    TCZ = 0
    TCRx = 0
    TCRy = 0
    TCRz = 0
    ##read next row for Mid position	
    curRow = tab1.progView.curselection()[0]
    selRow = tab1.progView.curselection()[0]
    last = tab1.progView.index('end')
    for row in range (0,selRow):
      tab1.progView.itemconfig(row, {'fg': 'dodger blue'})
    tab1.progView.itemconfig(selRow, {'fg': 'blue2'})
    for row in range (selRow+1,last):
      tab1.progView.itemconfig(row, {'fg': 'black'})
    tab1.progView.selection_clear(0, END)
    selRow += 1
    tab1.progView.select_set(selRow)
    curRow += 1
    selRow = tab1.progView.curselection()[0]
    tab1.progView.see(selRow+2)
    data = list(map(int, tab1.progView.curselection()))
    command=tab1.progView.get(data[0])
    J1newIndex = command.find("X) ")
    J2newIndex = command.find("Y) ")
    J3newIndex = command.find("Z) ")
    CXmid = float(command[J1newIndex+3:J2newIndex-1])
    CYmid = float(command[J2newIndex+3:J3newIndex-1])
    CZmid = float(command[J3newIndex+3:])	
    ##read next row for End position	
    curRow = tab1.progView.curselection()[0]
    selRow = tab1.progView.curselection()[0]
    last = tab1.progView.index('end')
    for row in range (0,selRow):
      tab1.progView.itemconfig(row, {'fg': 'dodger blue'})
    tab1.progView.itemconfig(selRow, {'fg': 'blue2'})
    for row in range (selRow+1,last):
      tab1.progView.itemconfig(row, {'fg': 'black'})
    tab1.progView.selection_clear(0, END)
    selRow += 1
    tab1.progView.select_set(selRow)
    curRow += 1
    selRow = tab1.progView.curselection()[0]
    tab1.progView.see(selRow+2)
    data = list(map(int, tab1.progView.curselection()))
    command=tab1.progView.get(data[0])
    J1newIndex = command.find("X) ")
    J2newIndex = command.find("Y) ")
    J3newIndex = command.find("Z) ")
    CXend = float(command[J1newIndex+3:J2newIndex-1])
    CYend = float(command[J2newIndex+3:J3newIndex-1])
    CZend = float(command[J3newIndex+3:])
	###SHIFT POINTS TO ORIGIN
    sCXmid = CXmid - CXbeg
    sCYmid = CYmid - CYbeg
    sCZmid = CZmid - CZbeg
    sCXend = CXend - CXbeg
    sCYend = CYend - CYbeg
    sCZend = CZend - CZbeg
	###FIND CROSS PRODUCT 
    a_vec = np.array([sCXmid, sCYmid, sCZmid])/np.linalg.norm(np.array([sCXmid, sCYmid, sCZmid]))
    b_vec = np.array([sCXend, sCYend, sCZend])/np.linalg.norm(np.array([sCXend, sCYend, sCZend]))
    axis = np.cross(a_vec, b_vec)
    ###ab_angle = np.arccos(np.dot(a_vec,b_vec))
    ###ab_angle_Deg = math.degrees(ab_angle)
	###FIND ANGLE & NUM WAYPOINTS
    ##numWayPts = int(ab_angle_Deg / 3.6)
    numWayPts = 100
    theta_Deg = (360 / (numWayPts+1))
    ###DEFINE START VECTOR
    v = [sCXmid, sCYmid, sCZmid]  
    ###MOVE TO BEGINING OF ARC
    Code = 0
    MoveXYZ(CXmid,CYmid,CZmid,CRx,CRy,CRz,newSpeed,ACCdur,ACCspd,DECdur,DECspd,WC,TCX,TCY,TCZ,TCRx,TCRy,TCRz,Track,Code)
    ## SPEEDS
    ACCpts = numWayPts * (int(ACCdur)/100)
    ACCpctInc = 100 / int(ACCpts)
    numDECpts = (numWayPts * (int(DECdur)/100))
    DECpts = numWayPts - numDECpts
    DECpctInc = 100 / int(numDECpts)
    minACC = int(newSpeed)*(int(ACCspd)/100)
    minDEC = int(newSpeed)*(int(DECspd)/100)
    lACCspd = "100"
    lDECspd = "100"
    lACCdur = "0"
    lDECdur = "0"  
    ##GENERATE WAYPOINTS CMD	
    WayPtsCMD = "ML"+str(numWayPts)
    ser.write(WayPtsCMD.encode())
    ser.flushInput()
    #time.sleep(.01)
	###LOOP FIND ALL POINTS IN ARC
    cur_deg = theta_Deg
    ###START LOOP	
    for i in range(numWayPts+1):
      theta = math.radians(cur_deg) 
      new_pt = np.dot(rotation_matrix(axis, theta), v)
      lCX = round(new_pt[0] + CXbeg,2)
      lCY = round(new_pt[1] + CYbeg,2)
      lCZ = round(new_pt[2] + CZbeg,2)  
      cur_deg += theta_Deg
      if i < ACCpts:
        tempSpeed = str(round(((i * (ACCpctInc/100))*int(newSpeed)),2))
        if float(tempSpeed) < minACC:
          tempSpeed = str(round(minACC,2))
      elif i > DECpts:
        tempSpeed = str(round((((numWayPts - i) * (DECpctInc/100))*int(newSpeed)),2))
        if float(tempSpeed) < minDEC:
          tempSpeed = str(round(minDEC,2))
      else:
        tempSpeed = newSpeed
      #manEntryField.insert(0,tempSpeed+"   ")
      Code = 2
      MoveXYZ(lCX,lCY,lCZ,CRx,CRy,CRz,newSpeed,ACCdur,lACCspd,DECdur,lDECspd,WC,TCX,TCY,TCZ,TCRx,TCRy,TCRz,Track,Code)
      ser.write(commandCalc.encode())
      #manEntryField.delete(0, 'end')
      #manEntryField.insert(0,commandCalc+"   ")	  
      ser.flushInput()
      time.sleep(.01)
      ser.read()    	  
  rowinproc = 0  	  


  
  
  
  
  
def rotation_matrix(axis, theta):
    axis = np.asarray(axis)
    axis = axis / math.sqrt(np.dot(axis, axis))
    a = math.cos(theta / 2.0)
    b, c, d = -axis * math.sin(theta / 2.0)
    aa, bb, cc, dd = a * a, b * b, c * c, d * d
    bc, ad, ac, ab, bd, cd = b * c, a * d, a * c, a * b, b * d, c * d
    return np.array([[aa + bb - cc - dd, 2 * (bc + ad), 2 * (bd - ac)],
                     [2 * (bc - ad), aa + cc - bb - dd, 2 * (cd + ab)],
                     [2 * (bd + ac), 2 * (cd - ab), aa + dd - bb - cc]])  


  
##############################################################################################################################################################
### BUTTON JOGGING DEFS ############################################################################################################## BUTTON JOGGING DEFS ###
##############################################################################################################################################################  
 

def xbox():
  def threadxbox():
    from inputs import get_gamepad
    global xboxUse
    jogMode = 1
    if xboxUse == 0:
      xboxUse = 1
      mainMode = 1
      jogMode = 1
      grip = 0
      almStatusLab.config(text='JOGGING JOINTS 1 & 2', bg = "lightgreen")
      almStatusLab2.config(text='JOGGING JOINTS 1 & 2', bg = "lightgreen")
      xbcStatusLab.config(text='Xbox ON', bg = "lightgreen")
      ChgDis(2)
    else:
      xboxUse = 0
      almStatusLab.config(text='XBOX CONTROLLER OFF', bg = "salmon")
      almStatusLab2.config(text='XBOX CONTROLLER OFF', bg = "salmon")
      xbcStatusLab.config(text='Xbox OFF', bg = "salmon")
    while xboxUse == 1:
      try:
        events = get_gamepad()
        for event in events:
          ##DISTANCE
          if (event.code == 'ABS_RZ' and event.state >= 100):
            ChgDis(0)
          elif (event.code == 'ABS_Z' and event.state >= 100): 
            ChgDis(1)
          ##SPEED
          elif (event.code == 'BTN_TR' and event.state == 1): 
            ChgSpd(0)
          elif (event.code == 'BTN_TL' and event.state == 1): 
            ChgSpd(1)
          ##JOINT MODE
          elif (event.code == 'BTN_WEST' and event.state == 1): 
            if mainMode != 1:
              mainMode = 1
              jogMode = 1
              almStatusLab.config(text='JOGGING JOINTS 1 & 2', bg = "lightgreen")
              almStatusLab2.config(text='JOGGING JOINTS 1 & 2', bg = "lightgreen")
            else:                
              jogMode +=1        
            if jogMode == 2:
              almStatusLab.config(text='JOGGING JOINTS 3 & 4', bg = "lightgreen")
              almStatusLab2.config(text='JOGGING JOINTS 3 & 4', bg = "lightgreen")
            elif jogMode == 3:
              almStatusLab.config(text='JOGGING JOINTS 5 & 6', bg = "lightgreen")
              almStatusLab2.config(text='JOGGING JOINTS 5 & 6', bg = "lightgreen")
            elif jogMode == 4:
              jogMode = 1
              almStatusLab.config(text='JOGGING JOINTS 1 & 2', bg = "lightgreen")
              almStatusLab2.config(text='JOGGING JOINTS 1 & 2', bg = "lightgreen")
          ##JOINT JOG
          elif (mainMode == 1 and event.code == 'ABS_HAT0X' and event.state == 1 and jogMode == 1): 
            J1jogNeg()    
          elif (mainMode == 1 and event.code == 'ABS_HAT0X' and event.state == -1 and jogMode == 1): 
            J1jogPos()
          elif (mainMode == 1 and event.code == 'ABS_HAT0Y' and event.state == -1 and jogMode == 1): 
            J2jogNeg()    
          elif (mainMode == 1 and event.code == 'ABS_HAT0Y' and event.state == 1 and jogMode == 1): 
            J2jogPos()           
          elif (mainMode == 1 and event.code == 'ABS_HAT0Y' and event.state == -1 and jogMode == 2): 
            J3jogNeg()    
          elif (mainMode == 1 and event.code == 'ABS_HAT0Y' and event.state == 1 and jogMode == 2): 
            J3jogPos()
          elif (mainMode == 1 and event.code == 'ABS_HAT0X' and event.state == 1 and jogMode == 2): 
            J4jogNeg()    
          elif (mainMode == 1 and event.code == 'ABS_HAT0X' and event.state == -1 and jogMode == 2): 
            J4jogPos()           
          elif (mainMode == 1 and event.code == 'ABS_HAT0Y' and event.state == -1 and jogMode == 3): 
            J5jogNeg()    
          elif (mainMode == 1 and event.code == 'ABS_HAT0Y' and event.state == 1 and jogMode == 3): 
            J5jogPos()
          elif (mainMode == 1 and event.code == 'ABS_HAT0X' and event.state == 1 and jogMode == 3): 
           J6jogNeg()    
          elif (mainMode == 1 and event.code == 'ABS_HAT0X' and event.state == -1 and jogMode == 3): 
            J6jogPos()                      
         ##CARTESIAN DIR MODE
          elif (event.code == 'BTN_SOUTH' and event.state == 1): 
            if mainMode != 2:
              mainMode = 2
              jogMode = 1
              almStatusLab.config(text='JOGGING X & Y AXIS', bg = "lightgreen")
              almStatusLab2.config(text='JOGGING X & Y AXIS', bg = "lightgreen")
            else:                
              jogMode +=1        
            if jogMode == 2:
              almStatusLab.config(text='JOGGING Z AXIS', bg = "lightgreen")
              almStatusLab2.config(text='JOGGING Z AXIS', bg = "lightgreen")
            elif jogMode == 3:
              jogMode = 1
              almStatusLab.config(text='JOGGING X & Y AXIS', bg = "lightgreen")
              almStatusLab2.config(text='JOGGING X & Y AXIS', bg = "lightgreen")
          ##CARTESIAN DIR JOG
          elif (mainMode == 2 and event.code == 'ABS_HAT0Y' and event.state == -1 and jogMode == 1): 
            XjogNeg()    
          elif (mainMode == 2 and event.code == 'ABS_HAT0Y' and event.state == 1 and jogMode == 1): 
            XjogPos()
          elif (mainMode == 2 and event.code == 'ABS_HAT0X' and event.state == 1 and jogMode == 1): 
            YjogNeg()    
          elif (mainMode == 2 and event.code == 'ABS_HAT0X' and event.state == -1 and jogMode == 1): 
            YjogPos()           
          elif (mainMode == 2 and event.code == 'ABS_HAT0Y' and event.state == 1 and jogMode == 2): 
            ZjogNeg()    
          elif (mainMode == 2 and event.code == 'ABS_HAT0Y' and event.state == -1 and jogMode == 2): 
            ZjogPos()                          
         ##CARTESIAN ORIENTATION MODE
          elif (event.code == 'BTN_EAST' and event.state == 1): 
            if mainMode != 3:
              mainMode = 3
              jogMode = 1
              almStatusLab.config(text='JOGGING Rx & Ry AXIS', bg = "lightgreen")
              almStatusLab2.config(text='JOGGING Rx & Ry AXIS', bg = "lightgreen")
            else:                
              jogMode +=1        
            if jogMode == 2:
              almStatusLab.config(text='JOGGING Rz AXIS', bg = "lightgreen")
              almStatusLab2.config(text='JOGGING Rz AXIS', bg = "lightgreen")
            elif jogMode == 3:
              jogMode = 1
              almStatusLab.config(text='JOGGING Rx & Ry AXIS', bg = "lightgreen")
              almStatusLab2.config(text='JOGGING Rx & Ry AXIS', bg = "lightgreen")
          ##CARTESIAN ORIENTATION JOG
          elif (mainMode == 3 and event.code == 'ABS_HAT0X' and event.state == -1 and jogMode == 1): 
            RxjogNeg()    
          elif (mainMode == 3 and event.code == 'ABS_HAT0X' and event.state == 1 and jogMode == 1): 
            RxjogPos()
          elif (mainMode == 3 and event.code == 'ABS_HAT0Y' and event.state == 1 and jogMode == 1): 
            RyjogNeg()    
          elif (mainMode == 3 and event.code == 'ABS_HAT0Y' and event.state == -1 and jogMode == 1): 
            RyjogPos()           
          elif (mainMode == 3 and event.code == 'ABS_HAT0X' and event.state == 1 and jogMode == 2): 
            RzjogNeg()    
          elif (mainMode == 3 and event.code == 'ABS_HAT0X' and event.state == -1 and jogMode == 2): 
            RzjogPos()
          ##TRACK MODE
          elif (event.code == 'BTN_START' and event.state == 1): 
            mainMode = 4
            almStatusLab.config(text='JOGGING TRACK', bg = "lightgreen")
            almStatusLab2.config(text='JOGGING TRACK', bg = "lightgreen")
          ##TRACK JOG
          elif (mainMode == 4 and event.code == 'ABS_HAT0X' and event.state == 1): 
            TrackjogPos()    
          elif (mainMode == 4 and event.code == 'ABS_HAT0X' and event.state == -1): 
            TrackjogNeg()                   
          ##TEACH POS          
          elif (event.code == 'BTN_NORTH' and event.state == 1): 
            teachInsertBelSelected()
          ##GRIPPER         
          elif (event.code == 'BTN_SELECT' and event.state == 1): 
            if grip == 0:
              grip = 1
              outputNum = DO1offEntryField.get()
              command = "OFX"+outputNum+"\n"
              ser.write(command.encode())
              ser.flushInput()
              time.sleep(.2)
              ser.read() 
            else:
              grip = 0
              outputNum = DO1onEntryField.get()
              command = "ONX"+outputNum+"\n"
              ser.write(command.encode())
              ser.flushInput()
              time.sleep(.2)
              ser.read()     
              time.sleep(.1)
      except:
        almStatusLab.config(text='XBOX CONTROLLER NOT RESPONDING', bg = "red")
        almStatusLab2.config(text='XBOX CONTROLLER NOT RESPONDING', bg = "red")        
  t = threading.Thread(target=threadxbox)
  t.start()



  
def ChgDis(val):
  curSpd = int(J1jogDegsEntryField.get())
  if curSpd >=100 and val == 0:
    curSpd = 100 
  elif curSpd < 5 and val == 0:  
    curSpd += 1
  elif val == 0:
    curSpd += 5   
  if curSpd <=1 and val == 1:
    curSpd = 1 
  elif curSpd <= 5 and val == 1:  
    curSpd -= 1
  elif val == 1:
    curSpd -= 5
  elif val == 2:
    curSpd = 5  
  J1jogDegsEntryField.delete(0, 'end')
  J2jogDegsEntryField.delete(0, 'end')
  J3jogDegsEntryField.delete(0, 'end')
  J4jogDegsEntryField.delete(0, 'end')
  J5jogDegsEntryField.delete(0, 'end')
  J6jogDegsEntryField.delete(0, 'end')
  XjogEntryField.delete(0, 'end')
  YjogEntryField.delete(0, 'end')
  ZjogEntryField.delete(0, 'end')
  RxjogEntryField.delete(0, 'end')
  RyjogEntryField.delete(0, 'end')
  RzjogEntryField.delete(0, 'end')
  TXjogEntryField.delete(0, 'end')
  TYjogEntryField.delete(0, 'end')
  TZjogEntryField.delete(0, 'end')
  TRxjogEntryField.delete(0, 'end')
  TRyjogEntryField.delete(0, 'end')
  TRzjogEntryField.delete(0, 'end')
  J1jogDegsEntryField.insert(0,str(curSpd))
  J2jogDegsEntryField.insert(0,str(curSpd))
  J3jogDegsEntryField.insert(0,str(curSpd))
  J4jogDegsEntryField.insert(0,str(curSpd))
  J5jogDegsEntryField.insert(0,str(curSpd))
  J6jogDegsEntryField.insert(0,str(curSpd))
  XjogEntryField.insert(0,str(curSpd))
  YjogEntryField.insert(0,str(curSpd))
  ZjogEntryField.insert(0,str(curSpd))
  RxjogEntryField.insert(0,str(curSpd))
  RyjogEntryField.insert(0,str(curSpd))
  RzjogEntryField.insert(0,str(curSpd))
  TXjogEntryField.insert(0,str(curSpd))
  TYjogEntryField.insert(0,str(curSpd))
  TZjogEntryField.insert(0,str(curSpd))
  TRxjogEntryField.insert(0,str(curSpd))
  TRyjogEntryField.insert(0,str(curSpd))
  TRzjogEntryField.insert(0,str(curSpd))
  time.sleep(.3)  


def ChgSpd(val):
  curSpd = int(speedEntryField.get())
  if curSpd >=100 and val == 0:
    curSpd = 100 
  elif curSpd < 5 and val == 0:  
    curSpd += 1
  elif val == 0:
    curSpd += 5   
  if curSpd <=1 and val == 1:
    curSpd = 1 
  elif curSpd <= 5 and val == 1:  
    curSpd -= 1
  elif val == 1:
    curSpd -= 5
  elif val == 2:
    curSpd = 5  
  speedEntryField.delete(0, 'end')    
  speedEntryField.insert(0,str(curSpd))  
 
def J1jogNeg():
  global JogStepsStat
  global J1StepCur
  global J1AngCur
  global xboxUse
  if xboxUse != 1:
    almStatusLab.config(text="SYSTEM READY", bg = "cornflowerblue")
    almStatusLab2.config(text="SYSTEM READY", bg = "cornflowerblue")
  Speed = speedEntryField.get()
  ACCdur = ACCdurField.get()
  ACCspd = ACCspeedField.get()
  DECdur = DECdurField.get()
  DECspd = DECspeedField.get()
  J1Degs = float(J1jogDegsEntryField.get())
  if JogStepsStat.get() == 0:
    J1jogSteps = int(J1Degs/J1DegPerStep)
  else:
    #switch from degs to steps
    J1jogSteps = J1Degs
    J1Degs = J1Degs*J1DegPerStep
  if (J1Degs <= -(J1NegAngLim - J1AngCur)):
    command = "MJA"+J1motdir+str(J1jogSteps)+"S"+Speed+"G"+ACCdur+"H"+ACCspd+"I"+DECdur+"K"+DECspd+"\n"
    ser.write(command.encode())    
    ser.flushInput()
    time.sleep(.2)
    ser.read()  
    J1StepCur = J1StepCur - int(J1jogSteps)
    J1AngCur = round(J1NegAngLim + (J1StepCur * J1DegPerStep),2)
    J1curAngEntryField.delete(0, 'end')
    J1curAngEntryField.insert(0,str(J1AngCur))
    savePosData()
    CalcFwdKin()
  else:
    almStatusLab.config(text="J1 AXIS LIMIT", bg = "red")
    almStatusLab2.config(text="J1 AXIS LIMIT", bg = "red")
  DisplaySteps()

def J1jogPos():
  global JogStepsStat
  global J1StepCur
  global J1AngCur
  global xboxUse
  if xboxUse != 1:
    almStatusLab.config(text="SYSTEM READY", bg = "cornflowerblue")
    almStatusLab2.config(text="SYSTEM READY", bg = "cornflowerblue")
  Speed = speedEntryField.get()
  ACCdur = ACCdurField.get()
  ACCspd = ACCspeedField.get()
  DECdur = DECdurField.get()
  DECspd = DECspeedField.get()
  J1Degs = float(J1jogDegsEntryField.get())
  if JogStepsStat.get() == 0:
    J1jogSteps = int(J1Degs/J1DegPerStep)
  else:
    #switch from degs to steps
    J1jogSteps = J1Degs
    J1Degs = J1Degs*J1DegPerStep
  #calc pos dir output
  if (J1motdir == "0"):
    J1drivedir = "1"
  else:
    J1drivedir = "0"	
  if (J1Degs <= (J1PosAngLim - J1AngCur)):
    command = "MJA"+J1drivedir+str(J1jogSteps)+"S"+Speed+"G"+ACCdur+"H"+ACCspd+"I"+DECdur+"K"+DECspd+"\n"
    ser.write(command.encode())    
    ser.flushInput()
    time.sleep(.2)
    ser.read()  
    J1StepCur = J1StepCur + int(J1jogSteps)
    J1AngCur = round(J1NegAngLim + (J1StepCur * J1DegPerStep),2)
    J1curAngEntryField.delete(0, 'end')
    J1curAngEntryField.insert(0,str(J1AngCur))
    savePosData()
    CalcFwdKin()
  else:
    almStatusLab.config(text="J1 AXIS LIMIT", bg = "red")
    almStatusLab2.config(text="J1 AXIS LIMIT", bg = "red")
  DisplaySteps()

def J2jogNeg():
  global JogStepsStat
  global J2StepCur
  global J2AngCur
  global xboxUse
  if xboxUse != 1:
    almStatusLab.config(text="SYSTEM READY", bg = "cornflowerblue")
    almStatusLab2.config(text="SYSTEM READY", bg = "cornflowerblue")
  Speed = speedEntryField.get()
  ACCdur = ACCdurField.get()
  ACCspd = ACCspeedField.get()
  DECdur = DECdurField.get()
  DECspd = DECspeedField.get()
  J2Degs = float(J2jogDegsEntryField.get())
  if JogStepsStat.get() == 0:
    J2jogSteps = int(J2Degs/J2DegPerStep)
  else:
    #switch from degs to steps
    J2jogSteps = J2Degs
    J2Degs = J2Degs*J2DegPerStep
  if (J2Degs <= -(J2NegAngLim - J2AngCur)):
    command = "MJB"+J2motdir+str(J2jogSteps)+"S"+Speed+"G"+ACCdur+"H"+ACCspd+"I"+DECdur+"K"+DECspd+"\n"
    ser.write(command.encode())    
    ser.flushInput()
    time.sleep(.2)
    ser.read()  
    J2StepCur = J2StepCur - int(J2jogSteps)
    J2AngCur = round(J2NegAngLim + (J2StepCur * J2DegPerStep),2)
    J2curAngEntryField.delete(0, 'end')
    J2curAngEntryField.insert(0,str(J2AngCur))
    savePosData()
    CalcFwdKin()
  else:
    almStatusLab.config(text="J2 AXIS LIMIT", bg = "red")
    almStatusLab2.config(text="J2 AXIS LIMIT", bg = "red")
  DisplaySteps()

def J2jogPos():
  global JogStepsStat
  global J2StepCur
  global J2AngCur
  global xboxUse
  if xboxUse != 1:
    almStatusLab.config(text="SYSTEM READY", bg = "cornflowerblue")
    almStatusLab2.config(text="SYSTEM READY", bg = "cornflowerblue")
  Speed = speedEntryField.get()
  ACCdur = ACCdurField.get()
  ACCspd = ACCspeedField.get()
  DECdur = DECdurField.get()
  DECspd = DECspeedField.get()
  J2Degs = float(J2jogDegsEntryField.get())
  if JogStepsStat.get() == 0:
    J2jogSteps = int(J2Degs/J2DegPerStep)
  else:
    #switch from degs to steps
    J2jogSteps = J2Degs
    J2Degs = J2Degs*J2DegPerStep
  #calc pos dir output
  if (J2motdir == "0"):
    J2drivedir = "1"
  else:
    J2drivedir = "0"	
  if (J2Degs <= (J2PosAngLim - J2AngCur)):
    command = "MJB"+J2drivedir+str(J2jogSteps)+"S"+Speed+"G"+ACCdur+"H"+ACCspd+"I"+DECdur+"K"+DECspd+"\n"
    ser.write(command.encode())    
    ser.flushInput()
    time.sleep(.2)
    ser.read()  
    J2StepCur = J2StepCur + int(J2jogSteps)
    J2AngCur = round(J2NegAngLim + (J2StepCur * J2DegPerStep),2)
    J2curAngEntryField.delete(0, 'end')
    J2curAngEntryField.insert(0,str(J2AngCur))
    savePosData()
    CalcFwdKin()
  else:
    almStatusLab.config(text="J2 AXIS LIMIT", bg = "red")
    almStatusLab2.config(text="J2 AXIS LIMIT", bg = "red")
  DisplaySteps()
   
def J3jogNeg():
  global JogStepsStat
  global J3StepCur
  global J3AngCur
  global xboxUse
  if xboxUse != 1:
    almStatusLab.config(text="SYSTEM READY", bg = "cornflowerblue")
    almStatusLab2.config(text="SYSTEM READY", bg = "cornflowerblue")
  Speed = speedEntryField.get()
  ACCdur = ACCdurField.get()
  ACCspd = ACCspeedField.get()
  DECdur = DECdurField.get()
  DECspd = DECspeedField.get()
  J3Degs = float(J3jogDegsEntryField.get())
  if JogStepsStat.get() == 0:
    J3jogSteps = int(J3Degs/J3DegPerStep)
  else:
    #switch from degs to steps
    J3jogSteps = J3Degs
    J3Degs = J3Degs*J3DegPerStep
  if (J3Degs <= -(J3NegAngLim - J3AngCur)):
    command = "MJC"+J3motdir+str(J3jogSteps)+"S"+Speed+"G"+ACCdur+"H"+ACCspd+"I"+DECdur+"K"+DECspd+"\n"
    ser.write(command.encode())    
    ser.flushInput()
    time.sleep(.2)
    ser.read()  
    J3StepCur = J3StepCur - int(J3jogSteps)
    J3AngCur = round(J3NegAngLim + (J3StepCur * J3DegPerStep),2)
    J3curAngEntryField.delete(0, 'end')
    J3curAngEntryField.insert(0,str(J3AngCur))
    savePosData()
    CalcFwdKin()
  else:
    almStatusLab.config(text="J3 AXIS LIMIT", bg = "red")
    almStatusLab2.config(text="J3 AXIS LIMIT", bg = "red")
  DisplaySteps()

def J3jogPos():
  global JogStepsStat
  global J3StepCur
  global J3AngCur
  global xboxUse
  if xboxUse != 1:
    almStatusLab.config(text="SYSTEM READY", bg = "cornflowerblue")
    almStatusLab2.config(text="SYSTEM READY", bg = "cornflowerblue")
  Speed = speedEntryField.get()
  ACCdur = ACCdurField.get()
  ACCspd = ACCspeedField.get()
  DECdur = DECdurField.get()
  DECspd = DECspeedField.get()
  J3Degs = float(J3jogDegsEntryField.get())
  if JogStepsStat.get() == 0:
    J3jogSteps = int(J3Degs/J3DegPerStep)
  else:
    #switch from degs to steps
    J3jogSteps = J3Degs
    J3Degs = J3Degs*J3DegPerStep
  #calc pos dir output
  if (J3motdir == "0"):
    J3drivedir = "1"
  else:
    J3drivedir = "0"	
  if (J3Degs <= (J3PosAngLim - J3AngCur)):
    command = "MJC"+J3drivedir+str(J3jogSteps)+"S"+Speed+"G"+ACCdur+"H"+ACCspd+"I"+DECdur+"K"+DECspd+"\n"
    ser.write(command.encode())    
    ser.flushInput()
    time.sleep(.2)
    ser.read()  
    J3StepCur = J3StepCur + int(J3jogSteps)
    J3AngCur = round(J3NegAngLim + (J3StepCur * J3DegPerStep),2)
    J3curAngEntryField.delete(0, 'end')
    J3curAngEntryField.insert(0,str(J3AngCur))
    savePosData()
    CalcFwdKin()
  else:
    almStatusLab.config(text="J3 AXIS LIMIT", bg = "red")
    almStatusLab2.config(text="J3 AXIS LIMIT", bg = "red")
  DisplaySteps()

def J4jogNeg():
  global JogStepsStat
  global J4StepCur
  global J4AngCur
  global xboxUse
  if xboxUse != 1:
    almStatusLab.config(text="SYSTEM READY", bg = "cornflowerblue")
    almStatusLab2.config(text="SYSTEM READY", bg = "cornflowerblue")
  Speed = speedEntryField.get()
  ACCdur = ACCdurField.get()
  ACCspd = ACCspeedField.get()
  DECdur = DECdurField.get()
  DECspd = DECspeedField.get()
  J4Degs = float(J4jogDegsEntryField.get())
  if JogStepsStat.get() == 0:
    J4jogSteps = int(J4Degs/J4DegPerStep)
  else:
    #switch from degs to steps
    J4jogSteps = J4Degs
    J4Degs = J4Degs*J4DegPerStep
  if (J4Degs <= -(J4NegAngLim - J4AngCur)):
    command = "MJD"+J4motdir+str(J4jogSteps)+"S"+Speed+"G"+ACCdur+"H"+ACCspd+"I"+DECdur+"K"+DECspd+"\n"
    ser.write(command.encode())	
    ser.flushInput()
    time.sleep(.2)
    ser.read()  
    J4StepCur = J4StepCur - int(J4jogSteps)
    J4AngCur = round(J4NegAngLim + (J4StepCur * J4DegPerStep),2)
    J4curAngEntryField.delete(0, 'end')
    J4curAngEntryField.insert(0,str(J4AngCur))
    savePosData()
    CalcFwdKin()
  else:
    almStatusLab.config(text="J4 AXIS LIMIT", bg = "red")
    almStatusLab2.config(text="J4 AXIS LIMIT", bg = "red")
  DisplaySteps()

def J4jogPos():
  global JogStepsStat
  global J4StepCur
  global J4AngCur
  global xboxUse
  if xboxUse != 1:
    almStatusLab.config(text="SYSTEM READY", bg = "cornflowerblue")
    almStatusLab2.config(text="SYSTEM READY", bg = "cornflowerblue")
  Speed = speedEntryField.get()
  ACCdur = ACCdurField.get()
  ACCspd = ACCspeedField.get()
  DECdur = DECdurField.get()
  DECspd = DECspeedField.get()
  J4Degs = float(J4jogDegsEntryField.get())
  if JogStepsStat.get() == 0:
    J4jogSteps = int(J4Degs/J4DegPerStep)
  else:
    #switch from degs to steps
    J4jogSteps = J4Degs
    J4Degs = J4Degs*J4DegPerStep
  #calc pos dir output
  if (J4motdir == "0"):
    J4drivedir = "1"
  else:
    J4drivedir = "0"	
  if (J4Degs <= (J4PosAngLim - J4AngCur)):
    command = "MJD"+J4drivedir+str(J4jogSteps)+"S"+Speed+"G"+ACCdur+"H"+ACCspd+"I"+DECdur+"K"+DECspd+"\n"
    ser.write(command.encode())    
    ser.flushInput()
    time.sleep(.2)
    ser.read()  
    J4StepCur = J4StepCur + int(J4jogSteps)
    J4AngCur = round(J4NegAngLim + (J4StepCur * J4DegPerStep),2)
    J4curAngEntryField.delete(0, 'end')
    J4curAngEntryField.insert(0,str(J4AngCur))
    savePosData()
    CalcFwdKin()
  else:
    almStatusLab.config(text="J4 AXIS LIMIT", bg = "red")
    almStatusLab2.config(text="J4 AXIS LIMIT", bg = "red")
  DisplaySteps()  
   
def J5jogNeg():
  global JogStepsStat
  global J5StepCur
  global J5AngCur
  global xboxUse
  if xboxUse != 1:
    almStatusLab.config(text="SYSTEM READY", bg = "cornflowerblue")
    almStatusLab2.config(text="SYSTEM READY", bg = "cornflowerblue")
  Speed = speedEntryField.get()
  ACCdur = ACCdurField.get()
  ACCspd = ACCspeedField.get()
  DECdur = DECdurField.get()
  DECspd = DECspeedField.get()
  J5Degs = float(J5jogDegsEntryField.get())
  if JogStepsStat.get() == 0:
    J5jogSteps = int(J5Degs/J5DegPerStep)
  else:
    #switch from degs to steps
    J5jogSteps = J5Degs
    J5Degs = J5Degs*J5DegPerStep
  if (J5Degs <= -(J5NegAngLim - J5AngCur)):
    command = "MJE"+J5motdir+str(J5jogSteps)+"S"+Speed+"G"+ACCdur+"H"+ACCspd+"I"+DECdur+"K"+DECspd+"\n"
    ser.write(command.encode())    
    ser.flushInput()
    time.sleep(.2)
    ser.read()  
    J5StepCur = J5StepCur - int(J5jogSteps)
    J5AngCur = round(J5NegAngLim + (J5StepCur * J5DegPerStep),2)
    J5curAngEntryField.delete(0, 'end')
    J5curAngEntryField.insert(0,str(J5AngCur))
    savePosData()
    CalcFwdKin()
  else:
    almStatusLab.config(text="J5 AXIS LIMIT", bg = "red")
    almStatusLab2.config(text="J5 AXIS LIMIT", bg = "red")
  DisplaySteps()

def J5jogPos():
  global JogStepsStat
  global J5StepCur
  global J5AngCur
  global xboxUse
  if xboxUse != 1:
    almStatusLab.config(text="SYSTEM READY", bg = "cornflowerblue")
    almStatusLab2.config(text="SYSTEM READY", bg = "cornflowerblue")
  Speed = speedEntryField.get()
  ACCdur = ACCdurField.get()
  ACCspd = ACCspeedField.get()
  DECdur = DECdurField.get()
  DECspd = DECspeedField.get()
  J5Degs = float(J5jogDegsEntryField.get())
  if JogStepsStat.get() == 0:
    J5jogSteps = int(J5Degs/J5DegPerStep)
  else:
    #switch from degs to steps
    J5jogSteps = J5Degs
    J5Degs = J5Degs*J5DegPerStep
  #calc pos dir output
  if (J5motdir == "0"):
    J5drivedir = "1"
  else:
    J5drivedir = "0"	
  if (J5Degs <= (J5PosAngLim - J5AngCur)):
    command = "MJE"+J5drivedir+str(J5jogSteps)+"S"+Speed+"G"+ACCdur+"H"+ACCspd+"I"+DECdur+"K"+DECspd+"\n"
    ser.write(command.encode())    
    ser.flushInput()
    time.sleep(.2)
    ser.read()  
    J5StepCur = J5StepCur + int(J5jogSteps)
    J5AngCur = round(J5NegAngLim + (J5StepCur * J5DegPerStep),2)
    J5curAngEntryField.delete(0, 'end')
    J5curAngEntryField.insert(0,str(J5AngCur))
    savePosData()
    CalcFwdKin()
  else:
    almStatusLab.config(text="J5 AXIS LIMIT", bg = "red")
    almStatusLab2.config(text="J5 AXIS LIMIT", bg = "red")
  DisplaySteps()
   
def J6jogNeg():
  global JogStepsStat
  global J6StepCur
  global J6AngCur
  global xboxUse
  if xboxUse != 1:
    almStatusLab.config(text="SYSTEM READY", bg = "cornflowerblue")
    almStatusLab2.config(text="SYSTEM READY", bg = "cornflowerblue")
  Speed = speedEntryField.get()
  ACCdur = ACCdurField.get()
  ACCspd = ACCspeedField.get()
  DECdur = DECdurField.get()
  DECspd = DECspeedField.get()
  J6Degs = float(J6jogDegsEntryField.get())
  if JogStepsStat.get() == 0:
    J6jogSteps = int(J6Degs/J6DegPerStep)
  else:
    #switch from degs to steps
    J6jogSteps = J6Degs
    J6Degs = J6Degs*J6DegPerStep
  if (J6Degs <= -(J6NegAngLim - J6AngCur)):
    command = "MJF"+J6motdir+str(J6jogSteps)+"S"+Speed+"G"+ACCdur+"H"+ACCspd+"I"+DECdur+"K"+DECspd+"\n"
    ser.write(command.encode())	
    ser.flushInput()
    time.sleep(.2)
    ser.read()  
    J6StepCur = J6StepCur - int(J6jogSteps)
    J6AngCur = round(J6NegAngLim + (J6StepCur * J6DegPerStep),2)
    J6curAngEntryField.delete(0, 'end')
    J6curAngEntryField.insert(0,str(J6AngCur))
    savePosData()
    CalcFwdKin()
  else:
    almStatusLab.config(text="J6 AXIS LIMIT", bg = "red")
    almStatusLab2.config(text="J6 AXIS LIMIT", bg = "red")
  DisplaySteps()

def J6jogPos():
  global JogStepsStat
  global J6StepCur
  global J6AngCur
  global xboxUse
  if xboxUse != 1:
    almStatusLab.config(text="SYSTEM READY", bg = "cornflowerblue")
    almStatusLab2.config(text="SYSTEM READY", bg = "cornflowerblue")
  Speed = speedEntryField.get()
  ACCdur = ACCdurField.get()
  ACCspd = ACCspeedField.get()
  DECdur = DECdurField.get()
  DECspd = DECspeedField.get()
  J6Degs = float(J6jogDegsEntryField.get())
  if JogStepsStat.get() == 0:
    J6jogSteps = int(J6Degs/J6DegPerStep)
  else:
    #switch from degs to steps
    J6jogSteps = J6Degs
    J6Degs = J6Degs*J6DegPerStep
  #calc pos dir output
  if (J6motdir == "0"):
    J6drivedir = "1"
  else:
    J6drivedir = "0"	
  if (J6Degs <= (J6PosAngLim - J6AngCur)):
    command = "MJF"+J6drivedir+str(J6jogSteps)+"S"+Speed+"G"+ACCdur+"H"+ACCspd+"I"+DECdur+"K"+DECspd+"\n"
    ser.write(command.encode())	
    ser.flushInput()
    time.sleep(.2)
    ser.read()  
    J6StepCur = J6StepCur + int(J6jogSteps)
    J6AngCur = round(J6NegAngLim + (J6StepCur * J6DegPerStep),2)
    J6curAngEntryField.delete(0, 'end')
    J6curAngEntryField.insert(0,str(J6AngCur))
    savePosData()
    CalcFwdKin()
  else:
    almStatusLab.config(text="J6 AXIS LIMIT", bg = "red")
    almStatusLab2.config(text="J6 AXIS LIMIT", bg = "red")
  DisplaySteps()

def XjogNeg():
  global xboxUse
  if xboxUse != 1:
    almStatusLab.config(text="SYSTEM READY", bg = "cornflowerblue")
    almStatusLab2.config(text="SYSTEM READY", bg = "cornflowerblue")
  CX = XcurPos - float(XjogEntryField.get())
  CY = YcurPos 
  CZ = ZcurPos
  CRx = RxcurPos
  CRy = RycurPos
  CRz = RzcurPos
  TCX = 0
  TCY = 0 
  TCZ = 0
  TCRx = 0
  TCRy = 0
  TCRz = 0 
  Track = float(TrackcurEntryField.get())
  Code = 0
  newSpeed = speedEntryField.get()
  ACCdur = ACCdurField.get()
  ACCspd = ACCspeedField.get()
  DECdur = DECdurField.get()
  DECspd = DECspeedField.get()
  MoveXYZ(CX,CY,CZ,CRx,CRy,CRz,newSpeed,ACCdur,ACCspd,DECdur,DECspd,WC,TCX,TCY,TCZ,TCRx,TCRy,TCRz,Track,Code)

def YjogNeg():
  global xboxUse
  if xboxUse != 1:
    almStatusLab.config(text="SYSTEM READY", bg = "cornflowerblue")
    almStatusLab2.config(text="SYSTEM READY", bg = "cornflowerblue")
  CX = XcurPos 
  CY = YcurPos - float(YjogEntryField.get())
  CZ = ZcurPos
  CRx = RxcurPos
  CRy = RycurPos
  CRz = RzcurPos
  TCX = 0
  TCY = 0 
  TCZ = 0
  TCRx = 0
  TCRy = 0
  TCRz = 0 
  Track = float(TrackcurEntryField.get())
  Code = 0
  newSpeed = speedEntryField.get()
  ACCdur = ACCdurField.get()
  ACCspd = ACCspeedField.get()
  DECdur = DECdurField.get()
  DECspd = DECspeedField.get()
  MoveXYZ(CX,CY,CZ,CRx,CRy,CRz,newSpeed,ACCdur,ACCspd,DECdur,DECspd,WC,TCX,TCY,TCZ,TCRx,TCRy,TCRz,Track,Code)

def ZjogNeg():
  global xboxUse
  if xboxUse != 1:
    almStatusLab.config(text="SYSTEM READY", bg = "cornflowerblue")
    almStatusLab2.config(text="SYSTEM READY", bg = "cornflowerblue")
  CX = XcurPos 
  CY = YcurPos
  CZ = ZcurPos - float(ZjogEntryField.get())
  CRx = RxcurPos
  CRy = RycurPos
  CRz = RzcurPos
  TCX = 0
  TCY = 0 
  TCZ = 0
  TCRx = 0
  TCRy = 0
  TCRz = 0
  Track = float(TrackcurEntryField.get())
  Code = 0  
  newSpeed = speedEntryField.get()
  ACCdur = ACCdurField.get()
  ACCspd = ACCspeedField.get()
  DECdur = DECdurField.get()
  DECspd = DECspeedField.get()
  MoveXYZ(CX,CY,CZ,CRx,CRy,CRz,newSpeed,ACCdur,ACCspd,DECdur,DECspd,WC,TCX,TCY,TCZ,TCRx,TCRy,TCRz,Track,Code)

def RxjogNeg():
  global xboxUse
  if xboxUse != 1:
    almStatusLab.config(text="SYSTEM READY", bg = "cornflowerblue")
    almStatusLab2.config(text="SYSTEM READY", bg = "cornflowerblue")
  CX = XcurPos 
  CY = YcurPos
  CZ = ZcurPos
  CRx = RxcurPos - float(RxjogEntryField.get())
  CRy = RycurPos
  CRz = RzcurPos
  TCX = 0
  TCY = 0 
  TCZ = 0
  TCRx = 0
  TCRy = 0
  TCRz = 0
  Track = float(TrackcurEntryField.get())
  Code = 0  
  newSpeed = speedEntryField.get()
  ACCdur = ACCdurField.get()
  ACCspd = ACCspeedField.get()
  DECdur = DECdurField.get()
  DECspd = DECspeedField.get()
  MoveXYZ(CX,CY,CZ,CRx,CRy,CRz,newSpeed,ACCdur,ACCspd,DECdur,DECspd,WC,TCX,TCY,TCZ,TCRx,TCRy,TCRz,Track,Code)

def RyjogNeg():
  global xboxUse
  if xboxUse != 1:
    almStatusLab.config(text="SYSTEM READY", bg = "cornflowerblue")
    almStatusLab2.config(text="SYSTEM READY", bg = "cornflowerblue")
  CX = XcurPos 
  CY = YcurPos
  CZ = ZcurPos
  CRx = RxcurPos
  CRy = RycurPos - float(RyjogEntryField.get())
  CRz = RzcurPos
  TCX = 0
  TCY = 0 
  TCZ = 0
  TCRx = 0
  TCRy = 0
  TCRz = 0
  Track = float(TrackcurEntryField.get())
  Code = 0  
  newSpeed = speedEntryField.get()
  ACCdur = ACCdurField.get()
  ACCspd = ACCspeedField.get()
  DECdur = DECdurField.get()
  DECspd = DECspeedField.get()
  MoveXYZ(CX,CY,CZ,CRx,CRy,CRz,newSpeed,ACCdur,ACCspd,DECdur,DECspd,WC,TCX,TCY,TCZ,TCRx,TCRy,TCRz,Track,Code)

def RzjogNeg():
  global xboxUse
  if xboxUse != 1:
    almStatusLab.config(text="SYSTEM READY", bg = "cornflowerblue")
    almStatusLab2.config(text="SYSTEM READY", bg = "cornflowerblue")
  CX = XcurPos 
  CY = YcurPos
  CZ = ZcurPos
  CRx = RxcurPos
  CRy = RycurPos
  CRz = RzcurPos - float(RzjogEntryField.get())
  TCX = 0
  TCY = 0 
  TCZ = 0
  TCRx = 0
  TCRy = 0
  TCRz = 0
  Track = float(TrackcurEntryField.get())
  Code = 0  
  newSpeed = speedEntryField.get()
  ACCdur = ACCdurField.get()
  ACCspd = ACCspeedField.get()
  DECdur = DECdurField.get()
  DECspd = DECspeedField.get()
  MoveXYZ(CX,CY,CZ,CRx,CRy,CRz,newSpeed,ACCdur,ACCspd,DECdur,DECspd,WC,TCX,TCY,TCZ,TCRx,TCRy,TCRz,Track,Code)

def XjogPos():
  global xboxUse
  if xboxUse != 1:
    almStatusLab.config(text="SYSTEM READY", bg = "cornflowerblue")
    almStatusLab2.config(text="SYSTEM READY", bg = "cornflowerblue")
  CX = XcurPos + float(XjogEntryField.get())
  CY = YcurPos
  CZ = ZcurPos
  CRx = RxcurPos
  CRy = RycurPos
  CRz = RzcurPos
  TCX = 0
  TCY = 0 
  TCZ = 0
  TCRx = 0
  TCRy = 0
  TCRz = 0
  Track = float(TrackcurEntryField.get())
  Code = 0  
  newSpeed = speedEntryField.get()
  ACCdur = ACCdurField.get()
  ACCspd = ACCspeedField.get()
  DECdur = DECdurField.get()
  DECspd = DECspeedField.get()
  MoveXYZ(CX,CY,CZ,CRx,CRy,CRz,newSpeed,ACCdur,ACCspd,DECdur,DECspd,WC,TCX,TCY,TCZ,TCRx,TCRy,TCRz,Track,Code)

def YjogPos():
  global xboxUse
  if xboxUse != 1:
    almStatusLab.config(text="SYSTEM READY", bg = "cornflowerblue")
    almStatusLab2.config(text="SYSTEM READY", bg = "cornflowerblue")
  CX = XcurPos
  CY = YcurPos + float(YjogEntryField.get())
  CZ = ZcurPos
  CRx = RxcurPos
  CRy = RycurPos
  CRz = RzcurPos
  TCX = 0
  TCY = 0 
  TCZ = 0
  TCRx = 0
  TCRy = 0
  TCRz = 0
  Track = float(TrackcurEntryField.get())
  Code = 0  
  newSpeed = speedEntryField.get()
  ACCdur = ACCdurField.get()
  ACCspd = ACCspeedField.get()
  DECdur = DECdurField.get()
  DECspd = DECspeedField.get()  
  MoveXYZ(CX,CY,CZ,CRx,CRy,CRz,newSpeed,ACCdur,ACCspd,DECdur,DECspd,WC,TCX,TCY,TCZ,TCRx,TCRy,TCRz,Track,Code)

def ZjogPos():
  global xboxUse
  if xboxUse != 1:
    almStatusLab.config(text="SYSTEM READY", bg = "cornflowerblue")
    almStatusLab2.config(text="SYSTEM READY", bg = "cornflowerblue")
  CX = XcurPos
  CY = YcurPos
  CZ = ZcurPos + float(ZjogEntryField.get())
  CRx = RxcurPos
  CRy = RycurPos
  CRz = RzcurPos
  TCX = 0
  TCY = 0 
  TCZ = 0
  TCRx = 0
  TCRy = 0
  TCRz = 0
  Track = float(TrackcurEntryField.get())
  Code = 0
  newSpeed = speedEntryField.get()
  ACCdur = ACCdurField.get()
  ACCspd = ACCspeedField.get()
  DECdur = DECdurField.get()
  DECspd = DECspeedField.get()  
  MoveXYZ(CX,CY,CZ,CRx,CRy,CRz,newSpeed,ACCdur,ACCspd,DECdur,DECspd,WC,TCX,TCY,TCZ,TCRx,TCRy,TCRz,Track,Code)

def RxjogPos():
  global xboxUse
  if xboxUse != 1:
    almStatusLab.config(text="SYSTEM READY", bg = "cornflowerblue")
    almStatusLab2.config(text="SYSTEM READY", bg = "cornflowerblue")
  CX = XcurPos
  CY = YcurPos
  CZ = ZcurPos
  CRx = RxcurPos + float(RxjogEntryField.get())
  CRy = RycurPos
  CRz = RzcurPos
  TCX = 0
  TCY = 0 
  TCZ = 0
  TCRx = 0
  TCRy = 0
  TCRz = 0
  Track = float(TrackcurEntryField.get())
  Code = 0  
  newSpeed = speedEntryField.get()
  ACCdur = ACCdurField.get()
  ACCspd = ACCspeedField.get()
  DECdur = DECdurField.get()
  DECspd = DECspeedField.get()  
  MoveXYZ(CX,CY,CZ,CRx,CRy,CRz,newSpeed,ACCdur,ACCspd,DECdur,DECspd,WC,TCX,TCY,TCZ,TCRx,TCRy,TCRz,Track,Code)

def RyjogPos():
  global xboxUse
  if xboxUse != 1:
    almStatusLab.config(text="SYSTEM READY", bg = "cornflowerblue")
    almStatusLab2.config(text="SYSTEM READY", bg = "cornflowerblue")
  CX = XcurPos
  CY = YcurPos
  CZ = ZcurPos
  CRx = RxcurPos
  CRy = RycurPos + float(RyjogEntryField.get())
  CRz = RzcurPos
  TCX = 0
  TCY = 0 
  TCZ = 0
  TCRx = 0
  TCRy = 0
  TCRz = 0
  Track = float(TrackcurEntryField.get())
  Code = 0  
  newSpeed = speedEntryField.get()
  ACCdur = ACCdurField.get()
  ACCspd = ACCspeedField.get()
  DECdur = DECdurField.get()
  DECspd = DECspeedField.get()  
  MoveXYZ(CX,CY,CZ,CRx,CRy,CRz,newSpeed,ACCdur,ACCspd,DECdur,DECspd,WC,TCX,TCY,TCZ,TCRx,TCRy,TCRz,Track,Code)

def RzjogPos():
  global xboxUse
  if xboxUse != 1:
    almStatusLab.config(text="SYSTEM READY", bg = "cornflowerblue")
    almStatusLab2.config(text="SYSTEM READY", bg = "cornflowerblue")
  CX = XcurPos
  CY = YcurPos
  CZ = ZcurPos
  CRx = RxcurPos
  CRy = RycurPos
  CRz = RzcurPos + float(RzjogEntryField.get())
  TCX = 0
  TCY = 0 
  TCZ = 0
  TCRx = 0
  TCRy = 0
  TCRz = 0
  Track = float(TrackcurEntryField.get())
  Code = 0  
  newSpeed = speedEntryField.get()
  ACCdur = ACCdurField.get()
  ACCspd = ACCspeedField.get()
  DECdur = DECdurField.get()
  DECspd = DECspeedField.get()  
  MoveXYZ(CX,CY,CZ,CRx,CRy,CRz,newSpeed,ACCdur,ACCspd,DECdur,DECspd,WC,TCX,TCY,TCZ,TCRx,TCRy,TCRz,Track,Code)

def TrackjogNeg():
  global TrackcurPos
  global TrackLength
  global TrackStepLim
  if xboxUse != 1:  
    almStatusLab.config(text="SYSTEM READY", bg = "cornflowerblue")
    almStatusLab2.config(text="SYSTEM READY", bg = "cornflowerblue")
  CT = float(TrackjogEntryField.get())
  Speed = speedEntryField.get()
  ACCdur = ACCdurField.get()
  ACCspd = ACCspeedField.get()
  DECdur = DECdurField.get()
  DECspd = DECspeedField.get()
  if JogStepsStat.get() == 1:
    TrackSteps = TrackjogEntryField.get()
  else:
    TrackSteps = str(int((TrackStepLim/TrackLength)*CT))
  if (TrackcurPos - (float(TrackSteps) * (TrackLength/TrackStepLim)) >= 0):
    command = "MJT0"+TrackSteps+"S"+Speed+"G"+ACCdur+"H"+ACCspd+"I"+DECdur+"K"+DECspd+"\n"
    ser.write(command.encode())    
    ser.flushInput()
    time.sleep(.2)
    ser.read()  	
    TrackcurPos = TrackcurPos - (float(TrackSteps) * (TrackLength/TrackStepLim))
    TrackcurEntryField.delete(0, 'end')  
    TrackcurEntryField.insert(0,str(TrackcurPos))
    savePosData()
  else:
    almStatusLab.config(text="TRACK NEG TRAVEL LIMIT", bg = "red")
    almStatusLab2.config(text="TRACK NEG TRAVEL LIMIT", bg = "red")

def TrackjogPos():
  global TrackcurPos
  global TrackLength
  global TrackStepLim
  if xboxUse != 1:  
    almStatusLab.config(text="SYSTEM READY", bg = "cornflowerblue")
    almStatusLab2.config(text="SYSTEM READY", bg = "cornflowerblue")
  CT = float(TrackjogEntryField.get())
  Speed = speedEntryField.get()
  ACCdur = ACCdurField.get()
  ACCspd = ACCspeedField.get()
  DECdur = DECdurField.get()
  DECspd = DECspeedField.get()
  if JogStepsStat.get() == 1:
    TrackSteps = TrackjogEntryField.get()
  else:
    TrackSteps = str(int((TrackStepLim/TrackLength)*CT))
  if (TrackcurPos + (float(TrackSteps) * (TrackLength/TrackStepLim)) <= TrackLength):
    command = "MJT1"+TrackSteps+"S"+Speed+"G"+ACCdur+"H"+ACCspd+"I"+DECdur+"K"+DECspd+"\n"
    ser.write(command.encode())    
    ser.flushInput()
    time.sleep(.2)
    ser.read()
    TrackcurPos = TrackcurPos + (float(TrackSteps) * (TrackLength/TrackStepLim))
    TrackcurEntryField.delete(0, 'end')  
    TrackcurEntryField.insert(0,str(TrackcurPos))
    savePosData()
  else:
    almStatusLab.config(text="TRACK POS TRAVEL LIMIT", bg = "red")
    almStatusLab2.config(text="TRACK POS TRAVEL LIMIT", bg = "red")    
  
def TXjogNeg():
  almStatusLab.config(text="SYSTEM READY", bg = "cornflowerblue")
  almStatusLab2.config(text="SYSTEM READY", bg = "cornflowerblue")
  CX = XcurPos
  CY = YcurPos 
  CZ = ZcurPos
  CRx = RxcurPos
  CRy = RycurPos
  CRz = RzcurPos
  TCX = 0 - float(TXjogEntryField.get())
  TCY = 0 
  TCZ = 0
  TCRx = 0
  TCRy = 0
  TCRz = 0
  Track = float(TrackcurEntryField.get())
  Code = 0  
  newSpeed = speedEntryField.get()
  ACCdur = ACCdurField.get()
  ACCspd = ACCspeedField.get()
  DECdur = DECdurField.get()
  DECspd = DECspeedField.get()
  MoveXYZ(CX,CY,CZ,CRx,CRy,CRz,newSpeed,ACCdur,ACCspd,DECdur,DECspd,WC,TCX,TCY,TCZ,TCRx,TCRy,TCRz,Track,Code)

def TYjogNeg():
  almStatusLab.config(text="SYSTEM READY", bg = "cornflowerblue")
  almStatusLab2.config(text="SYSTEM READY", bg = "cornflowerblue")
  CX = XcurPos 
  CY = YcurPos
  CZ = ZcurPos
  CRx = RxcurPos
  CRy = RycurPos
  CRz = RzcurPos
  TCX = 0
  TCY = 0 - float(TYjogEntryField.get()) 
  TCZ = 0
  TCRx = 0
  TCRy = 0
  TCRz = 0
  Track = float(TrackcurEntryField.get())
  Code = 0
  newSpeed = speedEntryField.get()
  ACCdur = ACCdurField.get()
  ACCspd = ACCspeedField.get()
  DECdur = DECdurField.get()
  DECspd = DECspeedField.get()
  MoveXYZ(CX,CY,CZ,CRx,CRy,CRz,newSpeed,ACCdur,ACCspd,DECdur,DECspd,WC,TCX,TCY,TCZ,TCRx,TCRy,TCRz,Track,Code)

def TZjogNeg():
  almStatusLab.config(text="SYSTEM READY", bg = "cornflowerblue")
  almStatusLab2.config(text="SYSTEM READY", bg = "cornflowerblue")
  CX = XcurPos 
  CY = YcurPos
  CZ = ZcurPos
  CRx = RxcurPos
  CRy = RycurPos
  CRz = RzcurPos
  TCX = 0
  TCY = 0 
  TCZ = 0 - float(TZjogEntryField.get())
  TCRx = 0
  TCRy = 0
  TCRz = 0
  Track = float(TrackcurEntryField.get())
  Code = 0
  newSpeed = speedEntryField.get()
  ACCdur = ACCdurField.get()
  ACCspd = ACCspeedField.get()
  DECdur = DECdurField.get()
  DECspd = DECspeedField.get()
  MoveXYZ(CX,CY,CZ,CRx,CRy,CRz,newSpeed,ACCdur,ACCspd,DECdur,DECspd,WC,TCX,TCY,TCZ,TCRx,TCRy,TCRz,Track,Code)

def TRxjogNeg():
  almStatusLab.config(text="SYSTEM READY", bg = "cornflowerblue")
  almStatusLab2.config(text="SYSTEM READY", bg = "cornflowerblue")
  CX = XcurPos 
  CY = YcurPos
  CZ = ZcurPos
  CRx = RxcurPos
  CRy = RycurPos
  CRz = RzcurPos
  TCX = 0
  TCY = 0 
  TCZ = 0
  TCRx = 0 - float(TRxjogEntryField.get())
  TCRy = 0
  TCRz = 0
  Track = float(TrackcurEntryField.get())
  Code = 0
  newSpeed = speedEntryField.get()
  ACCdur = ACCdurField.get()
  ACCspd = ACCspeedField.get()
  DECdur = DECdurField.get()
  DECspd = DECspeedField.get()
  MoveXYZ(CX,CY,CZ,CRx,CRy,CRz,newSpeed,ACCdur,ACCspd,DECdur,DECspd,WC,TCX,TCY,TCZ,TCRx,TCRy,TCRz,Track,Code)

def TRyjogNeg():
  almStatusLab.config(text="SYSTEM READY", bg = "cornflowerblue")
  almStatusLab2.config(text="SYSTEM READY", bg = "cornflowerblue")
  CX = XcurPos 
  CY = YcurPos
  CZ = ZcurPos
  CRx = RxcurPos
  CRy = RycurPos
  CRz = RzcurPos
  TCX = 0
  TCY = 0 
  TCZ = 0
  TCRx = 0
  TCRy = 0 - float(TRyjogEntryField.get())
  TCRz = 0
  Track = float(TrackcurEntryField.get())
  Code = 0
  newSpeed = speedEntryField.get()
  ACCdur = ACCdurField.get()
  ACCspd = ACCspeedField.get()
  DECdur = DECdurField.get()
  DECspd = DECspeedField.get()
  MoveXYZ(CX,CY,CZ,CRx,CRy,CRz,newSpeed,ACCdur,ACCspd,DECdur,DECspd,WC,TCX,TCY,TCZ,TCRx,TCRy,TCRz,Track,Code)

def TRzjogNeg():
  almStatusLab.config(text="SYSTEM READY", bg = "cornflowerblue")
  almStatusLab2.config(text="SYSTEM READY", bg = "cornflowerblue")
  CX = XcurPos 
  CY = YcurPos
  CZ = ZcurPos
  CRx = RxcurPos
  CRy = RycurPos
  CRz = RzcurPos
  TCX = 0
  TCY = 0 
  TCZ = 0
  TCRx = 0
  TCRy = 0
  TCRz = 0 - float(TRzjogEntryField.get())
  Track = float(TrackcurEntryField.get())
  Code = 0
  newSpeed = speedEntryField.get()
  ACCdur = ACCdurField.get()
  ACCspd = ACCspeedField.get()
  DECdur = DECdurField.get()
  DECspd = DECspeedField.get()
  MoveXYZ(CX,CY,CZ,CRx,CRy,CRz,newSpeed,ACCdur,ACCspd,DECdur,DECspd,WC,TCX,TCY,TCZ,TCRx,TCRy,TCRz,Track,Code)

def TXjogPos():
  almStatusLab.config(text="SYSTEM READY", bg = "cornflowerblue")
  almStatusLab2.config(text="SYSTEM READY", bg = "cornflowerblue")
  CX = XcurPos
  CY = YcurPos
  CZ = ZcurPos
  CRx = RxcurPos
  CRy = RycurPos
  CRz = RzcurPos
  TCX = 0 + float(TXjogEntryField.get())
  TCY = 0 
  TCZ = 0
  TCRx = 0
  TCRy = 0
  TCRz = 0
  Track = float(TrackcurEntryField.get())
  Code = 0
  newSpeed = speedEntryField.get()
  ACCdur = ACCdurField.get()
  ACCspd = ACCspeedField.get()
  DECdur = DECdurField.get()
  DECspd = DECspeedField.get()
  MoveXYZ(CX,CY,CZ,CRx,CRy,CRz,newSpeed,ACCdur,ACCspd,DECdur,DECspd,WC,TCX,TCY,TCZ,TCRx,TCRy,TCRz,Track,Code)

def TYjogPos():
  almStatusLab.config(text="SYSTEM READY", bg = "cornflowerblue")
  almStatusLab2.config(text="SYSTEM READY", bg = "cornflowerblue")
  CX = XcurPos
  CY = YcurPos
  CZ = ZcurPos
  CRx = RxcurPos
  CRy = RycurPos
  CRz = RzcurPos
  TCX = 0
  TCY = 0 + float(TYjogEntryField.get()) 
  TCZ = 0
  TCRx = 0
  TCRy = 0
  TCRz = 0
  Track = float(TrackcurEntryField.get())
  Code = 0
  newSpeed = speedEntryField.get()
  ACCdur = ACCdurField.get()
  ACCspd = ACCspeedField.get()
  DECdur = DECdurField.get()
  DECspd = DECspeedField.get()  
  MoveXYZ(CX,CY,CZ,CRx,CRy,CRz,newSpeed,ACCdur,ACCspd,DECdur,DECspd,WC,TCX,TCY,TCZ,TCRx,TCRy,TCRz,Track,Code)

def TZjogPos():
  almStatusLab.config(text="SYSTEM READY", bg = "cornflowerblue")
  almStatusLab2.config(text="SYSTEM READY", bg = "cornflowerblue")
  CX = XcurPos
  CY = YcurPos
  CZ = ZcurPos
  CRx = RxcurPos
  CRy = RycurPos
  CRz = RzcurPos
  TCX = 0
  TCY = 0 
  TCZ = 0 + float(TZjogEntryField.get())
  TCRx = 0
  TCRy = 0
  TCRz = 0
  Track = float(TrackcurEntryField.get())
  Code = 0
  newSpeed = speedEntryField.get()
  ACCdur = ACCdurField.get()
  ACCspd = ACCspeedField.get()
  DECdur = DECdurField.get()
  DECspd = DECspeedField.get()  
  MoveXYZ(CX,CY,CZ,CRx,CRy,CRz,newSpeed,ACCdur,ACCspd,DECdur,DECspd,WC,TCX,TCY,TCZ,TCRx,TCRy,TCRz,Track,Code)

def TRxjogPos():
  almStatusLab.config(text="SYSTEM READY", bg = "cornflowerblue")
  almStatusLab2.config(text="SYSTEM READY", bg = "cornflowerblue")
  CX = XcurPos
  CY = YcurPos
  CZ = ZcurPos
  CRx = RxcurPos
  CRy = RycurPos
  CRz = RzcurPos
  TCX = 0
  TCY = 0 
  TCZ = 0
  TCRx = 0 + float(TRxjogEntryField.get())
  TCRy = 0
  TCRz = 0
  Track = float(TrackcurEntryField.get())
  Code = 0
  newSpeed = speedEntryField.get()
  ACCdur = ACCdurField.get()
  ACCspd = ACCspeedField.get()
  DECdur = DECdurField.get()
  DECspd = DECspeedField.get()  
  MoveXYZ(CX,CY,CZ,CRx,CRy,CRz,newSpeed,ACCdur,ACCspd,DECdur,DECspd,WC,TCX,TCY,TCZ,TCRx,TCRy,TCRz,Track,Code)

def TRyjogPos():
  almStatusLab.config(text="SYSTEM READY", bg = "cornflowerblue")
  almStatusLab2.config(text="SYSTEM READY", bg = "cornflowerblue")
  CX = XcurPos
  CY = YcurPos
  CZ = ZcurPos
  CRx = RxcurPos
  CRy = RycurPos
  CRz = RzcurPos
  TCX = 0
  TCY = 0 
  TCZ = 0
  TCRx = 0
  TCRy = 0 + float(TRyjogEntryField.get())
  TCRz = 0
  Track = float(TrackcurEntryField.get())
  Code = 0
  newSpeed = speedEntryField.get()
  ACCdur = ACCdurField.get()
  ACCspd = ACCspeedField.get()
  DECdur = DECdurField.get()
  DECspd = DECspeedField.get()  
  MoveXYZ(CX,CY,CZ,CRx,CRy,CRz,newSpeed,ACCdur,ACCspd,DECdur,DECspd,WC,TCX,TCY,TCZ,TCRx,TCRy,TCRz,Track,Code)

def TRzjogPos():
  almStatusLab.config(text="SYSTEM READY", bg = "cornflowerblue")
  almStatusLab2.config(text="SYSTEM READY", bg = "cornflowerblue")
  CX = XcurPos
  CY = YcurPos
  CZ = ZcurPos
  CRx = RxcurPos
  CRy = RycurPos
  CRz = RzcurPos
  TCX = 0
  TCY = 0 
  TCZ = 0
  TCRx = 0
  TCRy = 0
  TCRz = 0 + float(TRzjogEntryField.get())
  Track = float(TrackcurEntryField.get())
  Code = 0
  newSpeed = speedEntryField.get()
  ACCdur = ACCdurField.get()
  ACCspd = ACCspeedField.get()
  DECdur = DECdurField.get()
  DECspd = DECspeedField.get()  
  MoveXYZ(CX,CY,CZ,CRx,CRy,CRz,newSpeed,ACCdur,ACCspd,DECdur,DECspd,WC,TCX,TCY,TCZ,TCRx,TCRy,TCRz,Track,Code)
  
  
##############################################################################################################################################################  
### TEACH DEFS ################################################################################################################################ TEACH DEFS ###
##############################################################################################################################################################  

def teachInsertBelSelected():
  global XcurPos
  global YcurPos
  global ZcurPos
  global RxcurPos
  global RycurPos
  global RzcurPos
  global WC
  global TrackcurPos
  try:
    selRow = tab1.progView.curselection()[0]
    selRow += 1
  except:
    last = tab1.progView.index('end')
    selRow = last
    tab1.progView.select_set(selRow)
  Speed = speedEntryField.get()
  ACCdur = ACCdurField.get()
  ACCspd = ACCspeedField.get()
  DECdur = DECdurField.get()
  DECspd = DECspeedField.get()
  J1AngWrite = str(round(XcurPos,3))
  J2AngWrite = str(round(YcurPos,3))
  J3AngWrite = str(round(ZcurPos,3))
  J4AngWrite = str(round(RxcurPos,3))
  J5AngWrite = str(round(RycurPos,3))
  J6AngWrite = str(round(RzcurPos,3))
  TrackPosWrite = str(round(TrackcurPos,3))
  movetype = options.get()
  if(movetype == "OFFS J"):
    movetype = movetype+" [SP:"+str(SavePosEntryField.get())+"]"
    newPos = movetype + " [*]  X) "+J1AngWrite+"   Y) "+J2AngWrite+"   Z) "+J3AngWrite+"   W) "+J4AngWrite+"   P) "+J5AngWrite+"   R) "+J6AngWrite+"   T) "+TrackPosWrite+"   Speed-"+Speed+" Ad "+ACCdur+" As "+ACCspd+" Dd "+DECdur+" Ds "+DECspd+ " $"+WC              
    tab1.progView.insert(selRow, newPos) 
    tab1.progView.selection_clear(0, END)
    tab1.progView.select_set(selRow)
    value=tab1.progView.get(0,END)
    pickle.dump(value,open(ProgEntryField.get(),"wb"))
  elif(movetype == "Move SP"):
    movetype = movetype+" [SP:"+str(SavePosEntryField.get())+"]"
    newPos = movetype + " [*]  T) "+TrackPosWrite+"   Speed-"+Speed+" Ad "+ACCdur+" As "+ACCspd+" Dd "+DECdur+" Ds "+DECspd+ " $"+WC              
    tab1.progView.insert(selRow, newPos) 
    tab1.progView.selection_clear(0, END)
    tab1.progView.select_set(selRow)
    value=tab1.progView.get(0,END)
    pickle.dump(value,open(ProgEntryField.get(),"wb"))
  elif(movetype == "OFFS SP"):
    movetype = movetype+" [SP:"+str(SavePosEntryField.get())+"] offs [*SP:"+str(int(SavePosEntryField.get())+1)+"] "
    newPos = movetype + " [*]  T) "+TrackPosWrite+"   Speed-"+Speed+" Ad "+ACCdur+" As "+ACCspd+" Dd "+DECdur+" Ds "+DECspd+ " $"+WC
    tab1.progView.insert(selRow, newPos) 
    tab1.progView.selection_clear(0, END)
    tab1.progView.select_set(selRow)
    value=tab1.progView.get(0,END)
    pickle.dump(value,open(ProgEntryField.get(),"wb"))
  elif(movetype == "Move J"):
    newPos = movetype + " [*]  X) "+J1AngWrite+"   Y) "+J2AngWrite+"   Z) "+J3AngWrite+"   W) "+J4AngWrite+"   P) "+J5AngWrite+"   R) "+J6AngWrite+"   T) "+TrackPosWrite+"   Speed-"+Speed+" Ad "+ACCdur+" As "+ACCspd+" Dd "+DECdur+" Ds "+DECspd+ " $"+WC              
    tab1.progView.insert(selRow, newPos) 
    tab1.progView.selection_clear(0, END)
    tab1.progView.select_set(selRow)
    value=tab1.progView.get(0,END)
    pickle.dump(value,open(ProgEntryField.get(),"wb"))
  elif(movetype == "Move L"):
    newPos = movetype + " [*]  X) "+J1AngWrite+"   Y) "+J2AngWrite+"   Z) "+J3AngWrite+"   W) "+J4AngWrite+"   P) "+J5AngWrite+"   R) "+J6AngWrite+"   T) "+TrackPosWrite+"   Speed-"+Speed+" Ad "+ACCdur+" As "+ACCspd+" Dd "+DECdur+" Ds "+DECspd+ " $"+WC              
    tab1.progView.insert(selRow, newPos) 
    tab1.progView.selection_clear(0, END)
    tab1.progView.select_set(selRow)
    value=tab1.progView.get(0,END)
    pickle.dump(value,open(ProgEntryField.get(),"wb"))
  elif(movetype == "Move A Beg"):
    newPos = movetype + " [*]  X) "+J1AngWrite+"   Y) "+J2AngWrite+"   Z) "+J3AngWrite+"   W) "+J4AngWrite+"   P) "+J5AngWrite+"   R) "+J6AngWrite+"   T) "+TrackPosWrite+"   Speed-"+Speed+" Ad "+ACCdur+" As "+ACCspd+" Dd "+DECdur+" Ds "+DECspd+ " $"+WC              
    tab1.progView.insert(selRow, newPos) 
    tab1.progView.selection_clear(0, END)
    tab1.progView.select_set(selRow)
    value=tab1.progView.get(0,END)
    pickle.dump(value,open(ProgEntryField.get(),"wb"))
  elif(movetype == "Move A Mid"):
    newPos = movetype + " [*]  X) "+J1AngWrite+"   Y) "+J2AngWrite+"   Z) "+J3AngWrite                 
    tab1.progView.insert(selRow, newPos) 
    tab1.progView.selection_clear(0, END)
    tab1.progView.select_set(selRow)
    value=tab1.progView.get(0,END)
    pickle.dump(value,open(ProgEntryField.get(),"wb"))	
  elif(movetype == "Move A End"):
    newPos = movetype + " [*]  X) "+J1AngWrite+"   Y) "+J2AngWrite+"   Z) "+J3AngWrite
    tab1.progView.insert(selRow, newPos) 
    tab1.progView.selection_clear(0, END)
    tab1.progView.select_set(selRow)
    value=tab1.progView.get(0,END)
    pickle.dump(value,open(ProgEntryField.get(),"wb"))	
  elif(movetype == "Move C Center"):
    newPos = movetype + " [*]  X) "+J1AngWrite+"   Y) "+J2AngWrite+"   Z) "+J3AngWrite+"   W) "+J4AngWrite+"   P) "+J5AngWrite+"   R) "+J6AngWrite+"   T) "+TrackPosWrite+"   Speed-"+Speed+" Ad "+ACCdur+" As "+ACCspd+" Dd "+DECdur+" Ds "+DECspd+ " $"+WC              
    tab1.progView.insert(selRow, newPos) 
    tab1.progView.selection_clear(0, END)
    tab1.progView.select_set(selRow)
    value=tab1.progView.get(0,END)
    pickle.dump(value,open(ProgEntryField.get(),"wb"))
  elif(movetype == "Move C Start"):
    newPos = movetype + " [*]  X) "+J1AngWrite+"   Y) "+J2AngWrite+"   Z) "+J3AngWrite                 
    tab1.progView.insert(selRow, newPos) 
    tab1.progView.selection_clear(0, END)
    tab1.progView.select_set(selRow)
    value=tab1.progView.get(0,END)
    pickle.dump(value,open(ProgEntryField.get(),"wb"))	
  elif(movetype == "Move C Plane"):
    newPos = movetype + " [*]  X) "+J1AngWrite+"   Y) "+J2AngWrite+"   Z) "+J3AngWrite
    tab1.progView.insert(selRow, newPos) 
    tab1.progView.selection_clear(0, END)
    tab1.progView.select_set(selRow)
    value=tab1.progView.get(0,END)
    pickle.dump(value,open(ProgEntryField.get(),"wb"))
  elif(movetype == "Teach SP"):
    SP = str(SavePosEntryField.get())
    SPE6 = "Store Position "+SP+" Element 6 = "+str(round(RzcurPos,3))         
    tab1.progView.insert(selRow, SPE6)	
    SPE5 = "Store Position "+SP+" Element 5 = "+str(round(RycurPos,3))            
    tab1.progView.insert(selRow, SPE5)
    SPE4 = "Store Position "+SP+" Element 4 = "+str(round(RxcurPos,3))           
    tab1.progView.insert(selRow, SPE4)	
    SPE3 = "Store Position "+SP+" Element 3 = "+str(round(ZcurPos,3))        
    tab1.progView.insert(selRow, SPE3)	
    SPE2 = "Store Position "+SP+" Element 2 = "+str(round(YcurPos,3))            
    tab1.progView.insert(selRow, SPE2)	
    SPE1 = "Store Position "+SP+" Element 1 = "+str(round(XcurPos,3))         
    tab1.progView.insert(selRow, SPE1)   	
    value=tab1.progView.get(0,END)
    pickle.dump(value,open(ProgEntryField.get(),"wb"))

def teachReplaceSelected():
  global XcurPos
  global YcurPos
  global ZcurPos
  global RxcurPos
  global RycurPos
  global RzcurPos
  global WC
  global TrackcurPos  
  selRow = tab1.progView.curselection()[0]
  Speed = speedEntryField.get()
  ACCdur = ACCdurField.get()
  ACCspd = ACCspeedField.get()
  DECdur = DECdurField.get()
  DECspd = DECspeedField.get()
  J1AngWrite = str(round(XcurPos,3))
  J2AngWrite = str(round(YcurPos,3))
  J3AngWrite = str(round(ZcurPos,3))
  J4AngWrite = str(round(RxcurPos,3))
  J5AngWrite = str(round(RycurPos,3))
  J6AngWrite = str(round(RzcurPos,3))
  TrackPosWrite = str(round(TrackcurPos,3))
  movetype = options.get()
  if(movetype[:-2]== "OFFS"):
    movetype = movetype+" [SP:"+str(SavePosEntryField.get())+"]"
  newPos = movetype + " [*]  X) "+J1AngWrite+"   Y) "+J2AngWrite+"   Z) "+J3AngWrite+"   W) "+J4AngWrite+"   P) "+J5AngWrite+"   R) "+J6AngWrite+"   T) "+TrackPosWrite+"   Speed-"+Speed+" Ad "+ACCdur+" As "+ACCspd+" Dd "+DECdur+" Ds "+DECspd+ " $"+WC              
  tab1.progView.insert(selRow, newPos)
  selection = tab1.progView.curselection()
  tab1.progView.delete(selection[0]) 
  tab1.progView.select_set(selRow)
  value=tab1.progView.get(0,END)
  pickle.dump(value,open(ProgEntryField.get(),"wb"))

def teachFineCal():
  global XcurPos
  global YcurPos
  global ZcurPos
  global RxcurPos
  global RycurPos
  global RzcurPos
  global WC
  global TrackcurPos
  Speed = speedEntryField.get()
  ACCdur = ACCdurField.get()
  ACCspd = ACCspeedField.get()
  DECdur = DECdurField.get()
  DECspd = DECspeedField.get()
  J1AngWrite = str(round(XcurPos,3))
  J2AngWrite = str(round(YcurPos,3))
  J3AngWrite = str(round(ZcurPos,3))
  J4AngWrite = str(round(RxcurPos,3))
  J5AngWrite = str(round(RycurPos,3))
  J6AngWrite = str(round(RzcurPos,3))
  TrackPosWrite = str(round(TrackcurPos,3))
  newPos = "Move J [*]  X) "+J1AngWrite+"   Y) "+J2AngWrite+"   Z) "+J3AngWrite+"   W) "+J4AngWrite+"   P) "+J5AngWrite+"   R) "+J6AngWrite+"   T) "+TrackPosWrite+"   Speed-"+Speed+" Ad "+ACCdur+" As "+ACCspd+" Dd "+DECdur+" Ds "+DECspd+ " $"+WC              
  fineCalEntryField.delete(0, 'end')   
  fineCalEntryField.insert(0,str(newPos))
  savePosData()
  almStatusLab.config(text="NEW FINE CALIBRATION POSITION TAUGHT", bg = "blue")
  almStatusLab2.config(text="NEW FINE CALIBRATION POSITION TAUGHT", bg = "blue")
 

############################################################################################################################################################## 
### PROGRAM FUNCTION DEFS ########################################################################################################## PROGRAM FUNCTION DEFS ###
############################################################################################################################################################## 
  
def deleteitem():
  selRow = tab1.progView.curselection()[0]
  selection = tab1.progView.curselection()  
  tab1.progView.delete(selection[0])
  tab1.progView.select_set(selRow)  
  value=tab1.progView.get(0,END)
  pickle.dump(value,open(ProgEntryField.get(),"wb"))  
  
def manInsItem():
  try:
    selRow = tab1.progView.curselection()[0]
    selRow += 1
  except:
    last = tab1.progView.index('end')
    selRow = last
    tab1.progView.select_set(selRow) 
  tab1.progView.insert(selRow, manEntryField.get())
  tab1.progView.selection_clear(0, END)
  tab1.progView.select_set(selRow) 
  selRow = tab1.progView.curselection()[0]
  curRowEntryField.delete(0, 'end')
  curRowEntryField.insert(0,selRow)
  tab1.progView.itemconfig(selRow, {'fg': 'darkgreen'})
  value=tab1.progView.get(0,END)
  pickle.dump(value,open(ProgEntryField.get(),"wb"))
  
def manReplItem():
  #selRow = curRowEntryField.get()
  selRow = tab1.progView.curselection()[0]
  tab1.progView.delete(selRow) 
  tab1.progView.insert(selRow, manEntryField.get())
  tab1.progView.selection_clear(0, END)
  tab1.progView.select_set(selRow)
  tab1.progView.itemconfig(selRow, {'fg': 'darkgreen'})  
  value=tab1.progView.get(0,END)
  pickle.dump(value,open(ProgEntryField.get(),"wb"))
  
def waitTime():
  try:
    selRow = tab1.progView.curselection()[0]
    selRow += 1
  except:
    last = tab1.progView.index('end')
    selRow = last
    tab1.progView.select_set(selRow)
  seconds = waitTimeEntryField.get()
  newTime = "Wait Time = "+seconds               
  tab1.progView.insert(selRow, newTime)
  tab1.progView.selection_clear(0, END) 
  tab1.progView.select_set(selRow) 
  value=tab1.progView.get(0,END)
  pickle.dump(value,open(ProgEntryField.get(),"wb"))


def waitInputOn():
  try:
    selRow = tab1.progView.curselection()[0]
    selRow += 1
  except:
    last = tab1.progView.index('end')
    selRow = last
    tab1.progView.select_set(selRow)
  input = waitInputEntryField.get()
  newInput = "Wait Input On = "+input              
  tab1.progView.insert(selRow, newInput)
  tab1.progView.selection_clear(0, END) 
  tab1.progView.select_set(selRow) 
  value=tab1.progView.get(0,END)
  pickle.dump(value,open(ProgEntryField.get(),"wb"))

def waitInputOff():
  try:
    selRow = tab1.progView.curselection()[0]
    selRow += 1
  except:
    last = tab1.progView.index('end')
    selRow = last
    tab1.progView.select_set(selRow)
  input = waitInputOffEntryField.get()
  newInput = "Wait Off Input = "+input              
  tab1.progView.insert(selRow, newInput)
  tab1.progView.selection_clear(0, END) 
  tab1.progView.select_set(selRow) 
  value=tab1.progView.get(0,END)
  pickle.dump(value,open(ProgEntryField.get(),"wb"))

def setOutputOn():
  try:
    selRow = tab1.progView.curselection()[0]
    selRow += 1
  except:
    last = tab1.progView.index('end')
    selRow = last
    tab1.progView.select_set(selRow)
  output = outputOnEntryField.get()
  newOutput = "Out On = "+output              
  tab1.progView.insert(selRow, newOutput)
  tab1.progView.selection_clear(0, END) 
  tab1.progView.select_set(selRow) 
  value=tab1.progView.get(0,END)
  pickle.dump(value,open(ProgEntryField.get(),"wb"))

def setOutputOff():
  try:
    selRow = tab1.progView.curselection()[0]
    selRow += 1
  except:
    last = tab1.progView.index('end')
    selRow = last
    tab1.progView.select_set(selRow)
  output = outputOffEntryField.get()
  newOutput = "Out Off = "+output              
  tab1.progView.insert(selRow, newOutput)
  tab1.progView.selection_clear(0, END) 
  tab1.progView.select_set(selRow) 
  value=tab1.progView.get(0,END)
  pickle.dump(value,open(ProgEntryField.get(),"wb"))

def tabNumber():
  try:
    selRow = tab1.progView.curselection()[0]
    selRow += 1
  except:
    last = tab1.progView.index('end')
    selRow = last
    tab1.progView.select_set(selRow)
  tabNum = tabNumEntryField.get()
  tabins = "Tab Number "+tabNum              
  tab1.progView.insert(selRow, tabins) 
  value=tab1.progView.get(0,END)
  tab1.progView.selection_clear(0, END) 
  tab1.progView.select_set(selRow)
  pickle.dump(value,open(ProgEntryField.get(),"wb"))
  tabNumEntryField.delete(0, 'end')

def jumpTab():
  try:
    selRow = tab1.progView.curselection()[0]
    selRow += 1
  except:
    last = tab1.progView.index('end')
    selRow = last
    tab1.progView.select_set(selRow)
  tabNum = jumpTabEntryField.get()
  tabjmp = "Jump Tab-"+tabNum              
  tab1.progView.insert(selRow, tabjmp) 
  value=tab1.progView.get(0,END)
  tab1.progView.selection_clear(0, END)
  tab1.progView.select_set(selRow)
  pickle.dump(value,open(ProgEntryField.get(),"wb"))
  tabNumEntryField.delete(0, 'end')
 
def getvision():
  try:
    selRow = tab1.progView.curselection()[0]
    selRow += 1
  except:
    last = tab1.progView.index('end')
    selRow = last
    tab1.progView.select_set(selRow)
  value = "Get Vision"
  tab1.progView.insert(selRow, value) 
  value=tab1.progView.get(0,END)
  tab1.progView.selection_clear(0, END)
  tab1.progView.select_set(selRow)
  pickle.dump(value,open(ProgEntryField.get(),"wb"))
  
def IfOnjumpTab():
  try:
    selRow = tab1.progView.curselection()[0]
    selRow += 1
  except:
    last = tab1.progView.index('end')
    selRow = last
    tab1.progView.select_set(selRow)
  inpNum = IfOnjumpInputTabEntryField.get()
  tabNum = IfOnjumpNumberTabEntryField.get()
  tabjmp = "If On Jump - Input-"+inpNum+" Jump to Tab-"+tabNum             
  tab1.progView.insert(selRow, tabjmp)   
  value=tab1.progView.get(0,END)
  tab1.progView.selection_clear(0, END) 
  tab1.progView.select_set(selRow)
  pickle.dump(value,open(ProgEntryField.get(),"wb"))
  tabNumEntryField.delete(0, 'end')

def IfOffjumpTab():
  try:
    selRow = tab1.progView.curselection()[0]
    selRow += 1
  except:
    last = tab1.progView.index('end')
    selRow = last
    tab1.progView.select_set(selRow)
  inpNum = IfOffjumpInputTabEntryField.get()
  tabNum = IfOffjumpNumberTabEntryField.get()
  tabjmp = "If Off Jump - Input-"+inpNum+" Jump to Tab-"+tabNum             
  tab1.progView.insert(selRow, tabjmp) 
  value=tab1.progView.get(0,END)
  tab1.progView.selection_clear(0, END) 
  tab1.progView.select_set(selRow)
  pickle.dump(value,open(ProgEntryField.get(),"wb"))
  tabNumEntryField.delete(0, 'end')

def Servo():
  try:
    selRow = tab1.progView.curselection()[0]
    selRow += 1
  except:
    last = tab1.progView.index('end')
    selRow = last
    tab1.progView.select_set(selRow)
  servoNum = servoNumEntryField.get()
  servoPos = servoPosEntryField.get()
  servoins = "Servo number "+servoNum+" to position: "+servoPos              
  tab1.progView.insert(selRow, servoins)
  tab1.progView.selection_clear(0, END) 
  tab1.progView.select_set(selRow) 
  value=tab1.progView.get(0,END)
  pickle.dump(value,open(ProgEntryField.get(),"wb"))

def loadProg():
  progframe=Frame(tab1)
  progframe.place(x=7,y=174)
  #progframe.pack(side=RIGHT, fill=Y)
  scrollbar = Scrollbar(progframe) 
  scrollbar.pack(side=RIGHT, fill=Y)
  tab1.progView = Listbox(progframe,width=84,height=31, yscrollcommand=scrollbar.set)
  tab1.progView.bind('<<ListboxSelect>>', progViewselect)
  try:
    Prog = pickle.load(open(ProgEntryField.get(),"rb"))
  except:
    try:
      Prog = ['##BEGINNING OF PROGRAM##','Tab Number 1']
      pickle.dump(Prog,open(ProgEntryField.get(),"wb"))    
    except:
      Prog = ['##BEGINNING OF PROGRAM##','Tab Number 1']
      pickle.dump(Prog,open("new","wb"))
      ProgEntryField.insert(0,"new")
  time.sleep(.2)
  for item in Prog:
    tab1.progView.insert(END,item) 
  tab1.progView.pack()
  scrollbar.config(command=tab1.progView.yview)
  savePosData()

def insertCallProg():  
  try:
    selRow = tab1.progView.curselection()[0]
    selRow += 1
  except:
    last = tab1.progView.index('end')
    selRow = last
    tab1.progView.select_set(selRow)
  newProg = changeProgEntryField.get()
  changeProg = "Call Program - "+newProg            
  tab1.progView.insert(selRow, changeProg)
  tab1.progView.selection_clear(0, END) 
  tab1.progView.select_set(selRow)  
  value=tab1.progView.get(0,END)
  pickle.dump(value,open(ProgEntryField.get(),"wb"))

def insertReturn():  
  try:
    selRow = tab1.progView.curselection()[0]
    selRow += 1
  except:
    last = tab1.progView.index('end')
    selRow = last
    tab1.progView.select_set(selRow)
  value = "Return"           
  tab1.progView.insert(selRow, value)
  tab1.progView.selection_clear(0, END) 
  tab1.progView.select_set(selRow)  
  value=tab1.progView.get(0,END)
  pickle.dump(value,open(ProgEntryField.get(),"wb"))

def IfRegjumpTab():
  try:
    selRow = tab1.progView.curselection()[0]
    selRow += 1
  except:
    last = tab1.progView.index('end')
    selRow = last
    tab1.progView.select_set(selRow)
  regNum = regNumJmpEntryField.get()
  regEqNum = regEqJmpEntryField.get()
  tabNum = regTabJmpEntryField.get()
  tabjmp = "If Register "+regNum+" = "+regEqNum+" Jump to Tab "+ tabNum            
  tab1.progView.insert(selRow, tabjmp)   
  value=tab1.progView.get(0,END)
  tab1.progView.selection_clear(0, END) 
  tab1.progView.select_set(selRow)
  pickle.dump(value,open(ProgEntryField.get(),"wb"))
  tabNumEntryField.delete(0, 'end')

def insertRegister():  
  try:
    selRow = tab1.progView.curselection()[0]
    selRow += 1
  except:
    last = tab1.progView.index('end')
    selRow = last
    tab1.progView.select_set(selRow)
  regNum = regNumEntryField.get()
  regCmd = regEqEntryField.get()
  regIns = "Register "+regNum+" = "+regCmd             
  tab1.progView.insert(selRow, regIns)   
  value=tab1.progView.get(0,END)
  tab1.progView.selection_clear(0, END) 
  tab1.progView.select_set(selRow)
  pickle.dump(value,open(ProgEntryField.get(),"wb"))
  tabNumEntryField.delete(0, 'end')
  
def storPos():
  try:
    selRow = tab1.progView.curselection()[0]
    selRow += 1
  except:
    last = tab1.progView.index('end')
    selRow = last
    tab1.progView.select_set(selRow)
  regNum = storPosNumEntryField.get()
  regElmnt = storPosElEntryField.get()
  regCmd = storPosValEntryField.get()
  regIns = "Store Position "+regNum+" Element "+regElmnt+" = "+regCmd             
  tab1.progView.insert(selRow, regIns)   
  value=tab1.progView.get(0,END)
  tab1.progView.selection_clear(0, END) 
  tab1.progView.select_set(selRow)
  pickle.dump(value,open(ProgEntryField.get(),"wb"))
  tabNumEntryField.delete(0, 'end')
  
def insCalibrate():  
  try:
    selRow = tab1.progView.curselection()[0]
    selRow += 1
  except:
    last = tab1.progView.index('end')
    selRow = last
    tab1.progView.select_set(selRow)
  insCal = "Calibrate Robot"          
  tab1.progView.insert(selRow, insCal)   
  value=tab1.progView.get(0,END)
  tab1.progView.selection_clear(0, END) 
  tab1.progView.select_set(selRow)
  pickle.dump(value,open(ProgEntryField.get(),"wb"))
  tabNumEntryField.delete(0, 'end')

def progViewselect(e):
  selRow = tab1.progView.curselection()[0]
  curRowEntryField.delete(0, 'end')
  curRowEntryField.insert(0,selRow)
 
def getSel():
  selRow = tab1.progView.curselection()[0]
  tab1.progView.see(selRow+2)
  data = list(map(int, tab1.progView.curselection()))
  command=tab1.progView.get(data[0])
  manEntryField.delete(0, 'end')
  manEntryField.insert(0, command)  
  
def Servo0on():
  savePosData() 
  servoPos = servo0onEntryField.get()
  command = "SV0P"+servoPos+"\n"
  ser.write(command.encode())
  ser.flushInput()
  time.sleep(.2)
  ser.read()


def Servo0off():
  savePosData() 
  servoPos = servo0offEntryField.get()
  command = "SV0P"+servoPos+"\n"
  ser.write(command.encode())
  ser.flushInput()
  time.sleep(.2)
  ser.read()


def Servo1on():
  savePosData() 
  servoPos = servo1onEntryField.get()
  command = "SV1P"+servoPos+"\n"
  ser.write(command.encode())
  ser.flushInput()
  time.sleep(.2)
  ser.read() 


def Servo1off():
  savePosData() 
  servoPos = servo1offEntryField.get()
  command = "SV1P"+servoPos+"\n"
  ser.write(command.encode())
  ser.flushInput()
  time.sleep(.2)
  ser.read()
 

def Servo2on():
  savePosData() 
  servoPos = servo2onEntryField.get()
  command = "SV2P"+servoPos+"\n"
  ser.write(command.encode())
  ser.flushInput()
  time.sleep(.2)
  ser.read() 


def Servo2off():
  savePosData() 
  servoPos = servo2offEntryField.get()
  command = "SV2P"+servoPos+"\n"
  ser.write(command.encode())
  ser.flushInput()
  time.sleep(.2)
  ser.read()

def Servo3on():
  savePosData() 
  servoPos = servo3onEntryField.get()
  command = "SV3P"+servoPos+"\n"
  ser.write(command.encode())
  ser.flushInput()
  time.sleep(.2)
  ser.read() 

def Servo3off():
  savePosData() 
  servoPos = servo3offEntryField.get()
  command = "SV3P"+servoPos+"\n"
  ser.write(command.encode())
  ser.flushInput()
  time.sleep(.2)
  ser.read()

def DO1on():
  outputNum = DO1onEntryField.get()
  command = "ONX"+outputNum+"\n"
  ser.write(command.encode())
  ser.flushInput()
  time.sleep(.2)
  ser.read() 


def DO1off():
  outputNum = DO1offEntryField.get()
  command = "OFX"+outputNum+"\n"
  ser.write(command.encode())
  ser.flushInput()
  time.sleep(.2)
  ser.read() 
 

def DO2on():
  outputNum = DO2onEntryField.get()
  command = "ONX"+outputNum+"\n"
  ser.write(command.encode())
  ser.flushInput()
  time.sleep(.2)
  ser.read()
 

def DO2off():
  outputNum = DO2offEntryField.get()
  command = "OFX"+outputNum+"\n"
  ser.write(command.encode())
  ser.flushInput()
  time.sleep(.2)
  ser.read() 


def DO3on():
  outputNum = DO3onEntryField.get()
  command = "ONX"+outputNum+"\n"
  ser.write(command.encode())
  ser.flushInput()
  time.sleep(.2)
  ser.read() 


def DO3off():
  outputNum = DO3offEntryField.get()
  command = "OFX"+outputNum+"\n"
  ser.write(command.encode())
  ser.flushInput()
  time.sleep(.2)
  ser.read() 
 

def DO4on():
  outputNum = DO4onEntryField.get()
  command = "ONX"+outputNum+"\n"
  ser.write(command.encode())
  ser.flushInput()
  time.sleep(.2)
  ser.read()
 

def DO4off():
  outputNum = DO4offEntryField.get()
  command = "OFX"+outputNum+"\n"
  ser.write(command.encode())
  ser.flushInput()
  time.sleep(.2)
  ser.read() 


def DO5on():
  outputNum = DO5onEntryField.get()
  command = "ONX"+outputNum+"\n"
  ser.write(command.encode())
  ser.flushInput()
  time.sleep(.2)
  ser.read() 


def DO5off():
  outputNum = DO5offEntryField.get()
  command = "OFX"+outputNum+"\n"
  ser.write(command.encode())
  ser.flushInput()
  time.sleep(.2)
  ser.read() 
 

def DO6on():
  outputNum = DO6onEntryField.get()
  command = "ONX"+outputNum+"\n"
  ser.write(command.encode())
  ser.flushInput()
  time.sleep(.2)
  ser.read()
 

def DO6off():
  outputNum = DO6offEntryField.get()
  command = "OFX"+outputNum+"\n"
  ser.write(command.encode())
  ser.flushInput()
  time.sleep(.2)
  ser.read() 
  
def TestString():
  message = testSendEntryField.get()
  command = "TM"+message+"\n"
  ser.write(command.encode())
  ser.flushInput()
  time.sleep(0)
  echo = ser.readline()
  testRecEntryField.delete(0, 'end')
  testRecEntryField.insert(0,echo)  

def ClearTestString():
  testRecEntryField.delete(0, 'end')
  
def CalcLinDist(X2,Y2,Z2):
  global XcurPos
  global YcurPos
  global ZcurPos
  global LineDist
  X1 = XcurPos
  Y1 = YcurPos
  Z1 = ZcurPos
  LineDist = (((X2-X1)**2)+((Y2-Y1)**2)+((Z2-Z1)**2))**.5
  return (LineDist)

def CalcLinVect(X2,Y2,Z2):
  global XcurPos
  global YcurPos
  global ZcurPos
  global Xv
  global Yv
  global Zv
  X1 = XcurPos
  Y1 = YcurPos
  Z1 = ZcurPos
  Xv = X2-X1
  Yv = Y2-Y1
  Zv = Z2-Z1
  return (Xv,Yv,Zv)  

def CalcLinWayPt(CX,CY,CZ,curWayPt,):
  global XcurPos
  global YcurPos
  global ZcurPos

 

##############################################################################################################################################################
### KINEMATIC DEFS ######################################################################################################################## KINEMATIC DEFS ###
##############################################################################################################################################################
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
